ricricucit/kibble-dispenser/docs/photos/2026-11-08-bench-wrover-breadboard-servo-overview.jpg

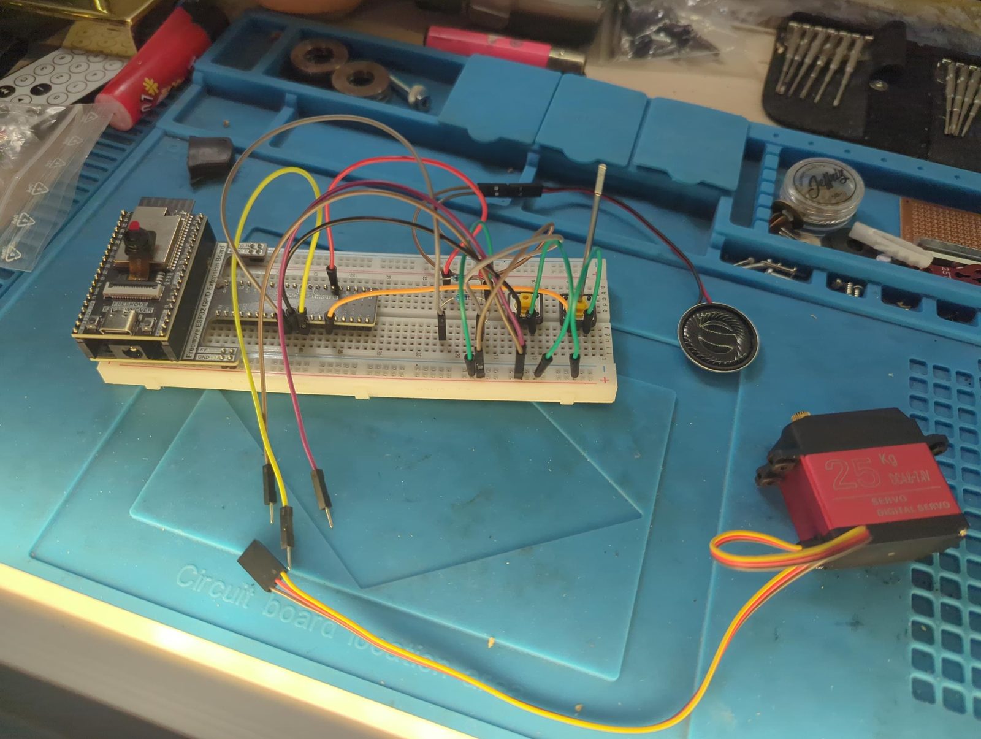
docs/photos/2026-11-08-bench-wrover-breadboard-servo-overview.jpg
