ricricucit/kibble-dispenser/docs/photos/freenove-esp32-cam-board-breadboard-wiring.jpg

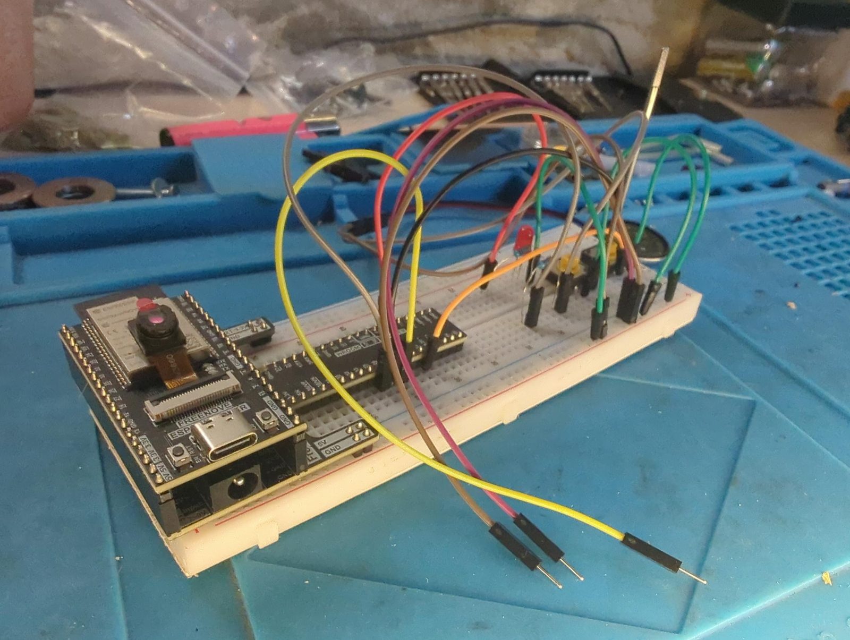
docs/photos/freenove-esp32-cam-board-breadboard-wiring.jpg
