ricricucit/kibble-dispenser/docs/README.md

# Documentation

- [Bought parts, design v6.3](BOM.md): screws, inserts, pins, O-rings, connector, control panel parts, electronics and tools, in English, Italian and German (generated from `hardware/v6.3/bom.json` by `site/bom.py`; v6.3 is designed, not yet printed or tested). The archived lists are [BOM-v6.2.md](BOM-v6.2.md) (design v6.2) and [BOM-v6.md](BOM-v6.md) (design v6).
- [Manuals, design v6.3](manual/): the user manual (draft for hardware 6.3, installation, use and maintenance) as an A6 booklet and an A4 print version in English, Italian and German; also on the site at <https://ricricucit.github.io/kibble-dispenser/manual/>
- [Build guide](BUILD_GUIDE.md): step-by-step assembly, exported from the living build guide (placeholder for now)
- [Research: power, electronics and sealing](research/elettronica-e-tenuta.it.md): power architecture, servo torque and current, cable entry, condensation, shaft seal and the full wiring list (Italian)
- [Getting started](getting-started.md): for people who buy a kit or a finished dispenser (coming later)
- [Process photos](photos/README.md): prototype 1 from the first servo tests to the bowl and box

Part-by-part print notes are in [../hardware/v6.3/plates/README.md](../hardware/v6.3/plates/README.md) (design v6.3), [../hardware/v6/README.md](../hardware/v6/README.md) (design v6) and [../hardware/README.md](../hardware/README.md) (prototype 1). Wiring and flashing steps are in [../firmware/README.md](../firmware/README.md).
