ricricucit/kibble-dispenser/docs/photos/README.md

# Process photos

Photos of prototype 1. Location and camera metadata were removed, and the images were resized to at most 1600 px on the long side. Photos without a date in their name had no date in the original file.

- `2026-07-04-servo-25kg-front.jpg`: the 25 kg·cm digital servo (4.8-7.4 V) on the workbench
- `2026-07-04-servo-25kg-three-quarter.jpg`: the same servo from another angle, with its brass 25-tooth spline
- `2026-07-04-aluminium-25t-clamp-horn.jpg`: aluminium clamping horn for the 25-tooth spline
- `2026-07-04-disc-v1-mockup-with-star-horn.jpg`: first disc mock-up, a cut plastic lid with a wedge opening screwed to a star servo horn
- `2026-10-04-orange-disc-in-bowl-on-box.jpg`: early orange printed disc in the bowl, which sits on the lid of the waterproof box
- `2026-10-04-empty-bowl-on-box-lid.jpg`: the empty bowl on the box lid, showing the centre hole and the side spout
- `2026-10-04-disc-lifted-out-cat-inspecting.jpg`: lifting the disc out of the bowl while the cat inspects
- `2026-10-04-bowl-with-spout-cover-removed.jpg`: the bowl removed from the box, with the top of the spout cut away
- `2026-10-04-spout-cover-cut-off.jpg`: the piece cut off the top of the spout
- `2026-10-04-bowl-top-view-spout-opened.jpg`: the bowl from above with the spout opened, and the cut-off piece beside it
- `2026-10-04-box-disc-and-bowl-laid-out.jpg`: box, orange disc and bowl laid out side by side
- `bowl-upside-down-with-spout-side-view.jpg`: the bowl upside down on the bench with its curved spout, side view
- `bowl-upside-down-with-spout-on-plywood.jpg`: the same set-up on a plywood board, three-quarter view
- `bowl-upside-down-top-view-on-plywood.jpg`: the same from above, with the centre hole for the shaft
- `freenove-esp32-cam-board-breadboard-wiring.jpg`: the Freenove ESP32 camera board on a breadboard for the first wiring tests. The silkscreen reads "FREENOVE ESP… R" (partly hidden by the USB-C port), which fits the ESP32-WROVER CAM board documented in the owner's PROJECT.md; still to be verified on the device. This photo was first captioned, wrongly, as an ESP32-S3 WROOM CAM
- `early-servo-bracket-inside-box.jpg`: an early servo bracket test fitted to the box wall, under the lid (this bracket is not part of the repository)
- `servo-in-early-bracket-inside-box.jpg`: the servo in that early bracket inside the box, lid lifted
- `servo-and-round-horn-on-plywood.jpg`: the servo with a round horn, next to the bowl on the plywood board
- `2026-11-08-wrover-e-extension-board-breadboard.jpg`: ESP32-WROVER-E (Freenove, with camera) on the Freenove GPIO extension board, plugged into the breadboard. Prototype wiring, pins not yet verified.
- `2026-11-08-breadboard-servo-speaker-buttons.jpg`: breadboard with the two tactile buttons, 8 Ω speaker and the 25 kg servo on its lead.
- `2026-11-08-bench-wrover-breadboard-servo-overview.jpg`: bench overview of the prototype electronics (breadboard phase).
