ricricucit/kibble-dispenser/firmware/micropython/legacy/README.md

`CatFeeder.py` is the original single-file prototype from feedr-outdoor 0.1.0 (2026-03-24), kept byte-for-byte for reference; it is superseded by `../src/` and not deployed by the Makefile.
