ricricucit/kibble-dispenser/docs/photos/2026-07-04-aluminium-25t-clamp-horn.jpg

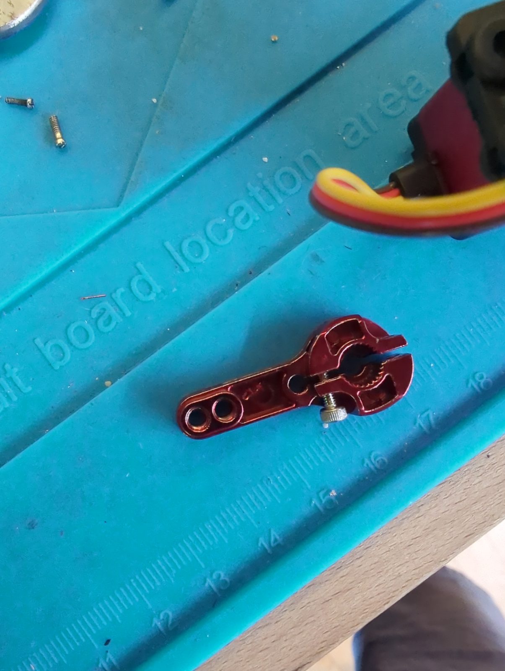
docs/photos/2026-07-04-aluminium-25t-clamp-horn.jpg
