ricricucit/kibble-dispenser/docs/photos/2026-07-04-disc-v1-mockup-with-star-horn.jpg

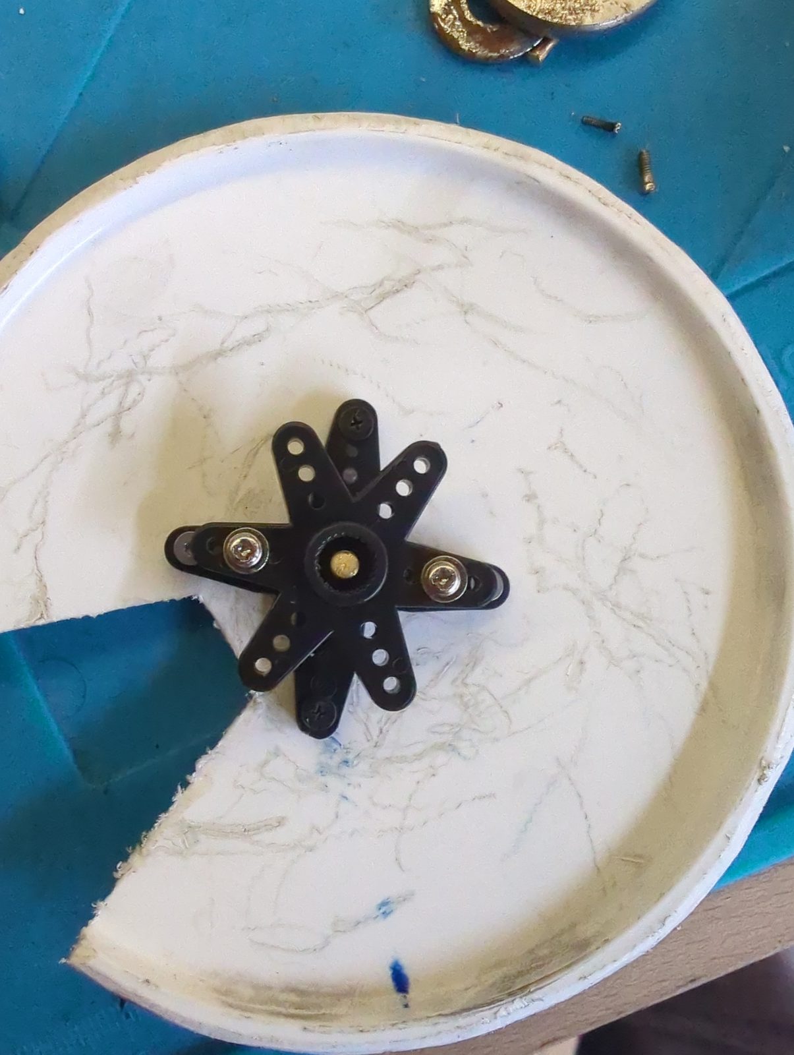
docs/photos/2026-07-04-disc-v1-mockup-with-star-horn.jpg
