ricricucit/kibble-dispenser/docs/photos/2026-07-04-servo-25kg-three-quarter.jpg

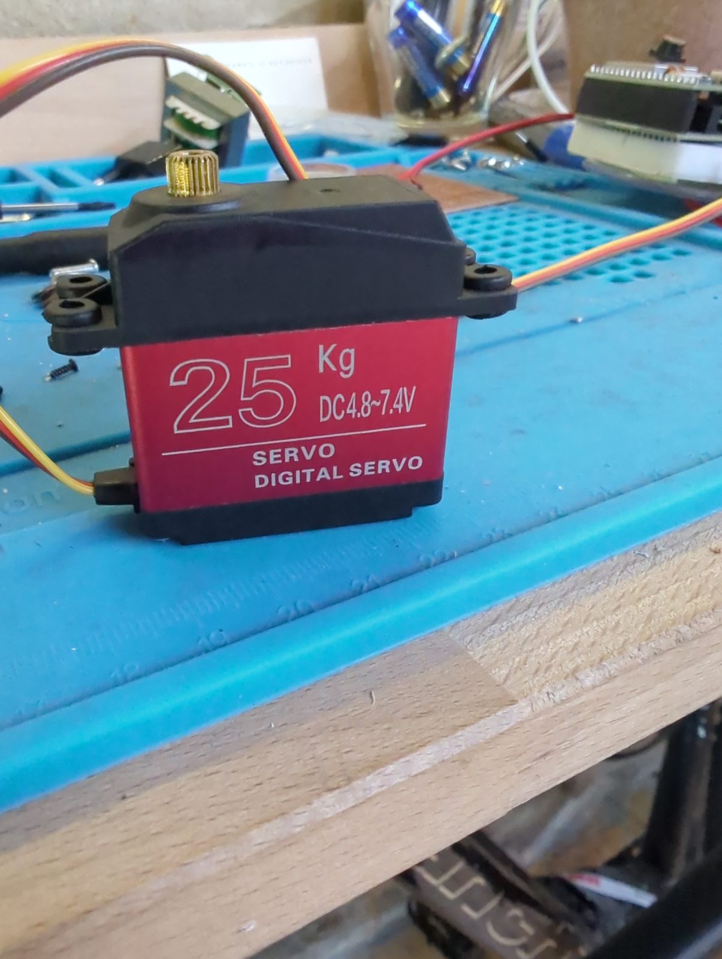
docs/photos/2026-07-04-servo-25kg-three-quarter.jpg
