ricricucit/kibble-dispenser/docs/photos/2026-10-04-bowl-top-view-spout-opened.jpg

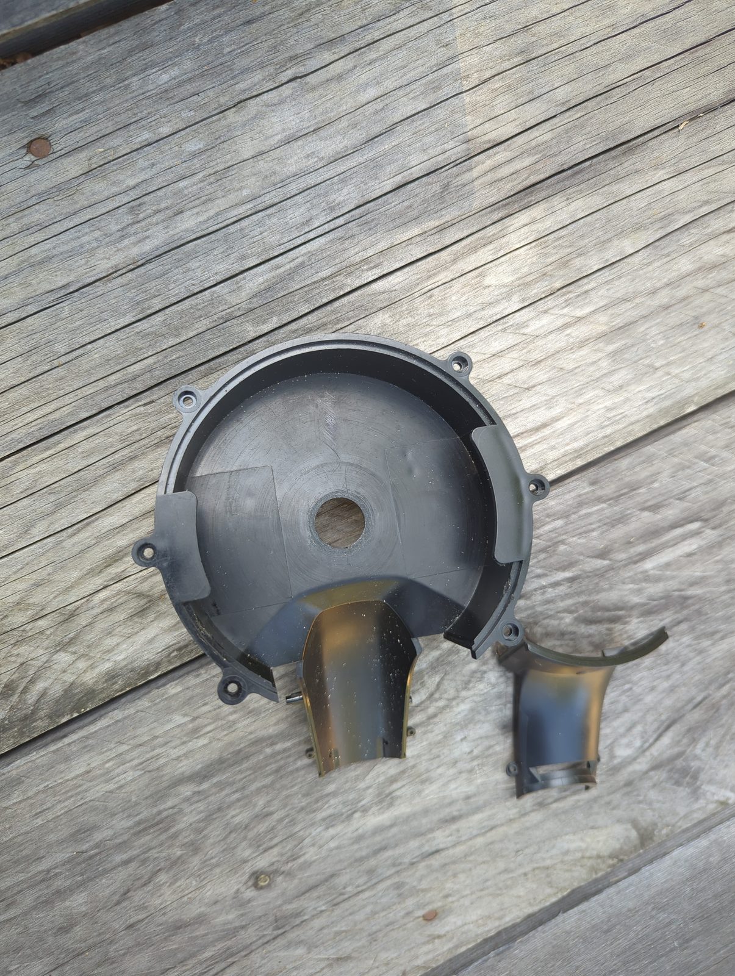
docs/photos/2026-10-04-bowl-top-view-spout-opened.jpg
