ricricucit/kibble-dispenser/docs/photos/2026-10-04-bowl-with-spout-cover-removed.jpg

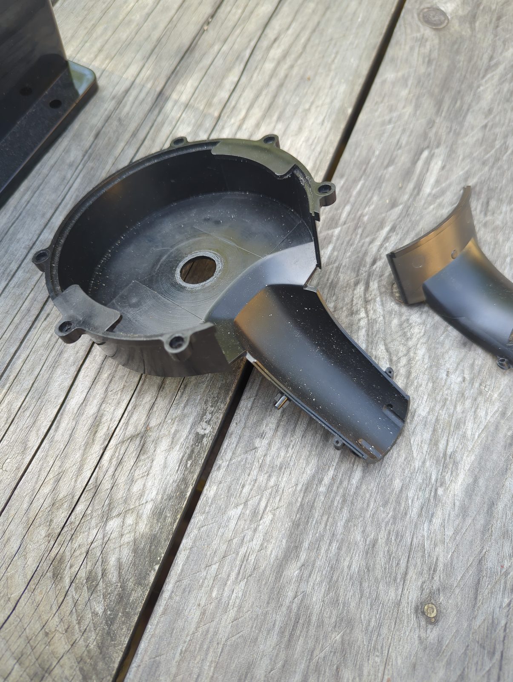
docs/photos/2026-10-04-bowl-with-spout-cover-removed.jpg
