ricricucit/kibble-dispenser/docs/photos/2026-10-04-box-disc-and-bowl-laid-out.jpg

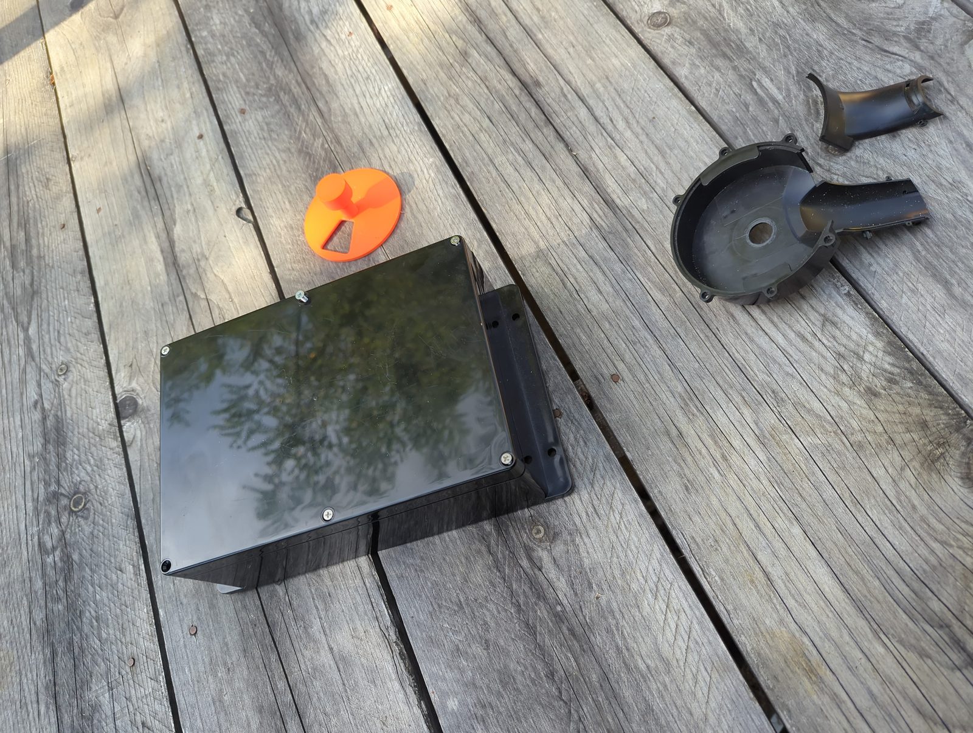
docs/photos/2026-10-04-box-disc-and-bowl-laid-out.jpg
