ricricucit/kibble-dispenser/docs/photos/2026-10-04-disc-lifted-out-cat-inspecting.jpg

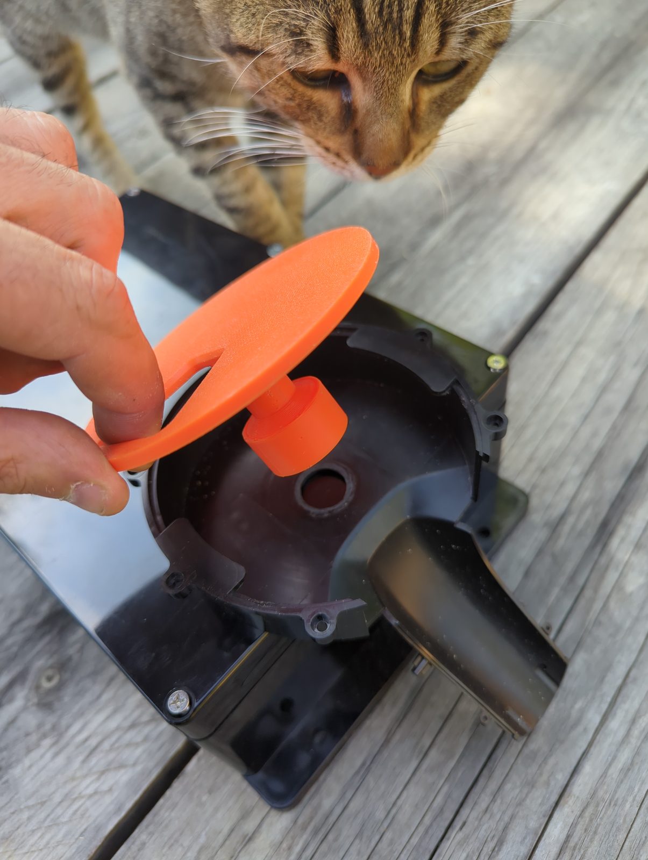
docs/photos/2026-10-04-disc-lifted-out-cat-inspecting.jpg
