ricricucit/kibble-dispenser/docs/photos/2026-10-04-empty-bowl-on-box-lid.jpg

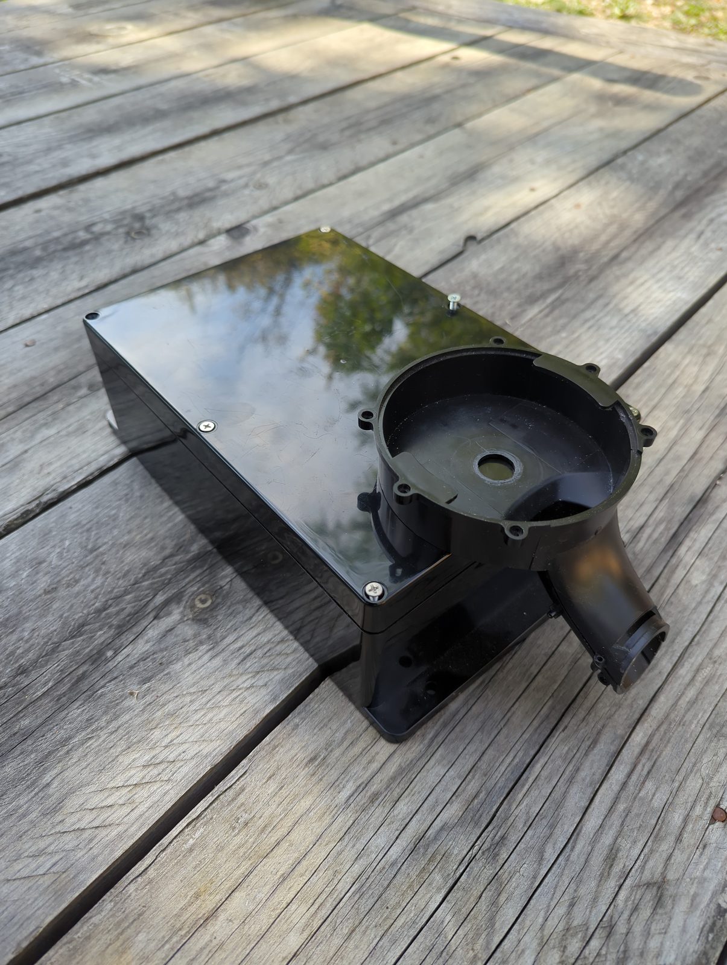
docs/photos/2026-10-04-empty-bowl-on-box-lid.jpg
