ricricucit/kibble-dispenser/docs/photos/2026-10-04-orange-disc-in-bowl-on-box.jpg

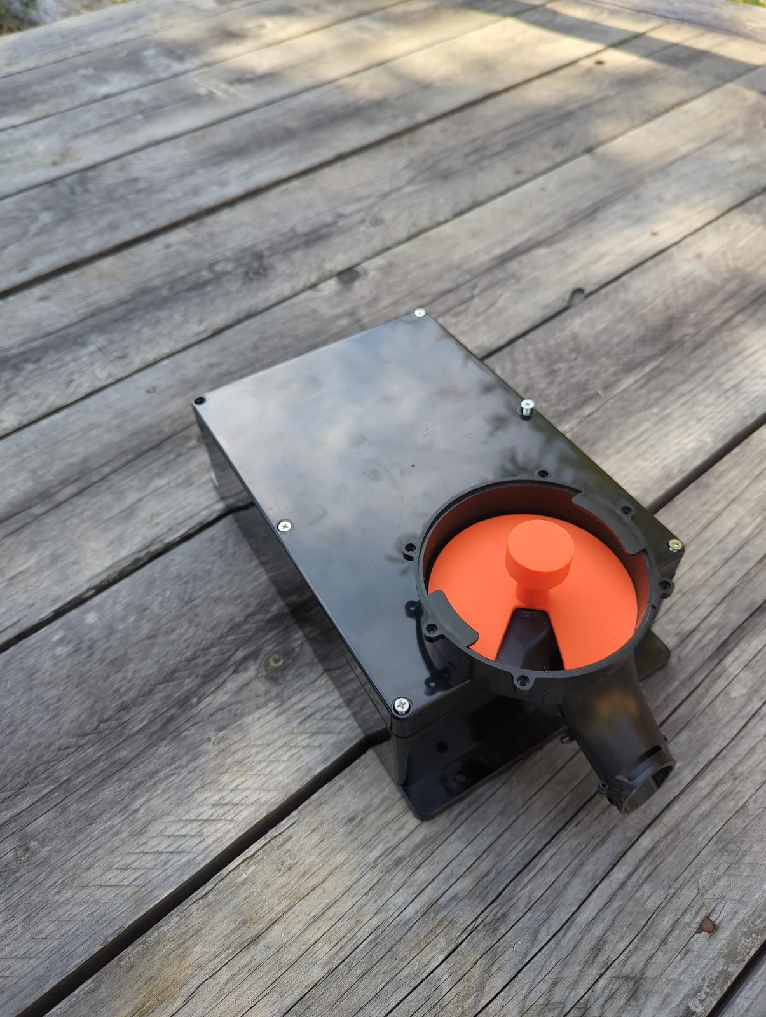
docs/photos/2026-10-04-orange-disc-in-bowl-on-box.jpg
