ricricucit/kibble-dispenser/docs/photos/2026-10-04-spout-cover-cut-off.jpg

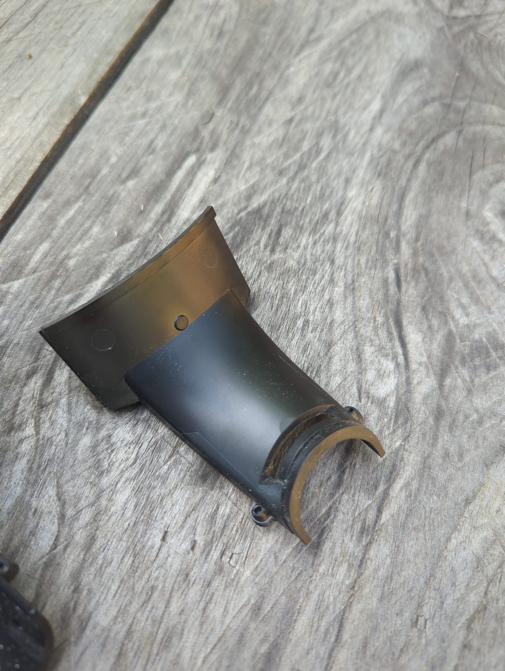
docs/photos/2026-10-04-spout-cover-cut-off.jpg
