ricricucit/kibble-dispenser/docs/photos/2026-11-08-breadboard-servo-speaker-buttons.jpg

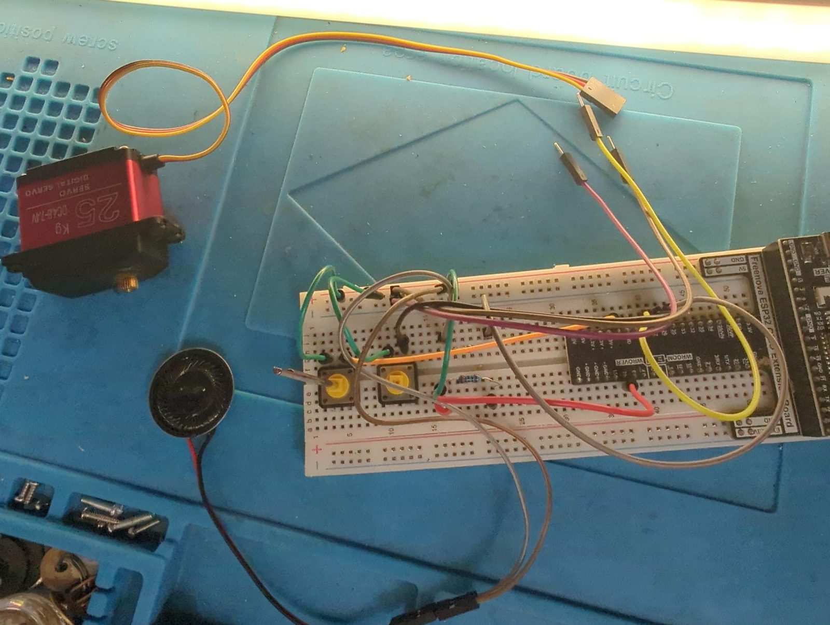
docs/photos/2026-11-08-breadboard-servo-speaker-buttons.jpg
