ricricucit/kibble-dispenser/docs/photos/2026-11-08-wrover-e-extension-board-breadboard.jpg

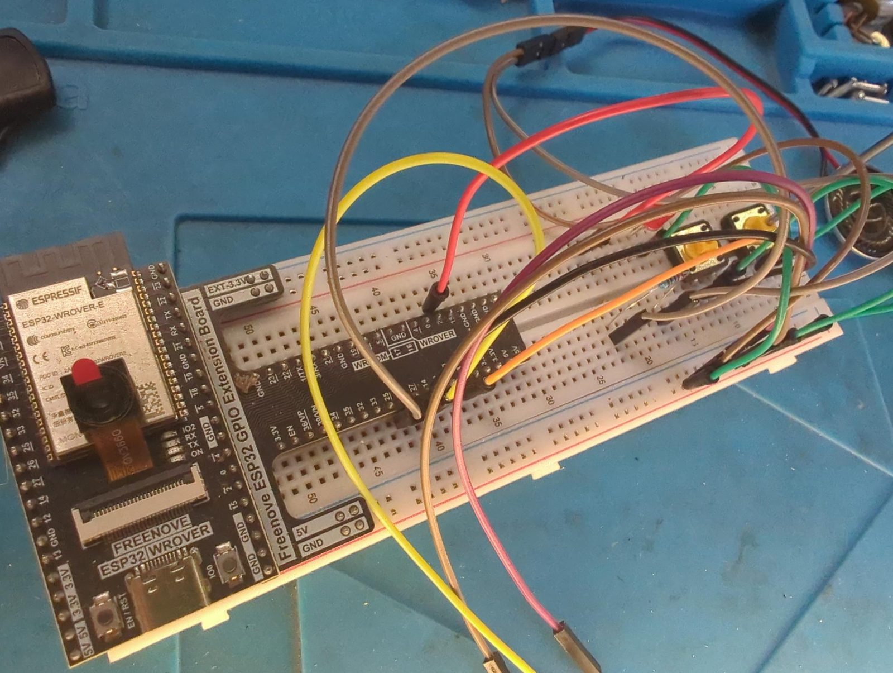
docs/photos/2026-11-08-wrover-e-extension-board-breadboard.jpg
