ricricucit/kibble-dispenser/docs/photos/bowl-upside-down-top-view-on-plywood.jpg

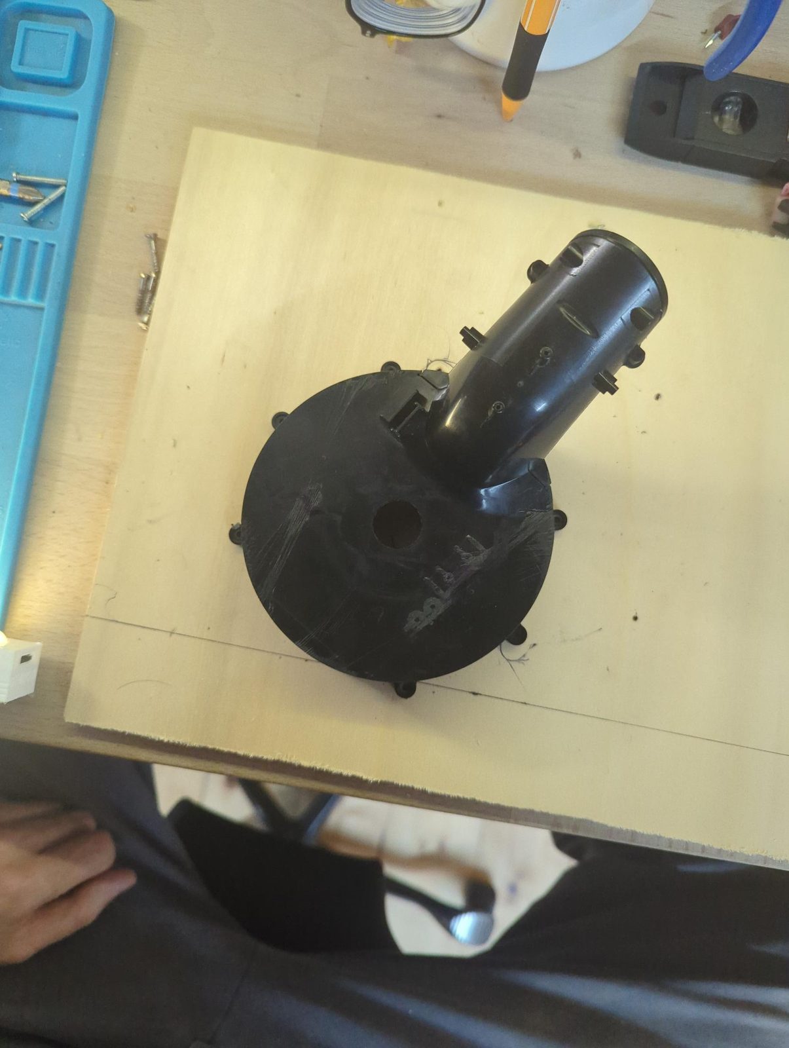
docs/photos/bowl-upside-down-top-view-on-plywood.jpg
