ricricucit/kibble-dispenser/docs/photos/bowl-upside-down-with-spout-on-plywood.jpg

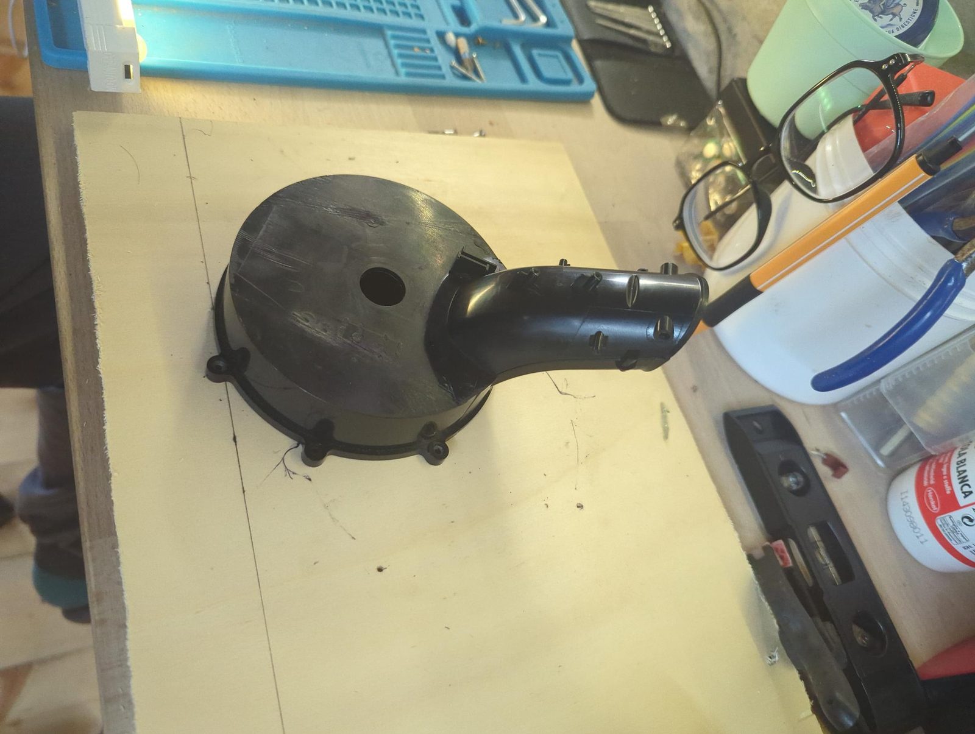
docs/photos/bowl-upside-down-with-spout-on-plywood.jpg
