ricricucit/kibble-dispenser/docs/photos/bowl-upside-down-with-spout-side-view.jpg

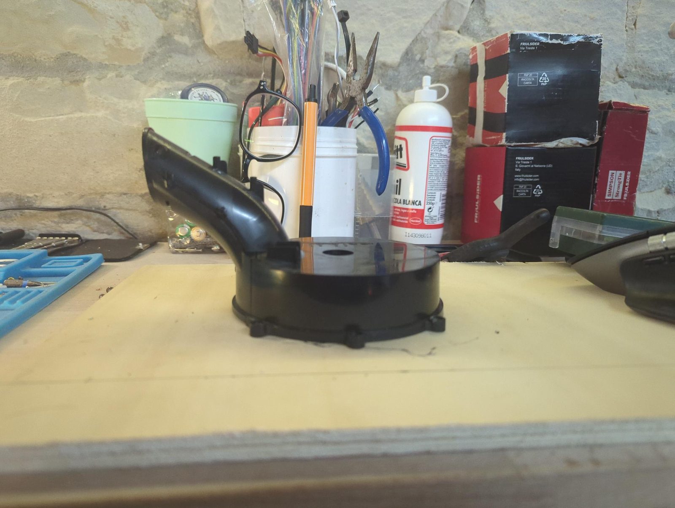
docs/photos/bowl-upside-down-with-spout-side-view.jpg
