ricricucit/kibble-dispenser/docs/photos/early-servo-bracket-inside-box.jpg

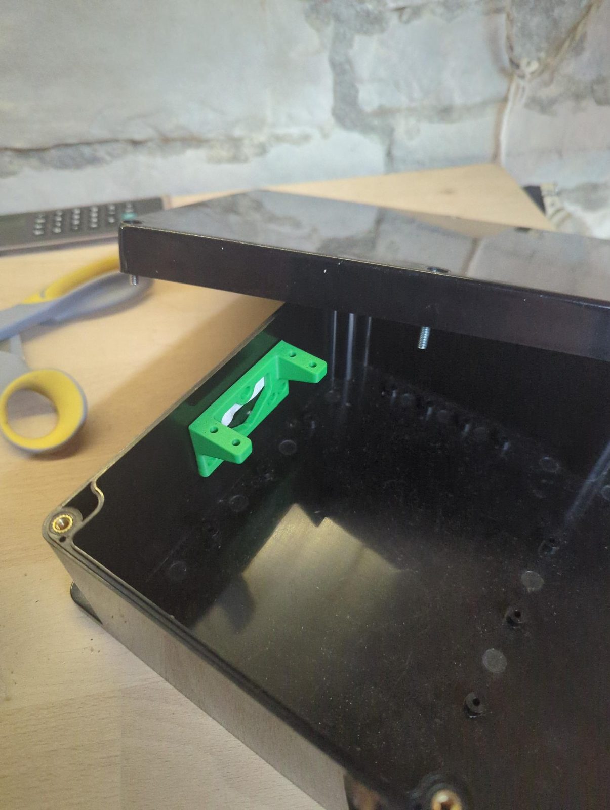
docs/photos/early-servo-bracket-inside-box.jpg
