ricricucit/kibble-dispenser/docs/photos/servo-and-round-horn-on-plywood.jpg

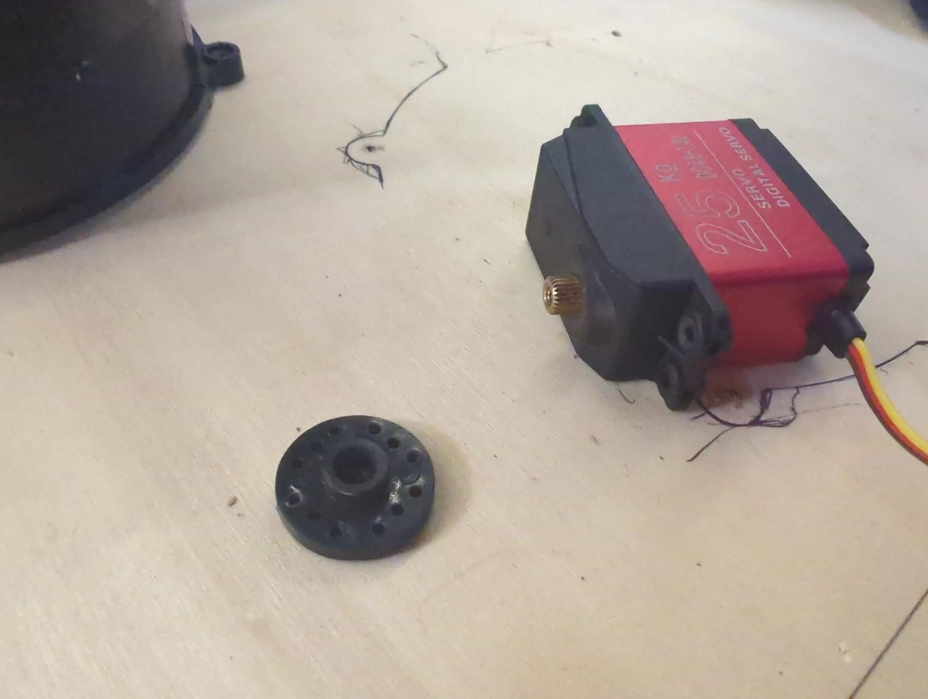
docs/photos/servo-and-round-horn-on-plywood.jpg
