ricricucit/kibble-dispenser/docs/photos/servo-in-early-bracket-inside-box.jpg

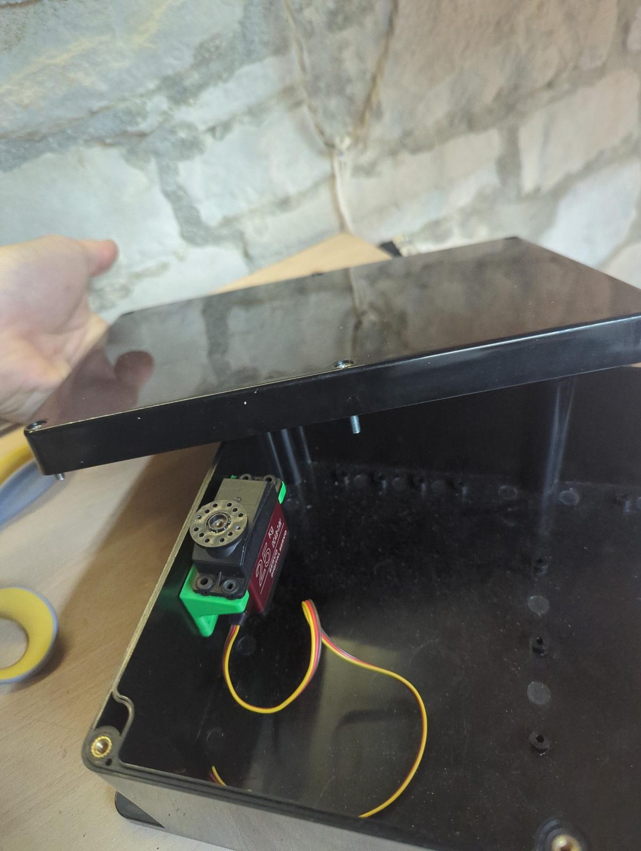
docs/photos/servo-in-early-bracket-inside-box.jpg
