ricricucit/kibble-dispenser/hardware/v6.3/cad/check_v63.png

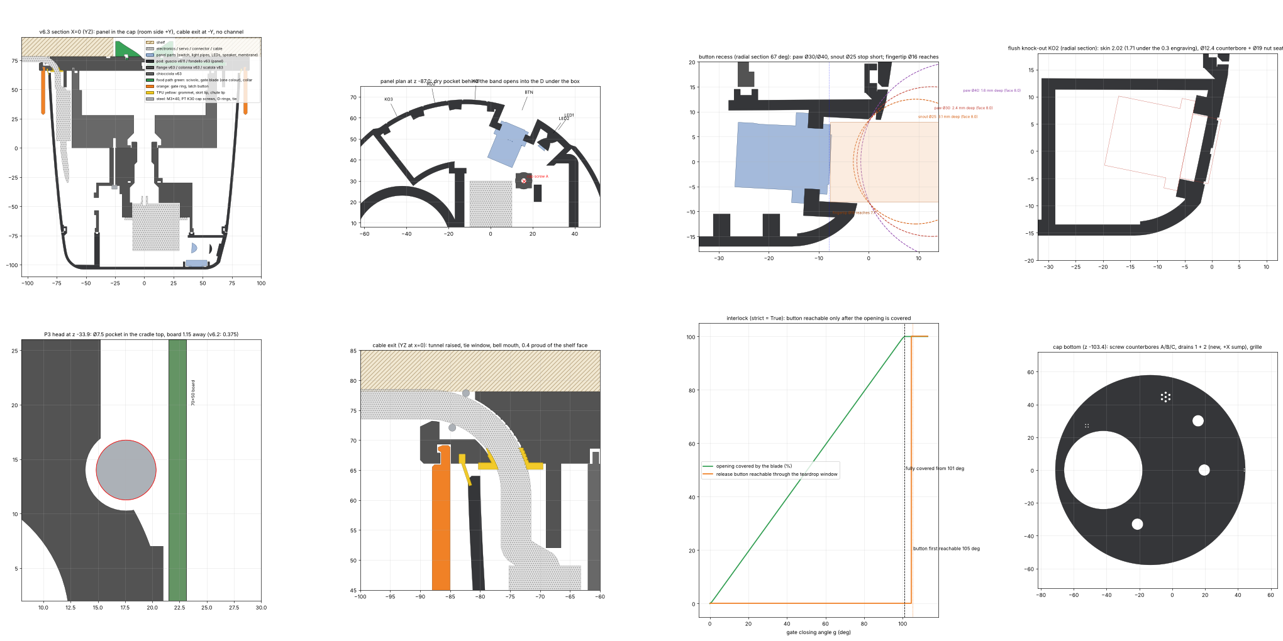
hardware/v6.3/cad/check_v63.png
