ricricucit/kibble-dispenser/hardware/v6.3/plates/preview/PETG-2_top.png

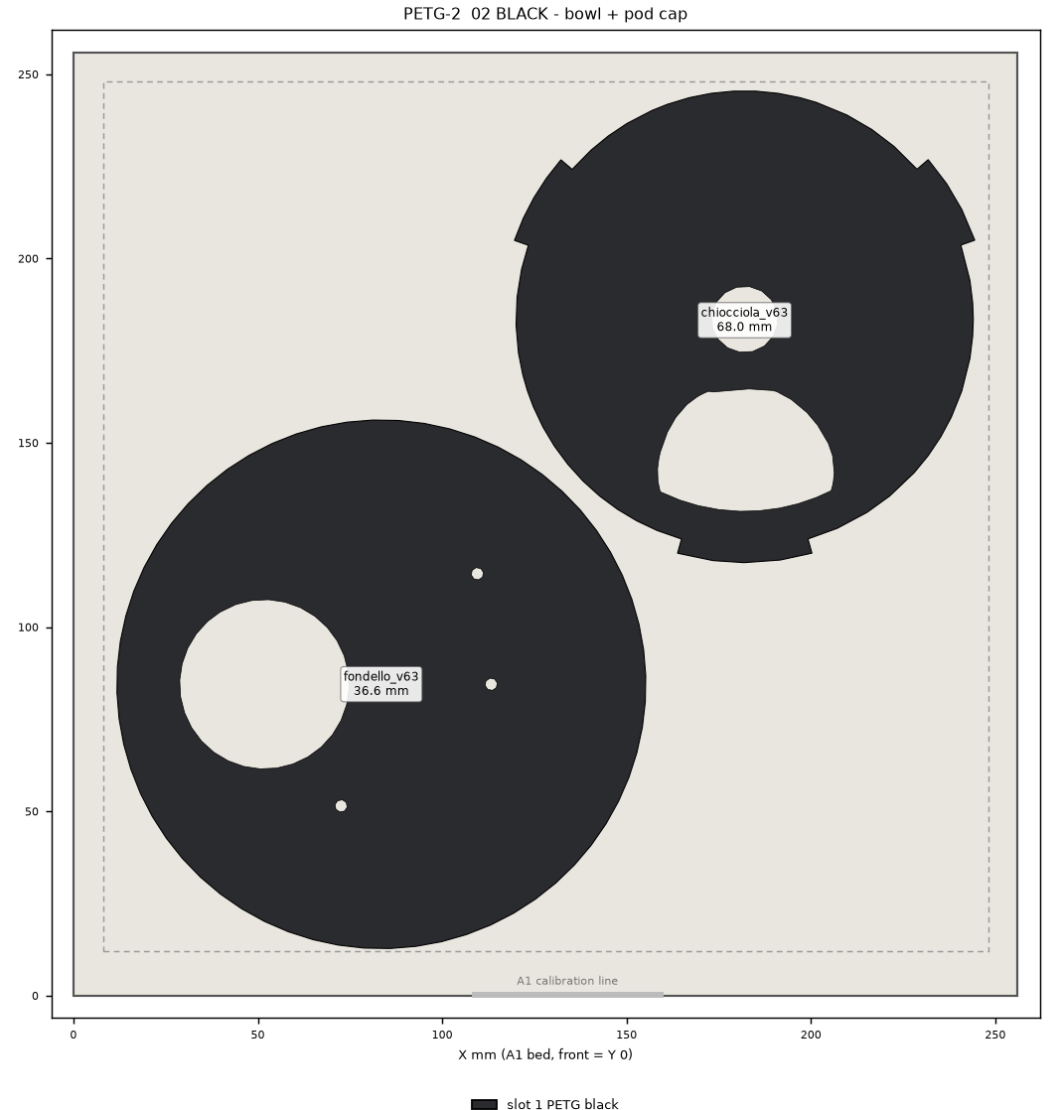
hardware/v6.3/plates/preview/PETG-2_top.png
