ricricucit/kibble-dispenser/hardware/v6.3/plates/preview/PETG-4_iso.png

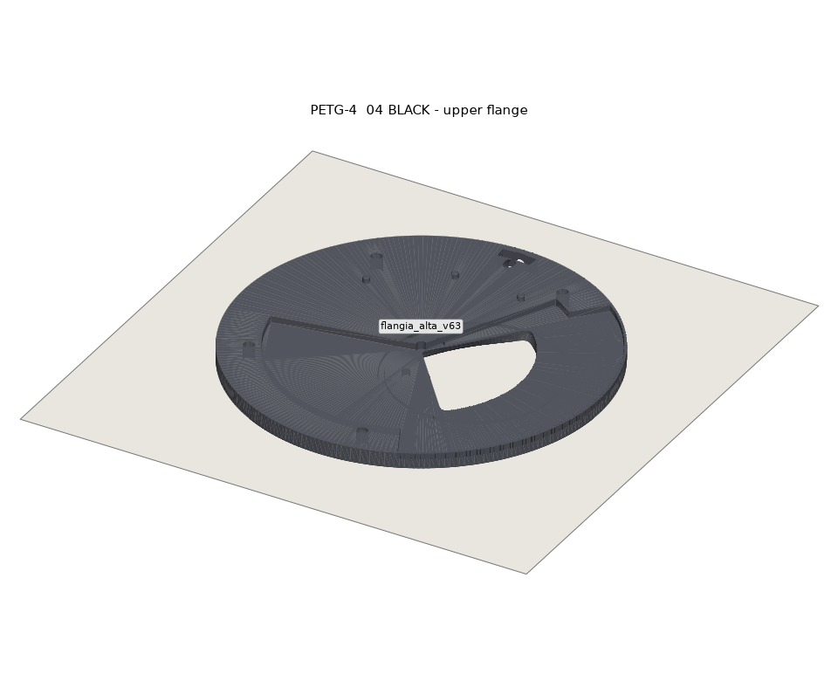
hardware/v6.3/plates/preview/PETG-4_iso.png
