ricricucit/kibble-dispenser/hardware/v6.3/plates/preview/TPU-1_iso.png

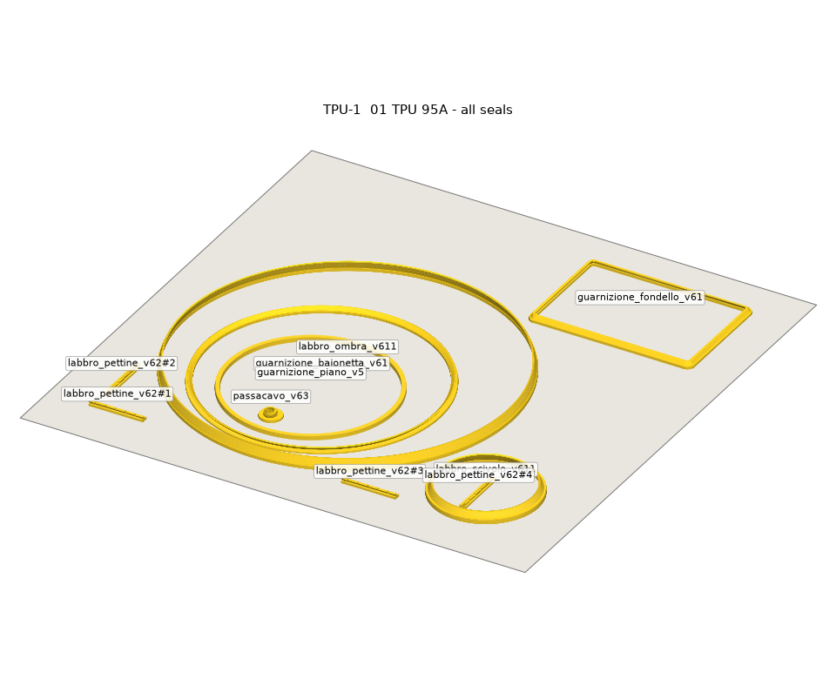
hardware/v6.3/plates/preview/TPU-1_iso.png
