ricricucit/kibble-dispenser/hardware/v6.3/plates/preview/TPU-1_top.png

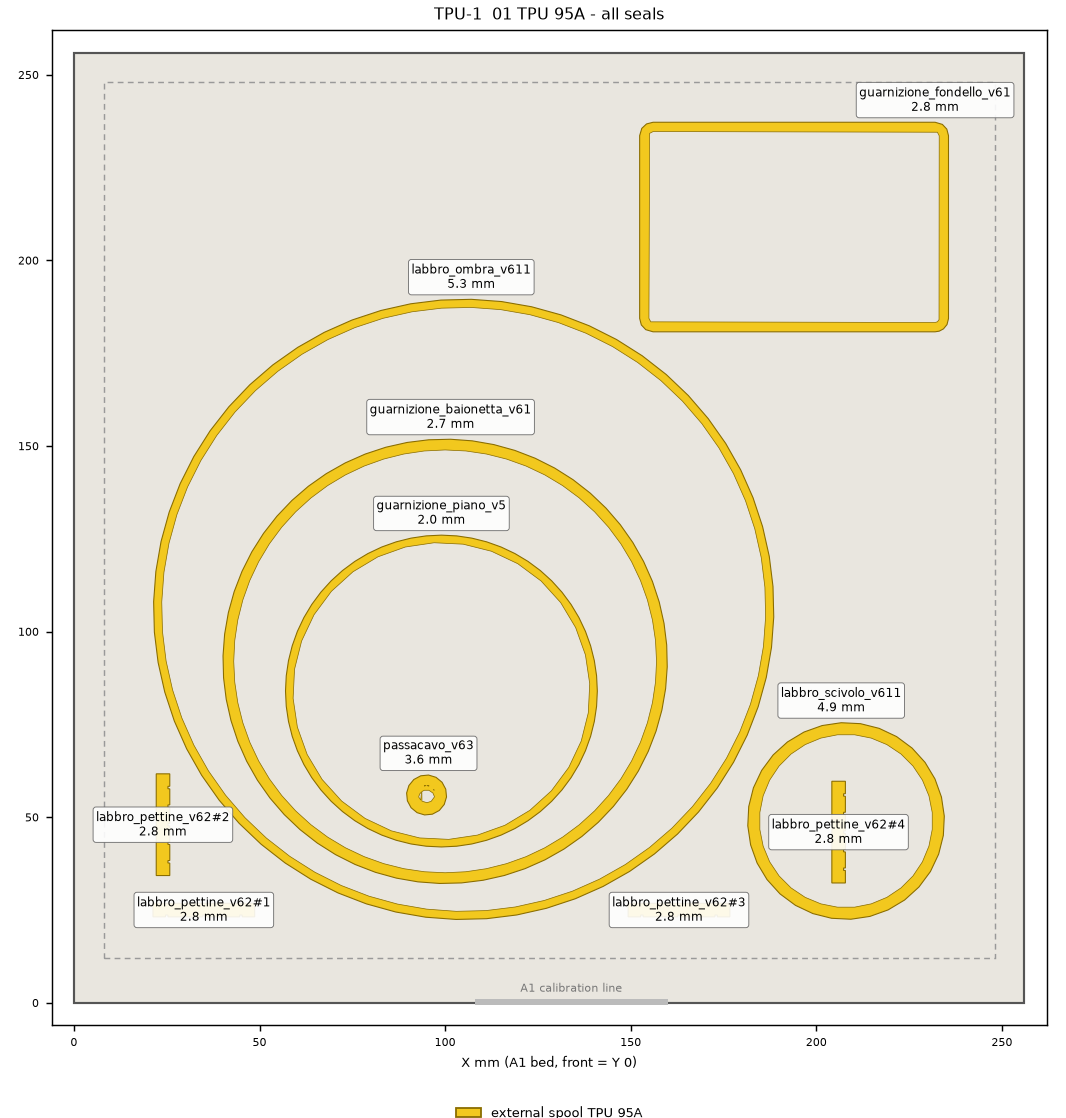
hardware/v6.3/plates/preview/TPU-1_top.png
