ricricucit/kibble-dispenser/site/img/hero-tall-780.webp

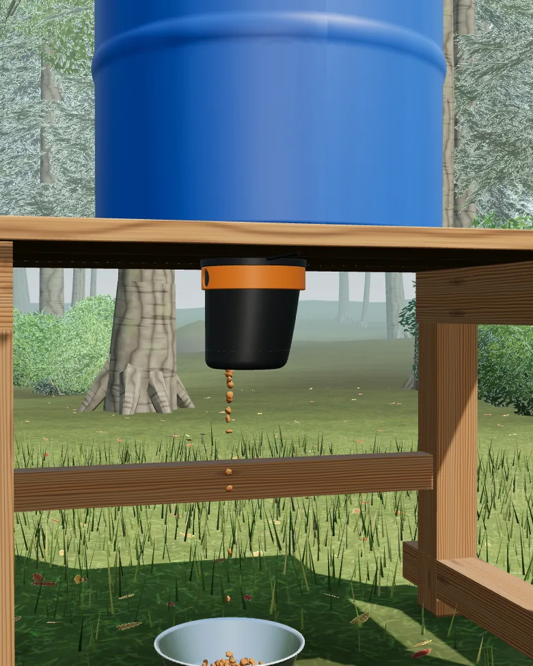
site/img/hero-tall-780.webp
