ricricucit/kibble-dispenser/site/img/hero-wide-1440.webp

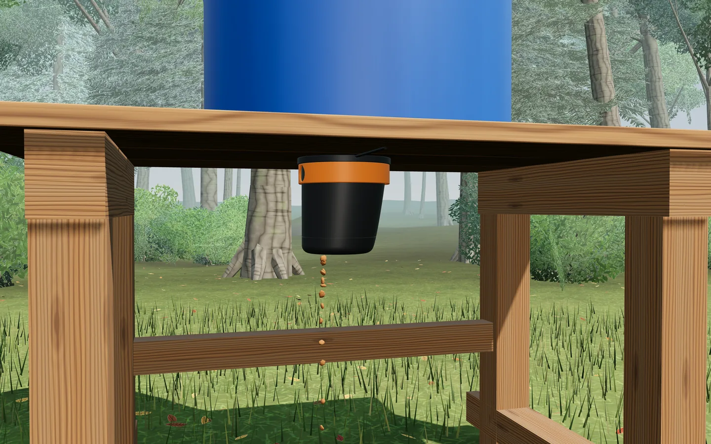
site/img/hero-wide-1440.webp
