ricricucit/kibble-dispenser/site/img/v63-section.webp

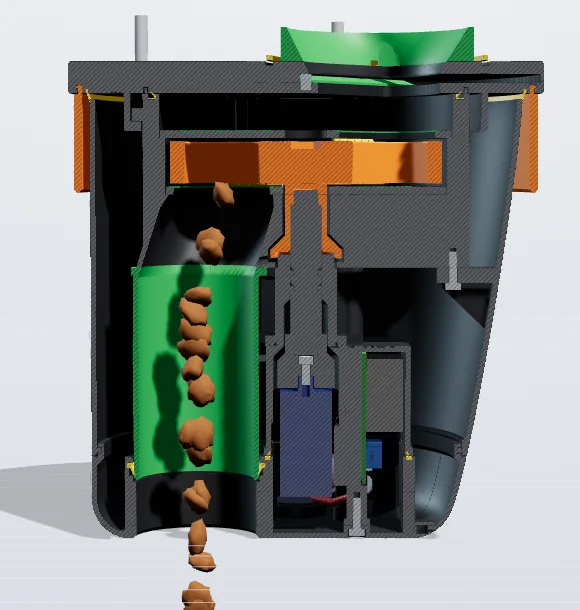
site/img/v63-section.webp
