ricricucit/kibble-dispenser/docs/BOM-v6.2.md

<!-- Generated by site/bom.py from hardware/v6.2/bom.json; edit that, then run python site/bom.py -->

# Bought parts, design v6.2 / Pezzi extra / Zukaufteile

[English](#english) · [Italiano](#italiano) · [Deutsch](#deutsch)

Website: <https://ricricucit.github.io/kibble-dispenser/v6.2/parts/>

Archived: this is design v6.2. The current design is v6.3: [docs/BOM.md](BOM.md).

## English

**Design v6.2 is designed, not yet printed or tested: quantities can still change.**

Everything you buy for the Kibble Dispenser Outdoor v6.2, besides the printed parts. Quantities and specifications come from the v6.2 design data. No shop links: buy wherever suits you.

### Screws, inserts and pins

Stainless steel throughout. In the kit the dispenser unit and the flange set come assembled: you only need the wood screws and the channel screws.

- **4 ×** Wood screw 5 × 35, pan head (5 × 30 for an 18 mm shelf): Flange set to the shelf, from below (the v6.2 flange is 8 mm thicker than before)
- **4 ×** Wood screw 3.5 × 16, countersunk: The two cable-channel bases under the shelf, 2 each
- **3 ×** Self-tapping screw ST 2.9 × 9.5, countersunk, DIN 7982 / ISO 7050, stainless: Join the two flange plates, from the shelf side
- **3 ×** M3 × 40 socket head cap screw, DIN 912 / ISO 4762, stainless A2: Clamp box, tower and bowl in one stack, from below (one through the outside ear, two through the box roof)
- **3 ×** M3 × 12 socket head cap screw, DIN 912 / ISO 4762, stainless A2: Shell tabs to the bowl base, from below
- **2 ×** M3 × 10 socket head cap screw, DIN 912 / ISO 4762, stainless A2: Chute ears to the bowl nose, from below
- **5 ×** M3 × 8 socket head cap screw, DIN 912 / ISO 4762, stainless A2: 4 × servo to the cradle in the box; 1 × hub to the servo spline
- **4 ×** M3 washer, DIN 125-A / ISO 7089 (3.2 × 7 × 0.5), stainless A2: Under the 4 servo screws
- **12 ×** M3 brass heat-set insert, 5.7 mm long, for a 4.0 mm hole (for example Ruthex RX-M3x5.7): 8 in the bowl (3 for the stack screws, 2 for the chute, 3 for the shell tabs), 4 in the servo cradle of the box
- **3 ×** Parallel key 3 × 3 × 18, DIN 6885 B, stainless A4 (or 3 × 3 stainless square bar cut to 18 mm): Pressed through each thumb-turn shaft above the cap: keeps it captive and locks it
- **1 ×** Dowel pin Ø4 × 6, ISO 2338 m6, stainless: Pivot of the gate blade, pressed into the lower flange plate. The print files print a Ø4.0 hole instead of the pin of the CAD model

### O-rings and grease

The other seals (rim lip seal, comb lips, skirt lip, chute lip, cap lip seal, shelf gasket, cable grommet) are printed in TPU 95A with the other parts. In the kit everything is greased at the factory: you never grease anything.

- **2 ×** O-ring 9 × 2 mm, NBR 70: Shaft, both grooves, in the bushing at the top of the tower
- **1 ×** O-ring 24 × 2 mm, NBR 70: Face seal between the tower and the box
- **2 ×** O-ring 3 × 1 mm, NBR 70: Under the heads of the two stack screws that pass through the box roof, so the dry box stays sealed
- **3 ×** O-ring 8 × 1.5 mm, NBR 70: One on each thumb-turn shaft in the cap
- **1 ×** O-ring 132 × 2 mm, NBR 70: Seam between the shell and the cap, in the groove of the cap spigot
- **1 ×** O-ring 14 × 1.5 mm, NBR 70: Release button, in the groove of its hole in the shell
- **1 ×** Food-grade silicone grease, NSF H1 (a small tube is plenty): DIY only: a thin film on every O-ring when you fit it. Once assembled, the unit never needs grease

### Electronics and cable

In the kit the electronics box comes pre-assembled and closed: this list is for DIY builders. The electronics are not final yet; wiring, fuse and the power chain are in firmware/README.md.

- **1 ×** 12 V 3 A outdoor-rated power supply, certified (for example Mean Well GST36 12 V), with a screw-terminal adapter: In a dry place under the roof: only 12 V runs outdoors, no mains voltage near the unit
- **1 ×** M8 A-coded 4-pin IP67 inline connector pair, with PUR cable 4 × 0.34 mm², Ø5 mm: Between the supply cable (through the flange tunnel and the channel) and the short cable of the unit; it hangs in the top of the shell and comes free when you lower the unit 8 cm
- **1 ×** M12 × 1.5 cable gland, IP68, for 4 to 7 mm cable, with locknut: The only cable entry of the electronics box, in its side wall inside the pod
- **1 ×** M12 × 1.5 screw-in ePTFE membrane vent, IP68, with locknut (GORE PolyVent or Amphenol LTW VENT-PS1 class): In the box roof: balances pressure and humidity, instead of a silica gel bag
- **1 ×** Perfboard 70 × 50 mm, with female headers for the ESP32 board and JST or screw terminals: Carries the ESP32, the two regulators and the capacitor; slides up into the slots of the box, parts facing the shell
- **1 ×** ESP32-WROVER dev board (the prototype uses a Freenove ESP32-WROVER board): Runs the MicroPython firmware in firmware/micropython/
- **1 ×** Standard-size servo with a 25-tooth spline, 25 kg·cm digital (DS3218 / DS3225 class): Turns the disc; hangs in the cradle in the box and runs on 6 V
- **1 ×** Pololu D36V50F6 step-down regulator, 6 V, 5.5 A: Servo supply from the 12 V input
- **1 ×** 5 V 1 A step-down regulator for the logic (for example Pololu D24V10F5 or D36V6F5): ESP32 supply from 12 V, separate from the servo branch
- **1 ×** 1000 µF low-ESR electrolytic capacitor, 16 V, 105 °C (plus a 100 nF ceramic capacitor): Across the servo supply
- **1 ×** Small speaker, with a 100–220 Ω series resistor: A sound with every portion. Open point: the sealed box has no sound opening yet

### Tools needed

- Drill with a 76 mm hole saw (with its centre drill) and a 3 mm bit: One hole through the shelf for the food, and pilot holes for the wood screws
- Drilling template, printed on A4 at 100 % (in the kit, or as a PDF on the manual page): Marks the hole, the 4 screw points and the first channel screw; check its 50 mm scale bar
- PZ2 screwdriver, awl or pencil, tape, a small saw, spirit level, safety glasses: Mounting the flange and cutting the second channel section to length
- DIY only: 2.5 mm hex screwdriver, 100 mm long: All M3 screws; a straight key reaches every screw in the assembly order of the wizard (the chute screws need about 75 mm)
- DIY only: soldering iron with an M3 insert tip, and a 0.8 mm drill bit: Pressing in the 12 heat-set inserts; clearing the 4 drain holes of the printed cap

Printed parts and their files: [hardware/v6.2/](../hardware/v6.2/plates/README.md)

## Italiano

**Il progetto v6.2 è disegnato ma non ancora stampato né provato: le quantità possono ancora cambiare.**

Tutto quello che si compra per il Kibble Dispenser Outdoor v6.2, oltre ai pezzi stampati. Quantità e caratteristiche vengono dai dati del progetto v6.2. Nessun link a negozi: comprate dove preferite.

### Viti, inserti e perni

Tutto in acciaio inox. Nel kit l'unità dosatrice e il set flangia arrivano montati: servono solo le viti da legno e le viti della canalina.

- **4 ×** Vite da legno 5 × 35, testa bombata (5 × 30 per un ripiano da 18 mm): Set flangia al ripiano, da sotto (la flangia della v6.2 è 8 mm più spessa di prima)
- **4 ×** Vite da legno 3,5 × 16, testa svasata: Le due basi della canalina sotto il ripiano, 2 ciascuna
- **3 ×** Vite autofilettante ST 2,9 × 9,5, testa svasata, DIN 7982 / ISO 7050, inox: Uniscono le due piastre della flangia, dal lato del ripiano
- **3 ×** Vite M3 × 40 a testa cilindrica con esagono incassato, DIN 912 / ISO 4762, inox A2: Serrano scatola, torre e vasca in un solo pacco, da sotto (una nell'orecchia esterna, due attraverso il tetto della scatola)
- **3 ×** Vite M3 × 12 a testa cilindrica con esagono incassato, DIN 912 / ISO 4762, inox A2: Alette del guscio alla base della vasca, da sotto
- **2 ×** Vite M3 × 10 a testa cilindrica con esagono incassato, DIN 912 / ISO 4762, inox A2: Orecchie dello scivolo al muso della vasca, da sotto
- **5 ×** Vite M3 × 8 a testa cilindrica con esagono incassato, DIN 912 / ISO 4762, inox A2: 4 × servo alla culla nella scatola; 1 × mozzo all'albero scanalato del servo
- **4 ×** Rondella M3, DIN 125-A / ISO 7089 (3,2 × 7 × 0,5), inox A2: Sotto le 4 viti del servo
- **12 ×** Inserto filettato M3 in ottone da inserire a caldo, lungo 5,7 mm, per foro da 4,0 mm (per esempio Ruthex RX-M3x5.7): 8 nella vasca (3 per le viti del pacco, 2 per lo scivolo, 3 per le alette del guscio), 4 nella culla del servo nella scatola
- **3 ×** Linguetta 3 × 3 × 18, DIN 6885 B, inox A4 (oppure barretta quadra inox 3 × 3 tagliata a 18 mm): Infilata in ogni perno dei nottolini sopra il fondello: lo trattiene e lo blocca
- **1 ×** Spina cilindrica Ø4 × 6, ISO 2338 m6, inox: Perno della lama della saracinesca, piantato nella flangia inferiore. I file di stampa stampano un foro Ø4,0 al posto del perno del modello CAD

### O-ring e grasso

Le altre guarnizioni (labbro del bordo, labbri a pettine, bordino, labbro dello scivolo, labbro del fondello, guarnizione del ripiano, passacavo) si stampano in TPU 95A con gli altri pezzi. Nel kit tutto è ingrassato in fabbrica: non si ingrassa mai niente.

- **2 ×** O-ring 9 × 2 mm, NBR 70: Albero, entrambe le gole, nella boccola in cima alla torre
- **1 ×** O-ring 24 × 2 mm, NBR 70: Tenuta frontale tra torre e scatola
- **2 ×** O-ring 3 × 1 mm, NBR 70: Sotto le teste delle due viti del pacco che passano dal tetto della scatola, così la scatola asciutta resta stagna
- **3 ×** O-ring 8 × 1,5 mm, NBR 70: Uno su ogni perno dei nottolini nel fondello
- **1 ×** O-ring 132 × 2 mm, NBR 70: Giunto tra guscio e fondello, nella gola del codolo del fondello
- **1 ×** O-ring 14 × 1,5 mm, NBR 70: Pulsante di sgancio, nella gola del suo foro nel guscio
- **1 ×** Grasso al silicone per alimenti, NSF H1 (basta un tubetto piccolo): Solo per chi costruisce: un velo su ogni O-ring al montaggio. Una volta montata, l'unità non chiede mai grasso

### Elettronica e cavo

Nel kit la scatola elettronica arriva già montata e chiusa: questo elenco è per chi costruisce da sé. L'elettronica non è ancora definitiva; cablaggio, fusibile e catena di alimentazione sono in firmware/README.md.

- **1 ×** Alimentatore 12 V 3 A certificato (per esempio Mean Well GST36 12 V), con adattatore a morsetti: In un posto asciutto sotto il tetto: all'aperto arrivano solo 12 V, nessuna tensione di rete vicino all'unità
- **1 ×** Coppia di connettori in linea M8 codifica A, 4 poli, IP67, con cavo PUR 4 × 0,34 mm², Ø5 mm: Tra il cavo di alimentazione (nel tunnel della flangia e nella canalina) e il cavo corto dell'unità; sta nella parte alta del guscio e si raggiunge abbassando l'unità di 8 cm
- **1 ×** Pressacavo M12 × 1,5, IP68, per cavo da 4 a 7 mm, con controdado: L'unico ingresso cavo della scatola elettronica, nella parete laterale dentro il guscio
- **1 ×** Valvola a membrana ePTFE M12 × 1,5 a vite, IP68, con controdado (classe GORE PolyVent o Amphenol LTW VENT-PS1): Nel tetto della scatola: equilibra pressione e umidità, al posto del sacchetto di gel di silice
- **1 ×** Scheda millefori 70 × 50 mm, con connettori femmina per la scheda ESP32 e morsetti JST o a vite: Porta l'ESP32, i due regolatori e il condensatore; scorre nelle guide della scatola, componenti verso il guscio
- **1 ×** Scheda di sviluppo ESP32-WROVER (il prototipo usa una scheda Freenove ESP32-WROVER): Esegue il firmware MicroPython di firmware/micropython/
- **1 ×** Servo formato standard con albero scanalato a 25 denti, 25 kg·cm digitale (classe DS3218 / DS3225): Gira il disco; sta nella culla della scatola e va a 6 V
- **1 ×** Regolatore step-down Pololu D36V50F6, 6 V, 5,5 A: Alimenta il servo dai 12 V in ingresso
- **1 ×** Regolatore step-down 5 V 1 A per la logica (per esempio Pololu D24V10F5 o D36V6F5): Alimenta l'ESP32 dai 12 V, separato dal ramo del servo
- **1 ×** Condensatore elettrolitico 1000 µF low-ESR, 16 V, 105 °C (più un condensatore ceramico da 100 nF): In parallelo all'alimentazione del servo
- **1 ×** Piccolo altoparlante, con resistenza in serie da 100–220 Ω: Un suono a ogni porzione. Punto aperto: la scatola stagna non ha ancora un'apertura per il suono

### Attrezzi necessari

- Trapano con sega a tazza da 76 mm (con la sua punta di centraggio) e una punta da 3 mm: Un foro nel ripiano per il cibo e i fori pilota per le viti da legno
- Dima di foratura stampata su A4 al 100 % (nel kit, o come PDF nella pagina del manuale): Segna il foro, i 4 punti delle viti e la prima vite della canalina; controllate la barra di scala da 50 mm
- Cacciavite PZ2, punteruolo o matita, nastro adesivo, una piccola sega, livella, occhiali di protezione: Montare la flangia e tagliare a misura il secondo tratto di canalina
- Solo per chi costruisce: cacciavite a brugola da 2,5 mm, lungo 100 mm: Tutte le viti M3; nell'ordine di montaggio della guida una chiave dritta raggiunge ogni vite (le viti dello scivolo chiedono circa 75 mm)
- Solo per chi costruisce: saldatore con punta per inserti M3 e una punta da 0,8 mm: Inserire a caldo i 12 inserti; liberare i 4 fori di scarico del fondello stampato

Pezzi stampati e i loro file: [hardware/v6.2/](../hardware/v6.2/plates/README.md)

## Deutsch

**Entwurf v6.2 ist konstruiert, aber noch nicht gedruckt oder getestet: die Mengen können sich noch ändern.**

Alles, was man für den Kibble Dispenser Outdoor v6.2 neben den Druckteilen kauft. Mengen und Angaben stammen aus den Konstruktionsdaten von v6.2. Keine Shop-Links: kauft, wo es euch passt.

### Schrauben, Einsätze und Stifte

Durchgehend Edelstahl. Im Bausatz kommen Spendereinheit und Flanschsatz montiert: Sie brauchen nur die Holzschrauben und die Kanalschrauben.

- **4 ×** Holzschraube 5 × 35, Linsenkopf (5 × 30 bei 18 mm Regalbrett): Flanschsatz an das Regalbrett, von unten (der Flansch von v6.2 ist 8 mm dicker als vorher)
- **4 ×** Holzschraube 3,5 × 16, Senkkopf: Die zwei Kabelkanal-Unterteile unter dem Brett, je 2
- **3 ×** Blechschraube ST 2,9 × 9,5, Senkkopf, DIN 7982 / ISO 7050, Edelstahl: Verbinden die zwei Flanschplatten, von der Brettseite
- **3 ×** Zylinderschraube M3 × 40 mit Innensechskant, DIN 912 / ISO 4762, Edelstahl A2: Spannen Gehäuse, Turm und Schale in einem Stapel, von unten (eine durch die äußere Lasche, zwei durch das Gehäusedach)
- **3 ×** Zylinderschraube M3 × 12 mit Innensechskant, DIN 912 / ISO 4762, Edelstahl A2: Hüllenlaschen an den Schalenboden, von unten
- **2 ×** Zylinderschraube M3 × 10 mit Innensechskant, DIN 912 / ISO 4762, Edelstahl A2: Rutschenlaschen an die Schalennase, von unten
- **5 ×** Zylinderschraube M3 × 8 mit Innensechskant, DIN 912 / ISO 4762, Edelstahl A2: 4 × Servo an die Wiege im Gehäuse; 1 × Nabe an die Servoverzahnung
- **4 ×** Unterlegscheibe M3, DIN 125-A / ISO 7089 (3,2 × 7 × 0,5), Edelstahl A2: Unter den 4 Servoschrauben
- **12 ×** M3-Gewindeeinsatz aus Messing zum Einschmelzen, 5,7 mm lang, für ein 4,0-mm-Loch (zum Beispiel Ruthex RX-M3x5.7): 8 in der Schale (3 für die Stapelschrauben, 2 für die Rutsche, 3 für die Hüllenlaschen), 4 in der Servowiege des Gehäuses
- **3 ×** Passfeder 3 × 3 × 18, DIN 6885 B, Edelstahl A4 (oder Edelstahl-Vierkant 3 × 3, auf 18 mm gekürzt): Durch jede Drehknebelwelle über dem Boden gepresst: hält und verriegelt sie
- **1 ×** Zylinderstift Ø4 × 6, ISO 2338 m6, Edelstahl: Drehachse des Schieberblatts, in den unteren Flansch eingepresst. Die Druckdateien drucken ein Loch Ø4,0 statt des Stifts im CAD-Modell

### O-Ringe und Fett

Die übrigen Dichtungen (Randlippe, Kammlippen, Schürzenlippe, Rutschenlippe, Bodenlippe, Regalbrett-Dichtung, Kabeltülle) werden mit den anderen Teilen aus TPU 95A gedruckt. Im Bausatz ist alles ab Werk gefettet: Sie fetten nie etwas.

- **2 ×** O-Ring 9 × 2 mm, NBR 70: Welle, beide Nuten, in der Buchse oben im Turm
- **1 ×** O-Ring 24 × 2 mm, NBR 70: Stirndichtung zwischen Turm und Gehäuse
- **2 ×** O-Ring 3 × 1 mm, NBR 70: Unter den Köpfen der zwei Stapelschrauben durch das Gehäusedach, damit das trockene Gehäuse dicht bleibt
- **3 ×** O-Ring 8 × 1,5 mm, NBR 70: Einer auf jeder Drehknebelwelle im Boden
- **1 ×** O-Ring 132 × 2 mm, NBR 70: Fuge zwischen Hülle und Boden, in der Nut des Bodenzapfens
- **1 ×** O-Ring 14 × 1,5 mm, NBR 70: Entriegelungsknopf, in der Nut seiner Bohrung in der Hülle
- **1 ×** Lebensmittelechtes Silikonfett, NSF H1 (eine kleine Tube reicht): Nur beim Eigenbau: ein dünner Film auf jedem O-Ring beim Einbau. Montiert braucht die Einheit nie Fett

### Elektronik und Kabel

Im Bausatz kommt das Elektronikgehäuse vormontiert und verschlossen: diese Liste ist für den Eigenbau. Die Elektronik ist noch nicht endgültig; Verdrahtung, Sicherung und Stromversorgung stehen in firmware/README.md.

- **1 ×** Zertifiziertes 12-V-3-A-Netzteil (zum Beispiel Mean Well GST36 12 V), mit Schraubklemmen-Adapter: An einem trockenen Ort unter dem Dach: draußen liegen nur 12 V, keine Netzspannung an der Einheit
- **1 ×** M8-Steckverbinderpaar A-codiert, 4-polig, IP67, mit PUR-Kabel 4 × 0,34 mm², Ø5 mm: Zwischen dem Versorgungskabel (durch den Flanschtunnel und den Kanal) und dem kurzen Kabel der Einheit; er hängt oben in der Hülle und wird frei, wenn man die Einheit 8 cm absenkt
- **1 ×** Kabelverschraubung M12 × 1,5, IP68, für 4 bis 7 mm Kabel, mit Gegenmutter: Der einzige Kabeleingang des Elektronikgehäuses, in seiner Seitenwand innerhalb der Hülle
- **1 ×** Membranbelüftung ePTFE M12 × 1,5 zum Einschrauben, IP68, mit Gegenmutter (Klasse GORE PolyVent oder Amphenol LTW VENT-PS1): Im Gehäusedach: gleicht Druck und Feuchte aus, statt eines Silicagel-Beutels
- **1 ×** Lochrasterplatine 70 × 50 mm, mit Buchsenleisten für das ESP32-Board und JST- oder Schraubklemmen: Trägt den ESP32, die zwei Regler und den Kondensator; gleitet in die Schlitze des Gehäuses, Bauteile zur Hülle
- **1 ×** ESP32-WROVER-Entwicklungsboard (der Prototyp nutzt ein Freenove-ESP32-WROVER-Board): Führt die MicroPython-Firmware aus firmware/micropython/ aus
- **1 ×** Standard-Servo mit 25-Zahn-Verzahnung, 25 kg·cm digital (Klasse DS3218 / DS3225): Dreht die Scheibe; hängt in der Wiege des Gehäuses und läuft mit 6 V
- **1 ×** Abwärtsregler Pololu D36V50F6, 6 V, 5,5 A: Servoversorgung aus dem 12-V-Eingang
- **1 ×** 5-V-1-A-Abwärtsregler für die Logik (zum Beispiel Pololu D24V10F5 oder D36V6F5): ESP32-Versorgung aus 12 V, getrennt vom Servozweig
- **1 ×** Elektrolytkondensator 1000 µF, Low-ESR, 16 V, 105 °C (dazu ein 100-nF-Keramikkondensator): Parallel zur Servoversorgung
- **1 ×** Kleiner Lautsprecher, mit 100–220-Ω-Vorwiderstand: Ein Ton bei jeder Portion. Offener Punkt: das dichte Gehäuse hat noch keine Schallöffnung

### Benötigtes Werkzeug

- Bohrmaschine mit 76-mm-Lochsäge (mit Zentrierbohrer) und einem 3-mm-Bohrer: Ein Loch durch das Brett für das Futter und Vorbohrungen für die Holzschrauben
- Bohrschablone, auf A4 in 100 % gedruckt (im Bausatz oder als PDF auf der Anleitungsseite): Markiert das Loch, die 4 Schraubpunkte und die erste Kanalschraube; prüft den 50-mm-Maßstab
- PZ2-Schraubendreher, Vorstecher oder Bleistift, Klebeband, kleine Säge, Wasserwaage, Schutzbrille: Flansch montieren und das zweite Kanalstück auf Länge sägen
- Nur beim Eigenbau: Sechskant-Schraubendreher 2,5 mm, 100 mm lang: Alle M3-Schrauben; in der Montagereihenfolge der Anleitung erreicht ein gerader Schlüssel jede Schraube (die Rutschenschrauben brauchen etwa 75 mm)
- Nur beim Eigenbau: Lötkolben mit M3-Einsatzspitze und ein 0,8-mm-Bohrer: Die 12 Gewindeeinsätze einschmelzen; die 4 Ablauflöcher des gedruckten Bodens freibohren

Druckteile und ihre Dateien: [hardware/v6.2/](../hardware/v6.2/plates/README.md)
