ricricucit/kibble-dispenser/docs/BOM.md

<!-- Generated by site/bom.py from hardware/v6.3/bom.json; edit that, then run python site/bom.py -->

# Bought parts, design v6.3 / Pezzi extra / Zukaufteile

[English](#english) · [Italiano](#italiano) · [Deutsch](#deutsch)

Website: <https://ricricucit.github.io/kibble-dispenser/parts/>

## English

**Design v6.3 is designed, not yet printed or tested: quantities can still change.**

Everything you buy for the Kibble Dispenser Outdoor v6.3, besides the printed parts. Quantities and specifications come from the v6.3 design data. No shop links: buy wherever suits you.

### Screws, inserts and pins

Stainless steel throughout. In the kit the dispenser unit and the flange set come assembled: you only need the wood screws and the cable tie.

- **4 ×** Wood screw 5 × 35, pan head (5 × 30 for an 18 mm shelf): Flange set to the shelf, from below; they also clamp the cable jacket at the back
- **3 ×** M3 × 40 socket head cap screw, DIN 912 / ISO 4762, stainless A2: Clamp box, tower and bowl in one stack, from below (one through the outside ear, two through the box roof)
- **6 ×** Thread-forming screw for plastics PT K30 × 12 (EJOT PT or equivalent), Torx T10, stainless: 3 × cap to the box bosses, from below, with an O-ring 3 × 1 under each head; 3 × shell tabs to the bowl (Ø2.5 pilot holes, no inserts)
- **2 ×** Thread-forming screw for plastics PT K30 × 10 (EJOT PT or equivalent), Torx T10, stainless: Chute ears to the bowl, from below (Ø2.5 pilot holes, no inserts)
- **5 ×** M3 × 8 socket head cap screw, DIN 912 / ISO 4762, stainless A2: 4 × servo to the cradle in the box; 1 × hub to the servo spline
- **4 ×** M3 washer, DIN 125-A / ISO 7089 (3.2 × 7 × 0.5), stainless A2: Under the 4 servo screws
- **7 ×** M3 brass heat-set insert, 5.7 mm long, for a 4.0 mm hole (for example Ruthex RX-M3x5.7): 3 in the bowl for the stack screws, 4 in the servo cradle of the box
- **1 ×** Dowel pin Ø4 × 6, ISO 2338 m6, stainless: Pivot of the gate blade, pressed into the hole of the lower flange plate
- **1 ×** Cable tie 3.6 × 140, UV-stable PA66 (black): Strain relief: cinched round the 12 V cable in the window of the upper flange plate

### O-rings and grease

The other seals (rim lip seal, comb lips, skirt lip, chute lip, cap lip seal, shelf gasket, cable grommet) are printed in TPU 95A with the other parts. The O-rings 5 × 1 of the light pipes come with them (control panel). In the kit everything is greased at the factory.

- **2 ×** O-ring 9 × 2 mm, NBR 70: Shaft, both grooves, in the bushing at the top of the tower
- **1 ×** O-ring 24 × 2 mm, NBR 70: Face seal between the tower and the box
- **5 ×** O-ring 3 × 1 mm, NBR 70: 2 × under the stack-screw heads in the box roof, 3 × under the cap screws: the dry box stays sealed
- **1 ×** O-ring 132 × 2 mm, NBR 70: Seam between the shell and the cap, in the groove of the cap spigot
- **1 ×** O-ring 14 × 1.5 mm, NBR 70: Release button, in the groove of its hole in the shell
- **1 ×** Food-grade silicone grease, NSF H1 (a small tube is plenty): DIY only: a thin film on every O-ring when you fit it. Once assembled, the unit never needs grease

### Control panel

New in v6.3: the control panel in the cap (one button, two lights, the speaker). The firmware for the one-button panel is still to come (issue #2 on GitHub).

- **1 ×** IP67 momentary push-button, 12 mm, flush flat head, M12 × 1 front mount, short body (at most 14 mm behind the panel, Ø13), with front gasket: The one button of the control panel, in a paw-proof recess. Check the depth on the datasheet: 14 mm are free behind the mount wall
- **2 ×** Panel light pipe Ø5 × 9–10 mm, flat flush lens, Ø8 flange, clear PC, with an O-ring 5 × 1 NBR 70: Status and Wi-Fi lights, flush with the panel face
- **2 ×** LED 3 mm, one green (status) and one blue (Wi-Fi), with series resistors on the board: Behind the two light pipes
- **1 ×** Mylar speaker Ø20 × 4.5 mm, 8 Ω, 0.5 W, with a foam ring Ø20/12 × 1: A sound with every portion, on the dry floor behind the panel
- **1 ×** IP67 adhesive acoustic vent, ePTFE, Ø15 disc with Ø8 active area: Inside the speaker grille of the cap: sound out, water and dust stay out
- **1 ×** Panel harness, JST-XH 2.54 mm, 8 pins: Button, LEDs, speaker and one spare to the board; unplug it before you pull the cap off

### Electronics and cable

In the kit the dispenser unit comes pre-assembled and closed, with the electronics and the panel: this list is for DIY builders. The electronics are not final yet; wiring, fuse and the power chain are in firmware/README.md.

- **1 ×** 12 V 3 A outdoor-rated power supply, certified (for example Mean Well GST36 12 V), with a screw-terminal adapter: In a dry place under the roof: only 12 V runs outdoors, no mains voltage near the unit
- **1 ×** M8 A-coded 4-pin IP67 inline connector pair: Between the short cable of the unit and the supply cable, in the top of the pod; it comes free when you lower the unit 8 cm
- **1 ×** PUR cable 4 × 0.34 mm², Ø5 mm: the short cable of the unit and the supply cable: The supply cable runs through the flange tunnel and leaves at the back; clip it along the shelf with ordinary cable clips (not included)
- **1 ×** M12 × 1.5 cable gland, IP68, for 4 to 7 mm cable, with locknut: The only cable entry of the electronics box, in its side wall inside the pod
- **1 ×** M12 × 1.5 screw-in ePTFE membrane vent, IP68, with locknut (GORE PolyVent or Amphenol LTW VENT-PS1 class): In the box roof: balances pressure and humidity, instead of a silica gel bag
- **1 ×** Electronics module: 70 × 50 mm perfboard with an ESP32-WROVER dev board, a Pololu D36V50F6 6 V regulator (servo), a 5 V logic regulator and a 1000 µF capacitor: Slides up into the slots of the box; runs the firmware (the one-button version is still to come, issue #2)
- **1 ×** Standard-size servo with a 25-tooth spline, 25 kg·cm digital (DS3218 / DS3225 class): Turns the disc; hangs in the cradle in the box and runs on 6 V

### Tools needed

- Drill with a 76 mm hole saw (with its centre drill) and a 3 mm bit: One hole through the shelf for the food, and pilot holes for the wood screws
- Drilling template, printed on A4 at 100 % (in the kit, or as a PDF on the manual page): Marks the hole, the 4 screw points and the cable exit at the back; check its 50 mm scale bar
- PZ2 screwdriver, awl or pencil, tape, spirit level, safety glasses, cable clips for a 5 mm cable: Mounting the flange and clipping the cable along the shelf
- Torx T10 screwdriver: The three cap screws (service: unplug the panel harness before you pull the cap off)
- DIY only: 2.5 mm hex screwdriver, 100 mm long: The M3 screws of the stack, the servo and the hub
- DIY only: soldering iron with an M3 insert tip: Pressing in the 7 heat-set inserts

Printed parts and their files: [hardware/v6.3/](../hardware/v6.3/plates/README.md)

## Italiano

**Il progetto v6.3 è disegnato ma non ancora stampato né provato: le quantità possono ancora cambiare.**

Tutto quello che si compra per il Kibble Dispenser Outdoor v6.3, oltre ai pezzi stampati. Quantità e caratteristiche vengono dai dati del progetto v6.3. Nessun link a negozi: comprate dove preferite.

### Viti, inserti e perni

Tutto in acciaio inox. Nel kit l'unità dosatrice e il set flangia arrivano montati: servono solo le viti da legno e la fascetta.

- **4 ×** Vite da legno 5 × 35, testa bombata (5 × 30 per un ripiano da 18 mm): Set flangia al ripiano, da sotto; serrano anche la guaina del cavo dietro
- **3 ×** Vite M3 × 40 a testa cilindrica con esagono incassato, DIN 912 / ISO 4762, inox A2: Serrano scatola, torre e vasca in un solo pacco, da sotto (una nell'orecchia esterna, due attraverso il tetto della scatola)
- **6 ×** Vite autoformante per plastica PT K30 × 12 (EJOT PT o equivalente), Torx T10, inox: 3 × fondello ai bossoli della scatola, da sotto, con un O-ring 3 × 1 sotto ogni testa; 3 × alette del guscio alla vasca (fori pilota Ø2,5, senza inserti)
- **2 ×** Vite autoformante per plastica PT K30 × 10 (EJOT PT o equivalente), Torx T10, inox: Orecchie dello scivolo alla vasca, da sotto (fori pilota Ø2,5, senza inserti)
- **5 ×** Vite M3 × 8 a testa cilindrica con esagono incassato, DIN 912 / ISO 4762, inox A2: 4 × servo alla culla nella scatola; 1 × mozzo all'albero scanalato del servo
- **4 ×** Rondella M3, DIN 125-A / ISO 7089 (3,2 × 7 × 0,5), inox A2: Sotto le 4 viti del servo
- **7 ×** Inserto filettato M3 in ottone da inserire a caldo, lungo 5,7 mm, per foro da 4,0 mm (per esempio Ruthex RX-M3x5.7): 3 nella vasca per le viti del pacco, 4 nella culla del servo nella scatola
- **1 ×** Spina cilindrica Ø4 × 6, ISO 2338 m6, inox: Perno della lama della saracinesca, piantato nel foro della flangia inferiore
- **1 ×** Fascetta 3,6 × 140, PA66 resistente ai raggi UV (nera): Antistrappo: stretta intorno al cavo 12 V nella finestra della flangia superiore

### O-ring e grasso

Le altre guarnizioni (labbro del bordo, labbri a pettine, bordino, labbro dello scivolo, labbro del fondello, guarnizione del ripiano, passacavo) si stampano in TPU 95A con gli altri pezzi. Gli O-ring 5 × 1 delle guide luce sono con esse (pannello comandi). Nel kit tutto è ingrassato in fabbrica.

- **2 ×** O-ring 9 × 2 mm, NBR 70: Albero, entrambe le gole, nella boccola in cima alla torre
- **1 ×** O-ring 24 × 2 mm, NBR 70: Tenuta frontale tra torre e scatola
- **5 ×** O-ring 3 × 1 mm, NBR 70: 2 × sotto le teste delle viti del pacco nel tetto della scatola, 3 × sotto le viti del fondello: la scatola asciutta resta stagna
- **1 ×** O-ring 132 × 2 mm, NBR 70: Giunto tra guscio e fondello, nella gola del codolo del fondello
- **1 ×** O-ring 14 × 1,5 mm, NBR 70: Pulsante di sgancio, nella gola del suo foro nel guscio
- **1 ×** Grasso al silicone per alimenti, NSF H1 (basta un tubetto piccolo): Solo per chi costruisce: un velo su ogni O-ring al montaggio. Una volta montata, l'unità non chiede mai grasso

### Pannello comandi

Novità della v6.3: il pannello comandi nel fondello (un pulsante, due luci, l'altoparlante). Il firmware per il pannello a un pulsante deve ancora arrivare (issue #2 su GitHub).

- **1 ×** Pulsante momentaneo IP67 da 12 mm, testa piatta a filo, montaggio frontale M12 × 1, corpo corto (al massimo 14 mm dietro il pannello, Ø13), con guarnizione frontale: L'unico pulsante del pannello comandi, in un incavo a prova di zampa. Controllate la profondità sulla scheda tecnica: dietro la parete di montaggio ci sono 14 mm liberi
- **2 ×** Guida luce da pannello Ø5 × 9–10 mm, lente piatta a filo, flangia Ø8, PC trasparente, con un O-ring 5 × 1 NBR 70: Luci di stato e Wi-Fi, a filo della faccia del pannello
- **2 ×** LED da 3 mm, uno verde (stato) e uno blu (Wi-Fi), con resistenze in serie sulla scheda: Dietro le due guide luce
- **1 ×** Altoparlante in mylar Ø20 × 4,5 mm, 8 Ω, 0,5 W, con anello in spugna Ø20/12 × 1: Un suono a ogni porzione, sul fondo asciutto dietro il pannello
- **1 ×** Membrana acustica adesiva IP67, ePTFE, disco Ø15 con area attiva Ø8: Dentro la griglia dell'altoparlante nel fondello: il suono esce, acqua e polvere restano fuori
- **1 ×** Cablaggio del pannello, JST-XH 2,54 mm, 8 poli: Pulsante, LED, altoparlante e una riserva verso la scheda; staccatelo prima di togliere il fondello

### Elettronica e cavo

Nel kit l'unità dosatrice arriva già montata e chiusa, con l'elettronica e il pannello: questo elenco è per chi costruisce da sé. L'elettronica non è ancora definitiva; cablaggio, fusibile e catena di alimentazione sono in firmware/README.md.

- **1 ×** Alimentatore 12 V 3 A certificato (per esempio Mean Well GST36 12 V), con adattatore a morsetti: In un posto asciutto sotto il tetto: all'aperto arrivano solo 12 V, nessuna tensione di rete vicino all'unità
- **1 ×** Coppia di connettori in linea M8 codifica A, 4 poli, IP67: Tra il cavo corto dell'unità e il cavo di alimentazione, nella parte alta del guscio; si raggiunge abbassando l'unità di 8 cm
- **1 ×** Cavo PUR 4 × 0,34 mm², Ø5 mm: il cavo corto dell'unità e il cavo di alimentazione: Il cavo di alimentazione passa nel tunnel della flangia ed esce dietro; fissatelo lungo il ripiano con normali clip (non incluse)
- **1 ×** Pressacavo M12 × 1,5, IP68, per cavo da 4 a 7 mm, con controdado: L'unico ingresso cavo della scatola elettronica, nella parete laterale dentro il guscio
- **1 ×** Valvola a membrana ePTFE M12 × 1,5 a vite, IP68, con controdado (classe GORE PolyVent o Amphenol LTW VENT-PS1): Nel tetto della scatola: equilibra pressione e umidità, al posto del sacchetto di gel di silice
- **1 ×** Modulo elettronico: scheda millefori 70 × 50 mm con scheda ESP32-WROVER, regolatore Pololu D36V50F6 da 6 V (servo), regolatore 5 V per la logica e condensatore da 1000 µF: Scorre nelle guide della scatola; esegue il firmware (la versione a un pulsante deve ancora arrivare, issue #2)
- **1 ×** Servo formato standard con albero scanalato a 25 denti, 25 kg·cm digitale (classe DS3218 / DS3225): Gira il disco; sta nella culla della scatola e va a 6 V

### Attrezzi necessari

- Trapano con sega a tazza da 76 mm (con la sua punta di centraggio) e una punta da 3 mm: Un foro nel ripiano per il cibo e i fori pilota per le viti da legno
- Dima di foratura stampata su A4 al 100 % (nel kit, o come PDF nella pagina del manuale): Segna il foro, i 4 punti delle viti e l'uscita del cavo dietro; controllate la barra di scala da 50 mm
- Cacciavite PZ2, punteruolo o matita, nastro adesivo, livella, occhiali di protezione, clip per cavo da 5 mm: Montare la flangia e fissare il cavo lungo il ripiano
- Cacciavite Torx T10: Le tre viti del fondello (manutenzione: staccate il cablaggio del pannello prima di togliere il fondello)
- Solo per chi costruisce: cacciavite a brugola da 2,5 mm, lungo 100 mm: Le viti M3 del pacco, del servo e del mozzo
- Solo per chi costruisce: saldatore con punta per inserti M3: Inserire a caldo i 7 inserti

Pezzi stampati e i loro file: [hardware/v6.3/](../hardware/v6.3/plates/README.md)

## Deutsch

**Entwurf v6.3 ist konstruiert, aber noch nicht gedruckt oder getestet: die Mengen können sich noch ändern.**

Alles, was man für den Kibble Dispenser Outdoor v6.3 neben den Druckteilen kauft. Mengen und Angaben stammen aus den Konstruktionsdaten von v6.3. Keine Shop-Links: kauft, wo es euch passt.

### Schrauben, Einsätze und Stifte

Durchgehend Edelstahl. Im Bausatz kommen Spendereinheit und Flanschsatz montiert: ihr braucht nur die Holzschrauben und den Kabelbinder.

- **4 ×** Holzschraube 5 × 35, Linsenkopf (5 × 30 bei 18 mm Regalbrett): Flanschsatz an das Regalbrett, von unten; sie klemmen hinten auch den Kabelmantel
- **3 ×** Zylinderschraube M3 × 40 mit Innensechskant, DIN 912 / ISO 4762, Edelstahl A2: Spannen Gehäuse, Turm und Schale in einem Stapel, von unten (eine durch die äußere Lasche, zwei durch das Gehäusedach)
- **6 ×** Gewindeformende Kunststoffschraube PT K30 × 12 (EJOT PT oder gleichwertig), Torx T10, Edelstahl: 3 × Boden an die Dome des Gehäuses, von unten, mit einem O-Ring 3 × 1 unter jedem Kopf; 3 × Hüllenlaschen an die Schale (Vorbohrungen Ø2,5, ohne Einsätze)
- **2 ×** Gewindeformende Kunststoffschraube PT K30 × 10 (EJOT PT oder gleichwertig), Torx T10, Edelstahl: Rutschenlaschen an die Schale, von unten (Vorbohrungen Ø2,5, ohne Einsätze)
- **5 ×** Zylinderschraube M3 × 8 mit Innensechskant, DIN 912 / ISO 4762, Edelstahl A2: 4 × Servo an die Wiege im Gehäuse; 1 × Nabe an die Servoverzahnung
- **4 ×** Unterlegscheibe M3, DIN 125-A / ISO 7089 (3,2 × 7 × 0,5), Edelstahl A2: Unter den 4 Servoschrauben
- **7 ×** M3-Gewindeeinsatz aus Messing zum Einschmelzen, 5,7 mm lang, für ein 4,0-mm-Loch (zum Beispiel Ruthex RX-M3x5.7): 3 in der Schale für die Stapelschrauben, 4 in der Servowiege des Gehäuses
- **1 ×** Zylinderstift Ø4 × 6, ISO 2338 m6, Edelstahl: Drehachse des Schieberblatts, in das Loch des unteren Flanschs eingepresst
- **1 ×** Kabelbinder 3,6 × 140, UV-beständiges PA66 (schwarz): Zugentlastung: um das 12-V-Kabel im Fenster des oberen Flanschs zugezogen

### O-Ringe und Fett

Die übrigen Dichtungen (Randlippe, Kammlippen, Schürzenlippe, Rutschenlippe, Bodenlippe, Regalbrett-Dichtung, Kabeltülle) werden mit den anderen Teilen aus TPU 95A gedruckt. Die O-Ringe 5 × 1 der Lichtleiter gehören zu diesen (Bedienfeld). Im Bausatz ist alles ab Werk gefettet.

- **2 ×** O-Ring 9 × 2 mm, NBR 70: Welle, beide Nuten, in der Buchse oben im Turm
- **1 ×** O-Ring 24 × 2 mm, NBR 70: Stirndichtung zwischen Turm und Gehäuse
- **5 ×** O-Ring 3 × 1 mm, NBR 70: 2 × unter den Stapelschrauben im Gehäusedach, 3 × unter den Bodenschrauben: das trockene Gehäuse bleibt dicht
- **1 ×** O-Ring 132 × 2 mm, NBR 70: Fuge zwischen Hülle und Boden, in der Nut des Bodenzapfens
- **1 ×** O-Ring 14 × 1,5 mm, NBR 70: Entriegelungsknopf, in der Nut seiner Bohrung in der Hülle
- **1 ×** Lebensmittelechtes Silikonfett, NSF H1 (eine kleine Tube reicht): Nur beim Eigenbau: ein dünner Film auf jedem O-Ring beim Einbau. Montiert braucht die Einheit nie Fett

### Bedienfeld

Neu in v6.3: das Bedienfeld im Boden (ein Taster, zwei Lichter, der Lautsprecher). Die Firmware für das Ein-Knopf-Bedienfeld kommt noch (Issue #2 auf GitHub).

- **1 ×** IP67-Taster, 12 mm, flacher bündiger Kopf, Frontmontage M12 × 1, kurzer Körper (höchstens 14 mm hinter dem Panel, Ø13), mit Frontdichtung: Der einzige Taster des Bedienfelds, in einer pfotensicheren Mulde. Tiefe im Datenblatt prüfen: hinter der Montagewand sind 14 mm frei
- **2 ×** Panel-Lichtleiter Ø5 × 9–10 mm, flache bündige Linse, Flansch Ø8, klares PC, mit einem O-Ring 5 × 1 NBR 70: Status- und WLAN-Licht, bündig mit der Panelfläche
- **2 ×** LED 3 mm, eine grüne (Status) und eine blaue (WLAN), mit Vorwiderständen auf der Platine: Hinter den zwei Lichtleitern
- **1 ×** Mylar-Lautsprecher Ø20 × 4,5 mm, 8 Ω, 0,5 W, mit Schaumring Ø20/12 × 1: Ein Ton bei jeder Portion, auf dem trockenen Boden hinter dem Bedienfeld
- **1 ×** Klebende IP67-Akustikmembran, ePTFE, Scheibe Ø15 mit Ø8 aktiver Fläche: In der Lautsprecheröffnung des Bodens: der Ton geht raus, Wasser und Staub bleiben draußen
- **1 ×** Bedienfeld-Kabelbaum, JST-XH 2,54 mm, 8-polig: Taster, LEDs, Lautsprecher und eine Reserve zur Platine; vor dem Abnehmen des Bodens abziehen

### Elektronik und Kabel

Im Bausatz kommt die Spendereinheit vormontiert und verschlossen, mit Elektronik und Bedienfeld: diese Liste ist für den Eigenbau. Die Elektronik ist noch nicht endgültig; Verdrahtung, Sicherung und Stromversorgung stehen in firmware/README.md.

- **1 ×** Zertifiziertes 12-V-3-A-Netzteil (zum Beispiel Mean Well GST36 12 V), mit Schraubklemmen-Adapter: An einem trockenen Ort unter dem Dach: draußen liegen nur 12 V, keine Netzspannung an der Einheit
- **1 ×** M8-Steckverbinderpaar A-codiert, 4-polig, IP67: Zwischen dem kurzen Kabel der Einheit und dem Versorgungskabel, oben in der Hülle; frei, wenn man die Einheit 8 cm absenkt
- **1 ×** PUR-Kabel 4 × 0,34 mm², Ø5 mm: das kurze Kabel der Einheit und das Versorgungskabel: Das Versorgungskabel läuft durch den Flanschtunnel und tritt hinten aus; mit normalen Kabelclips am Brett befestigen (nicht enthalten)
- **1 ×** Kabelverschraubung M12 × 1,5, IP68, für 4 bis 7 mm Kabel, mit Gegenmutter: Der einzige Kabeleingang des Elektronikgehäuses, in seiner Seitenwand innerhalb der Hülle
- **1 ×** Membranbelüftung ePTFE M12 × 1,5 zum Einschrauben, IP68, mit Gegenmutter (Klasse GORE PolyVent oder Amphenol LTW VENT-PS1): Im Gehäusedach: gleicht Druck und Feuchte aus, statt eines Silicagel-Beutels
- **1 ×** Elektronikmodul: Lochrasterplatine 70 × 50 mm mit ESP32-WROVER-Board, Regler Pololu D36V50F6 6 V (Servo), 5-V-Logikregler und 1000-µF-Kondensator: Gleitet in die Schlitze des Gehäuses; führt die Firmware aus (die Ein-Knopf-Version kommt noch, Issue #2)
- **1 ×** Standard-Servo mit 25-Zahn-Verzahnung, 25 kg·cm digital (Klasse DS3218 / DS3225): Dreht die Scheibe; hängt in der Wiege des Gehäuses und läuft mit 6 V

### Benötigtes Werkzeug

- Bohrmaschine mit 76-mm-Lochsäge (mit Zentrierbohrer) und einem 3-mm-Bohrer: Ein Loch durch das Brett für das Futter und Vorbohrungen für die Holzschrauben
- Bohrschablone, auf A4 in 100 % gedruckt (im Bausatz oder als PDF auf der Anleitungsseite): Markiert das Loch, die 4 Schraubpunkte und den Kabelausgang hinten; prüft den 50-mm-Maßstab
- PZ2-Schraubendreher, Vorstecher oder Bleistift, Klebeband, Wasserwaage, Schutzbrille, Kabelclips für 5-mm-Kabel: Flansch montieren und das Kabel am Brett entlang befestigen
- Torx-T10-Schraubendreher: Die drei Bodenschrauben (Wartung: den Bedienfeld-Kabelbaum abziehen, bevor ihr den Boden abnehmt)
- Nur beim Eigenbau: Sechskant-Schraubendreher 2,5 mm, 100 mm lang: Die M3-Schrauben des Stapels, des Servos und der Nabe
- Nur beim Eigenbau: Lötkolben mit M3-Einsatzspitze: Die 7 Gewindeeinsätze einschmelzen

Druckteile und ihre Dateien: [hardware/v6.3/](../hardware/v6.3/plates/README.md)
