ricricucit/kibble-dispenser/docs/BOM-v6.md

<!-- Generated by site/bom.py from hardware/v6/bom.json; edit that, then run python site/bom.py -->

# Bought parts, design v6 / Pezzi extra / Zukaufteile

[English](#english) · [Italiano](#italiano) · [Deutsch](#deutsch)

Website: <https://ricricucit.github.io/kibble-dispenser/v6/parts/>

Archived: this is design v6. The current design is v6.3: [docs/BOM.md](BOM.md).

## English

**Design v6 is designed, not yet printed or tested: quantities can still change.**

Everything you buy for the Kibble Dispenser Outdoor v6, besides the printed parts. Quantities and specifications come from the v6 design data. No shop links: buy wherever suits you.

### Fasteners and inserts

- **4 ×** Wood screw 5 × 25, pan head (5 × 20 for an 18 mm shelf): Shelf flange to the shelf, from below; the heads sit in counterbores
- **3 ×** M3 × 12 socket head cap screw, DIN 912 / ISO 4762, stainless A2: Tower to the bowl base, from below
- **5 ×** M3 × 10 socket head cap screw, DIN 912 / ISO 4762, stainless A2: 3 × tower to the box, from above, outside the face O-ring; 2 × chute to the bowl nose, from below
- **5 ×** M3 × 8 socket head cap screw, DIN 912 / ISO 4762, stainless A2: 4 × servo tabs to the cradle in the box roof, from below; 1 × hub to the servo spline, from above
- **4 ×** M3 washer, DIN 125-A / ISO 7089 (3.2 × 7 × 0.5), stainless A2: Under the 4 servo screws
- **12 ×** M3 brass heat-set insert, 5.7 mm long, for a 4.0 mm hole (for example Ruthex RX-M3x5.7): 3 in the bowl base, 2 in the bowl nose, 3 in the box top (blind), 4 in the servo pads

### Seals and grease

The other seals (bayonet gasket, plate lips, shelf gasket, cover lip seal) are printed in TPU 95A with the other parts.

- **2 ×** O-ring 9 × 2 mm, NBR 70: Shaft, both grooves, inside the bushing at the top of the tower
- **1 ×** O-ring 24 × 2 mm, NBR 70: Face seal between the tower flange and the box top (groove outer diameter 28 mm, 2.7 × 1.5 mm)
- **1 ×** Food-grade silicone grease, NSF H1 (a small tube is plenty): A thin film on the shaft O-rings, the face O-ring and the cover lip seal

### Electronics module

In the kit the electronics box comes pre-assembled and fixed: this list is for DIY builders. Wiring, fuse and the full power chain are in firmware/README.md.

- **1 ×** 12 V 3 A outdoor power supply, certified (for example Mean Well GST36 12 V): Plug it into an indoor socket or a covered IP55 outdoor socket: only the 12 V cable runs outdoors, no mains voltage in the box
- **1 ×** IP67 inline connector, 2 poles, on the 12 V cable: The whole unit comes off with one twist and only the plug comes along (or leave slack in the cable)
- **1 ×** M16 × 1.5 cable gland, IP68, with locknut: The only cable entry (12 V), low on the end wall of the box, on a flat pad
- **1 ×** Pololu D36V50F6 step-down regulator, 6 V, 5.5 A: Servo supply from the 12 V input
- **1 ×** 5 V 1 A step-down regulator for the logic (for example Pololu D24V10F5 or D36V6F5): ESP32 supply from 12 V, separate from the servo branch
- **1 ×** 1000 µF low-ESR electrolytic capacitor, 16 V, 105 °C (plus a 100 nF ceramic capacitor): Across the servo connector
- **1 ×** Standard-size servo with a 25-tooth spline, 25 kg·cm digital (DS3218 / DS3225 class): Turns the disc; hangs in the cradle in the box roof and runs on 6 V
- **1 ×** ESP32-WROVER dev board (the prototype uses a Freenove ESP32-WROVER board): Runs the MicroPython firmware in firmware/micropython/
- **1 ×** Full-size breadboard, 165 × 55 mm (830 points): Carries the ESP32, the regulators and the capacitor; slides between the rails on the box wall
- **1 ×** Small speaker, with a 100–220 Ω series resistor: A sound with every portion. Open point: the sealed box has no sound opening yet
- **1 ×** Silica gel bag, 10 g, with a humidity indicator card: Takes up the moisture left in the box; replace or dry it at each service

### Optional

- **1 ×** PP-HT DN50 drain pipe (outer diameter 50 mm, inner 46.4 mm), cut to length: Slides over the chute spigot up to the step and carries the kibble down to the bowl; support it separately if it is longer than about 0.5 m

### Tools needed

- Drill with a 76 mm hole saw: One hole through the shelf, its centre 27 mm from the shaft axis
- 2.5 mm hex key: All M3 screws
- Screwdriver: The wood screws
- Pencil: Marking the hole and the screw positions
- Ruler: Measuring the hole position
- Spirit level: Checking that the shelf is level
- DIY only: soldering iron with an M3 insert tip: Pressing in the 12 heat-set inserts

Printed parts and their files: [hardware/v6/](../hardware/v6/README.md)

## Italiano

**Il progetto v6 è disegnato ma non ancora stampato né provato: le quantità possono ancora cambiare.**

Tutto quello che si compra per il Kibble Dispenser Outdoor v6, oltre ai pezzi stampati. Quantità e caratteristiche vengono dai dati del progetto v6. Nessun link a negozi: comprate dove preferite.

### Viteria e inserti

- **4 ×** Vite da legno 5 × 25, testa bombata (5 × 20 per un ripiano da 18 mm): Flangia al ripiano, da sotto; le teste stanno nelle svasature
- **3 ×** Vite M3 × 12 a testa cilindrica con esagono incassato, DIN 912 / ISO 4762, inox A2: Torre alla base della vasca, da sotto
- **5 ×** Vite M3 × 10 a testa cilindrica con esagono incassato, DIN 912 / ISO 4762, inox A2: 3 × torre alla scatola, da sopra, fuori dall'O-ring frontale; 2 × scivolo al muso della vasca, da sotto
- **5 ×** Vite M3 × 8 a testa cilindrica con esagono incassato, DIN 912 / ISO 4762, inox A2: 4 × alette del servo alla culla nel tetto della scatola, da sotto; 1 × mozzo all'albero scanalato del servo, da sopra
- **4 ×** Rondella M3, DIN 125-A / ISO 7089 (3,2 × 7 × 0,5), inox A2: Sotto le 4 viti del servo
- **12 ×** Inserto filettato M3 in ottone da inserire a caldo, lungo 5,7 mm, per foro da 4,0 mm (per esempio Ruthex RX-M3x5.7): 3 nella base della vasca, 2 nel muso della vasca, 3 nel tetto della scatola (ciechi), 4 nei supporti del servo

### Guarnizioni e grasso

Le altre guarnizioni (baionetta, labbri delle piastre, guarnizione del ripiano, labbro del fondello) si stampano in TPU 95A con gli altri pezzi.

- **2 ×** O-ring 9 × 2 mm, NBR 70: Albero, entrambe le gole, nella boccola in cima alla torre
- **1 ×** O-ring 24 × 2 mm, NBR 70: Tenuta frontale tra la flangia della torre e il tetto della scatola (gola con diametro esterno 28 mm, 2,7 × 1,5 mm)
- **1 ×** Grasso al silicone per uso alimentare, NSF H1 (basta un tubetto piccolo): Un velo sottile sugli O-ring dell'albero, sull'O-ring frontale e sulla guarnizione a labbro del fondello

### Modulo elettronico

Nel kit la scatola elettronica arriva già montata e fissata: questo elenco è per chi la costruisce da sé. Cablaggio, fusibile e catena di alimentazione completa sono in firmware/README.md.

- **1 ×** Alimentatore 12 V 3 A per esterni, certificato (per esempio Mean Well GST36 a 12 V): Va in una presa interna o in una presa esterna IP55 con coperchio: all'aperto corre solo il cavo a 12 V, nella scatola niente tensione di rete
- **1 ×** Connettore in linea IP67 a 2 poli sul cavo a 12 V: L'unità intera si stacca con un quarto di giro e viene via solo la spina (oppure lasciare un'ansa di cavo)
- **1 ×** Pressacavo M16 × 1,5, IP68, con controdado: L'unico ingresso cavo (12 V), in basso sulla parete di testa della scatola, su un piano
- **1 ×** Regolatore step-down Pololu D36V50F6, 6 V, 5,5 A: Alimentazione del servo dai 12 V in ingresso
- **1 ×** Regolatore step-down 5 V 1 A per la logica (per esempio Pololu D24V10F5 o D36V6F5): Alimentazione dell'ESP32 dai 12 V, separata dal ramo del servo
- **1 ×** Condensatore elettrolitico low-ESR da 1000 µF, 16 V, 105 °C (più un condensatore ceramico da 100 nF): Sul connettore del servo
- **1 ×** Servo di taglia standard con scanalato a 25 denti, digitale da 25 kg·cm (classe DS3218 / DS3225): Gira il disco; è appeso alla culla nel tetto della scatola e va a 6 V
- **1 ×** Scheda di sviluppo ESP32-WROVER (il prototipo usa una scheda Freenove ESP32-WROVER): Esegue il firmware MicroPython in firmware/micropython/
- **1 ×** Breadboard grande, 165 × 55 mm (830 punti): Porta l'ESP32, i regolatori e il condensatore; scorre tra le guide sulla parete della scatola
- **1 ×** Altoparlante piccolo, con resistenza in serie da 100–220 Ω: Un suono a ogni porzione. Punto aperto: la scatola stagna non ha ancora un'apertura per il suono
- **1 ×** Bustina di silica gel da 10 g, con cartoncino indicatore di umidità: Assorbe l'umidità rimasta nella scatola; da sostituire o rigenerare a ogni manutenzione

### Opzionale

- **1 ×** Tubo di scarico PP-HT DN50 (diametro esterno 50 mm, interno 46,4 mm), tagliato a misura: Si infila sul codolo dello scivolo fino al gradino e porta i croccantini giù fino alla ciotola; se è più lungo di circa 0,5 m va sostenuto a parte

### Attrezzi necessari

- Trapano con sega a tazza da 76 mm: Un foro nel ripiano, con il centro a 27 mm dall'asse dell'albero
- Chiave a brugola da 2,5 mm: Tutte le viti M3
- Cacciavite: Le viti da legno
- Matita: Per segnare il foro e le viti
- Righello: Per misurare la posizione del foro
- Livella: Per controllare che il ripiano sia in bolla
- Solo fai da te: saldatore con punta per inserti M3: Per inserire a caldo i 12 inserti filettati

Pezzi stampati e i loro file: [hardware/v6/](../hardware/v6/README.md)

## Deutsch

**Entwurf v6 ist konstruiert, aber noch nicht gedruckt oder getestet: die Mengen können sich noch ändern.**

Alles, was man für den Kibble Dispenser Outdoor v6 neben den Druckteilen kauft. Mengen und Angaben stammen aus den Konstruktionsdaten von v6. Keine Shop-Links: kauft, wo es euch passt.

### Schrauben und Gewindeeinsätze

- **4 ×** Holzschraube 5 × 25, Linsenkopf (5 × 20 bei 18 mm Regalbrett): Regalflansch an das Regalbrett, von unten; die Köpfe sitzen in Senkungen
- **3 ×** Zylinderschraube M3 × 12 mit Innensechskant, DIN 912 / ISO 4762, Edelstahl A2: Turm an den Schalenboden, von unten
- **5 ×** Zylinderschraube M3 × 10 mit Innensechskant, DIN 912 / ISO 4762, Edelstahl A2: 3 × Turm an das Gehäuse, von oben, außerhalb des Stirn-O-Rings; 2 × Rutsche an die Schalennase, von unten
- **5 ×** Zylinderschraube M3 × 8 mit Innensechskant, DIN 912 / ISO 4762, Edelstahl A2: 4 × Servolaschen an die Wiege im Gehäusedach, von unten; 1 × Nabe an die Servoverzahnung, von oben
- **4 ×** Unterlegscheibe M3, DIN 125-A / ISO 7089 (3,2 × 7 × 0,5), Edelstahl A2: Unter den 4 Servoschrauben
- **12 ×** M3-Gewindeeinsatz aus Messing zum Einschmelzen, 5,7 mm lang, für ein 4,0-mm-Loch (zum Beispiel Ruthex RX-M3x5.7): 3 im Schalenboden, 2 in der Schalennase, 3 im Gehäusedach (Sacklöcher), 4 in den Servoauflagen

### Dichtungen und Fett

Die übrigen Dichtungen (Bajonett, Plattenlippen, Regalbrett-Dichtung, Lippendichtung des Deckels) werden mit den anderen Teilen aus TPU 95A gedruckt.

- **2 ×** O-Ring 9 × 2 mm, NBR 70: Welle, beide Nuten, in der Buchse oben im Turm
- **1 ×** O-Ring 24 × 2 mm, NBR 70: Stirndichtung zwischen Turmflansch und Gehäusedach (Nut-Außendurchmesser 28 mm, 2,7 × 1,5 mm)
- **1 ×** Lebensmittelechtes Silikonfett, NSF H1 (eine kleine Tube reicht): Ein dünner Film auf den Wellen-O-Ringen, dem Stirn-O-Ring und der Lippendichtung des Deckels

### Elektronikmodul

Im Bausatz kommt das Elektronikgehäuse vormontiert und befestigt: diese Liste ist für Selbstbauer. Verdrahtung, Sicherung und die ganze Stromversorgung stehen in firmware/README.md.

- **1 ×** Netzteil 12 V 3 A für außen, zertifiziert (zum Beispiel Mean Well GST36 12 V): An eine Innensteckdose oder eine abgedeckte IP55-Außensteckdose: draußen verläuft nur das 12-V-Kabel, keine Netzspannung im Gehäuse
- **1 ×** IP67-Kabelsteckverbinder, 2-polig, im 12-V-Kabel: Die ganze Einheit lässt sich mit einer Vierteldrehung abnehmen, nur der Stecker kommt mit (oder Kabel mit Reserve verlegen)
- **1 ×** Kabelverschraubung M16 × 1,5, IP68, mit Gegenmutter: Die einzige Kabeleinführung (12 V), unten an der Stirnwand des Gehäuses, auf einer ebenen Fläche
- **1 ×** Abwärtsregler Pololu D36V50F6, 6 V, 5,5 A: Servoversorgung aus den 12 V am Eingang
- **1 ×** Abwärtsregler 5 V 1 A für die Logik (zum Beispiel Pololu D24V10F5 oder D36V6F5): ESP32-Versorgung aus 12 V, getrennt vom Servozweig
- **1 ×** Low-ESR-Elektrolytkondensator 1000 µF, 16 V, 105 °C (dazu ein 100-nF-Keramikkondensator): Am Servoanschluss
- **1 ×** Standard-Servo mit 25-Zahn-Verzahnung, digital, 25 kg·cm (Klasse DS3218 / DS3225): Dreht die Scheibe; hängt in der Wiege im Gehäusedach und läuft mit 6 V
- **1 ×** ESP32-WROVER-Entwicklungsboard (der Prototyp nutzt ein Freenove ESP32-WROVER-Board): Führt die MicroPython-Firmware aus firmware/micropython/ aus
- **1 ×** Großes Steckbrett, 165 × 55 mm (830 Kontakte): Trägt ESP32, Regler und Kondensator; wird zwischen die Schienen an der Gehäusewand geschoben
- **1 ×** Kleiner Lautsprecher mit 100–220-Ω-Vorwiderstand: Ein Ton bei jeder Portion. Offener Punkt: das dichte Gehäuse hat noch keine Schallöffnung
- **1 ×** Silicagel-Beutel 10 g mit Feuchteindikatorkarte: Nimmt die Restfeuchte im Gehäuse auf; bei jeder Wartung tauschen oder trocknen

### Optional

- **1 ×** HT-Abflussrohr DN50 aus PP (außen 50 mm, innen 46,4 mm), auf Länge geschnitten: Wird bis zur Stufe auf den Rutschenstutzen geschoben und führt das Futter bis zum Napf; ab etwa 0,5 m Länge separat abstützen

### Benötigtes Werkzeug

- Bohrmaschine mit 76-mm-Lochsäge: Ein Loch durch das Regalbrett, Mitte 27 mm neben der Wellenachse
- Innensechskantschlüssel 2,5 mm: Alle M3-Schrauben
- Schraubendreher: Die Holzschrauben
- Bleistift: Loch und Schraubenpositionen anzeichnen
- Lineal: Lochposition abmessen
- Wasserwaage: Prüfen, ob das Regalbrett waagerecht ist
- Nur Selbstbau: Lötkolben mit M3-Einschmelzspitze: Zum Einschmelzen der 12 Gewindeeinsätze

Druckteile und ihre Dateien: [hardware/v6/](../hardware/v6/README.md)
