ricricucit/kibble-dispenser/hardware/3mf/passante_culla.3mf

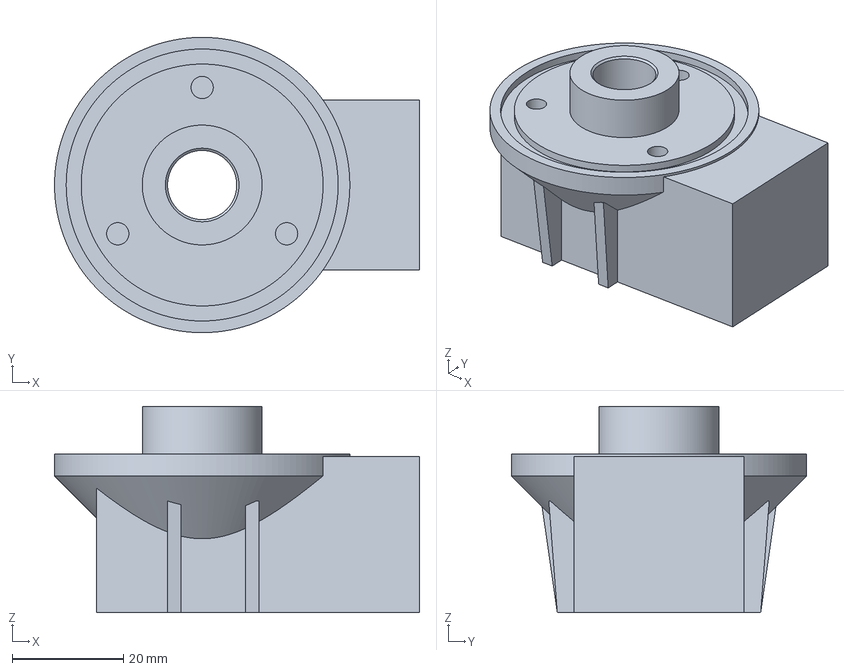
[picture p42: CAD file, 2026-11-08]
hardware/3mf/passante_culla.3mf
65.5 x 53.0 x 37.0 mm
