ricricucit/kibble-dispenser/hardware/assembly/disco_v3.stl

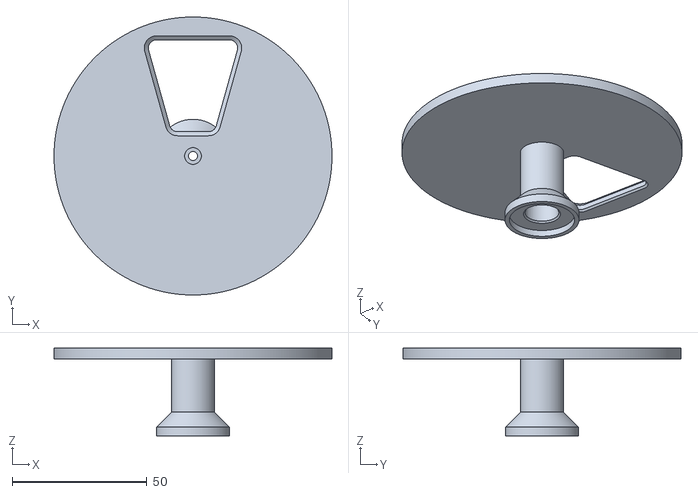
[picture p43: CAD file, 2026-11-08]
hardware/assembly/disco_v3.stl
103.0 x 103.0 x 32.5
