ricricucit/kibble-dispenser/hardware/v6.3/assembly/fondello_v63_bordo.stl

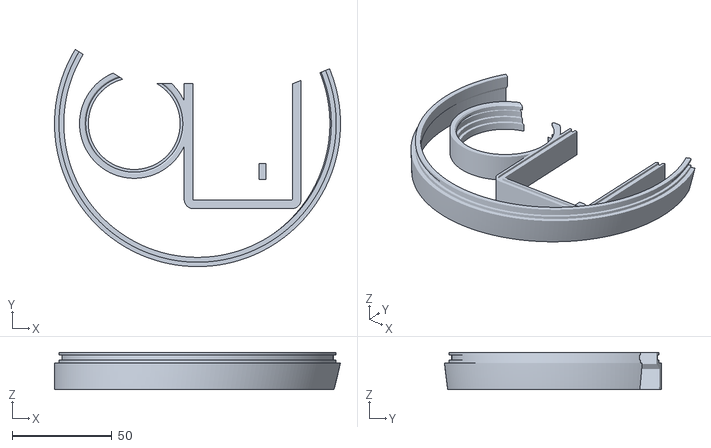
[picture p44: CAD file, 2026-11-11]
hardware/v6.3/assembly/fondello_v63_bordo.stl
143.4 x 108.9 x 18.6
