ricricucit/kibble-dispenser/hardware/v6.3/plates/Kibble_Dispenser_v63_TPU.bambu.3mf

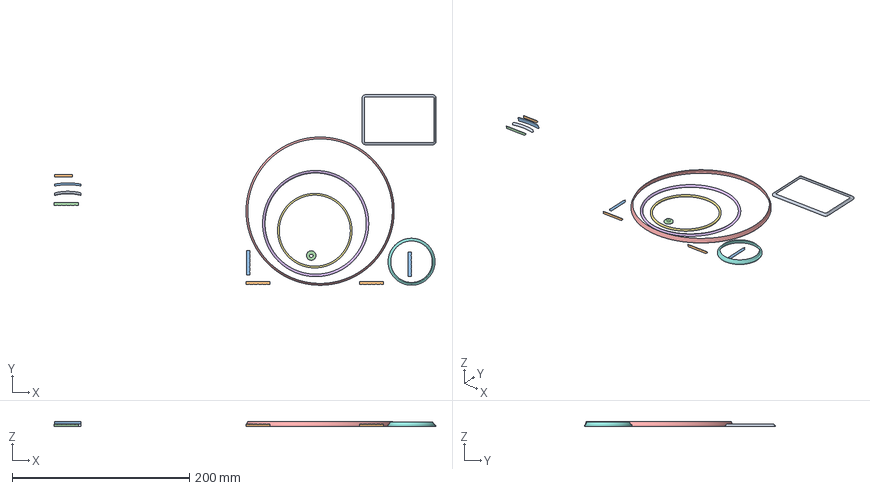
[picture p45: CAD file, 2026-11-11]
hardware/v6.3/plates/Kibble_Dispenser_v63_TPU.bambu.3mf
430.5 x 214.8 x 5.33 mm
test_rim_lip
test_cap_lip
test_skirt_lip
test_comb_lip
labbro_ombra_v611
guarnizione_baionetta_v61
guarnizione_piano_v5
labbro_scivolo_v611
guarnizione_fondello_v61
labbro_pettine_v62 x 4
passacavo_v63
