ricricucit/kibble-dispenser/hardware/v6.3/plates/plates/PETG-4_upper_flange.3mf

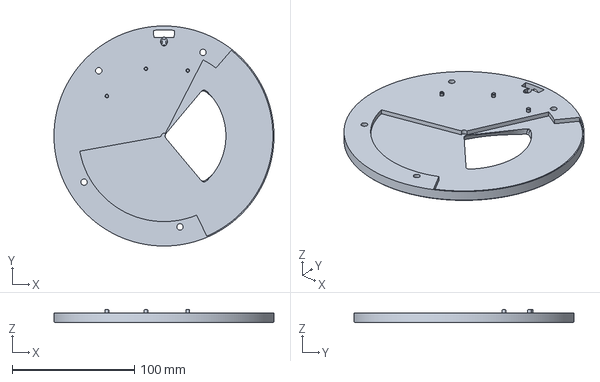
[picture p46: CAD file, 2026-11-11]
hardware/v6.3/plates/plates/PETG-4_upper_flange.3mf
180.0 x 180.0 x 10.8 mm
