ricricucit/kibble-dispenser/site/assembly/models/oring_3x1_cap_2.stl

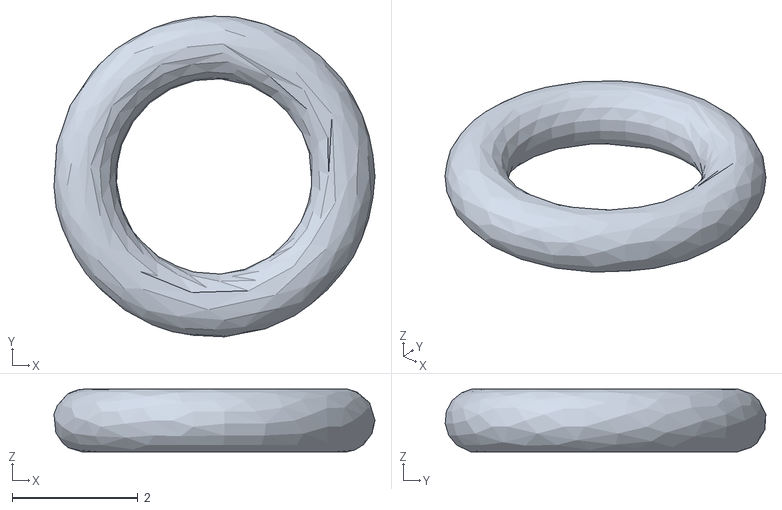
[picture p47: CAD file, 2026-11-11]
site/assembly/models/oring_3x1_cap_2.stl
5.10 x 5.10 x 1.00
