ricricucit/kibble-dispenser/site/v6.2/assembly/models/inserti_vasca_7.stl

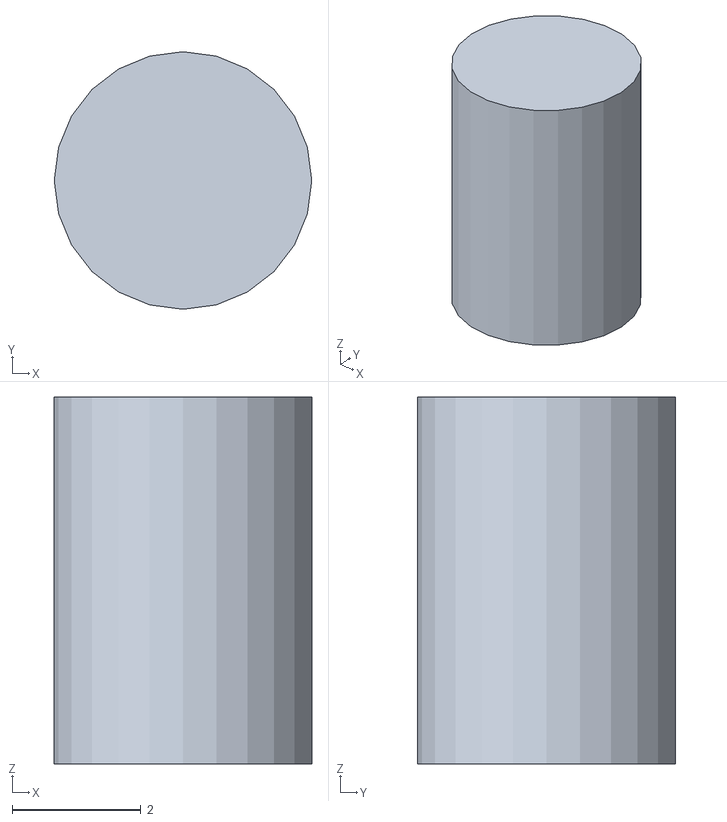
[picture p48: CAD file, 2026-11-10]
site/v6.2/assembly/models/inserti_vasca_7.stl
4.00 x 4.00 x 5.70
