ricricucit/kibble-dispenser/hardware/3mf/albero_mozzo.3mf

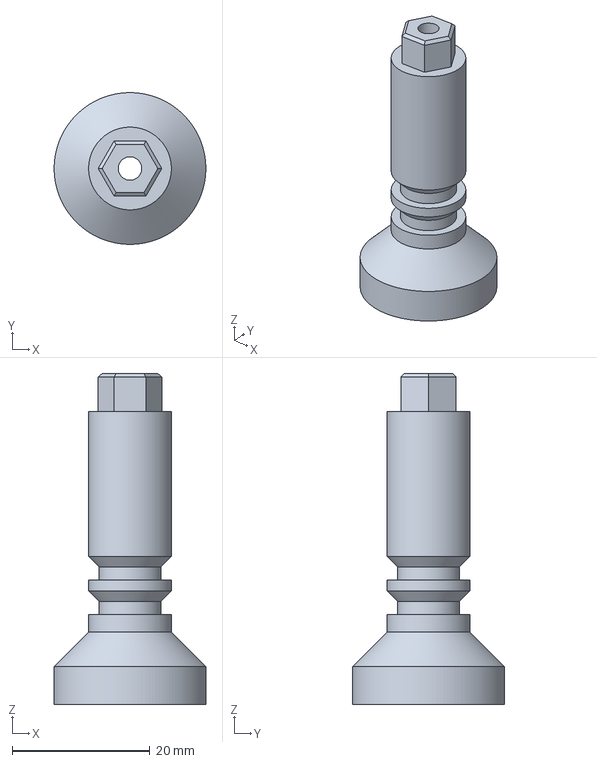
[picture p49: CAD file, 2026-11-08]
hardware/3mf/albero_mozzo.3mf
22.0 x 22.0 x 48.0 mm
