ricricucit/kibble-dispenser/hardware/v6.3/assembly/saracinesca_v63.stl

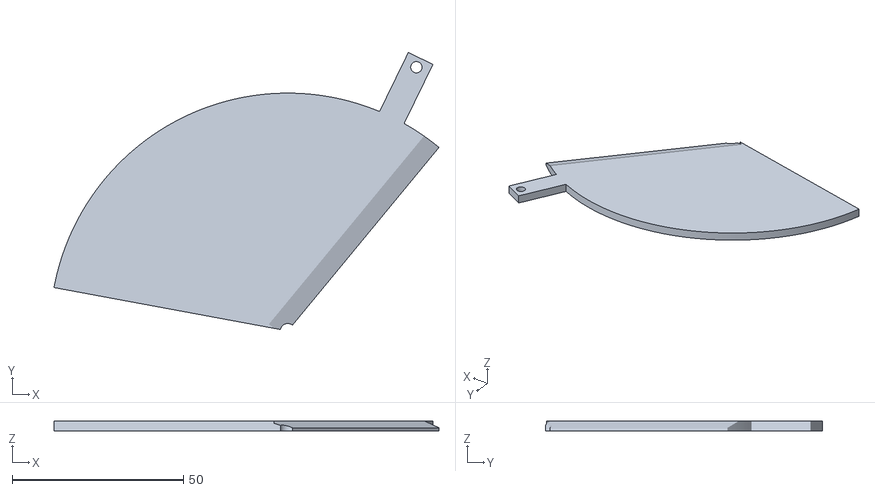
[picture p50: CAD file, 2026-11-11]
hardware/v6.3/assembly/saracinesca_v63.stl
112.5 x 81.0 x 3.00
