ricricucit/kibble-dispenser/hardware/v6.3/plates/Kibble_Dispenser_v63_PETG.bambu.3mf

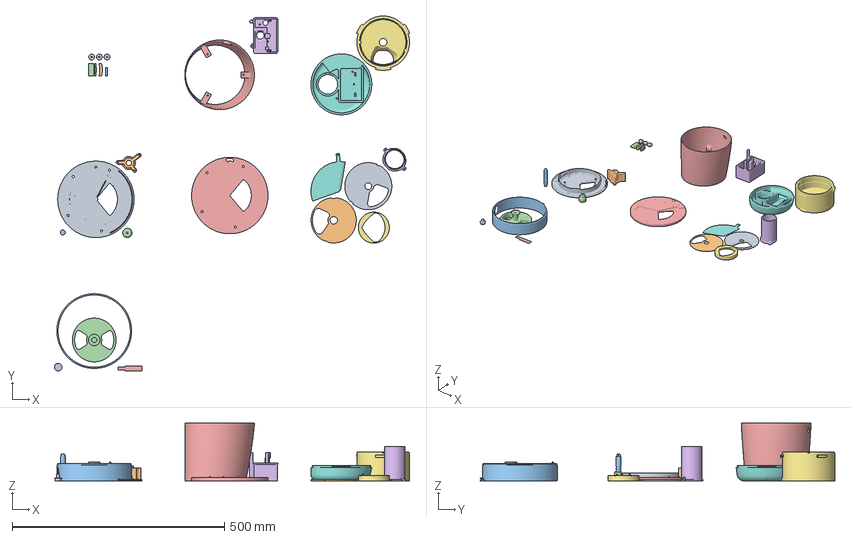
[picture p51: CAD file, 2026-11-11]
hardware/v6.3/plates/Kibble_Dispenser_v63_PETG.bambu.3mf
836.8 x 835.9 x 136.0 mm
test_scanalato
test_groove_rim
test_groove_cap
test_groove_skirt
guscio_v611
scatola_v63
chiocciola_v63
fondello_v63
flangia_piano_v63
colonna_v63
albero_v6
mozzo_v6
flangia_alta_v63
scivolo_v611
colletto_v6
saracinesca_v63
piastra_finestra_v62
piastra_gate_v62
anello_saracinesca_v63
disco_v61
linguetta_sicura_v63
pulsante_v611
