ricricucit/kibble-dispenser/hardware/v6.3/plates/plates/PETG-3_lower_flange__tower__shaft__hub.3mf

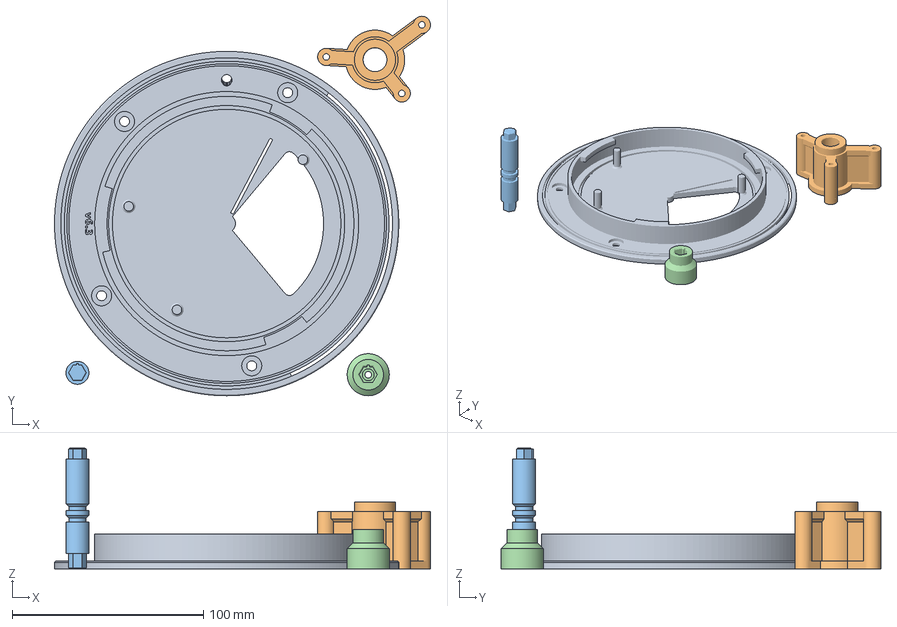
[picture p52: CAD file, 2026-11-11]
hardware/v6.3/plates/plates/PETG-3_lower_flange__tower__shaft__hub.3mf
196.5 x 198.4 x 63.0 mm
flangia_piano_v63
colonna_v63
albero_v6
mozzo_v6
