ricricucit/kibble-dispenser/hardware/v6.3/plates/stl/anello_saracinesca_v63_print.stl

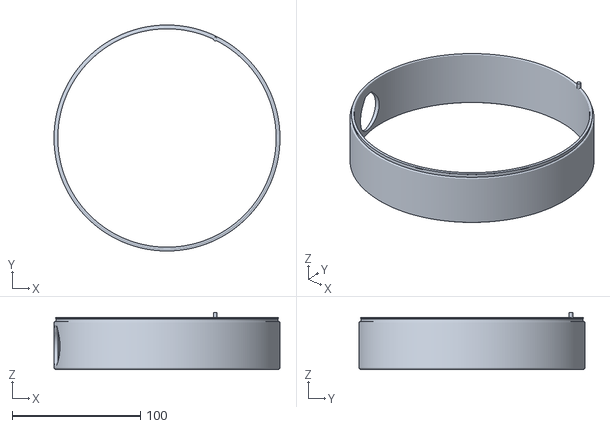
[picture p53: CAD file, 2026-11-11]
hardware/v6.3/plates/stl/anello_saracinesca_v63_print.stl
176.0 x 176.0 x 44.5
