ricricucit/kibble-dispenser/site/assembly/models/viti_guscio_0.stl

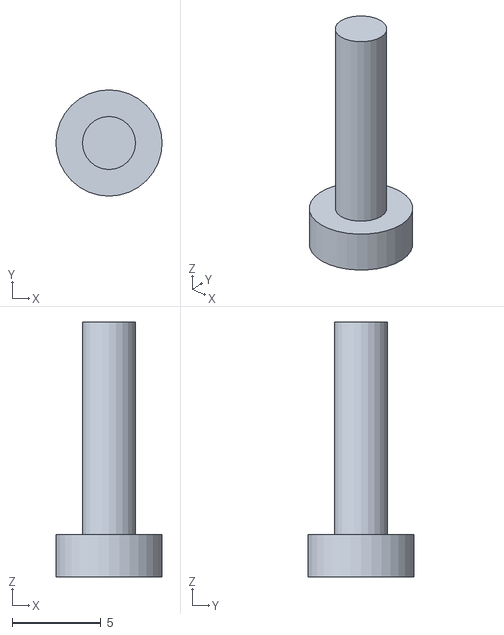
[picture p54: CAD file, 2026-11-11]
site/assembly/models/viti_guscio_0.stl
6.00 x 6.00 x 14.4
