ricricucit/kibble-dispenser/site/v6.2/assembly/models/nottolino_v611_A_0.stl

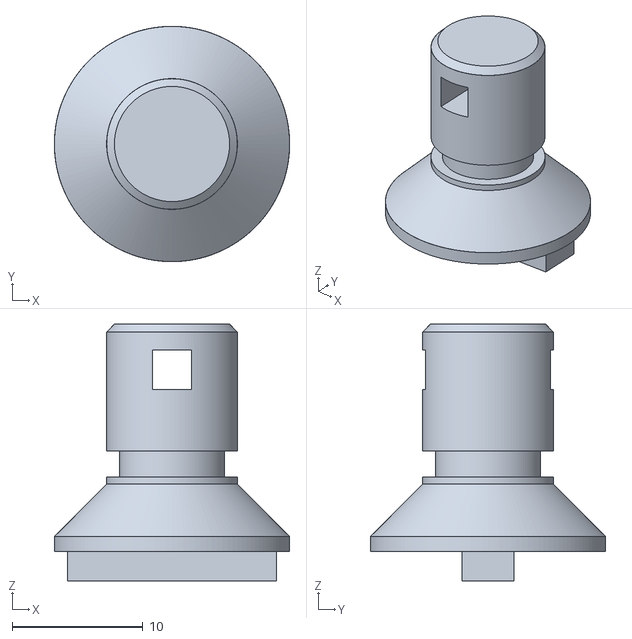
[picture p55: CAD file, 2026-11-10]
site/v6.2/assembly/models/nottolino_v611_A_0.stl
18.0 x 18.0 x 19.6
