ricricucit/kibble-dispenser/hardware/v6.3/assembly/passacavo_v63.stl

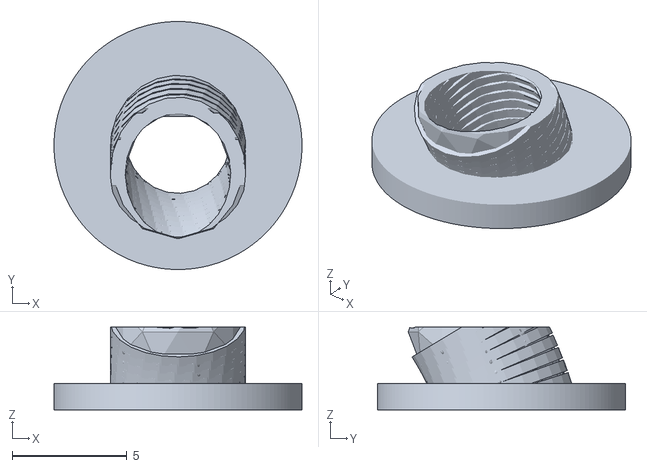
[picture p56: CAD file, 2026-11-11]
hardware/v6.3/assembly/passacavo_v63.stl
10.8 x 10.8 x 3.60
