ricricucit/kibble-dispenser/hardware/v6.3/plates/plates/PETG-2_bowl__pod_cap.3mf

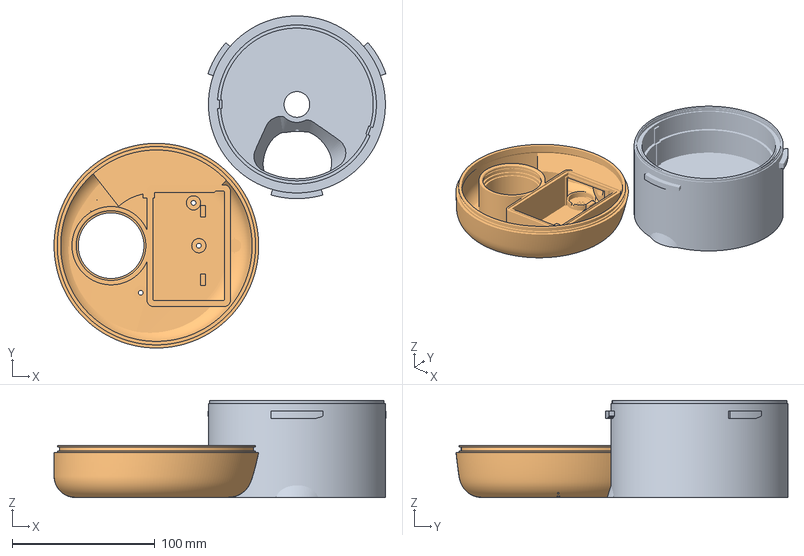
[picture p57: CAD file, 2026-11-11]
hardware/v6.3/plates/plates/PETG-2_bowl__pod_cap.3mf
232.6 x 232.7 x 68.0 mm
chiocciola_v63
fondello_v63
