ricricucit/kibble-dispenser/hardware/v6.3/plates/stl/scatola_v63_print.stl

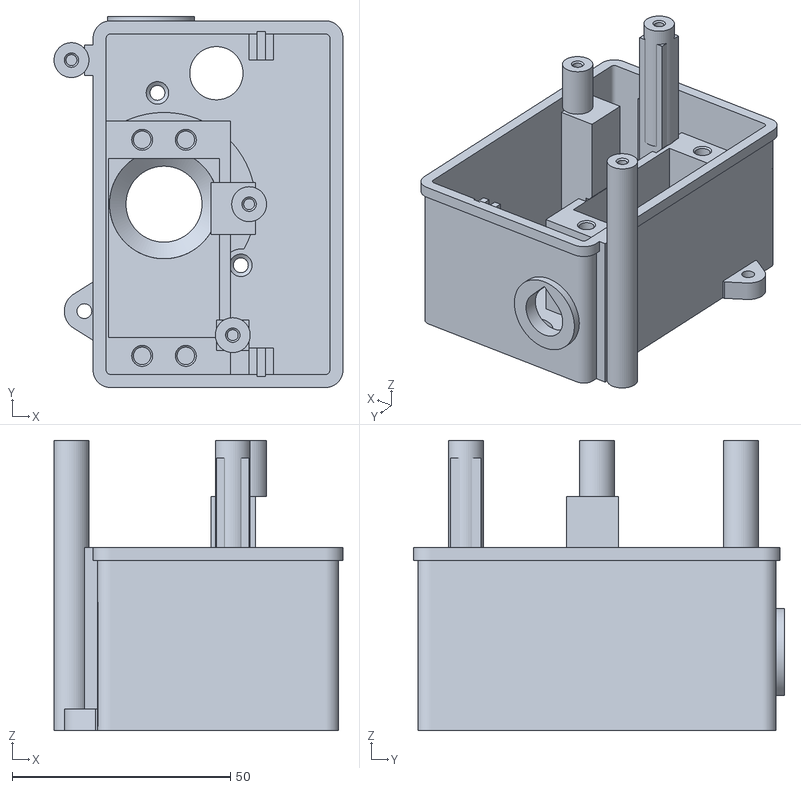
[picture p58: CAD file, 2026-11-11]
hardware/v6.3/plates/stl/scatola_v63_print.stl
66.2 x 85.0 x 66.5
