ricricucit/kibble-dispenser/site/v6.2/assembly/models/lips_lower_0.stl

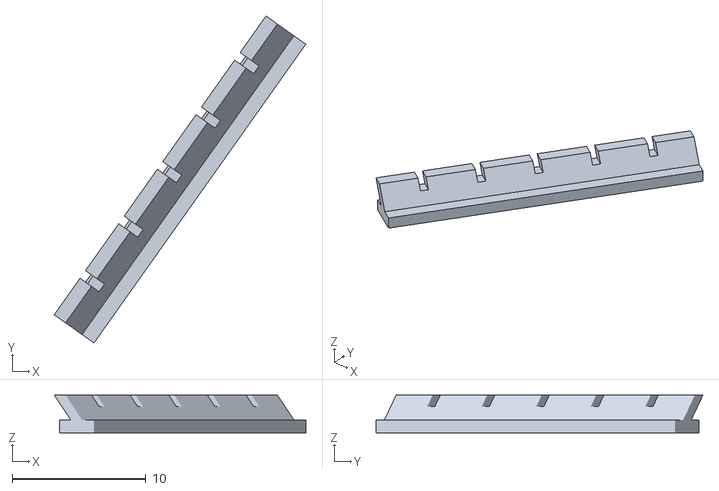
[picture p59: CAD file, 2026-11-10]
site/v6.2/assembly/models/lips_lower_0.stl
18.8 x 24.5 x 2.83
