ricricucit/kibble-dispenser/hardware/3mf/test_scanalato.3mf

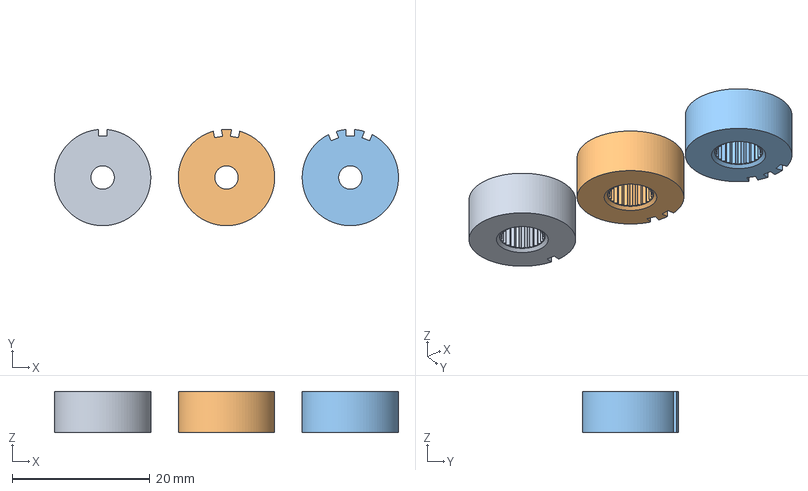
[picture p60: CAD file, 2026-11-08]
hardware/3mf/test_scanalato.3mf
50.0 x 14.0 x 6.00 mm
spline_c005
spline_c010
spline_c020
