ricricucit/kibble-dispenser/hardware/assembly/scivolo_v1.stl

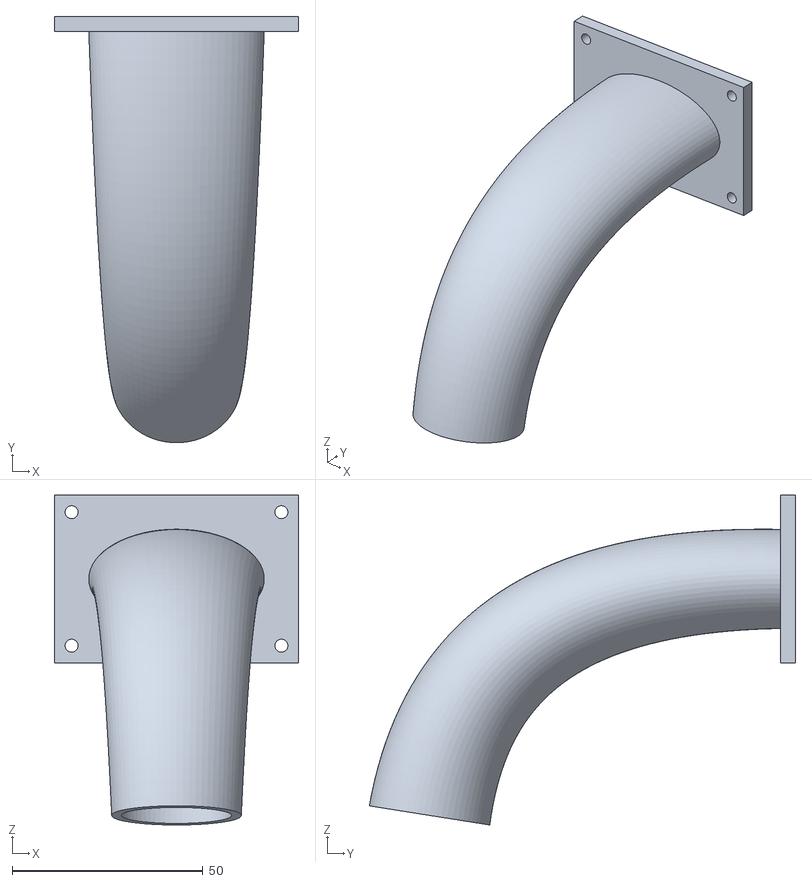
[picture p61: CAD file, 2026-11-08]
hardware/assembly/scivolo_v1.stl
64.0 x 111.8 x 86.5
