ricricucit/kibble-dispenser/hardware/v6.3/assembly/flangia_piano_v63.stl

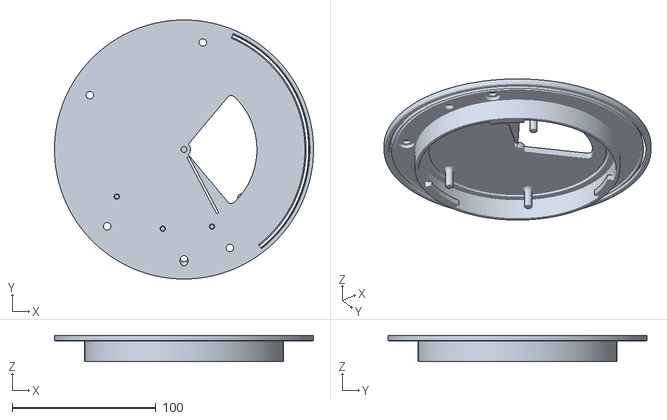
[picture p62: CAD file, 2026-11-11]
hardware/v6.3/assembly/flangia_piano_v63.stl
180.0 x 180.0 x 18.1
