ricricucit/kibble-dispenser/hardware/v6.3/plates/plates/PETG-6_interlock_ring__disc__latch__button.3mf

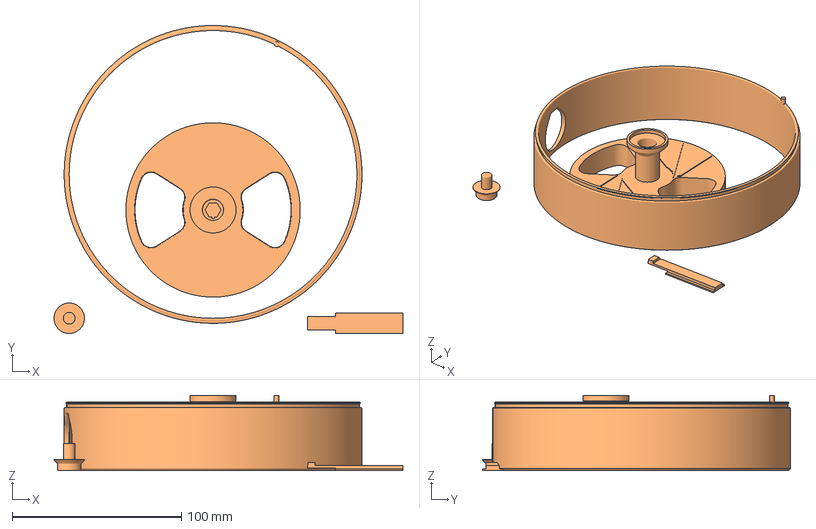
[picture p63: CAD file, 2026-11-11]
hardware/v6.3/plates/plates/PETG-6_interlock_ring__disc__latch__button.3mf
206.2 x 182.0 x 44.5 mm
anello_saracinesca_v63
disco_v61
linguetta_sicura_v63
pulsante_v611
