ricricucit/kibble-dispenser/hardware/v6.3/plates/stl/chiocciola_v63_print.stl

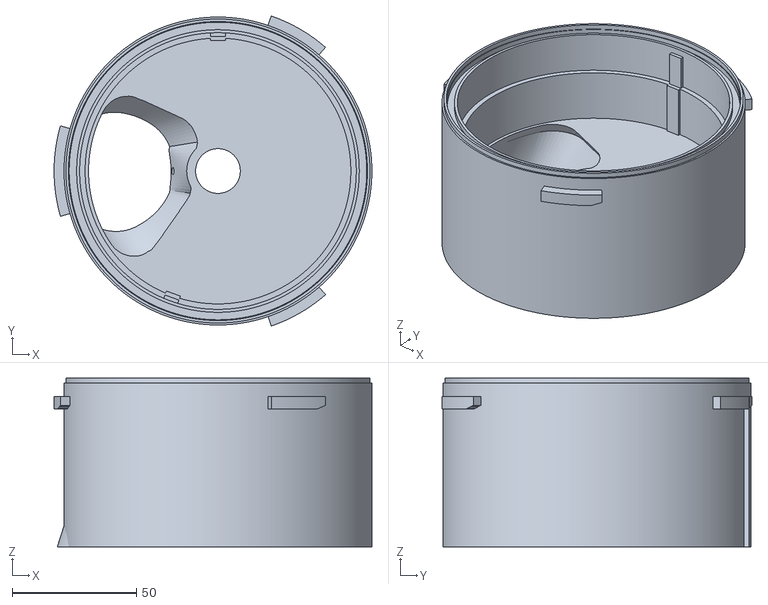
[picture p64: CAD file, 2026-11-11]
hardware/v6.3/plates/stl/chiocciola_v63_print.stl
128.0 x 124.8 x 68.0
