ricricucit/kibble-dispenser/site/assembly/models/leds_3mm.stl

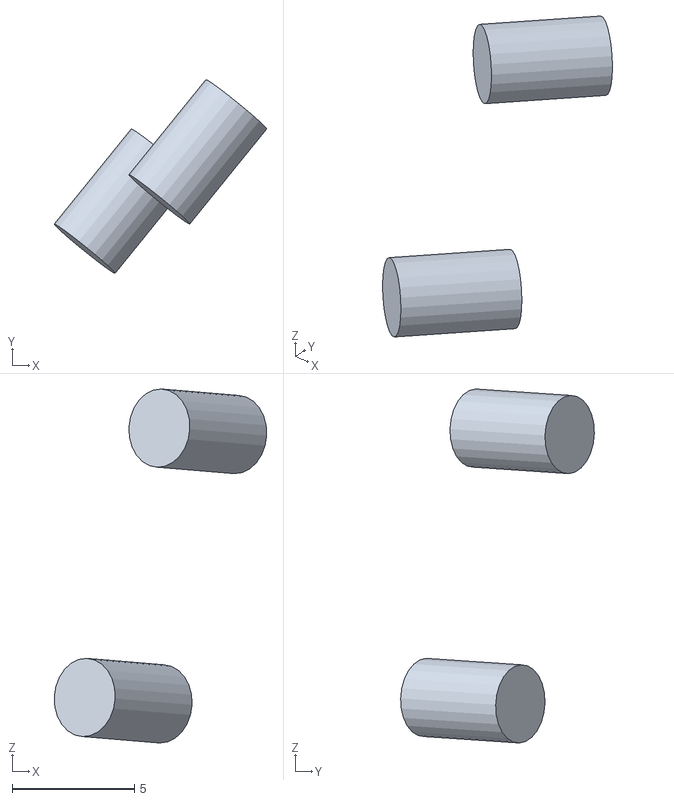
[picture p65: CAD file, 2026-11-11]
site/assembly/models/leds_3mm.stl
8.67 x 7.91 x 14.5
