ricricucit/kibble-dispenser/hardware/v6.3/assembly/fondello_v63_fondo.stl

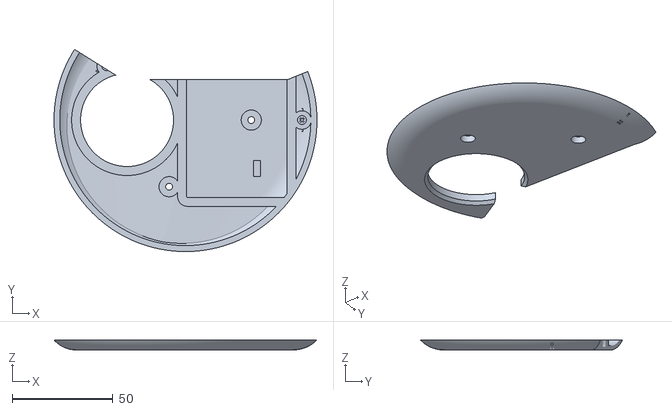
[picture p66: CAD file, 2026-11-11]
hardware/v6.3/assembly/fondello_v63_fondo.stl
130.2 x 100.1 x 5.00
