ricricucit/kibble-dispenser/hardware/v6.3/plates/plates/TPU-0_rim_cap_skirt_and_comb_lips.3mf

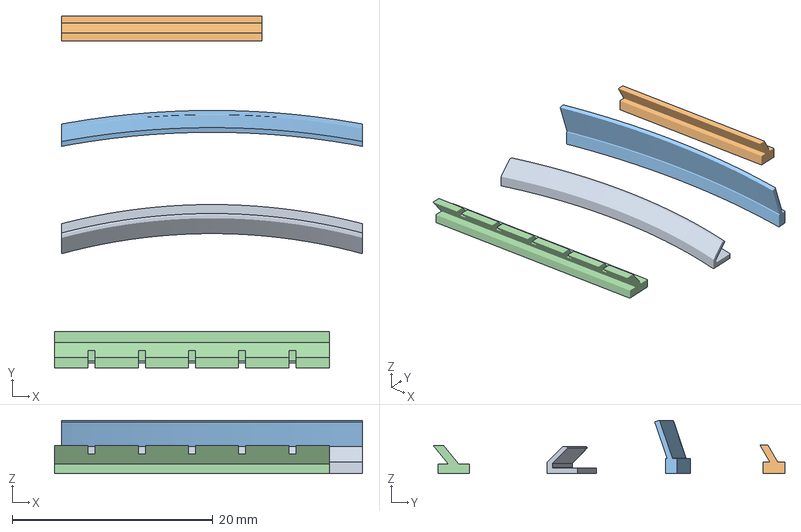
[picture p67: CAD file, 2026-11-11]
hardware/v6.3/plates/plates/TPU-0_rim_cap_skirt_and_comb_lips.3mf
30.7 x 35.1 x 5.33 mm
test_rim_lip
test_cap_lip
test_skirt_lip
test_comb_lip
