ricricucit/kibble-dispenser/hardware/v6.3/plates/stl/colonna_v63_print.stl

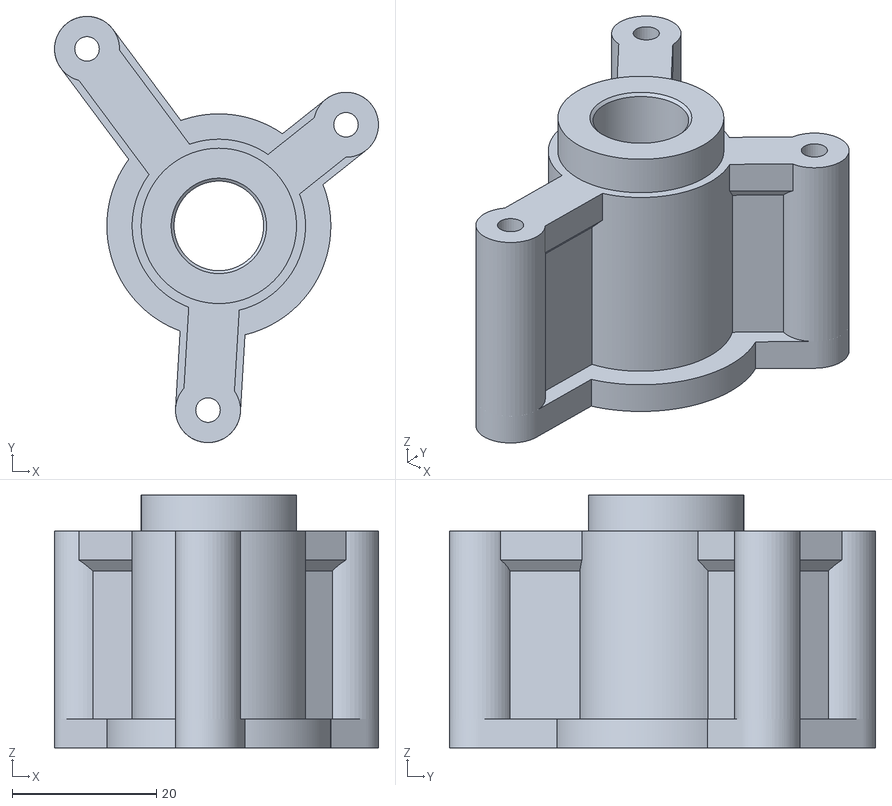
[picture p68: CAD file, 2026-11-11]
hardware/v6.3/plates/stl/colonna_v63_print.stl
44.9 x 59.0 x 35.0
