ricricucit/kibble-dispenser/site/v6.2/assembly/models/piastra_gate_nero.stl

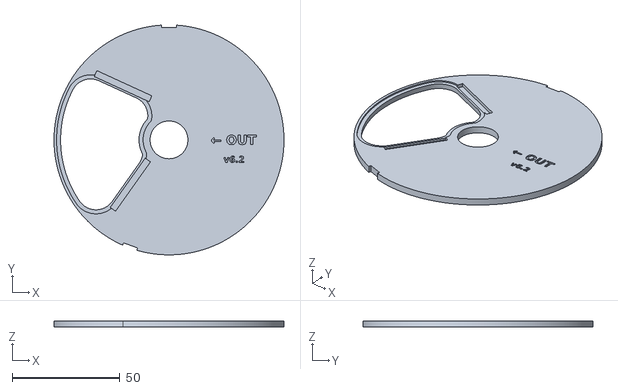
[picture p69: CAD file, 2026-11-10]
site/v6.2/assembly/models/piastra_gate_nero.stl
106.5 x 106.4 x 3.00
