ricricucit/kibble-dispenser/hardware/v6.3/assembly/fondello_v63_pannello_4.stl

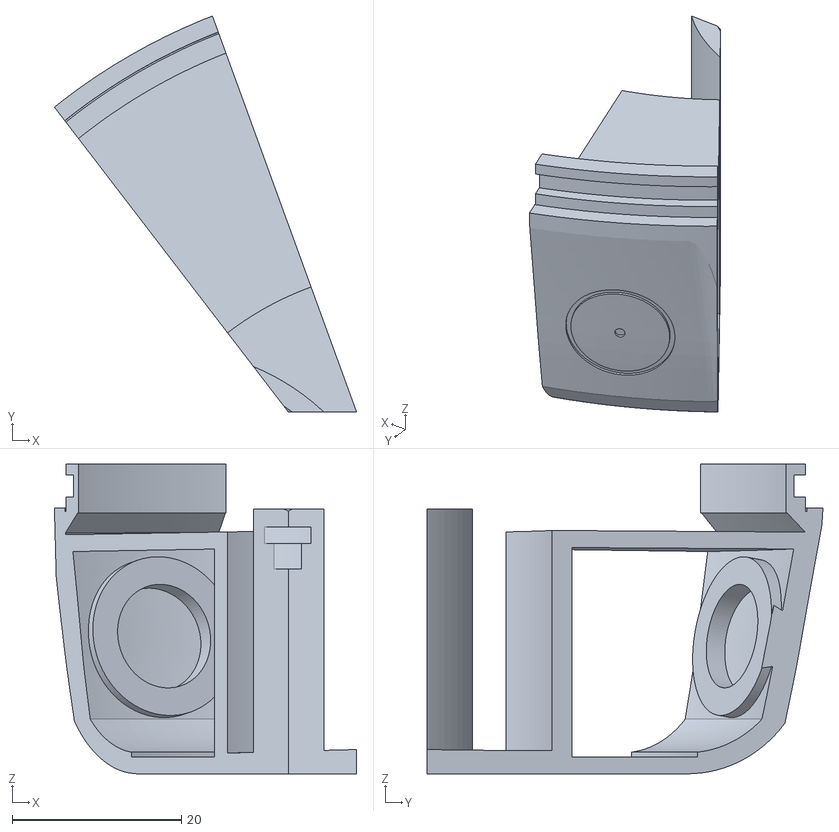
[picture p70: CAD file, 2026-11-11]
hardware/v6.3/assembly/fondello_v63_pannello_4.stl
35.7 x 46.8 x 36.6
