ricricucit/kibble-dispenser/hardware/v6.3/plates/plates/TPU-1_all_seals.3mf

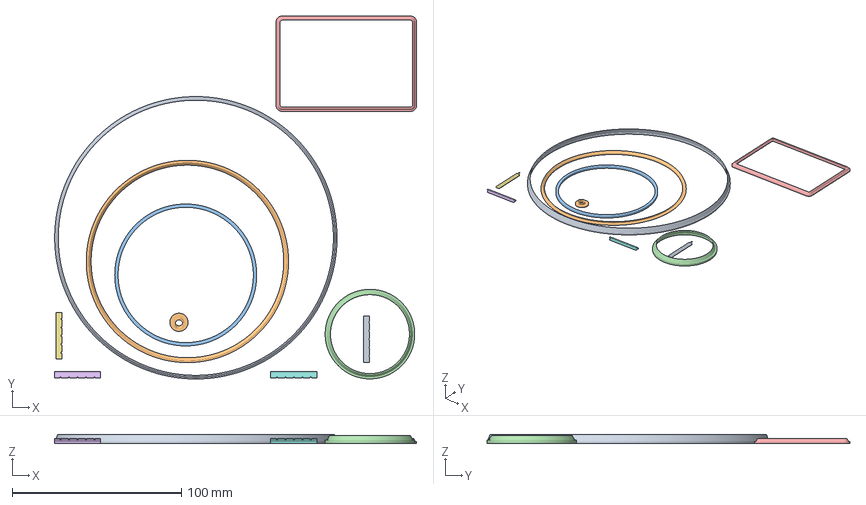
[picture p71: CAD file, 2026-11-11]
hardware/v6.3/plates/plates/TPU-1_all_seals.3mf
214.3 x 214.8 x 5.33 mm
labbro_ombra_v611
guarnizione_baionetta_v61
guarnizione_piano_v5
labbro_scivolo_v611
guarnizione_fondello_v61
labbro_pettine_v62#1
labbro_pettine_v62#2
labbro_pettine_v62#3
labbro_pettine_v62#4
passacavo_v63
