ricricucit/kibble-dispenser/site/assembly/models/guarnizione_piano.stl

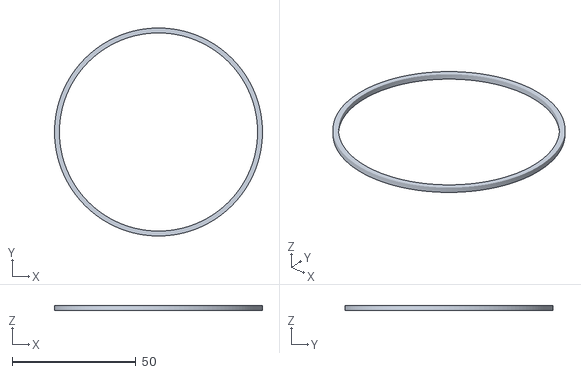
[picture p72: CAD file, 2026-11-11]
site/assembly/models/guarnizione_piano.stl
84.0 x 84.0 x 2.00
