ricricucit/kibble-dispenser/site/v6.2/assembly/models/flangia_alta_v62.stl

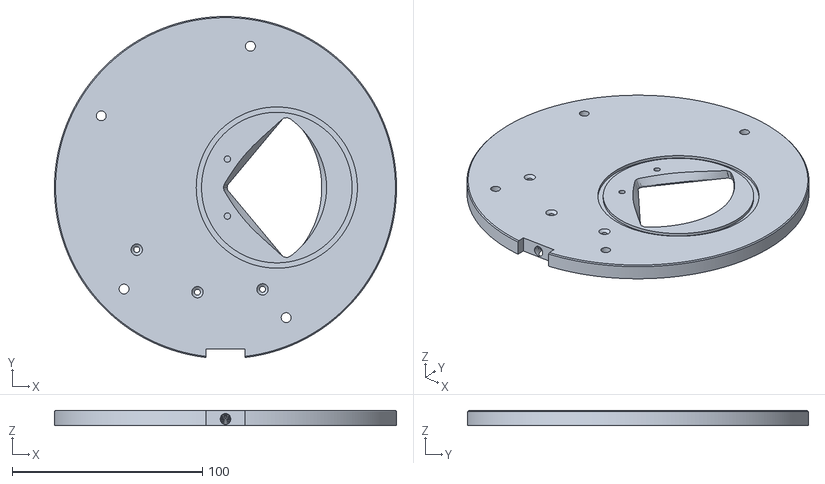
[picture p73: CAD file, 2026-11-10]
site/v6.2/assembly/models/flangia_alta_v62.stl
180.0 x 179.4 x 8.00
