ricricucit/kibble-dispenser/hardware/v6.3/assembly/bought_pt_k30x12_cap.stl

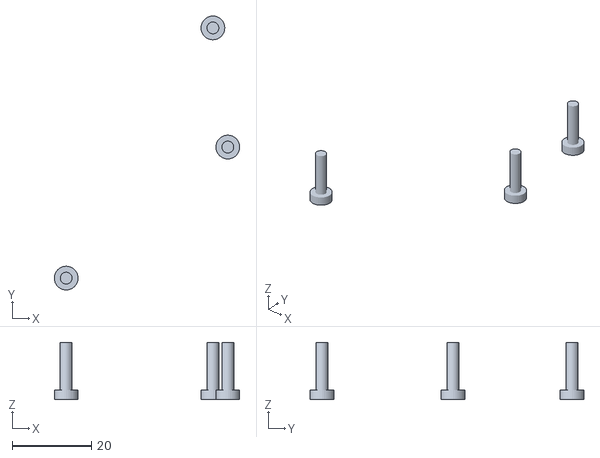
[picture p74: CAD file, 2026-11-11]
hardware/v6.3/assembly/bought_pt_k30x12_cap.stl
46.7 x 69.0 x 14.4
