ricricucit/kibble-dispenser/hardware/v6.3/plates/plates/PETG-1_pod_shell__electronics_box.3mf

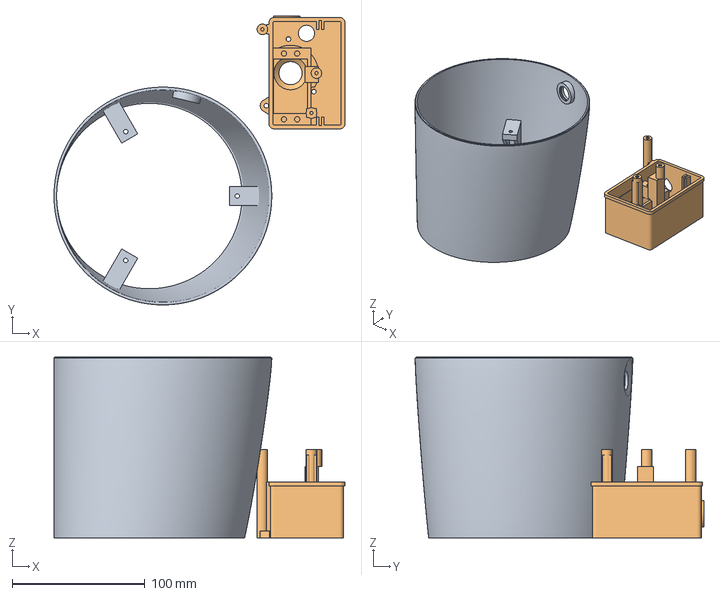
[picture p75: CAD file, 2026-11-11]
hardware/v6.3/plates/plates/PETG-1_pod_shell__electronics_box.3mf
219.1 x 217.5 x 136.0 mm
guscio_v611
scatola_v63
