ricricucit/kibble-dispenser/hardware/v6.3/plates/stl/linguetta_sicura_v63_print.stl

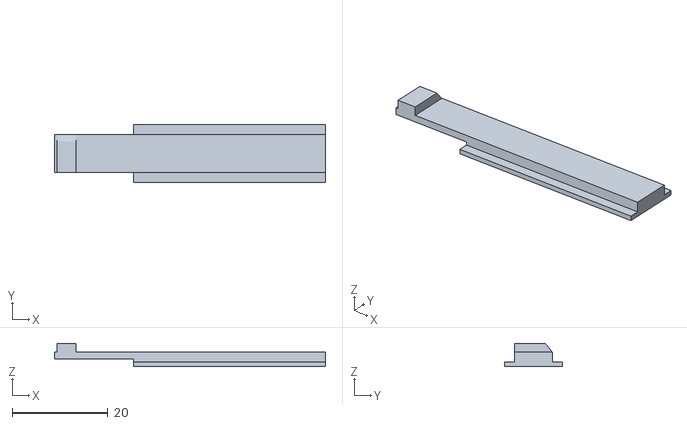
[picture p76: CAD file, 2026-11-11]
hardware/v6.3/plates/stl/linguetta_sicura_v63_print.stl
56.5 x 12.0 x 4.80
