ricricucit/kibble-dispenser/site/v6.2/assembly/models/viti_unione_flangia_1.stl

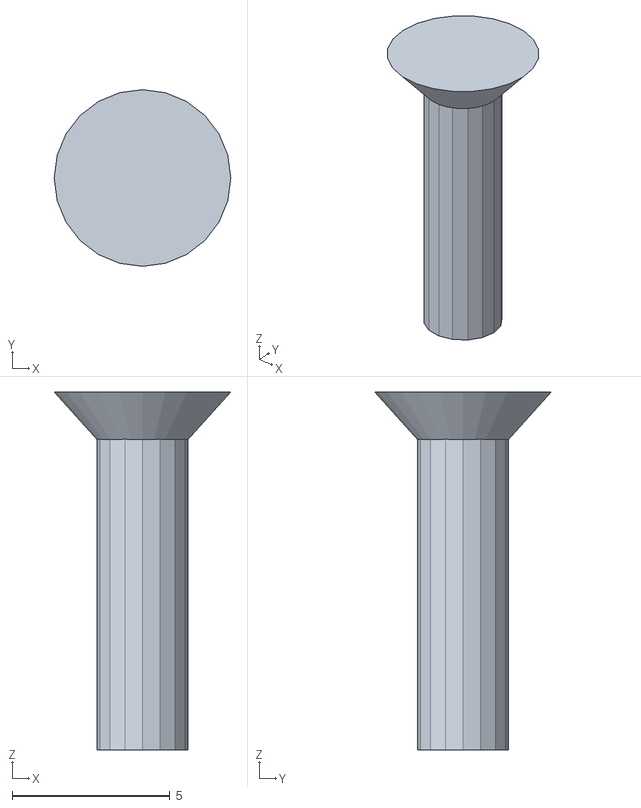
[picture p77: CAD file, 2026-11-10]
site/v6.2/assembly/models/viti_unione_flangia_1.stl
5.60 x 5.60 x 11.4
