ricricucit/kibble-dispenser/hardware/v6.3/assembly/fondello_v63_pannello.stl

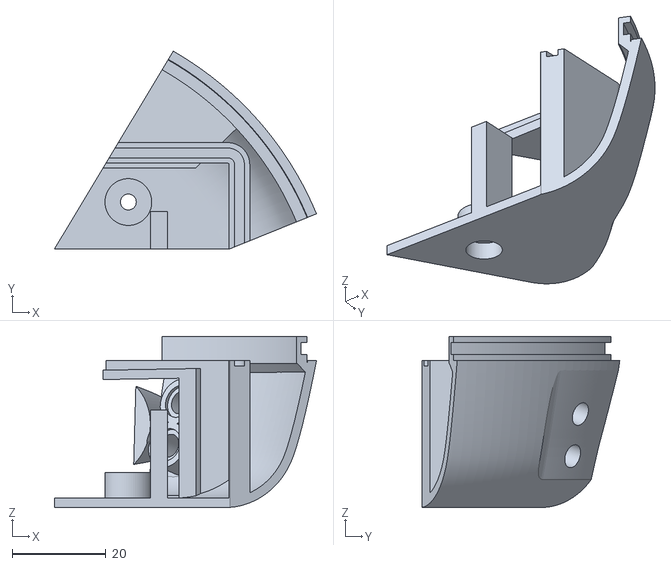
[picture p78: CAD file, 2026-11-11]
hardware/v6.3/assembly/fondello_v63_pannello.stl
56.0 x 42.2 x 36.6
