ricricucit/kibble-dispenser/hardware/v6.3/plates/plates/PETG-5_chute__collar__gate_blade__gate__window_plates.3mf

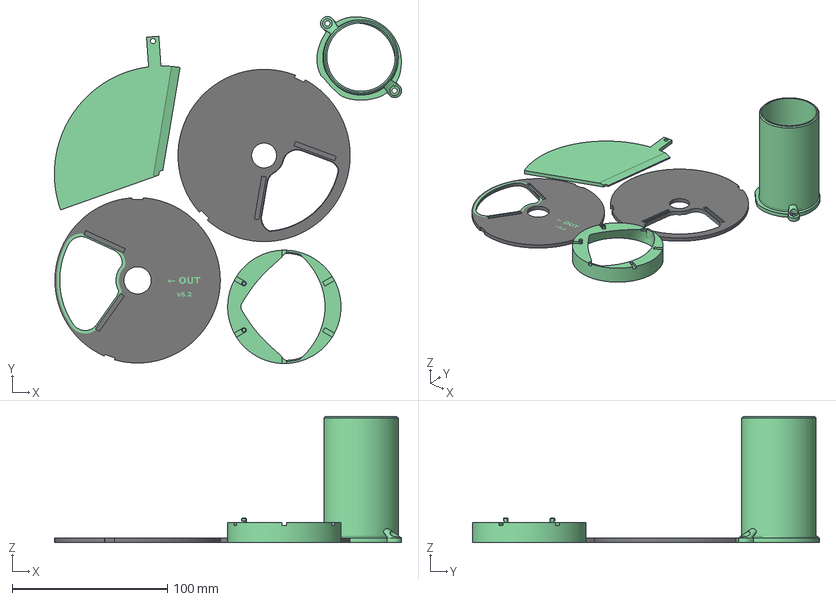
[picture p79: CAD file, 2026-11-11]
hardware/v6.3/plates/plates/PETG-5_chute__collar__gate_blade__gate__window_plates.3mf
223.6 x 223.5 x 81.3 mm
scivolo_v611
colletto_v6
saracinesca_v63
piastra_finestra_v62
piastra_gate_v62
