ricricucit/kibble-dispenser/hardware/v6.3/plates/stl/test_groove_skirt_print.stl

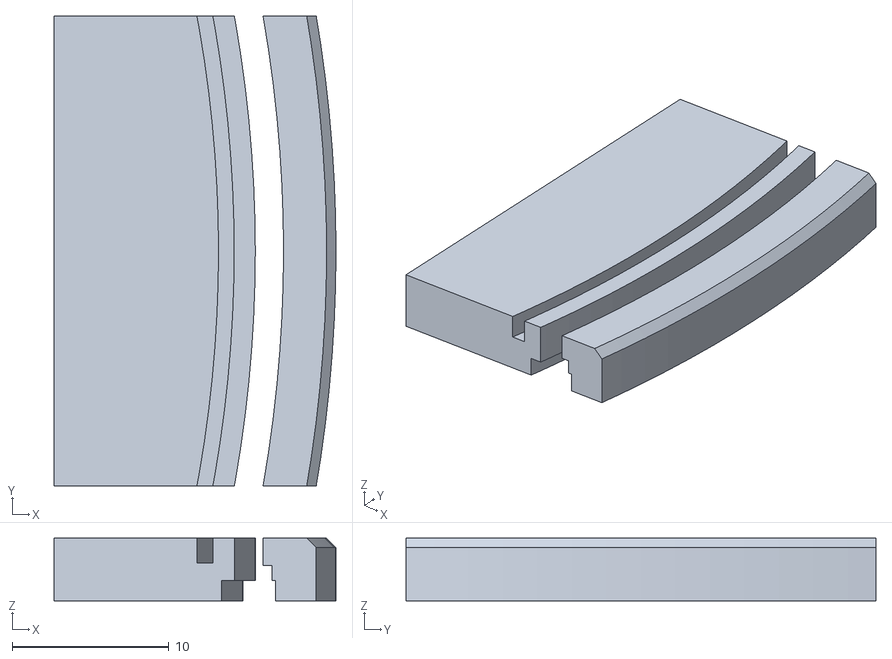
[picture p80: CAD file, 2026-11-11]
hardware/v6.3/plates/stl/test_groove_skirt_print.stl
18.0 x 30.0 x 4.00
