ricricucit/kibble-dispenser/site/v6.2/assembly/models/saracinesca_braccio.stl

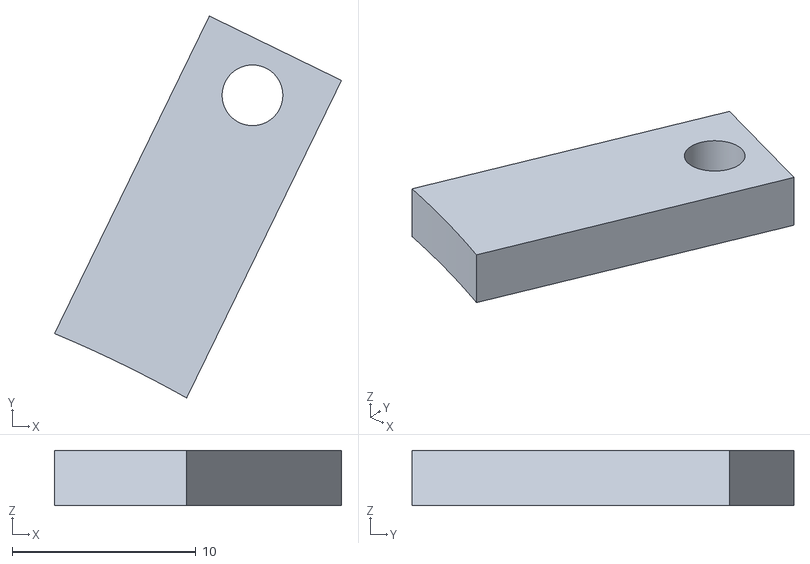
[picture p81: CAD file, 2026-11-10]
site/v6.2/assembly/models/saracinesca_braccio.stl
15.6 x 20.8 x 3.00
