ricricucit/kibble-dispenser/hardware/v6.3/plates/plates/PETG-0_spline__rim_cap_and_skirt_grooves.3mf

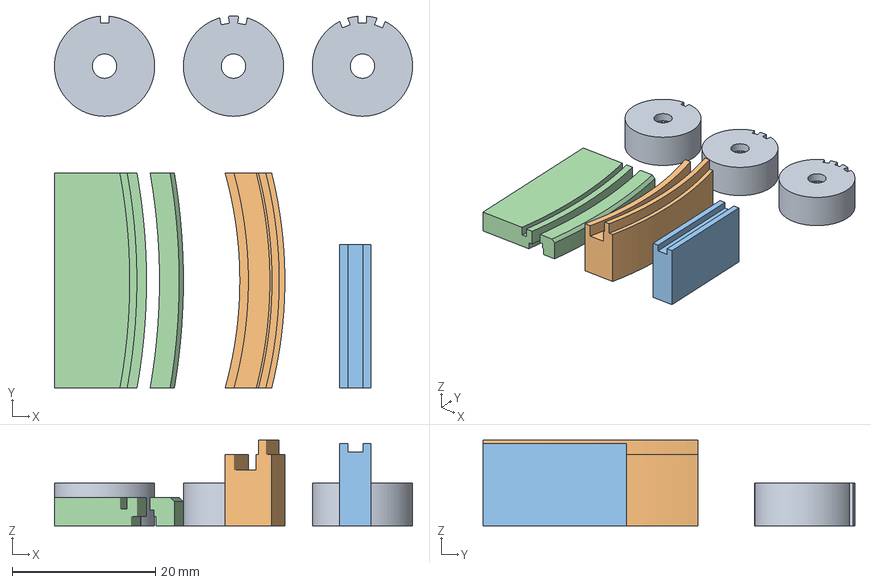
[picture p82: CAD file, 2026-11-11]
hardware/v6.3/plates/plates/PETG-0_spline__rim_cap_and_skirt_grooves.3mf
50.0 x 51.9 x 12.0 mm
test_scanalato
test_groove_rim
test_groove_cap
test_groove_skirt
