ricricucit/kibble-dispenser/site/assembly/models/cable_tie.stl

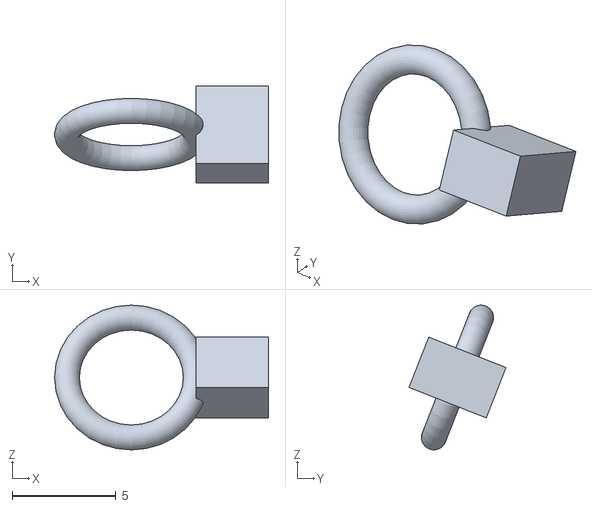
[picture p83: CAD file, 2026-11-11]
site/assembly/models/cable_tie.stl
10.3 x 4.67 x 6.97
