ricricucit/kibble-dispenser/site/v6.2/assembly/models/lips_upper_1.stl

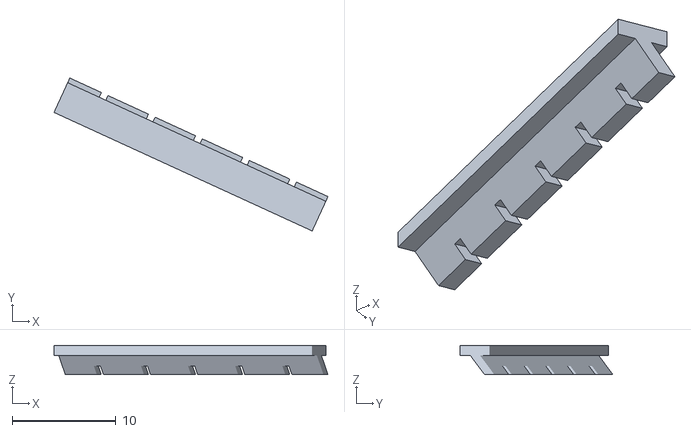
[picture p84: CAD file, 2026-11-10]
site/v6.2/assembly/models/lips_upper_1.stl
26.4 x 14.8 x 2.83
