ricricucit/kibble-dispenser/hardware/v6.3/assembly/fondello_v63_fianco.stl

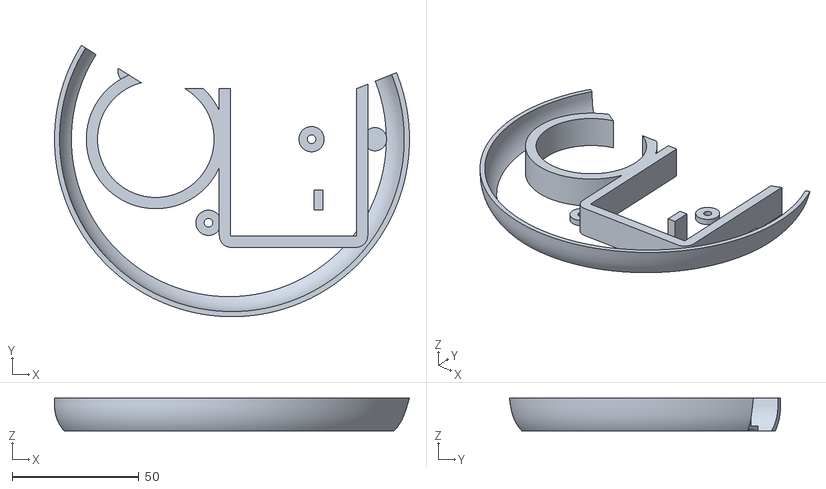
[picture p85: CAD file, 2026-11-11]
hardware/v6.3/assembly/fondello_v63_fianco.stl
140.2 x 107.2 x 13.0
