ricricucit/kibble-dispenser/hardware/v6.3/plates/stl/fondello_v63_print.stl

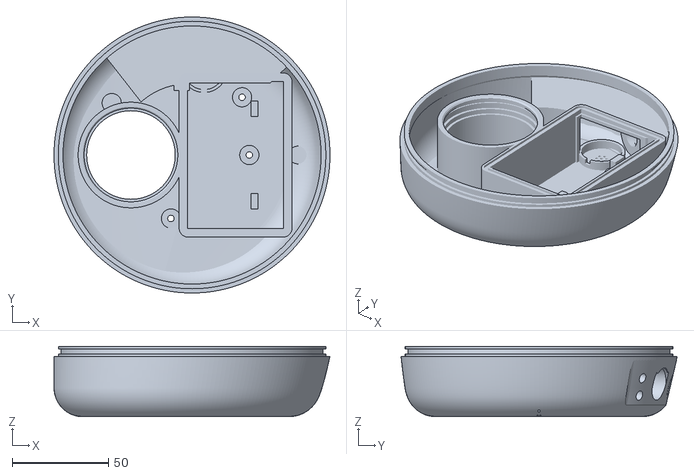
[picture p86: CAD file, 2026-11-11]
hardware/v6.3/plates/stl/fondello_v63_print.stl
143.4 x 143.4 x 36.6
