ricricucit/kibble-dispenser/hardware/v6.3/plates/stl/test_groove_cap_print.stl

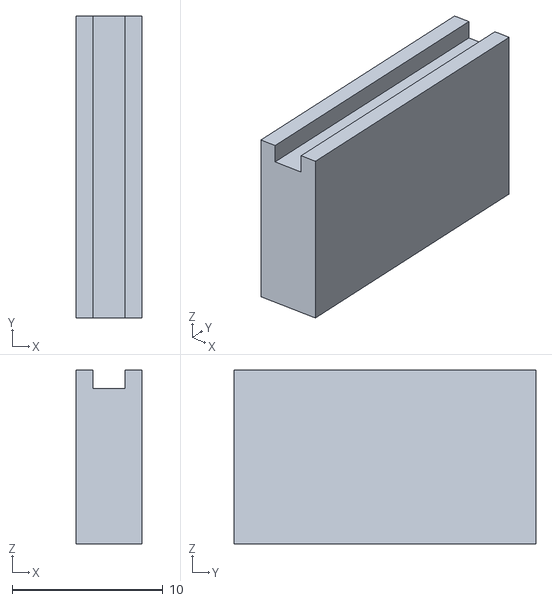
[picture p87: CAD file, 2026-11-11]
hardware/v6.3/plates/stl/test_groove_cap_print.stl
4.40 x 20.0 x 11.5
