ricricucit/kibble-dispenser/site/assembly/models/viti_m3x40_2.stl

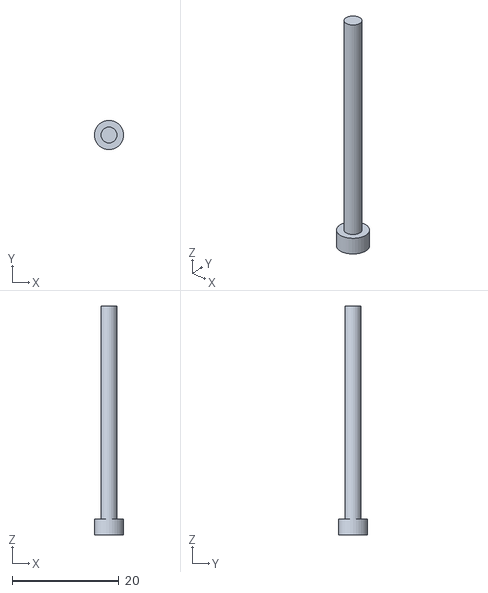
[picture p88: CAD file, 2026-11-11]
site/assembly/models/viti_m3x40_2.stl
5.50 x 5.50 x 43.0
