ricricucit/kibble-dispenser/site/v6.2/assembly/models/guarnizione_fondello_v61.stl

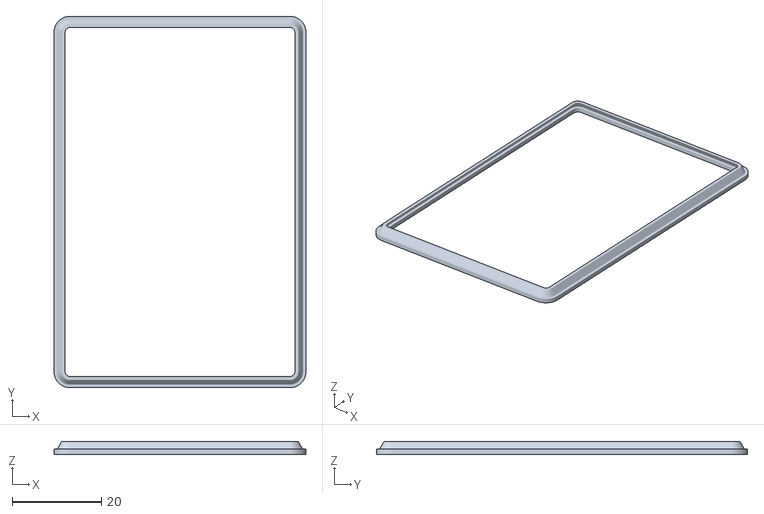
[picture p89: CAD file, 2026-11-10]
site/v6.2/assembly/models/guarnizione_fondello_v61.stl
56.4 x 83.2 x 2.85
