ricricucit/kibble-dispenser/hardware/v6.3/assembly/bought_cable_12v_supply.stl

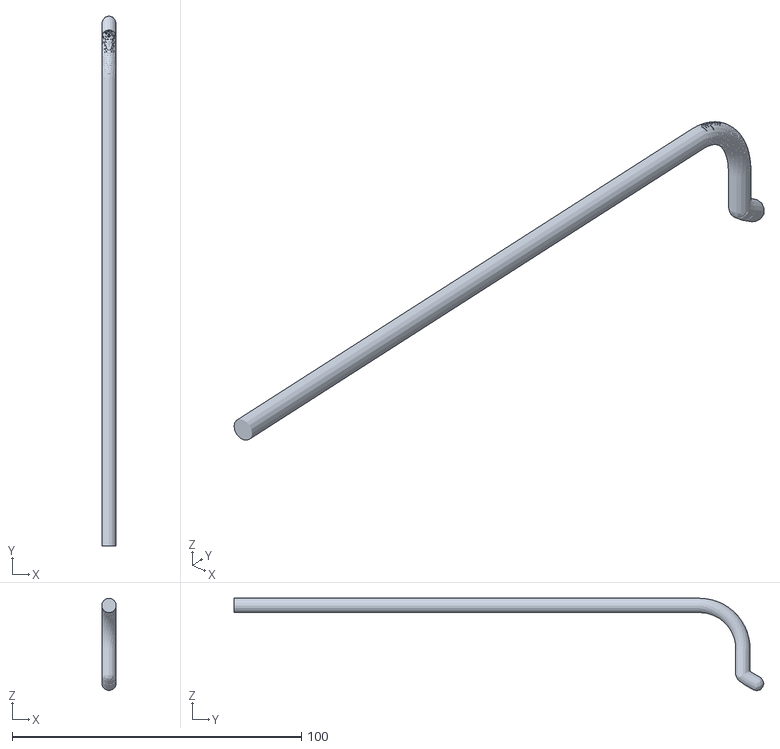
[picture p90: CAD file, 2026-11-11]
hardware/v6.3/assembly/bought_cable_12v_supply.stl
5.00 x 183.3 x 32.0
