ricricucit/kibble-dispenser/hardware/v6.3/plates/stl/labbro_pettine_v62_print.stl

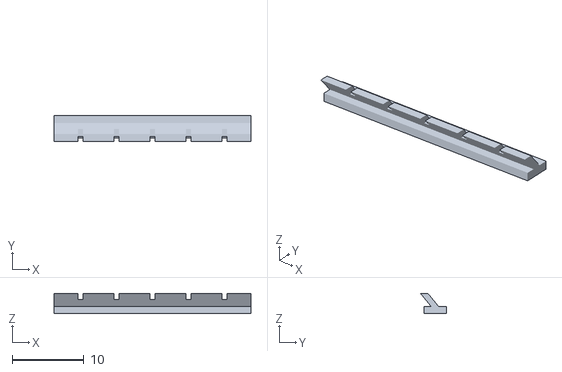
[picture p91: CAD file, 2026-11-10]
hardware/v6.3/plates/stl/labbro_pettine_v62_print.stl
27.4 x 3.65 x 2.83
