ricricucit/kibble-dispenser/site/assembly/models/spina_4x6.stl

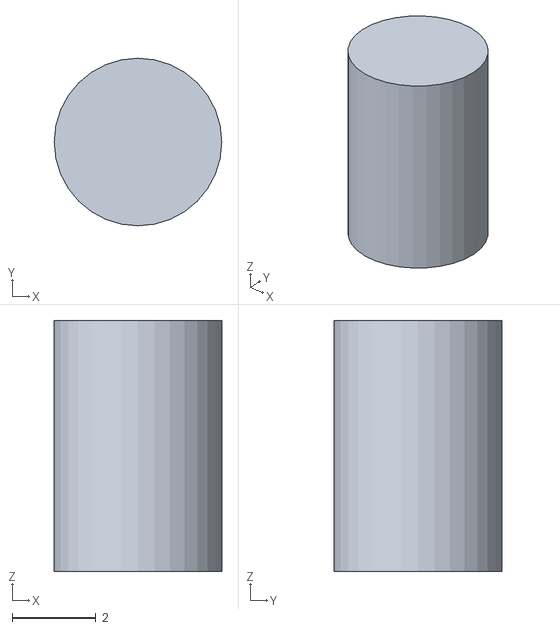
[picture p92: CAD file, 2026-11-11]
site/assembly/models/spina_4x6.stl
4.00 x 4.00 x 5.99
