ricricucit/kibble-dispenser/site/v6.2/assembly/models/disco_v61_arancio.stl

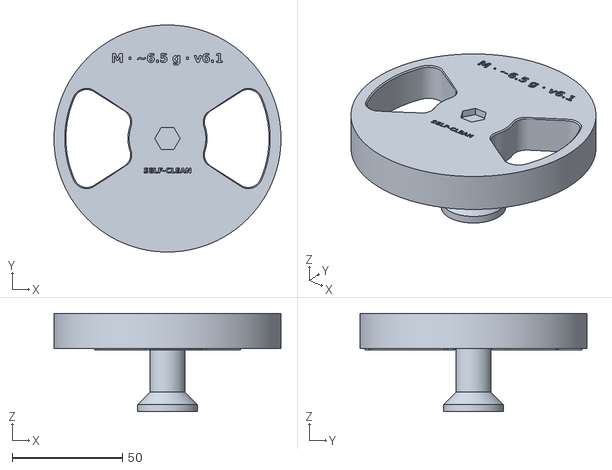
[picture p93: CAD file, 2026-11-10]
site/v6.2/assembly/models/disco_v61_arancio.stl
103.0 x 103.0 x 44.5
