ricricucit/kibble-dispenser/hardware/v6.3/plates/stl/pulsante_v611_print.stl

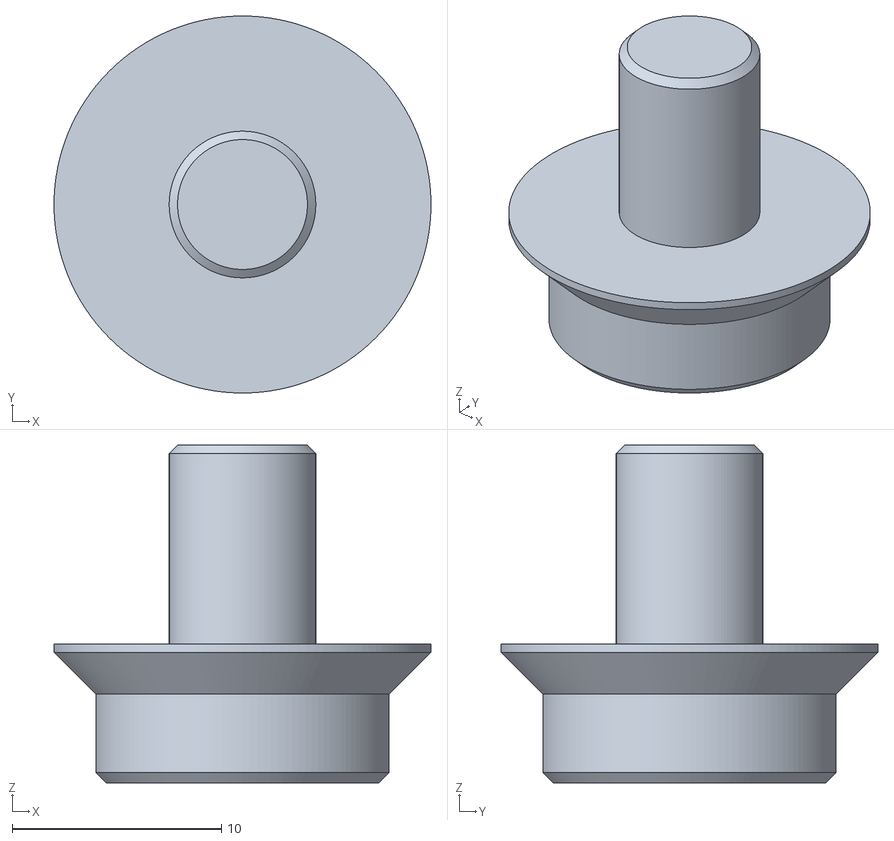
[picture p94: CAD file, 2026-11-10]
hardware/v6.3/plates/stl/pulsante_v611_print.stl
18.0 x 18.0 x 16.1
