ricricucit/kibble-dispenser/site/v6.2/assembly/models/chiavette_0.stl

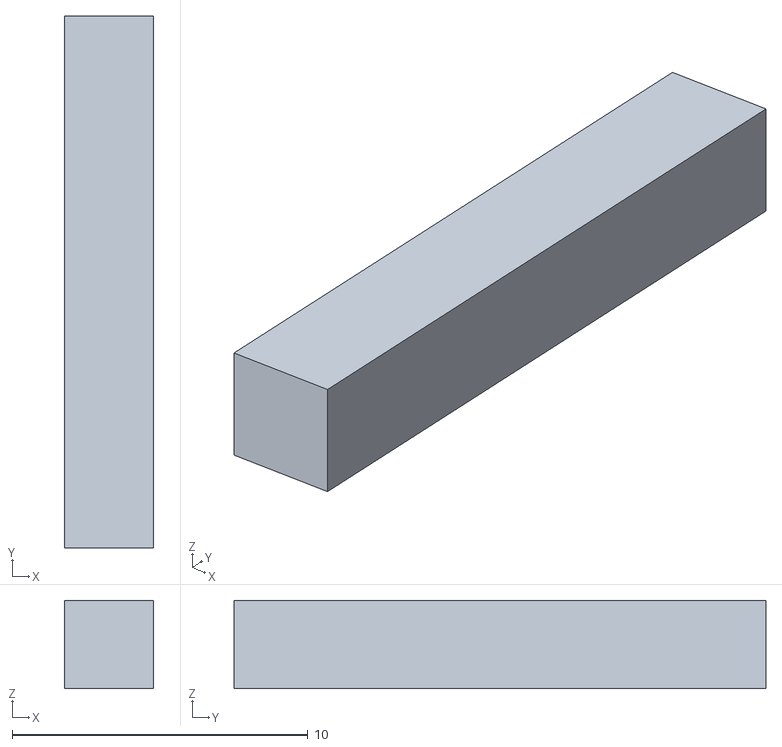
[picture p95: CAD file, 2026-11-10]
site/v6.2/assembly/models/chiavette_0.stl
3.00 x 18.0 x 2.98
