ricricucit/kibble-dispenser/hardware/v6.3/plates/stl/disco_v61_print_black.stl

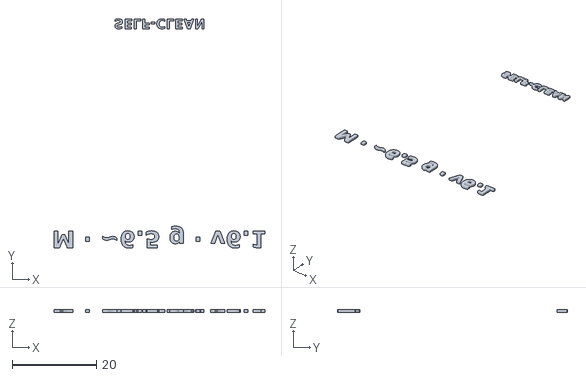
[picture p96: CAD file, 2026-11-10]
hardware/v6.3/plates/stl/disco_v61_print_black.stl
50.0 x 54.3 x 0.6
