ricricucit/kibble-dispenser/hardware/v6.3/assembly/bought_inserts_bowl.stl

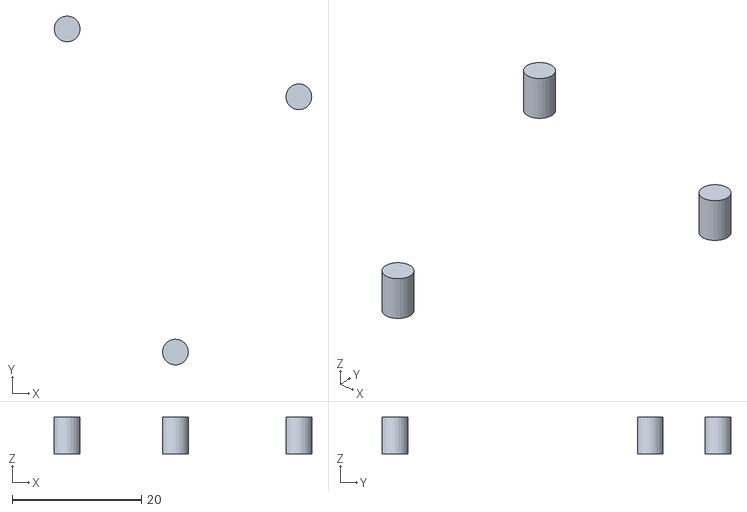
[picture p97: CAD file, 2026-11-11]
hardware/v6.3/assembly/bought_inserts_bowl.stl
39.9 x 54.0 x 5.70
