ricricucit/kibble-dispenser/hardware/v6.3/plates/stl/scivolo_v611_print.stl

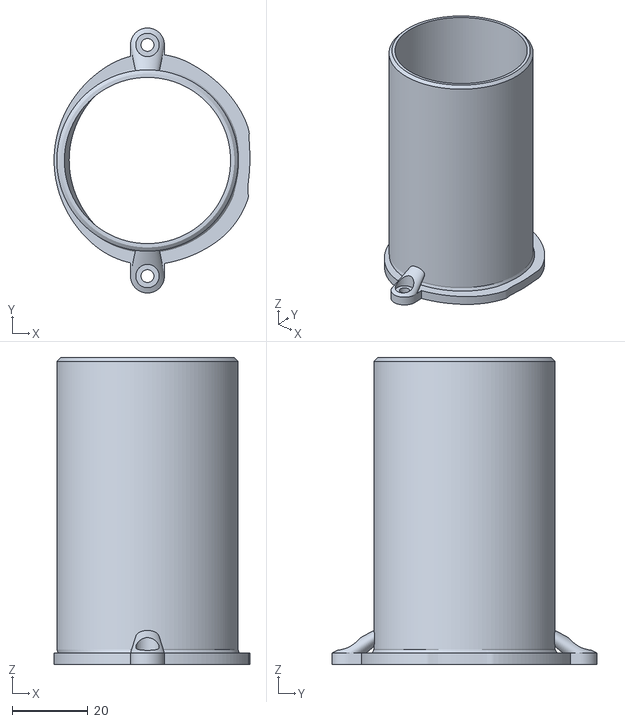
[picture p98: CAD file, 2026-11-10]
hardware/v6.3/plates/stl/scivolo_v611_print.stl
51.9 x 70.2 x 81.3
