ricricucit/kibble-dispenser/site/assembly/models/viti_scivolo_0.stl

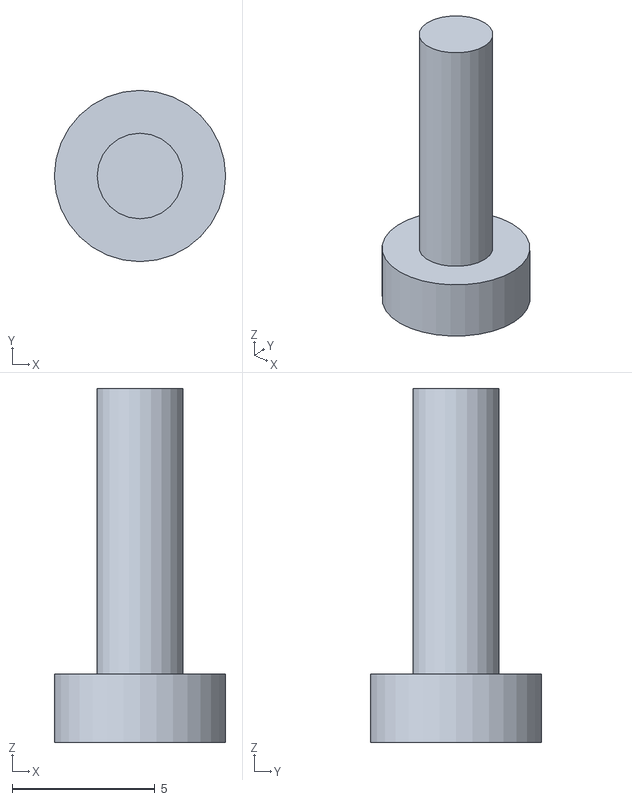
[picture p99: CAD file, 2026-11-11]
site/assembly/models/viti_scivolo_0.stl
6.00 x 6.00 x 12.4
