ricricucit/kibble-dispenser/hardware/v6.3/assembly/bought_harness_jst.stl

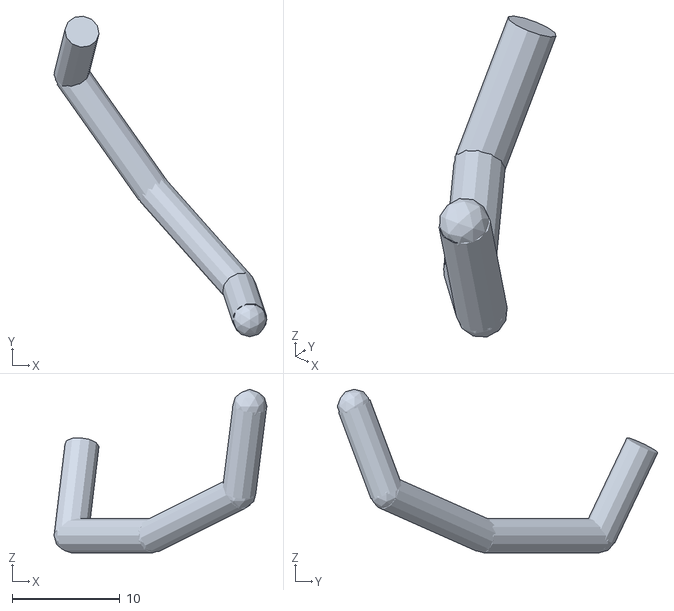
[picture p100: CAD file, 2026-11-11]
hardware/v6.3/assembly/bought_harness_jst.stl
19.8 x 29.8 x 15.2
