ricricucit/kibble-dispenser/hardware/v6.3/plates/stl/test_cap_lip_print.stl

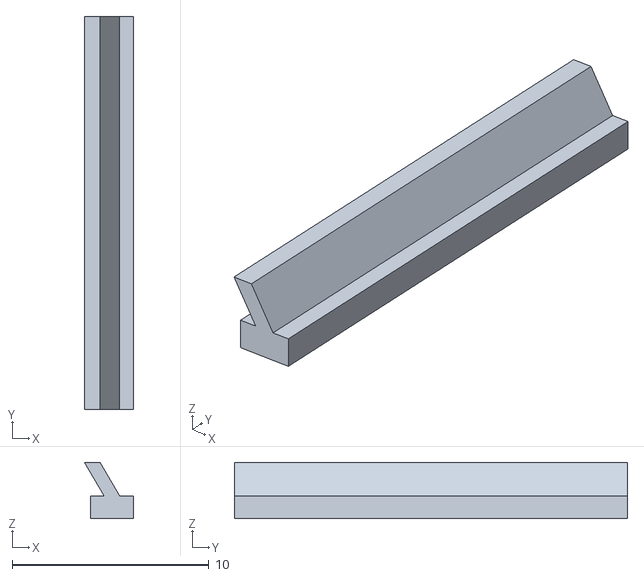
[picture p101: CAD file, 2026-11-10]
hardware/v6.3/plates/stl/test_cap_lip_print.stl
2.50 x 20.0 x 2.85
