ricricucit/kibble-dispenser/site/v6.2/assembly/models/canalina_base_1.stl

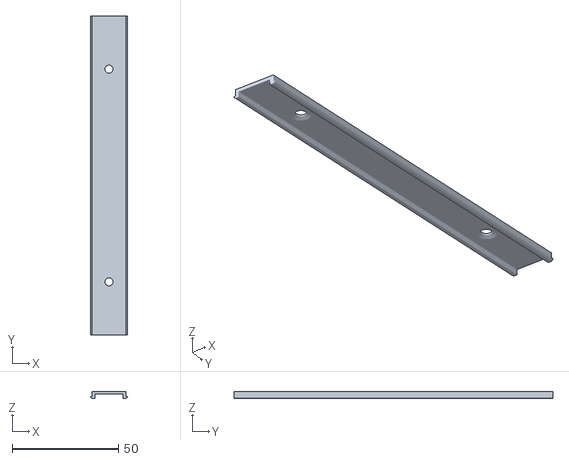
[picture p102: CAD file, 2026-11-10]
site/v6.2/assembly/models/canalina_base_1.stl
17.2 x 150.0 x 3.20
