ricricucit/kibble-dispenser/site/assembly/models/lightpipes_5mm.stl

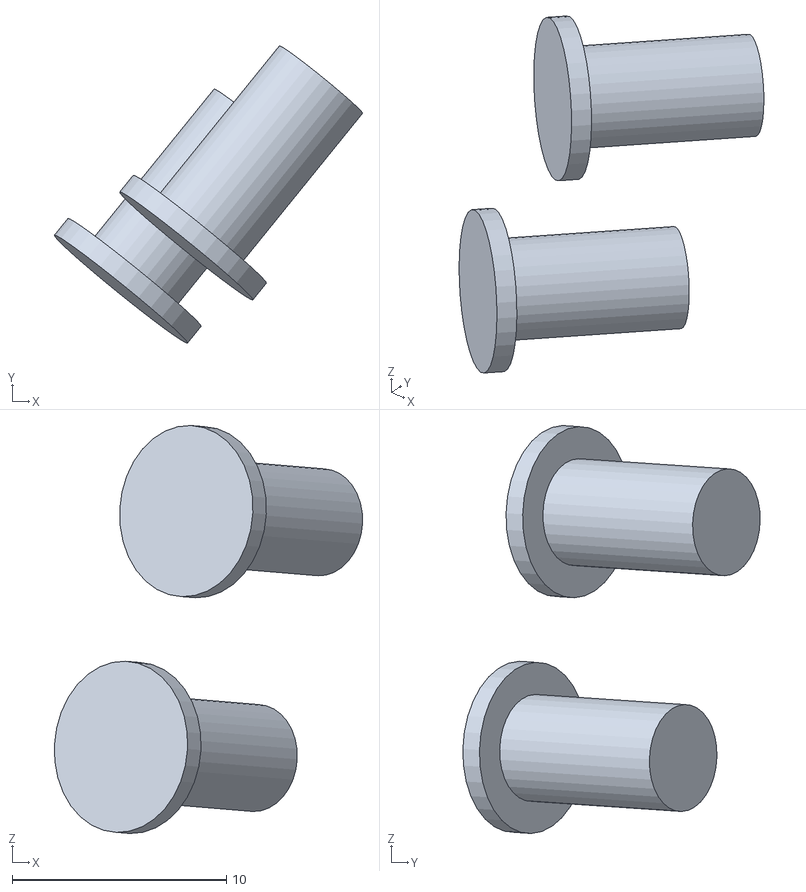
[picture p103: CAD file, 2026-11-11]
site/assembly/models/lightpipes_5mm.stl
14.4 x 13.9 x 19.0
