ricricucit/kibble-dispenser/hardware/v6.3/assembly/fondello_v63_pannello_5.stl

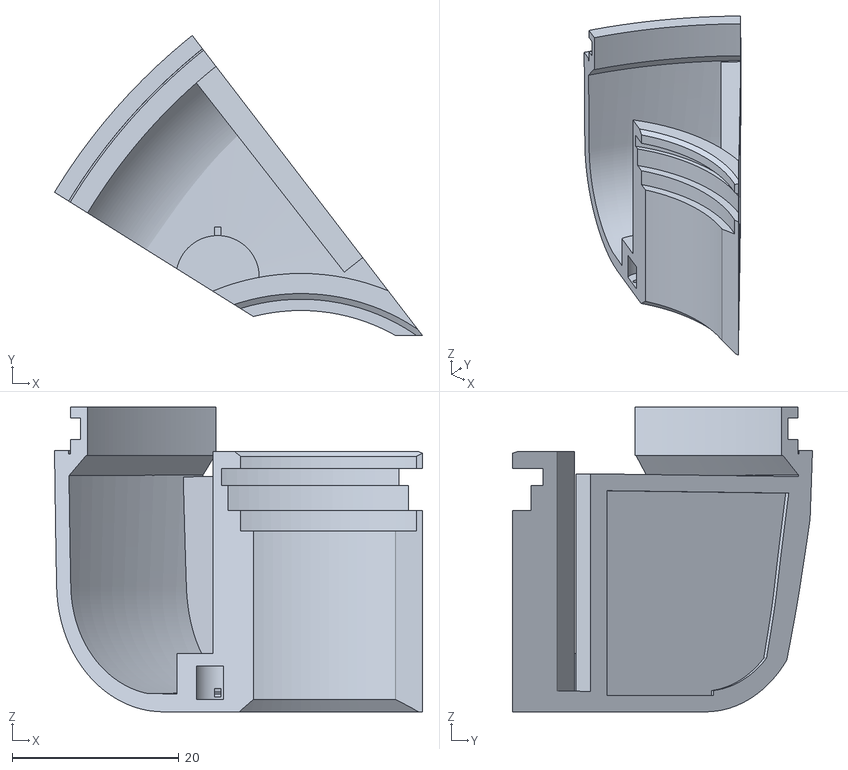
[picture p104: CAD file, 2026-11-11]
hardware/v6.3/assembly/fondello_v63_pannello_5.stl
44.2 x 36.0 x 36.6
