ricricucit/kibble-dispenser/site/assembly/models/switch_12mm_ip67.stl

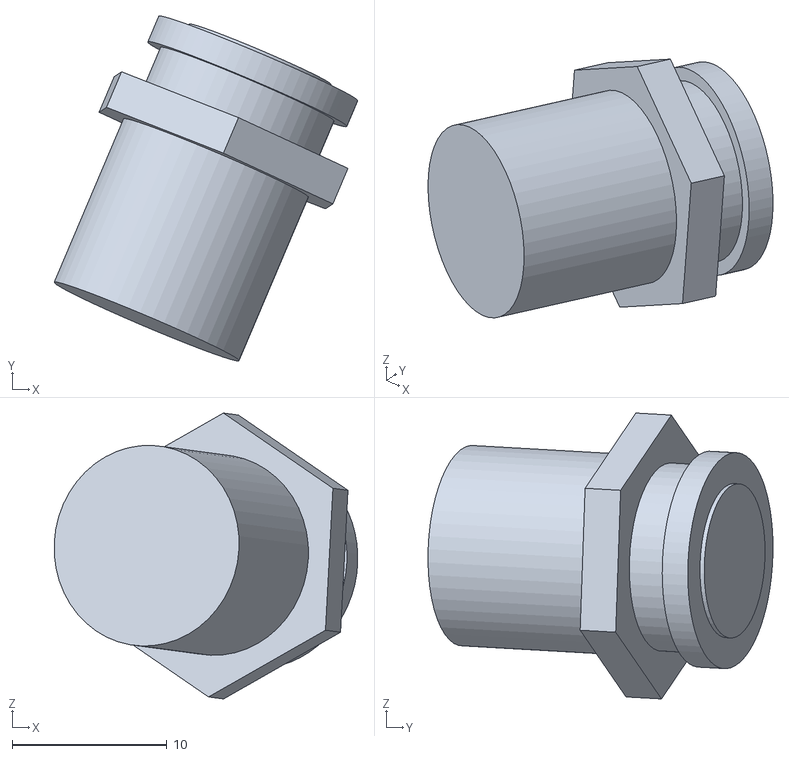
[picture p105: CAD file, 2026-11-11]
site/assembly/models/switch_12mm_ip67.stl
19.6 x 22.3 x 18.5
