ricricucit/kibble-dispenser/site/v6.2/assembly/models/reg_12v.stl

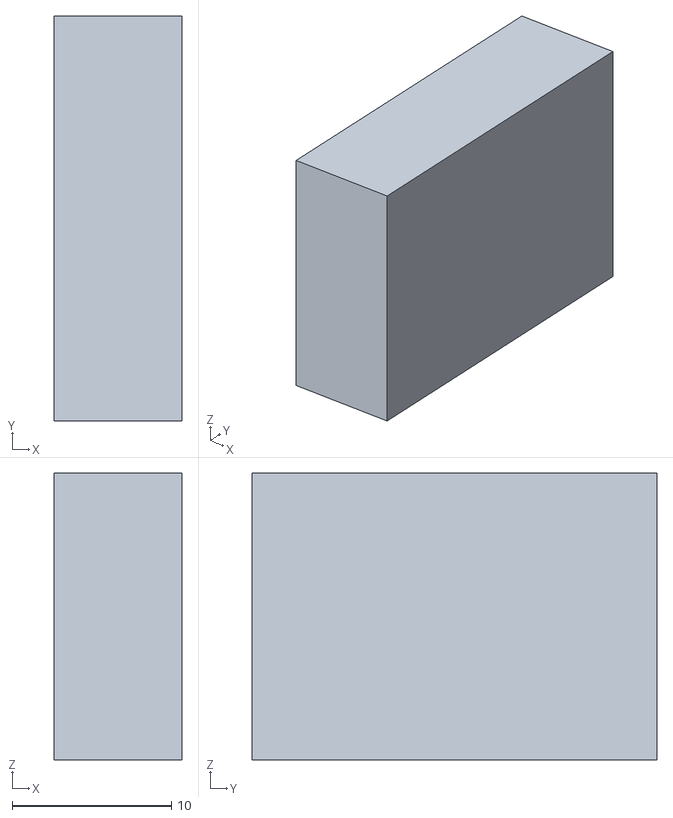
[picture p106: CAD file, 2026-11-10]
site/v6.2/assembly/models/reg_12v.stl
8.00 x 25.4 x 18.0
