ricricucit/kibble-dispenser/hardware/v6.3/assembly/bought_lightpipes_5mm.stl

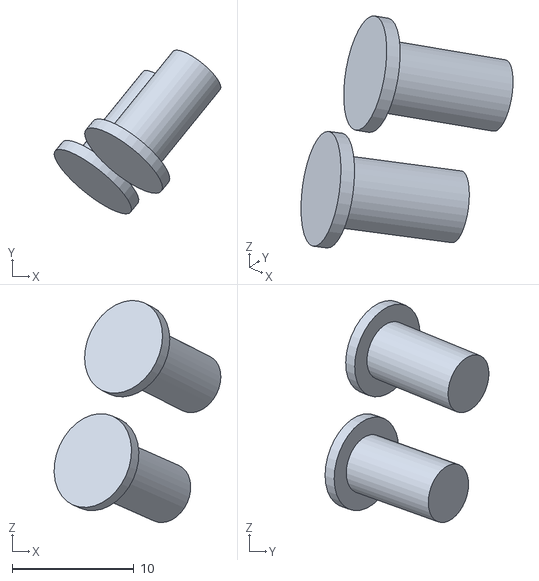
[picture p107: CAD file, 2026-11-11]
hardware/v6.3/assembly/bought_lightpipes_5mm.stl
13.7 x 13.5 x 18.2
