ricricucit/kibble-dispenser/hardware/v6.3/plates/stl/guarnizione_baionetta_v61_print.stl

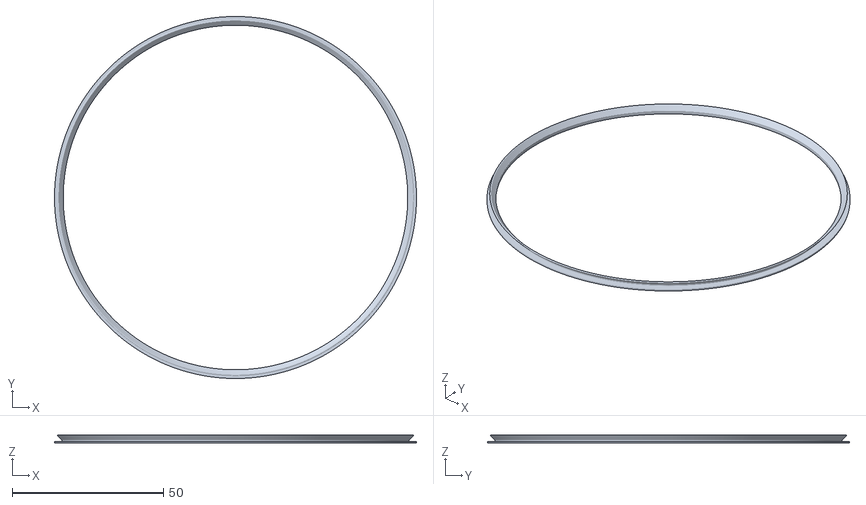
[picture p108: CAD file, 2026-11-10]
hardware/v6.3/plates/stl/guarnizione_baionetta_v61_print.stl
119.7 x 119.7 x 2.73
