ricricucit/kibble-dispenser/site/v6.2/assembly/models/oring_nottolini_0.stl

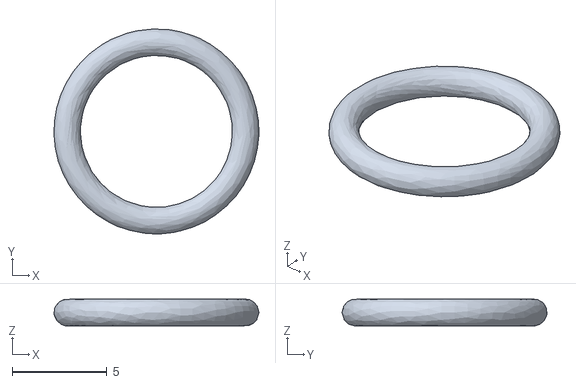
[picture p109: CAD file, 2026-11-10]
site/v6.2/assembly/models/oring_nottolini_0.stl
10.8 x 10.8 x 1.40
