ricricucit/kibble-dispenser/hardware/v6.3/assembly/fondello_v63_pannello_2.stl

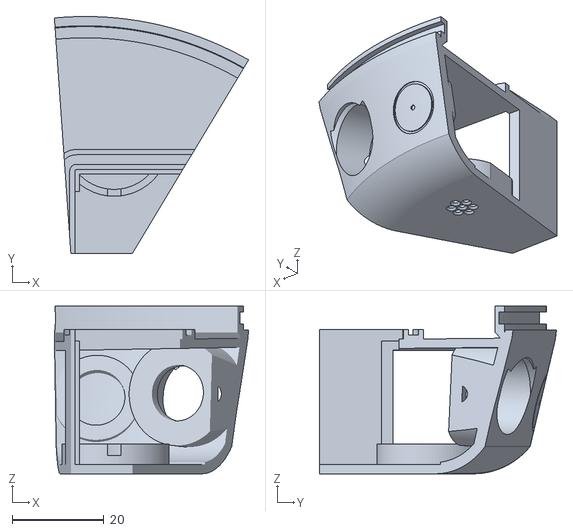
[picture p110: CAD file, 2026-11-11]
hardware/v6.3/assembly/fondello_v63_pannello_2.stl
42.4 x 51.7 x 36.6
