ricricucit/kibble-dispenser/hardware/v6.3/plates/stl/test_rim_lip_print.stl

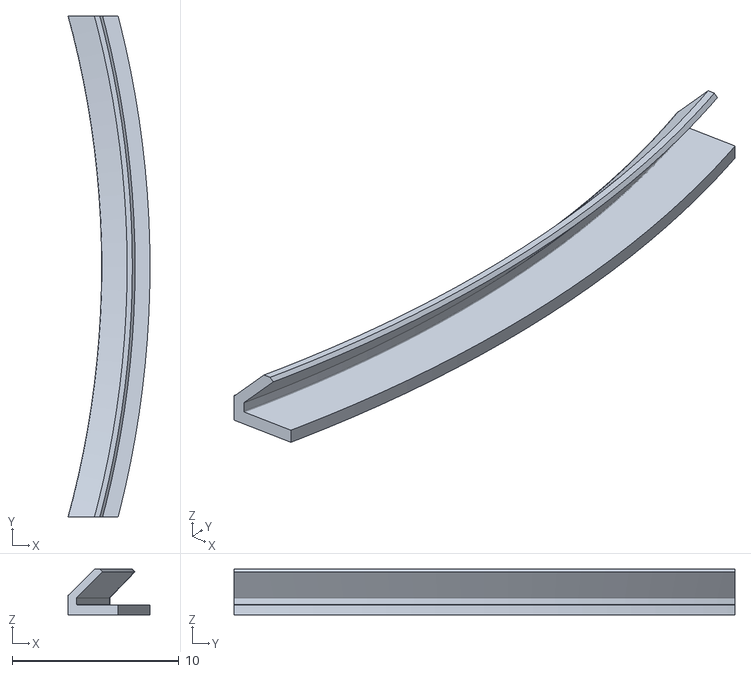
[picture p111: CAD file, 2026-11-10]
hardware/v6.3/plates/stl/test_rim_lip_print.stl
4.91 x 30.0 x 2.73
