ricricucit/kibble-dispenser/hardware/v6.3/assembly/bought_membrane_acoustic_ip67.stl

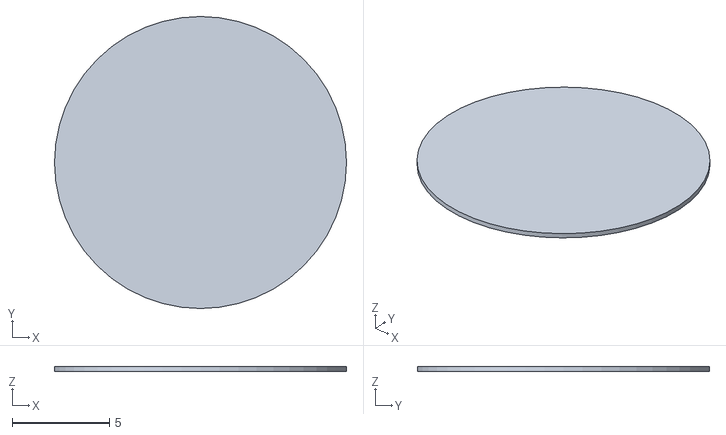
[picture p112: CAD file, 2026-11-11]
hardware/v6.3/assembly/bought_membrane_acoustic_ip67.stl
15.0 x 15.0 x 0.25
