ricricucit/kibble-dispenser/hardware/v6.3/plates/stl/guscio_v611_print.stl

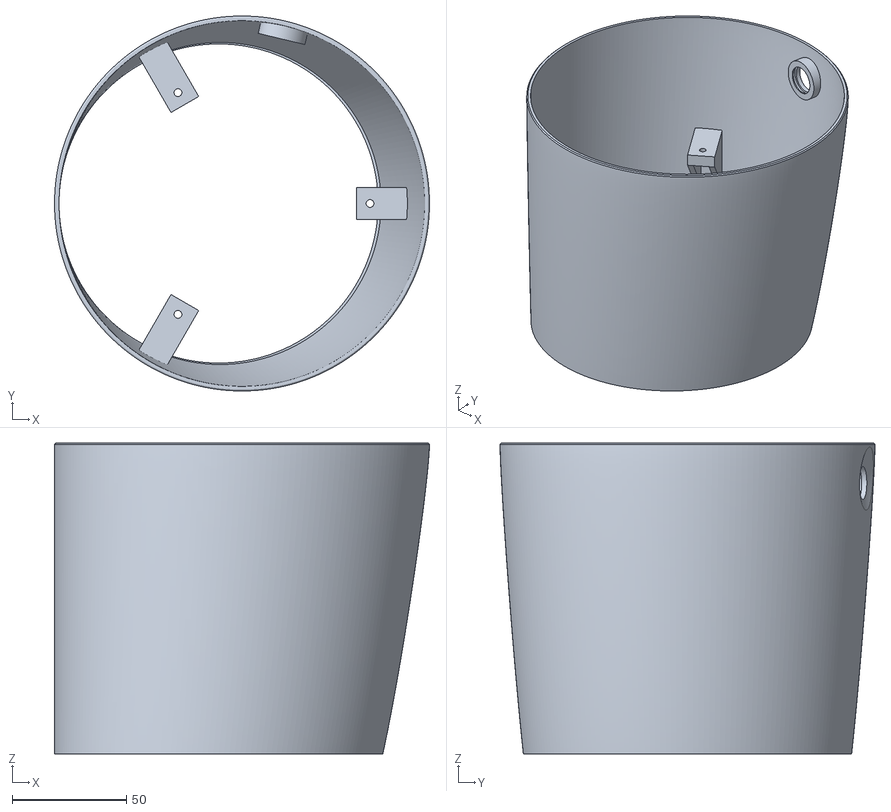
[picture p113: CAD file, 2026-11-10]
hardware/v6.3/plates/stl/guscio_v611_print.stl
164.0 x 164.0 x 136.0
