ricricucit/kibble-dispenser/hardware/v6.3/assembly/bought_pt_k30x10_chute.stl

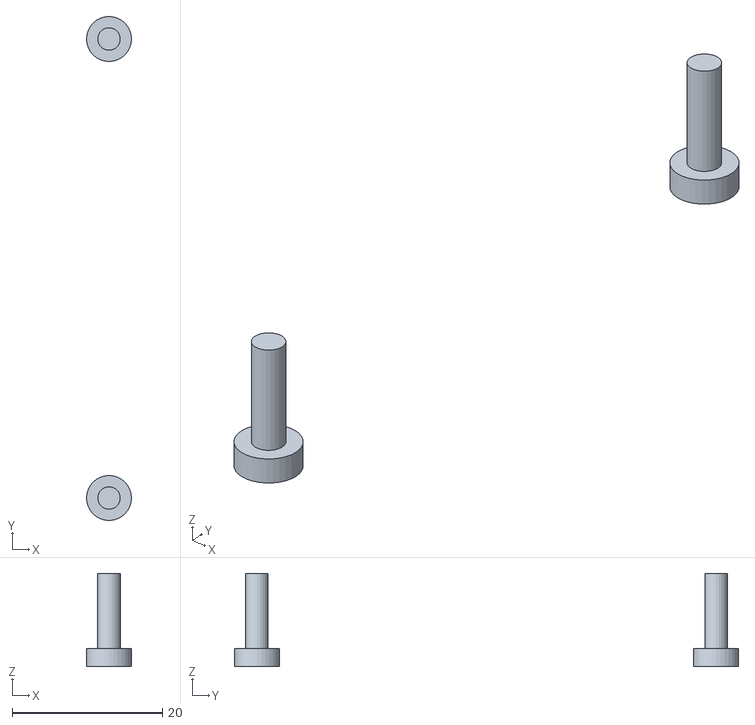
[picture p114: CAD file, 2026-11-11]
hardware/v6.3/assembly/bought_pt_k30x10_chute.stl
6.00 x 67.2 x 12.4
