ricricucit/kibble-dispenser/site/v6.2/assembly/models/oring_giunto.stl

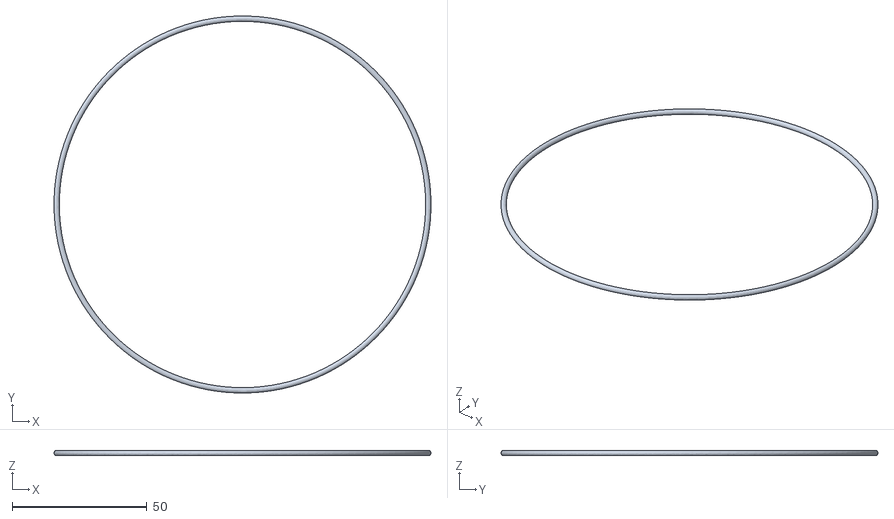
[picture p115: CAD file, 2026-11-10]
site/v6.2/assembly/models/oring_giunto.stl
139.8 x 139.8 x 2.00
