ricricucit/kibble-dispenser/hardware/v6.3/assembly/bought_oring_3x1.stl

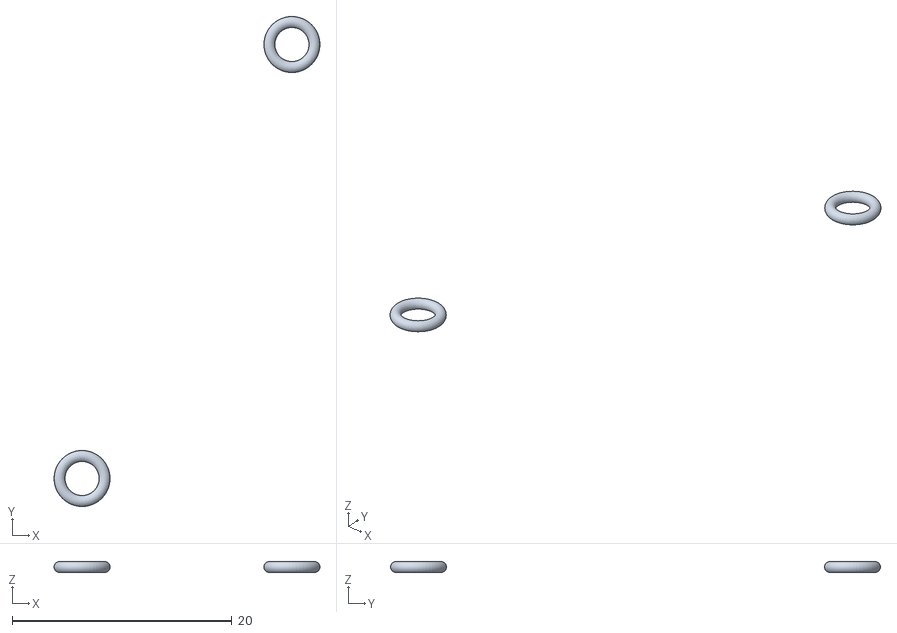
[picture p116: CAD file, 2026-11-11]
hardware/v6.3/assembly/bought_oring_3x1.stl
24.2 x 44.6 x 1.00
