ricricucit/kibble-dispenser/hardware/v6.3/plates/stl/labbro_scivolo_v611_print.stl

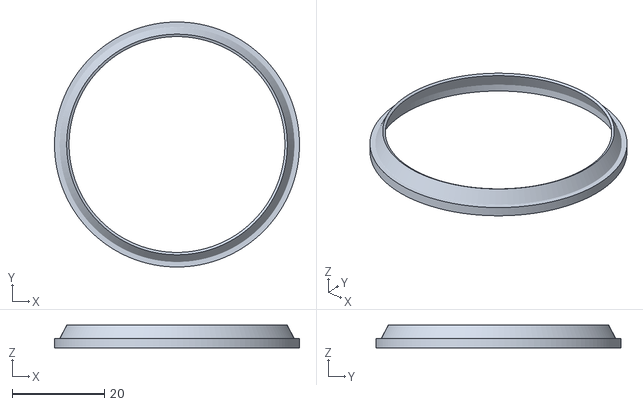
[picture p117: CAD file, 2026-11-10]
hardware/v6.3/plates/stl/labbro_scivolo_v611_print.stl
53.0 x 53.0 x 4.87
