ricricucit/kibble-dispenser/site/v6.2/assembly/models/albero_v6.stl

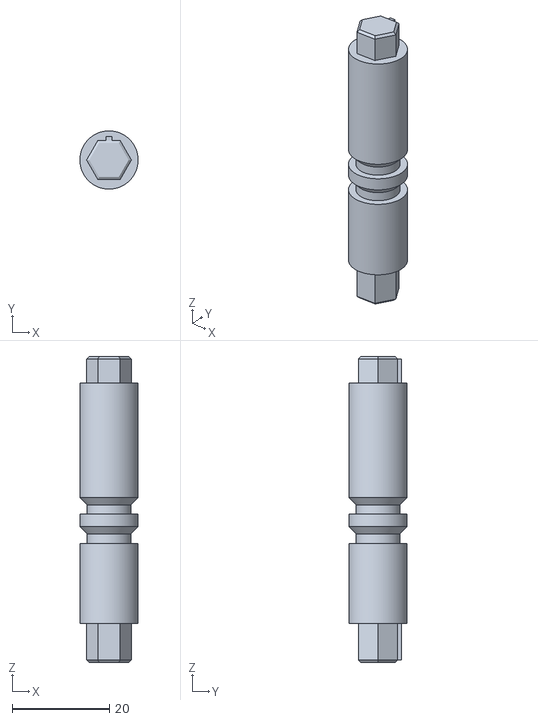
[picture p118: CAD file, 2026-11-10]
site/v6.2/assembly/models/albero_v6.stl
12.0 x 12.0 x 63.0
