ricricucit/kibble-dispenser/hardware/v6.3/assembly/bought_oring_5x1_lightpipe.stl

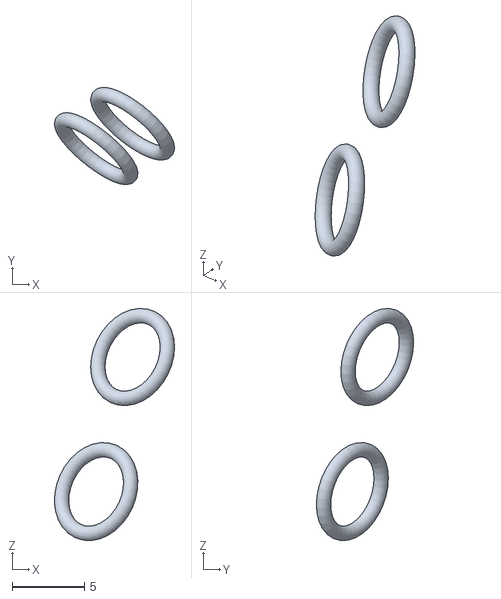
[picture p119: CAD file, 2026-11-11]
hardware/v6.3/assembly/bought_oring_5x1_lightpipe.stl
8.30 x 6.72 x 16.0
