ricricucit/kibble-dispenser/hardware/v6.3/plates/stl/labbro_ombra_v611_print.stl

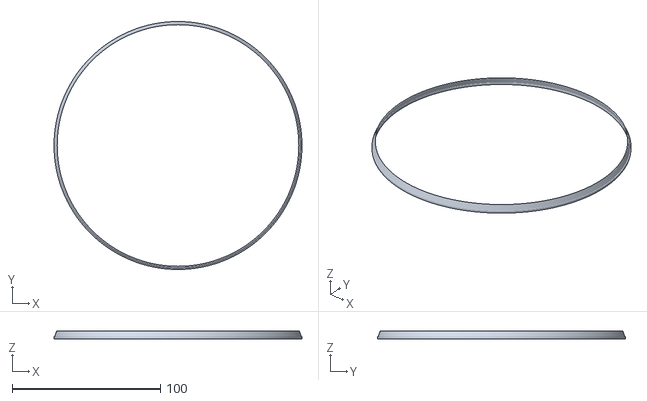
[picture p120: CAD file, 2026-11-10]
hardware/v6.3/plates/stl/labbro_ombra_v611_print.stl
167.1 x 167.1 x 5.33
