ricricucit/kibble-dispenser/site/v6.2/assembly/models/reg_5v.stl

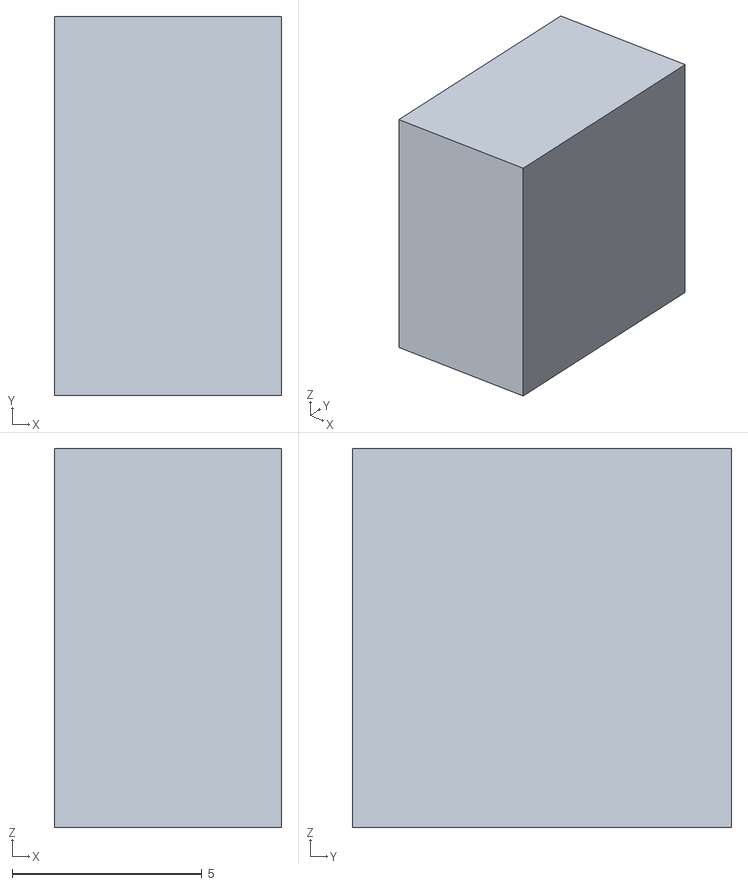
[picture p121: CAD file, 2026-11-10]
site/v6.2/assembly/models/reg_5v.stl
6.00 x 10.0 x 10.0
