ricricucit/kibble-dispenser/hardware/v6.3/assembly/bought_oring_3x1_cap.stl

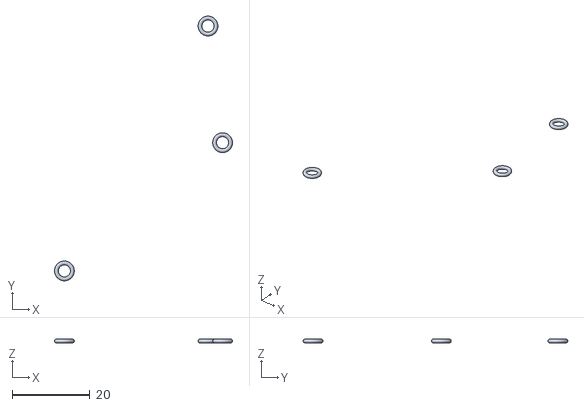
[picture p122: CAD file, 2026-11-11]
hardware/v6.3/assembly/bought_oring_3x1_cap.stl
45.8 x 68.1 x 1.00
