ricricucit/kibble-dispenser/hardware/v6.3/plates/stl/piastra_finestra_v62_print.stl

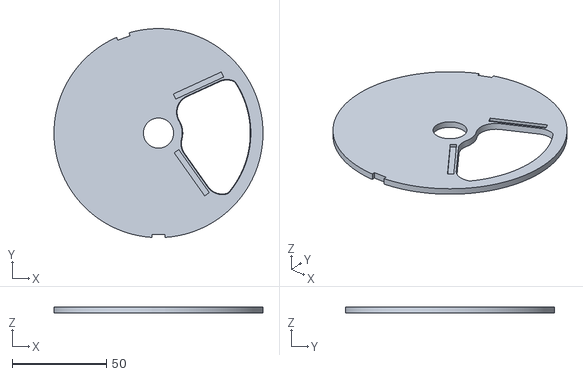
[picture p123: CAD file, 2026-11-10]
hardware/v6.3/plates/stl/piastra_finestra_v62_print.stl
110.9 x 110.8 x 3.00
