ricricucit/kibble-dispenser/site/v6.2/assembly/models/oring_faccia.stl

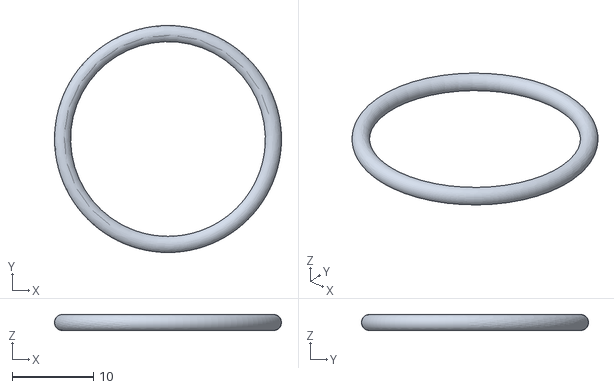
[picture p124: CAD file, 2026-11-10]
site/v6.2/assembly/models/oring_faccia.stl
28.0 x 28.0 x 2.00
