ricricucit/kibble-dispenser/hardware/v6.3/assembly/bought_pt_k30x12_shell_tabs.stl

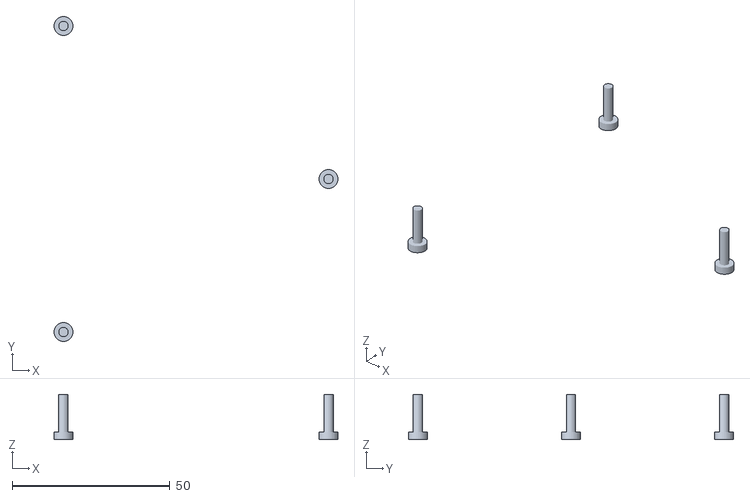
[picture p125: CAD file, 2026-11-11]
hardware/v6.3/assembly/bought_pt_k30x12_shell_tabs.stl
90.0 x 103.0 x 14.4
