ricricucit/kibble-dispenser/site/v6.2/assembly/models/canalina_base_2.stl

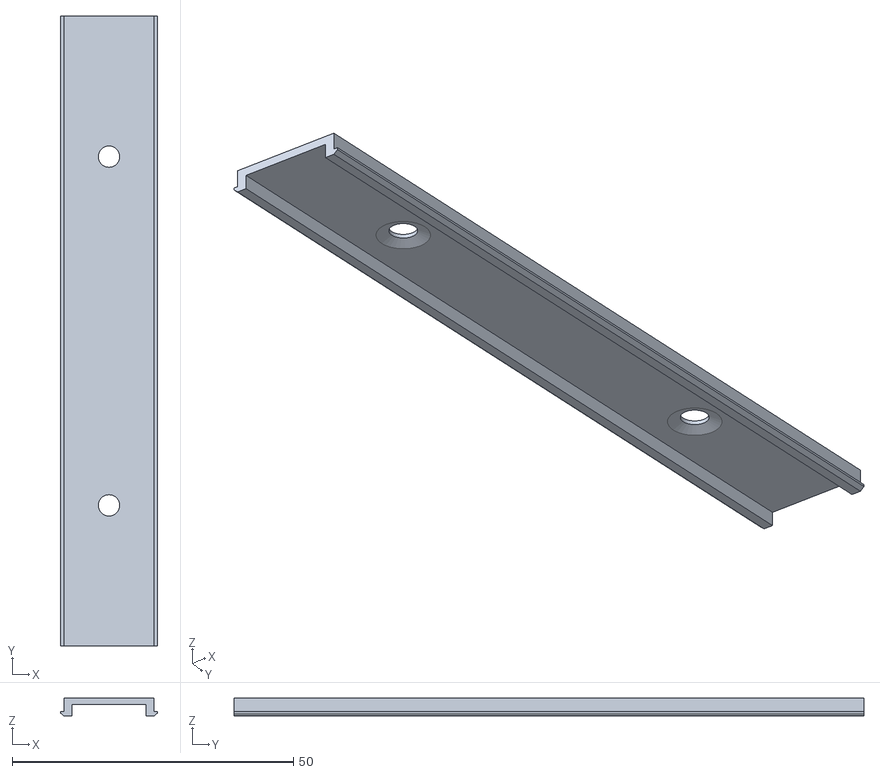
[picture p126: CAD file, 2026-11-10]
site/v6.2/assembly/models/canalina_base_2.stl
17.2 x 112.0 x 3.20
