ricricucit/kibble-dispenser/hardware/v6.3/assembly/bought_speaker_20mm.stl

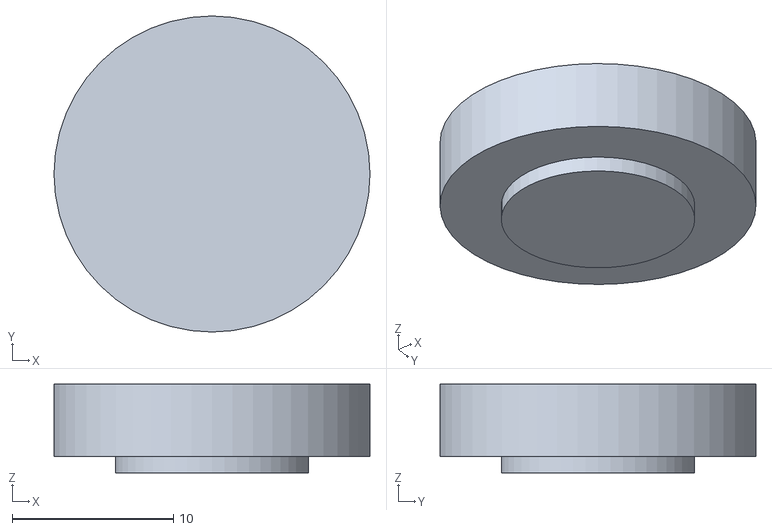
[picture p127: CAD file, 2026-11-11]
hardware/v6.3/assembly/bought_speaker_20mm.stl
19.6 x 19.6 x 5.50
