ricricucit/kibble-dispenser/hardware/v6.3/assembly/bought_leds_3mm.stl

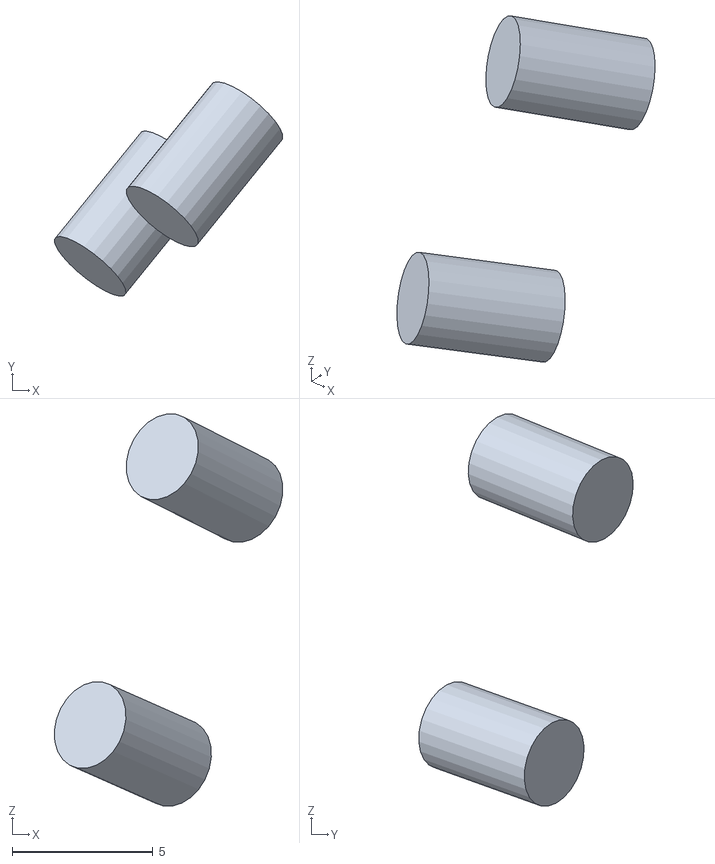
[picture p128: CAD file, 2026-11-11]
hardware/v6.3/assembly/bought_leds_3mm.stl
8.10 x 7.60 x 13.9
