ricricucit/kibble-dispenser/hardware/v6.3/assembly/bought_m3x40_stack.stl

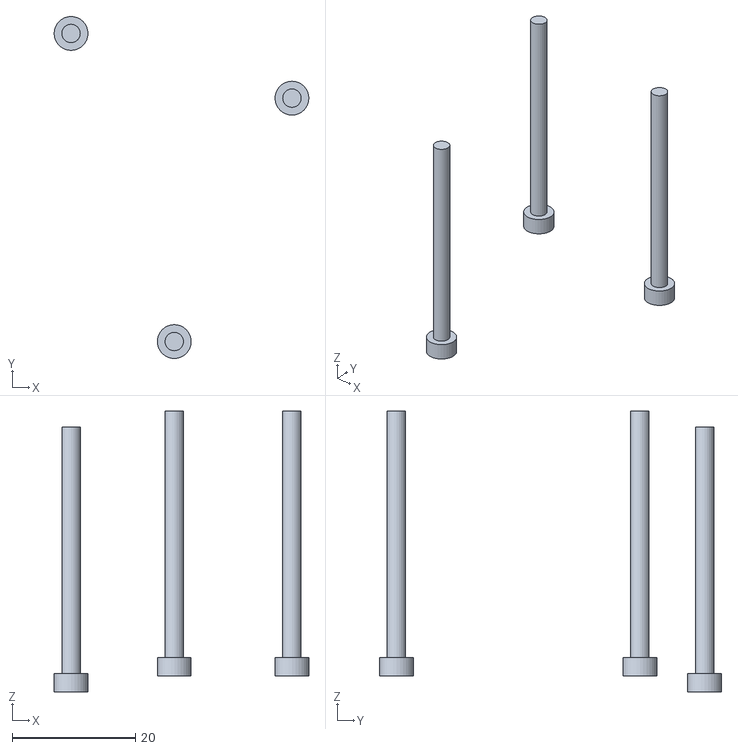
[picture p129: CAD file, 2026-11-11]
hardware/v6.3/assembly/bought_m3x40_stack.stl
41.4 x 55.5 x 45.6
