ricricucit/kibble-dispenser/hardware/v6.3/plates/stl/test_groove_rim_print.stl

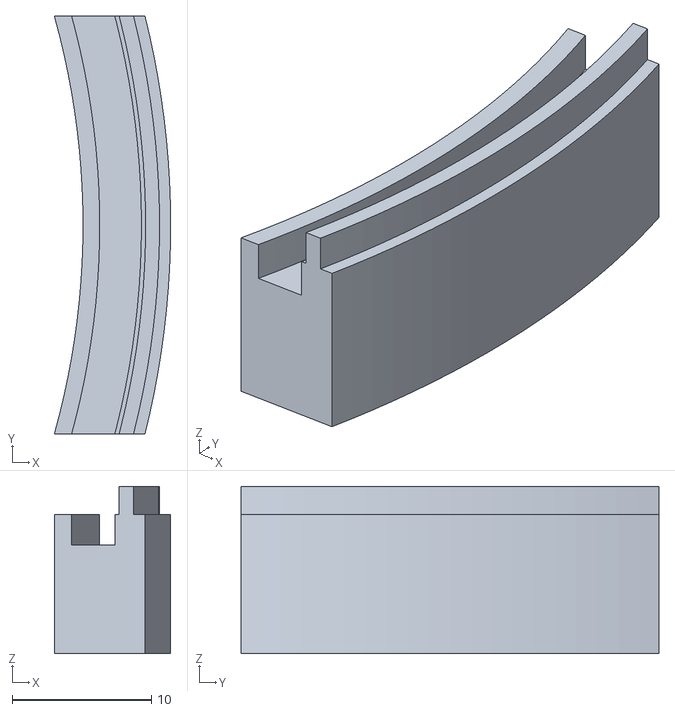
[picture p130: CAD file, 2026-11-10]
hardware/v6.3/plates/stl/test_groove_rim_print.stl
8.36 x 30.0 x 12.0
