ricricucit/kibble-dispenser/hardware/v6.3/plates/stl/piastra_finestra_v62_print_green.stl

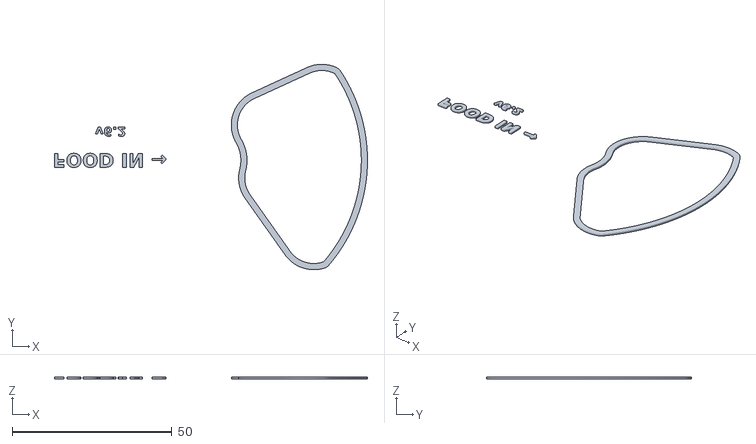
[picture p131: CAD file, 2026-11-10]
hardware/v6.3/plates/stl/piastra_finestra_v62_print_green.stl
98.1 x 64.4 x 0.6
