ricricucit/kibble-dispenser/site/v6.2/assembly/models/pulsante_v611.stl

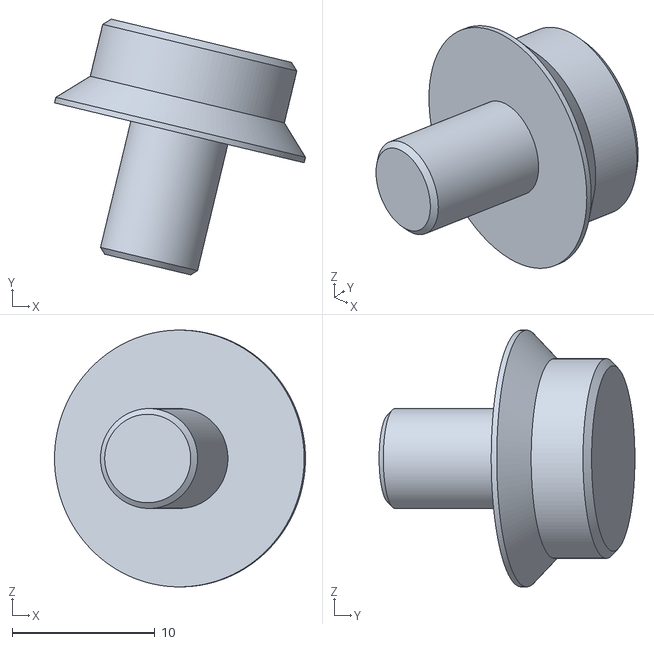
[picture p132: CAD file, 2026-11-10]
site/v6.2/assembly/models/pulsante_v611.stl
17.6 x 17.9 x 18.0
