ricricucit/kibble-dispenser/site/v6.2/assembly/models/colletto_v6.stl

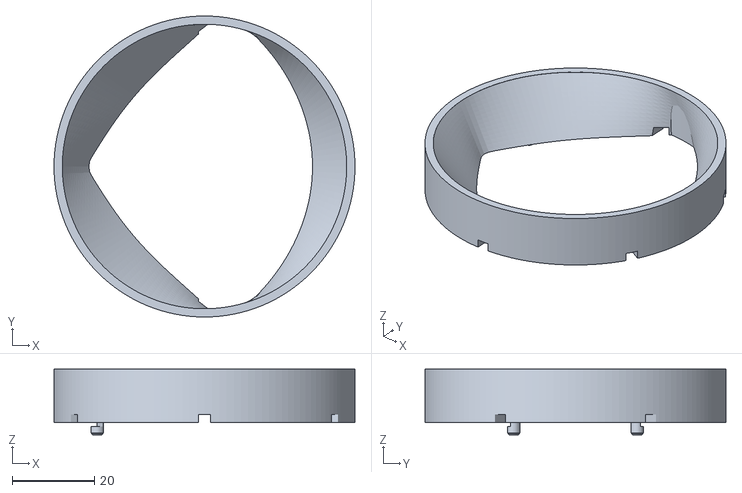
[picture p133: CAD file, 2026-11-10]
site/v6.2/assembly/models/colletto_v6.stl
73.0 x 73.0 x 16.0
