ricricucit/kibble-dispenser/hardware/v6.3/plates/stl/test_skirt_lip_print.stl

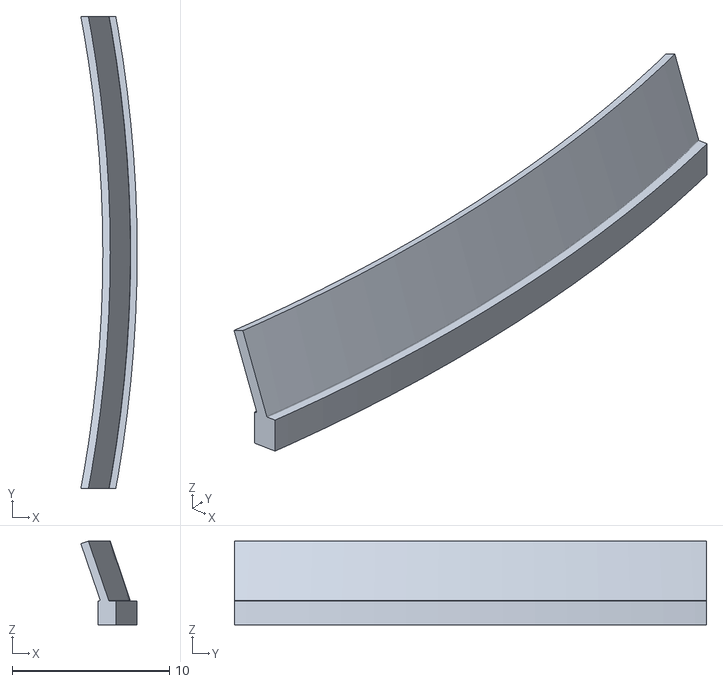
[picture p134: CAD file, 2026-11-10]
hardware/v6.3/plates/stl/test_skirt_lip_print.stl
3.59 x 30.0 x 5.33
