ricricucit/kibble-dispenser/(list of files, cad)

Other CAD files:
hardware/v6.3/plates/stl/flangia_alta_v63_print.stl
hardware/assembly/albero_mozzo.stl
hardware/3mf/disco_v3.3mf
hardware/assembly/passante_culla.stl
site/assembly/models/pt_k30x12_cap_1.stl
site/v6.2/assembly/models/inserti_vasca_6.stl
hardware/3mf/scivolo_v1.3mf
site/assembly/models/inserti_vasca_0.stl
hardware/v6.3/plates/stl/flangia_piano_v63_print.stl
site/assembly/models/colonna_v63.stl
site/assembly/models/oring_3x1_1.stl
hardware/v6.3/assembly/guarnizione_piano_v5_v63pos.stl
hardware/v6.3/plates/stl/saracinesca_v63_print.stl
site/assembly/models/anello_saracinesca_v63.stl
site/v6.2/assembly/models/oring_3x1_0.stl
hardware/v6.3/assembly/bought_cable_tie.stl
hardware/v6.3/plates/stl/passacavo_v63_print.stl
site/assembly/models/flangia_piano_v63.stl
site/v6.2/assembly/models/lips_lower_1.stl
hardware/v6.3/assembly/chiocciola_v63.stl
hardware/v6.3/assembly/flangia_alta_v63.stl
site/assembly/models/oring_3x1_cap_1.stl
hardware/v6.3/assembly/scatola_v63.stl
site/assembly/models/viti_guscio_1.stl
site/v6.2/assembly/models/inserti_vasca_4.stl
site/v6.2/assembly/models/lips_upper_0.stl
site/assembly/models/scatola_v63.stl
hardware/v6.3/assembly/anello_saracinesca_v63.stl
hardware/v6.3/plates/stl/piastra_gate_v62_print.stl
site/v6.2/assembly/models/inserti_vasca_1.stl
hardware/v6.3/plates/stl/guarnizione_fondello_v61_print.stl
site/assembly/models/viti_guscio_2.stl
site/assembly/models/inserti_vasca_2.stl
site/v6.2/assembly/models/viti_m3x40_0.stl
site/assembly/models/harness_jst.stl
site/v6.2/assembly/models/nottolino_v611_B_0.stl
hardware/v6.3/plates/stl/piastra_gate_v62_print_black.stl
site/assembly/models/saracinesca_v63.stl
site/assembly/models/pt_k30x12_cap_0.stl
site/assembly/models/viti_m3x40_0.stl
site/assembly/models/viti_scivolo_1.stl
site/assembly/models/membrane_acoustic_ip67.stl
hardware/v6.3/plates/stl/disco_v61_print.stl
site/assembly/models/flangia_alta_v63.stl
site/v6.2/assembly/models/inserti_vasca_2.stl
hardware/v6.3/plates/stl/disco_v61_print_orange.stl
site/assembly/models/viti_m3x40_1.stl
site/v6.2/assembly/models/viti_m3x40_2.stl
site/assembly/models/pt_k30x12_cap_2.stl
site/v6.2/assembly/models/passacavo_v62.stl
hardware/v6.3/assembly/colonna_v63.stl
site/assembly/models/passacavo_v63.stl
hardware/v6.3/assembly/bought_switch_12mm_ip67.stl
hardware/v6.3/plates/stl/piastra_finestra_v62_print_black.stl
site/assembly/models/oring_3x1_0.stl
hardware/v6.3/assembly/bought_dowel_4x6.stl
hardware/stl/albero_mozzo.stl
hardware/stl/disco_v3.stl
hardware/stl/passante_culla.stl
hardware/stl/scivolo_v1.stl
hardware/stl/test_scanalato.stl
hardware/v6.2/assembly/anello_saracinesca_v62.stl
hardware/v6.2/assembly/bought_keys_3x3x18.stl
hardware/v6.2/assembly/bought_m3x10_chute.stl
hardware/v6.2/assembly/bought_m3x12_shell_tabs.stl
hardware/v6.2/assembly/bought_oring_tt_8x1_5.stl
hardware/v6.2/assembly/bought_st29_join.stl
hardware/v6.2/assembly/canalina_base_1.stl
hardware/v6.2/assembly/canalina_base_2.stl
hardware/v6.2/assembly/canalina_coperchio_1.stl
hardware/v6.2/assembly/canalina_coperchio_2.stl
hardware/v6.2/assembly/canalina_tappo.stl
hardware/v6.2/assembly/chiocciola_v62.stl
hardware/v6.2/assembly/colonna_v62.stl
hardware/v6.2/assembly/flangia_alta_v62.stl
hardware/v6.2/assembly/flangia_piano_v62.stl
hardware/v6.2/assembly/fondello_v62_bordo.stl
hardware/v6.2/assembly/fondello_v62_fianco.stl
hardware/v6.2/assembly/fondello_v62_fondo.stl
hardware/v6.2/assembly/guarnizione_piano_v5_v62pos.stl
hardware/v6.2/assembly/nottolino_v611_A.stl
hardware/v6.2/assembly/nottolino_v611_B.stl
hardware/v6.2/assembly/nottolino_v611_C.stl
hardware/v6.2/assembly/passacavo_v62.stl
hardware/v6.2/assembly/saracinesca_v62_aperta_arancio.stl
hardware/v6.2/assembly/saracinesca_v62_aperta_verde.stl
hardware/v6.2/assembly/scatola_v62.stl
hardware/v6.2/plates/Kibble_Dispenser_v62_PETG.bambu.3mf
hardware/v6.2/plates/Kibble_Dispenser_v62_TPU.bambu.3mf
hardware/v6.2/plates/plates/PETG-0_spline__rim_cap_and_skirt_grooves.3mf
hardware/v6.2/plates/plates/PETG-1_pod_shell__electronics_box.3mf
hardware/v6.2/plates/plates/PETG-2_bowl__pod_cap.3mf
hardware/v6.2/plates/plates/PETG-3_lower_flange__cable_channel.3mf
hardware/v6.2/plates/plates/PETG-4_upper_flange__tower__shaft__hub.3mf
hardware/v6.2/plates/plates/PETG-5_chute__collar__gate__window_plates.3mf
hardware/v6.2/plates/plates/PETG-6_interlock_ring__disc__gate_blade__latch__button__3_thumb_turns.3mf
hardware/v6.2/plates/plates/TPU-0_rim_cap_skirt_and_comb_lips.3mf
hardware/v6.2/plates/plates/TPU-1_all_seals.3mf
hardware/v6.2/plates/stl/anello_saracinesca_v62_print.stl
hardware/v6.2/plates/stl/canalina_base_v62_print.stl
hardware/v6.2/plates/stl/canalina_coperchio_v62_print.stl
hardware/v6.2/plates/stl/canalina_tappo_v62_print.stl
hardware/v6.2/plates/stl/chiocciola_v62_print.stl
hardware/v6.2/plates/stl/colonna_v62_print.stl
hardware/v6.2/plates/stl/flangia_alta_v62_print.stl
hardware/v6.2/plates/stl/flangia_piano_v62_print.stl
hardware/v6.2/plates/stl/flangia_piano_v62_print_cad_original.stl
hardware/v6.2/plates/stl/fondello_v62_print.stl
hardware/v6.2/plates/stl/linguetta_sicura_print.stl
hardware/v6.2/plates/stl/nottolino_v611_print.stl
hardware/v6.2/plates/stl/passacavo_v62_print.stl
hardware/v6.2/plates/stl/saracinesca_v62_print.stl
hardware/v6.2/plates/stl/saracinesca_v62_print_green.stl
hardware/v6.2/plates/stl/saracinesca_v62_print_orange.stl
hardware/v6.2/plates/stl/scatola_v62_print.stl
hardware/v6.3/assembly/albero_v6.stl
hardware/v6.3/assembly/bought_board_70x50.stl
hardware/v6.3/assembly/bought_cable_12v_unit.stl
hardware/v6.3/assembly/bought_cap_1000uF.stl
hardware/v6.3/assembly/bought_connector_m8_ip67.stl
hardware/v6.3/assembly/bought_esp32.stl
hardware/v6.3/assembly/bought_gland_m12.stl
hardware/v6.3/assembly/bought_inserts_box.stl
hardware/v6.3/assembly/bought_m3x8_hub.stl
hardware/v6.3/assembly/bought_m3x8_servo.stl
hardware/v6.3/assembly/bought_oring_btn_14x1_5.stl
hardware/v6.3/assembly/bought_oring_face_24x2.stl
hardware/v6.3/assembly/bought_oring_seam_2.stl
hardware/v6.3/assembly/bought_oring_shaft_9x2.stl
hardware/v6.3/assembly/bought_reg_12v_d36v50f6.stl
hardware/v6.3/assembly/bought_reg_5v_logic.stl
hardware/v6.3/assembly/bought_servo.stl
hardware/v6.3/assembly/bought_vent_m12_eptfe.stl
hardware/v6.3/assembly/bought_wood_5x35.stl
hardware/v6.3/assembly/colletto_v6_v63pos.stl
hardware/v6.3/assembly/disco_v61_black.stl
hardware/v6.3/assembly/disco_v61_orange.stl
hardware/v6.3/assembly/fondello_v63_pannello_3.stl
hardware/v6.3/assembly/guarnizione_baionetta_v61.stl
hardware/v6.3/assembly/guarnizione_fondello_v61.stl
hardware/v6.3/assembly/guscio_v611_alto.stl
hardware/v6.3/assembly/guscio_v611_basso.stl
hardware/v6.3/assembly/labbro_ombra_v611.stl
hardware/v6.3/assembly/labbro_pettine_v62_x4.stl
hardware/v6.3/assembly/labbro_scivolo_v611.stl
hardware/v6.3/assembly/linguetta_sicura_v63.stl
hardware/v6.3/assembly/mozzo_v6.stl
hardware/v6.3/assembly/piastra_finestra_v62_black.stl
hardware/v6.3/assembly/piastra_finestra_v62_green.stl
hardware/v6.3/assembly/piastra_gate_v62_black.stl
hardware/v6.3/assembly/piastra_gate_v62_green.stl
hardware/v6.3/assembly/pulsante_v611.stl
hardware/v6.3/assembly/scivolo_v611.stl
hardware/v6.3/plates/stl/albero_v6_print.stl
hardware/v6.3/plates/stl/colletto_v6_print.stl
hardware/v6.3/plates/stl/guarnizione_piano_v5_print.stl
hardware/v6.3/plates/stl/mozzo_v6_print.stl
hardware/v6.3/plates/stl/piastra_gate_v62_print_green.stl
hardware/v6.3/plates/stl/test_scanalato_print.stl
hardware/v6/3mf/albero_v6.3mf
hardware/v6/3mf/chiocciola_v6.3mf
hardware/v6/3mf/colletto_v6.3mf
hardware/v6/3mf/colonna_v6.3mf
hardware/v6/3mf/disco_v6.3mf
hardware/v6/3mf/flangia_piano_v6.3mf
hardware/v6/3mf/fondello_v6.3mf
hardware/v6/3mf/guarnizione_baionetta.3mf
hardware/v6/3mf/guarnizione_fondello_v6.3mf
hardware/v6/3mf/guarnizione_piano_v5.3mf
hardware/v6/3mf/labbro_finestra_1.3mf
hardware/v6/3mf/labbro_finestra_2.3mf
hardware/v6/3mf/labbro_uscita_1.3mf
hardware/v6/3mf/labbro_uscita_2.3mf
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
