ricricucit/kibble-dispenser/docs/BUILD_GUIDE.md

# Build guide

This file will be exported from the living build guide. It has not been exported yet.

Until then:

- printed parts, materials and print orientation: [../hardware/README.md](../hardware/README.md)
- wiring, flashing and servo calibration: [../firmware/README.md](../firmware/README.md)
- design background (Italian): [research/elettronica-e-tenuta.it.md](research/elettronica-e-tenuta.it.md)
