ricricucit/kibble-dispenser/docs/getting-started.md

# Getting started

For buyers, coming later. This page will explain how to set up a kit or a finished dispenser: placing it, filling it, connecting power, adding it to Home Assistant and setting portions. Until then, the dispenser is a build-it-yourself prototype: see the [build guide](BUILD_GUIDE.md), [hardware notes](../hardware/README.md) and [firmware notes](../firmware/README.md).
