ricricucit/kibble-dispenser/site/v6.2/assembly/index.html

Kibble Dispenser Outdoor Assembly instructions

EN IT DE

Loading 3D…

Steps
