ricricucit/kibble-dispenser/docs/manual/kibble-dispenser-manual-it.pdf

IT ITALIANO

# Kibble Dispenser Outdoor

### Manuale d'uso

Installazione, uso e manutenzione


0.6.3 bozza | progetto v6.3

Provvisorio: non ancora stampato né provato

## Indice

Avvertenze di sicurezza | 3
Contenuto della confezione | 7
Attrezzi necessari | 9
Installazione | 10
Preparare il ripiano | 10
Aggancio e collegamento | 17
Primo utilizzo | 21
Uso quotidiano | 23
Manutenzione | 25
Risoluzione dei problemi | 29
Dati tecnici | 32
Ricambi e pezzi stampabili | 34
Smaltimento | 35
Open source e licenze | 35
Appendice A · Costruiscilo da te | 37
Appendice B · Prova di tenuta a casa | 58
Note | 59
INDICE | KIBBLE DISPENSER OUTDOOR

### 2 Kibble Dispenser Outdoor · 0.6.3 bozza

## Avvertenze di sicurezza

Leggi questo manuale prima di installare e usare l'unità e conservalo. Se cedi l'unità a qualcun altro, consegna anche il manuale.

Simboli usati in questo manuale

Attenzione: rischio di lesioni o danni. Leggi prima di proseguire.

Controllo: verificalo prima del passo successivo.
Nota: informazione utile.
A Lettera del pezzo, come in Contenuto della confezione.

1 Numero della vite, come nel sacchetto viti.

Uso previsto
Kibble Dispenser Outdoor eroga cibo secco per animali da un contenitore appoggiato su un ripiano sopra l'unità, una porzione alla volta, alla pressione di un pulsante.
Usalo solo per cibo secco per animali (crocchette) con pezzi fino a 25 mm. Non è fatto per cibo umido, liquidi o altro.
Installalo sotto un ripiano o un tavolo, al chiuso oppure all'aperto sotto una tettoia.
Non sostituisce le tue cure: controlla ogni giorno che il tuo animale mangi e che il cibo esca.
KIBBLE DISPENSER OUTDOOR | SICUREZZA
Kibble Dispenser Outdoor · 0.6.3 bozza | 3

Elettricità

Parti in movimento

È un progetto open source provvisorio: nessuna unità è ancora stata stampata o provata. Provala per qualche giorno sotto controllo prima di farci affidamento.

L'unità funziona a bassissima tensione di sicurezza
(12 V DC). Usa solo l'alimentatore del kit.
L'alimentatore non è impermeabile: mettilo in un posto asciutto, al riparo dalla pioggia. Tieni asciutte la spina e la presa e fai scendere il cavo di rete con un'ansa di gocciolamento.
Non usare l'unità se un cavo, l'alimentatore o l'involucro sono danneggiati.
Stacca l'alimentatore dalla presa prima di smontare, aprire o pulire l'unità.

Non infilare mai le dita nell'uscita, nello scivolo o nel foro del ripiano mentre l'unità è collegata alla corrente: il disco dosa‐ tore gira quando si preme il pulsante e può muoversi un attimo verso la posizione di riposo quando arriva la corrente.
Spegni l'unità e staccala dalla corrente prima di togliere un blocco.
SICUREZZA | KIBBLE DISPENSER OUTDOOR

### 4 Kibble Dispenser Outdoor · 0.6.3 bozza

La saracinesca

Bambini e animali

All'aperto

Igiene del cibo

Gira sempre l'anello arancione su CHIUSA prima di smon‐ tare l'unità e ogni volta che togli il contenitore del cibo: altri‐ menti il cibo cade dal foro del ripiano.
Lascia libero un cerchio di 20 cm intorno all'unità, così da raggiungere l'anello con la mano.

Non è un giocattolo. Non lasciare che i bambini giochino con l'unità, il suo pulsante o l'imballaggio.
Fai passare il cavo e sistema l'alimentatore dove gli animali non possano morderli.
Non lasciare che gli animali si arrampichino sull'unità, ci si appendano o ci giochino.

All'aperto installa l'unità solo sotto una tettoia, al riparo dalla pioggia battente e lontano dagli irrigatori. Non bagnarla mai con una canna o un'idropulitrice.
Evita il sole pieno tutto il giorno: il caldo fa deteriorare prima il cibo.
Sigilla il giunto tra il contenitore del cibo e il ripiano, così che la pioggia non entri nel cibo.

Usa solo cibo secco per animali fresco e in buono stato. Butta via il cibo umido, ammuffito o che ha un cattivo odore.

KIBBLE DISPENSER OUTDOOR | SICUREZZA

Durante il montaggio

Pulisci il percorso del cibo ogni pochi mesi e ogni volta che cambi tipo di cibo (pagina 25).
I pezzi stampati hanno sottili scanalature dove si possono accumulare briciole e non sono certificati come materiali a contatto con gli alimenti.
Lava i pezzi solo a mano, a massimo 40 °C. Niente lavastoviglie.

Indossa gli occhiali di protezione quando fori.
Verifica che il ripiano regga il contenitore pieno: 200 litri di crocchette pesano circa 80 kg.
Controlla che dove fori non passino cavi o tubi.
Usa solo l'alimentatore da 12 V del kit. Tieni asciutte la spina e la presa di corrente.
Tieni i pezzi piccoli lontano da bambini e animali.
SICUREZZA | KIBBLE DISPENSER OUTDOOR

### 6 Kibble Dispenser Outdoor · 0.6.3 bozza

## Contenuto della confezione

L'unità dosatrice e il set flangia arrivano già montati: non smontarli. Controlla che ci siano tutti i pezzi.

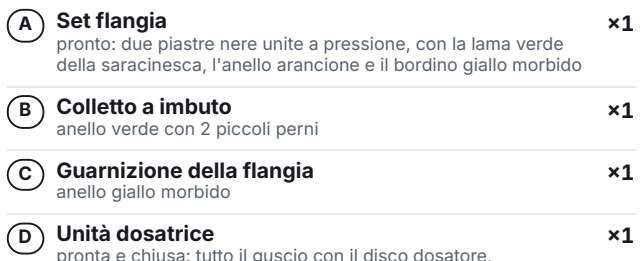
[picture p220: figure]
A Set flangia; B Colletto a imbuto anello verde con 2 piccoli perni; C Guarnizione della flangia anello giallo morbido; D Unità dosatrice

pronto: due piastre nere unite a pressione, con la lama verde della saracinesca, l'anello arancione e il bordino giallo morbido

pronta e chiusa: tutto il guscio con il disco dosatore, l'elettronica, il pannello comandi e un cavo corto con spina

KIBBLE DISPENSER OUTDOOR | CONTENUTO DELLA CONFEZIONE

E Set alimentatore
alimentatore 12 V con adattatore a morsetti, cavo di alimenta‐ zione con connettore stagno e passacavo giallo

×1

F Dima di foratura
carta, 1:1, A4

×1

Ti servono anche un contenitore per il cibo (per esempio un fusto) e un ripiano o un tavolo in piano. Non sono nel kit.
La trasmissione interna è lubrificata a vita: non serve mai grasso.

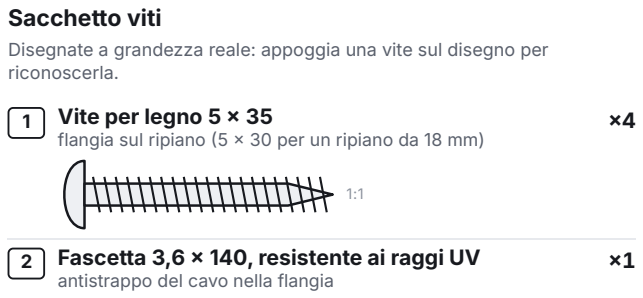
[picture p221: figure]
Sacchetto viti; riconoscerla.; 1 Vite per legno 5 × 35; antistrappo del cavo nella flangia

Disegnate a grandezza reale: appoggia una vite sul disegno per

flangia sul ripiano (5 × 30 per un ripiano da 18 mm)

### 2 Fascetta 3,6 × 140, resistente ai raggi UV

CONTENUTO DELLA CONFEZIONE | KIBBLE DISPENSER OUTDOOR

### 8 Kibble Dispenser Outdoor · 0.6.3 bozza

## Attrezzi necessari

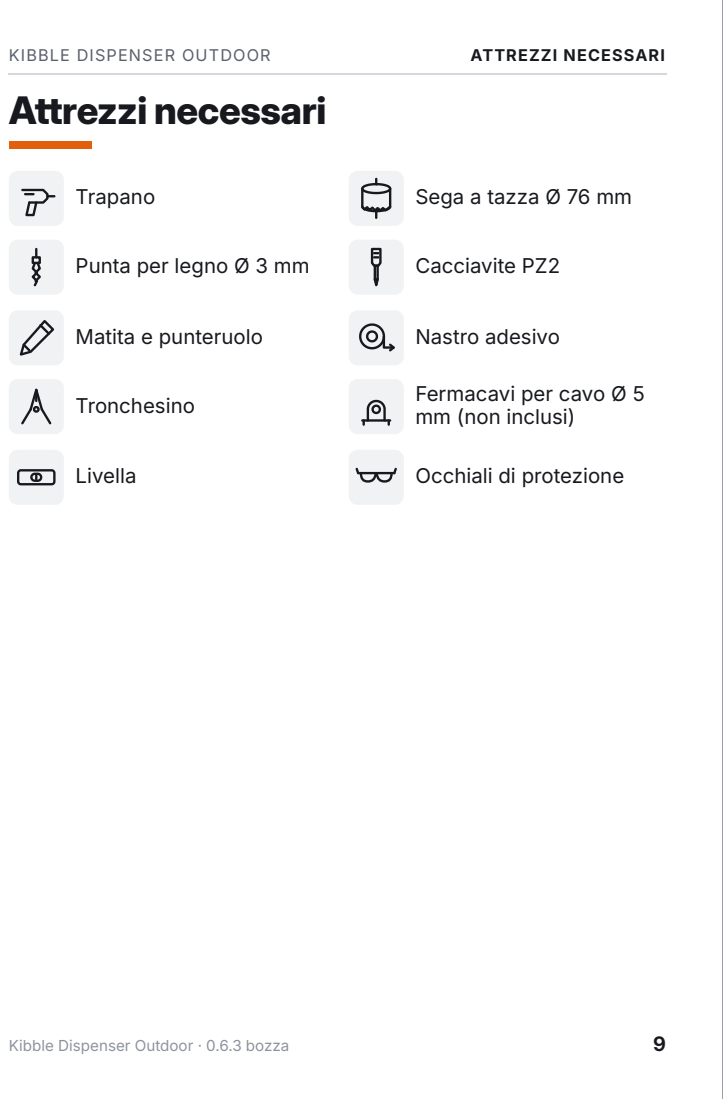
[picture p222: page 9]
Trapano; Sega a tazza Ø 76 mm; Punta per legno Ø 3 mm; Cacciavite PZ2; Matita e punteruolo; Nastro adesivo; Tronchesino; Livella; Occhiali di protezione; KIBBLE DISPENSER OUTDOOR; ATTREZZI NECESSARI

Fermacavi per cavo Ø 5
mm (non inclusi)

## Installazione

PREPARARE IL RIPIANO
1

### Scegli il posto

Livella


### 1 Scegli un ripiano o un tavolo in piano, spesso da 18 a

40 mm. All'aperto, scegli un posto sotto una tettoia.

### 2 Lascia almeno 36 cm liberi sotto il ripiano: 18,2 cm per

l'unità, 8 cm per smontarla e lo spazio per la ciotola.

### 3 Lascia libero un cerchio di 20 cm intorno all'unità: l'anello

arancione si gira a mano.

### 4 Il pulsante di sgancio e il pannello comandi guardano

verso la stanza: lascia 15 cm liberi davanti al pannello per un dito. Il cavo esce dalla flangia sul retro.
Controllo: Il ripiano è in piano in entrambe le direzioni.
INSTALLAZIONE | PREPARARE IL RIPIANO

### 10 Kibble Dispenser Outdoor · 0.6.3 bozza

2

### Segna i fori con la dima

F ×1 | Matita e punteruolo | Nastro adesivo


### 1 Stampa la dima di foratura F al 100 % e controlla la barra

di 50 mm.

### 2 Fissala con il nastro sotto il ripiano, con il lato stampato

verso di te e FRONT verso la stanza.

### 3 Buca la carta con il punteruolo: il centro del foro grande e i

4 punti delle viti.
4 Togli la dima.
Controllo: Hai il centro del foro grande e 4 punti per le viti.
La dima è un foglio A4 separato: kibble-dispenser-drilling-template.pdf. Stampala al 100 % e fissala sotto il ripiano con il LATO STAMPATO VERSO DI TE.
PREPARARE IL RIPIANO | INSTALLAZIONE

3

### Fora il ripiano

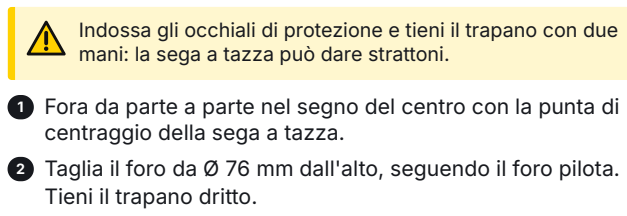
[picture p223: figure]
centraggio della sega a tazza.; Tieni il trapano dritto.

Indossa gli occhiali di protezione e tieni il trapano con due mani: la sega a tazza può dare strattoni.

### 1 Fora da parte a parte nel segno del centro con la punta di

2 Taglia il foro da Ø 76 mm dall'alto, seguendo il foro pilota.

### 3 Prefora i 4 punti delle viti con la punta da Ø 3 mm, profondi

circa 20 mm.
4 Togli i trucioli e rifinisci i bordi.
Controllo: Il foro grande attraversa il ripiano dritto.
INSTALLAZIONE | PREPARARE IL RIPIANO

### 12 Kibble Dispenser Outdoor · 0.6.3 bozza

### 4 Monta il set flangia

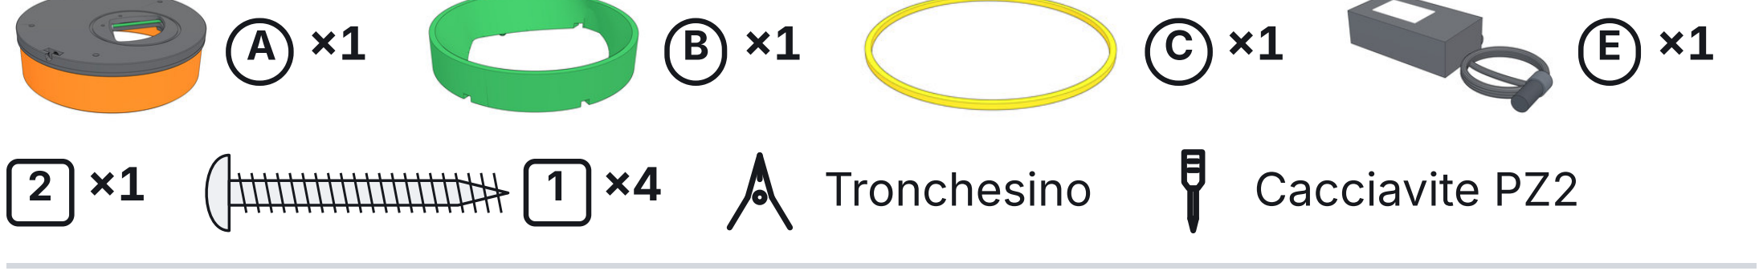
[picture p224: figure]
Tronchesino; Cacciavite PZ2

Ripiano più sottile di 20 mm: usa 4 viti 5 × 30, così le

### 1 Inserisci la guarnizione della flangia C nella scanalatura

sopra il set flangia A e metti il colletto verde B nell'apertura grande: i suoi 2 perni entrano nei 2 forellini.

### 2 Infila l'estremità libera del cavo di alimentazione del set

alimentatore E nel forellino dentro la flangia, finché esce dal retro del bordo. Spingi il passacavo giallo nel foro: il connettore resta appeso sotto.

### 3 Tira il cavo da fuori senza forzare. Nella finestrella sopra la

flangia stringi bene la fascetta 2 intorno al cavo e taglia la coda.

PREPARARE IL RIPIANO | INSTALLAZIONE

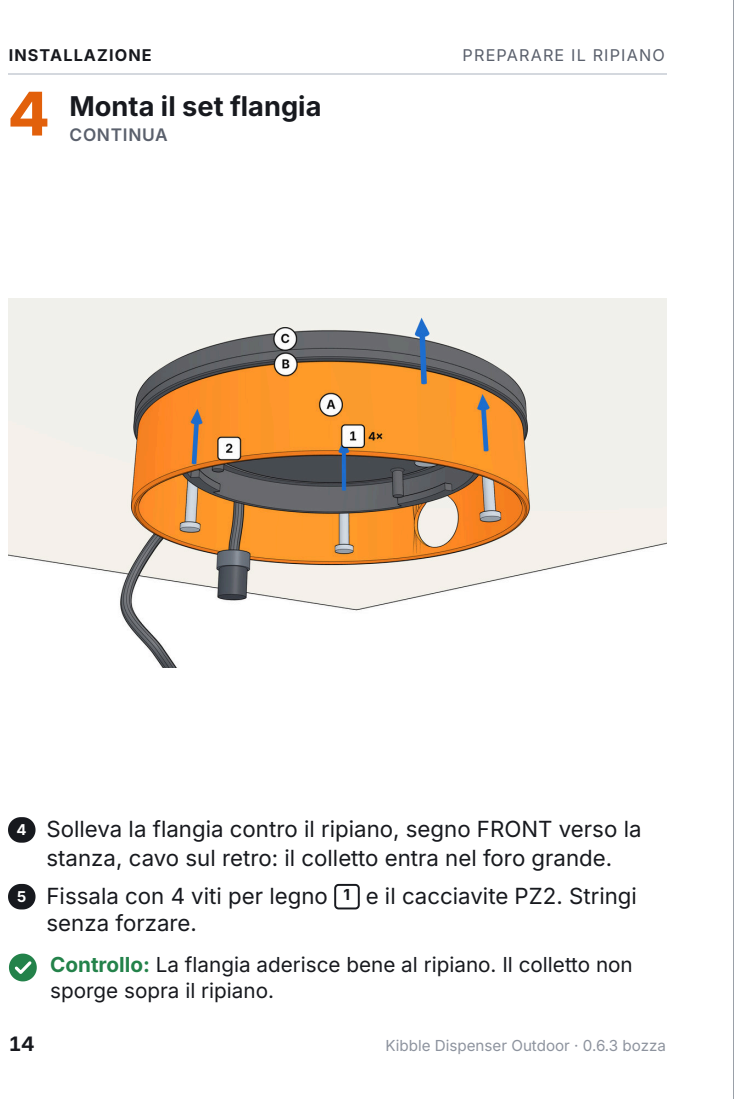
[picture p225: page 14]
CONTINUA; INSTALLAZIONE; PREPARARE IL RIPIANO

4 Monta il set flangia

4 Solleva la flangia contro il ripiano, segno FRONT verso la
stanza, cavo sul retro: il colletto entra nel foro grande.
5 Fissala con 4 viti per legno 1 e il cacciavite PZ2. Stringi
senza forzare.
Controllo: La flangia aderisce bene al ripiano. Il colletto non
sporge sopra il ripiano.

14 Kibble Dispenser Outdoor · 0.6.3 bozza

5

### Prova la saracinesca


1 Gira l'anello arancione in senso antiorario, visto da sotto, fino in fondo: la lama verde chiude l'apertura. Questa è la posizione CHIUSA.

### 2 In posizione CHIUSA la finestra tonda dell'anello si trova

dove ci sarà il pulsante di sgancio dell'unità.
3 Gira l'anello indietro fino in fondo: l'apertura è libera. Questa è la posizione APERTA.
4 Per ora lascia l'anello in posizione CHIUSA.
Controllo: L'anello gira senza sforzo tra i due fermi (circa 1/3 di giro).
PREPARARE IL RIPIANO | INSTALLAZIONE

6

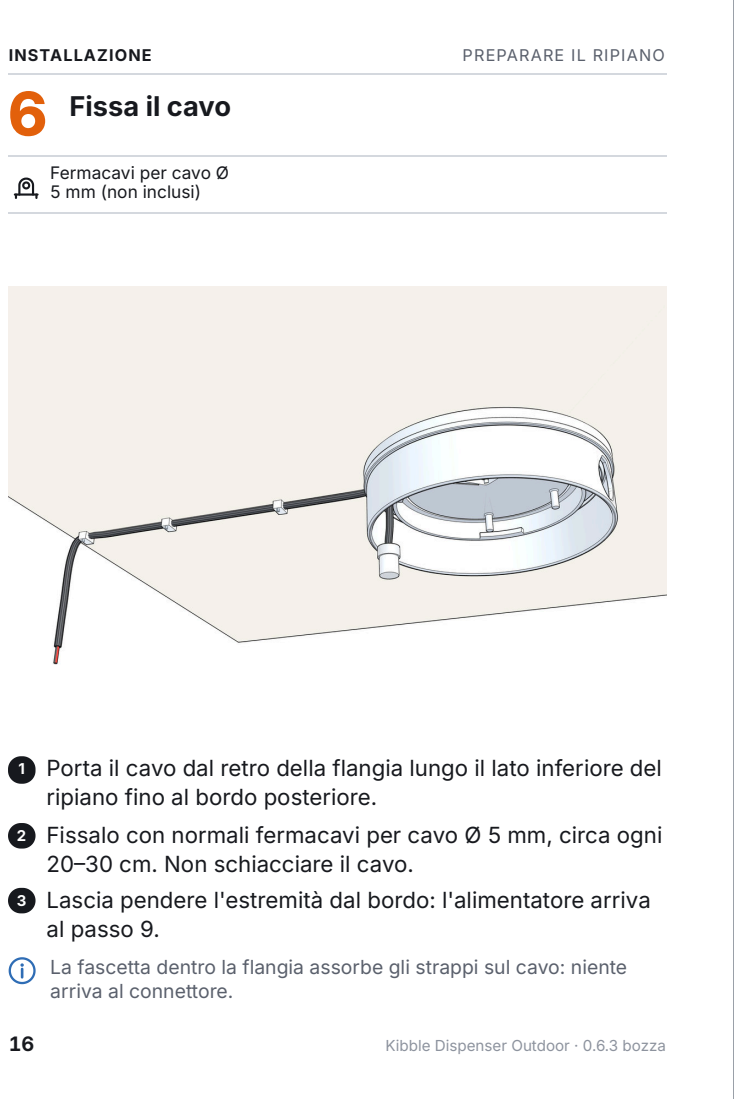
[picture p226: page 16]
INSTALLAZIONE; PREPARARE IL RIPIANO

Fissa il cavo

Fermacavi per cavo Ø
5 mm (non inclusi)

1 Porta il cavo dal retro della flangia lungo il lato inferiore del
ripiano fino al bordo posteriore.
2 Fissalo con normali fermacavi per cavo Ø 5 mm, circa ogni
20–30 cm. Non schiacciare il cavo.
3 Lascia pendere l'estremità dal bordo: l'alimentatore arriva
al passo 9.
La fascetta dentro la flangia assorbe gli strappi sul cavo: niente
arriva al connettore.

16 Kibble Dispenser Outdoor · 0.6.3 bozza

AGGANCIO E COLLEGAMENTO
7

### Collega l'unità

D ×1


### 1 Tieni l'unità dosatrice D circa 8 cm sotto la flangia, con il

pulsante di sgancio verso la stanza: puoi appoggiarla su una scatola o uno sgabello.

### 2 Infila la spina dell'unità nel connettore che pende dalla

flangia e avvita bene la ghiera.

### 3 Spingi il connettore e il cavo libero dentro la parte alta del

guscio.
Controllo: La ghiera è avvitata fino in fondo.
AGGANCIO E COLLEGAMENTO | INSTALLAZIONE

8

### Aggancia l'unità


1 Controlla che l'anello arancione sia in posizione CHIUSA.

### 2 Solleva l'unità dritta dentro la flangia. Girala un poco

finché le 3 alette entrano nelle fessure e l'unità sale.

### 3 Spingi in su e girala in senso orario, vista da sotto, di circa

1/12 di giro (30°), finché la linguetta scatta.

### 4 Gira l'anello arancione in senso orario fino in fondo:

APERTA. Ora il cibo può arrivare all'unità.
Controllo: L'unità non torna indietro e la fessura sotto la flangia è uniforme tutto intorno.
INSTALLAZIONE | AGGANCIO E COLLEGAMENTO

### 18 Kibble Dispenser Outdoor · 0.6.3 bozza

9

### Collega l'alimentazione

E ×1 Cacciavite PZ2


Tensione di rete: alimentatore, spina e presa devono

### 1 Metti l'alimentatore E in un posto asciutto, al riparo dalla

pioggia, per esempio sul ripiano sotto la tettoia.

### 2 Lascia pendere il cavo dal bordo del ripiano formando

un'ansa più bassa dell'alimentatore (ansa di gocciola‐ mento): l'acqua gocciola via dal punto più basso.

### 3 Collega i 2 fili all'adattatore: rosso al +, nero al −. Stringi le

viti.
4 Collega l'alimentatore alla presa.
Controllo: L'unità parte spenta (OFF), con il LED di stato spento. Non dà mai cibo quando arriva la corrente.
AGGANCIO E COLLEGAMENTO | INSTALLAZIONE

### 10 Posiziona il contenitore e riempilo


Un contenitore pieno pesa molto: verifica che il ripiano lo

### 1 Metti il tuo contenitore del cibo sul ripiano, con l'apertura

del fondo proprio sopra il colletto verde.
2 Sigilla il giunto così che non entri la pioggia.
3 Riempilo di cibo secco, pezzi fino a 25 mm.
Controllo: Con l'anello APERTO, il cibo arriva in cima all'unità.
INSTALLAZIONE | AGGANCIO E COLLEGAMENTO

### 20 Kibble Dispenser Outdoor · 0.6.3 bozza

## Primo utilizzo

11

### Prima prova


1 Metti la ciotola sotto l'uscita.

### 2 Il pannello comandi è sul lato stanza del fondello, sotto il

pulsante di sgancio. Premi il suo pulsante due volte di seguito (doppia pressione): il LED di stato si accende, parte un suono e l'unità dà una porzione.

### 3 Ora premi il pulsante una volta: dopo un attimo l'unità dà

una porzione con un suono. Ripeti alcune volte.

### 4 Le prime porzioni possono essere più piccole, finché il

disco si riempie.

KIBBLE DISPENSER OUTDOOR | PRIMO UTILIZZO

11

### Prima prova

CONTINUA

Controllo: A ogni pressione singola il cibo cade nella ciotola.

I PRIMI GIORNI
Controlla ogni giorno che il cibo arrivi nella ciotola e che il tuo animale lo mangi.
Pesa 10 porzioni con una bilancia da cucina: così sai quanto dà una pressione con il tuo cibo.
Alcuni animali hanno bisogno di qualche giorno per abituarsi al suono.
PRIMO UTILIZZO | KIBBLE DISPENSER OUTDOOR

### 22 Kibble Dispenser Outdoor · 0.6.3 bozza

## Uso quotidiano

Uso quotidiano: un pulsante

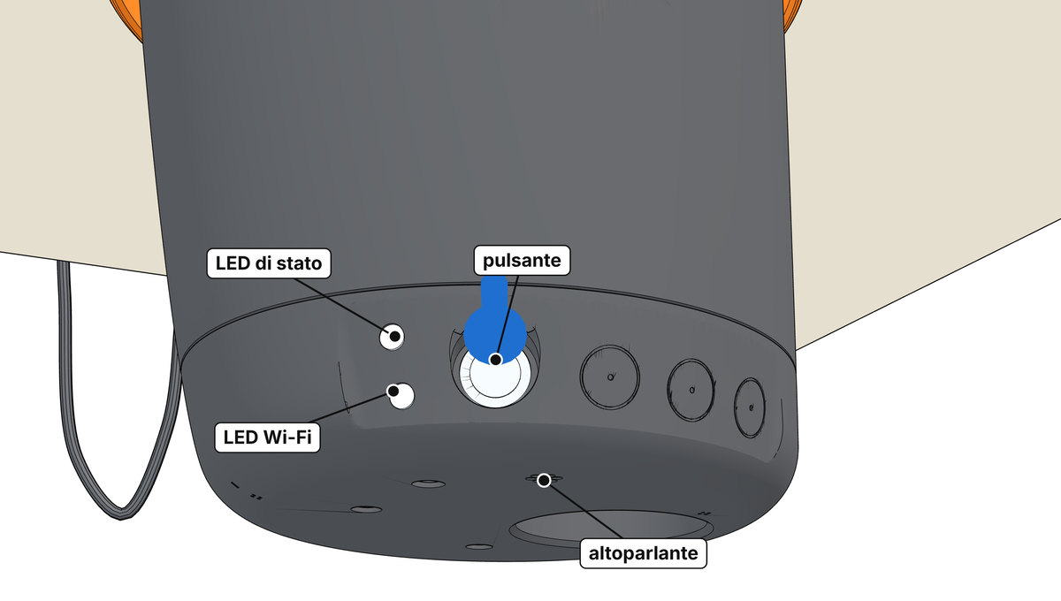
[picture p227: figure]

L'unità non dà mai cibo quando arriva la corrente: dopo un'interruzione riparte spenta. Il comportamento del pulsante e il significato dei LED sono provvisori finché il firmware non viene aggiornato (issue GitHub n. 2).

Il pannello comandi ha un pulsante e due luci. Premi il pul‐ sante con la punta del dito, fino in fondo all'incavo.
Doppia pressione (due volte entro 0,4 s): accende o spegne l'unità. All'accensione dà una porzione; allo spegnimento nessuna.
Pressione singola: una porzione, solo quando l'unità è accesa. Da spenta il LED di stato lampeggia soltanto. Tenendo premuto non dà mai di più.
Tieni premuto 5 s: ripristina tutte le impostazioni tranne il Wi-Fi. Tieni premuto 10 s: ripristino completo, Wi-Fi com‐ preso. Lascia dopo il segnale del LED; non esce cibo.
LED in alto: stato (acceso/spento). LED in basso: Wi-Fi. A ogni porzione parte un suono; una porzione è di circa 6,5 g.
KIBBLE DISPENSER OUTDOOR | USO QUOTIDIANO

Usare la saracinesca


Con l'unità smontata, tieni la saracinesca CHIUSA: altri‐ menti il cibo cade dal foro del ripiano.

Gira sempre l'anello su CHIUSA prima di smontare l'unità

APERTA (anello girato in senso orario, visto da sotto): il cibo scende nell'unità. È la posizione normale.
CHIUSA (anello girato in senso antiorario fino in fondo): la lama verde trattiene il cibo nel contenitore.
Chiudi la saracinesca prima di smontare l'unità. Solo allora la finestra dell'anello lascia libero il pulsante di sgancio. Puoi riempire il contenitore con la saracinesca aperta o
USO QUOTIDIANO | KIBBLE DISPENSER OUTDOOR

### 24 Kibble Dispenser Outdoor · 0.6.3 bozza

## Manutenzione

Quasi nessuna manutenzione


Mai grasso né olio: la trasmissione interna è sigillata e lubri‐ ficata a vita.
Nessun gel di silice da cambiare: la scatola elettronica respira attraverso una valvola a membrana.
Il disco dosatore si pulisce da solo: piccole nervature sotto spazzano via le briciole a ogni giro.
Tieni puliti i forellini dei due scarichi nel fondo piatto; se serve, sciacquali con un po' d'acqua.
Per igiene, pulisci il percorso del cibo ogni pochi mesi e quando cambi tipo di cibo (prossimi due passi).
KIBBLE DISPENSER OUTDOOR | MANUTENZIONE

12

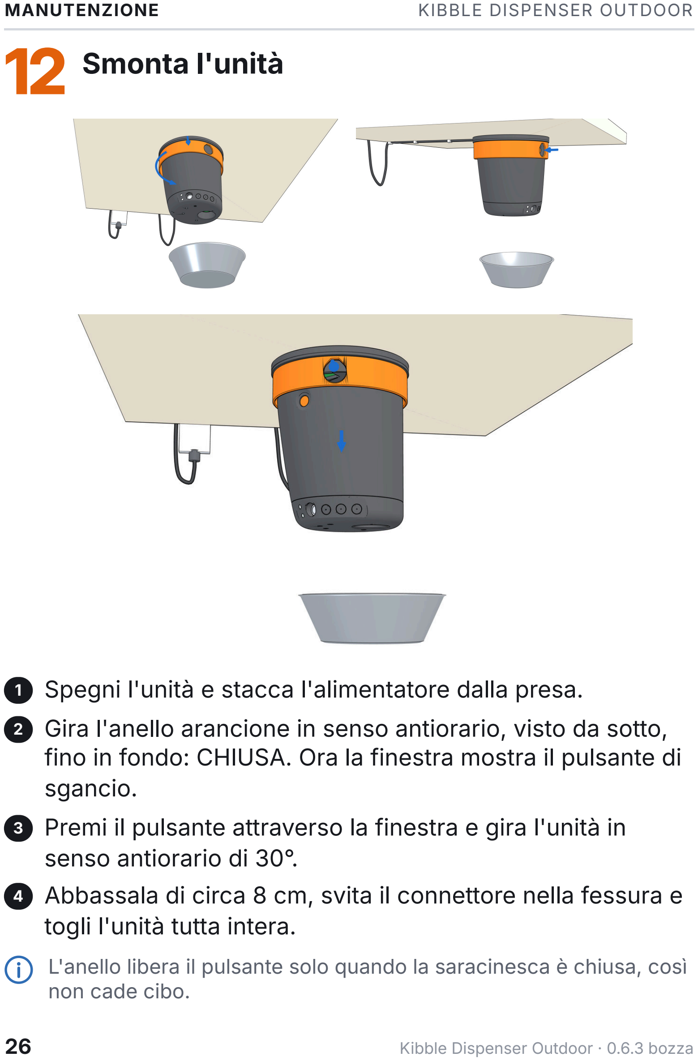
[picture p228: page 26]

### Smonta l'unità

1 Spegni l'unità e stacca l'alimentatore dalla presa.
2 Gira l'anello arancione in senso antiorario, visto da sotto, fino in fondo: CHIUSA. Ora la finestra mostra il pulsante di sgancio.

### 3 Premi il pulsante attraverso la finestra e gira l'unità in

senso antiorario di 30°.

### 4 Abbassala di circa 8 cm, svita il connettore nella fessura e

togli l'unità tutta intera.
L'anello libera il pulsante solo quando la saracinesca è chiusa, così non cade cibo.
MANUTENZIONE | KIBBLE DISPENSER OUTDOOR

### 26 Kibble Dispenser Outdoor · 0.6.3 bozza

13

### Pulisci il percorso del cibo

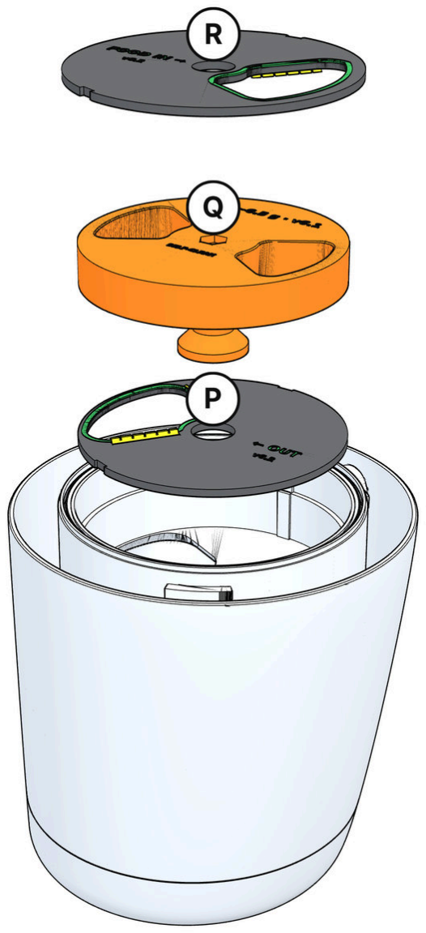
[picture p229: figure]
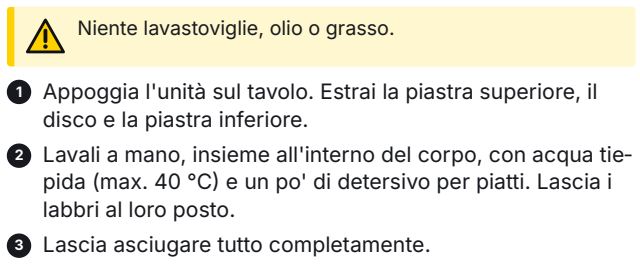
[picture p230: figure]
Niente lavastoviglie, olio o grasso.; disco e la piastra inferiore.; labbri al loro posto. 3 Lascia asciugare tutto completamente.

### 1 Appoggia l'unità sul tavolo. Estrai la piastra superiore, il

### 2 Lavali a mano, insieme all'interno del corpo, con acqua tie‐

pida (max. 40 °C) e un po' di detersivo per piatti. Lascia i

4 Rimonta la piastra inferiore, il disco e la piastra superiore, girando ognuno finché scende al suo posto. Poi ricollega e riaggancia l'unità (passi 7 e 8).
Controllo: Tutto è asciutto prima di rimontarlo.
KIBBLE DISPENSER OUTDOOR | MANUTENZIONE

Solo assistenza: non fa parte dell'uso né della manutenzione
14

### Aprire il fondello (solo assistenza)

Cacciavite Torx T10,
lama lunga

Panno morbido

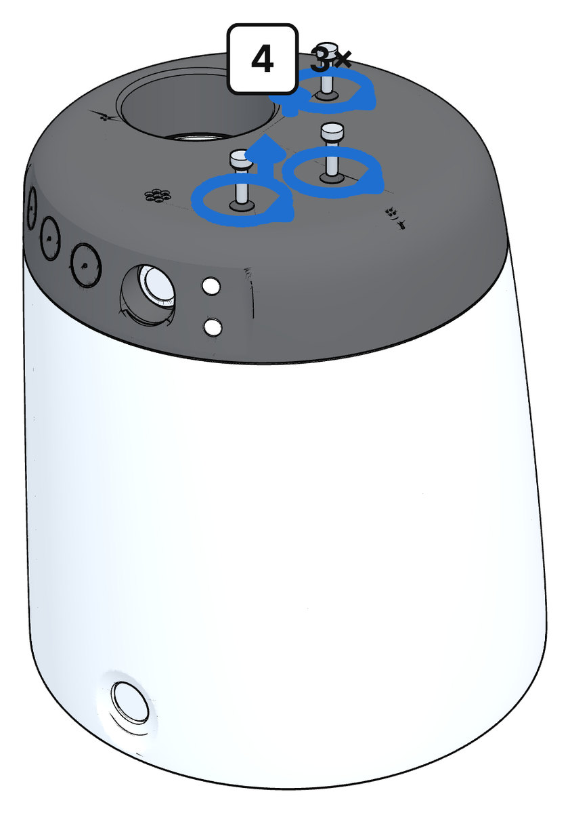
[picture p231: figure]
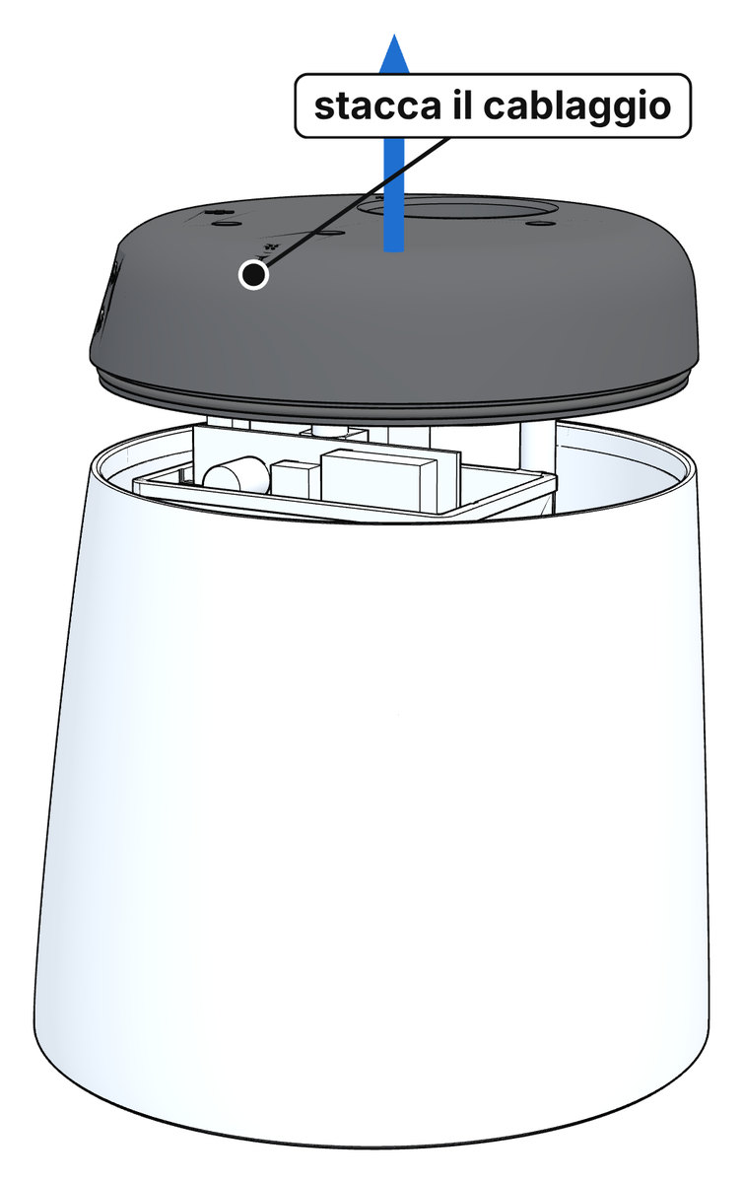
[picture p232: figure]

Prima stacca l'alimentatore. Non tirare via il fondello di colpo: strapperesti il cavo del pannello.

### 1 Solo per riparazioni o se è entrata acqua. Smonta l'unità

(passo 12) e appoggiala capovolta su un panno morbido.

### 2 Svita le 3 viti nel fondo piatto con un cacciavite T10. Con‐

serva le viti e i loro piccoli O-ring.

### 3 Solleva il fondello solo di poco: il pannello comandi è colle‐

gato alla scheda. Stacca il cablaggio del pannello, poi togli il fondello.

### 4 Per chiudere: ricollega il cablaggio, rimetti il fondello e

stringi le 3 viti con i loro O-ring solo a mano.

### 28 Kibble Dispenser Outdoor · 0.6.3 bozza

## Risoluzione dei problemi

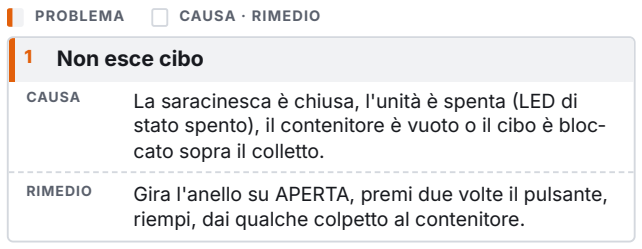
[picture p233: figure]
PROBLEMA; CAUSA · RIMEDIO; 1 Non esce cibo; cato sopra il colletto.

CAUSA | La saracinesca è chiusa, l'unità è spenta (LED di stato spento), il contenitore è vuoto o il cibo è bloc‐
RIMEDIO | Gira l'anello su APERTA, premi due volte il pulsante, riempi, dai qualche colpetto al contenitore.

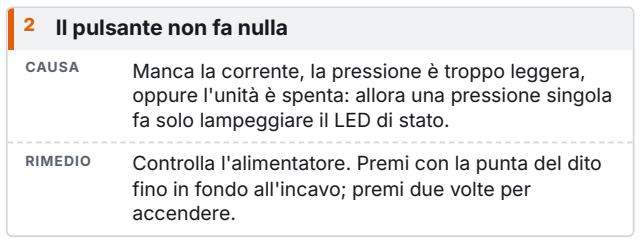
[picture p234: figure]
2 Il pulsante non fa nulla; fa solo lampeggiare il LED di stato.; accendere.

CAUSA | Manca la corrente, la pressione è troppo leggera, oppure l'unità è spenta: allora una pressione singola
RIMEDIO | Controlla l'alimentatore. Premi con la punta del dito fino in fondo all'incavo; premi due volte per

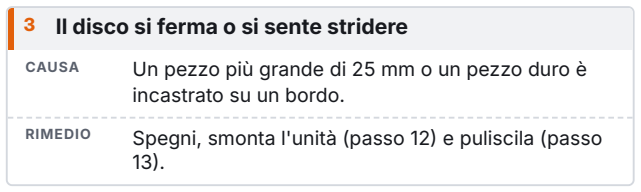
[picture p235: figure]
3 Il disco si ferma o si sente stridere; incastrato su un bordo.

CAUSA | Un pezzo più grande di 25 mm o un pezzo duro è
RIMEDIO | Spegni, smonta l'unità (passo 12) e puliscila (passo
KIBBLE DISPENSER OUTDOOR | RISOLUZIONE DEI PROBLEMI

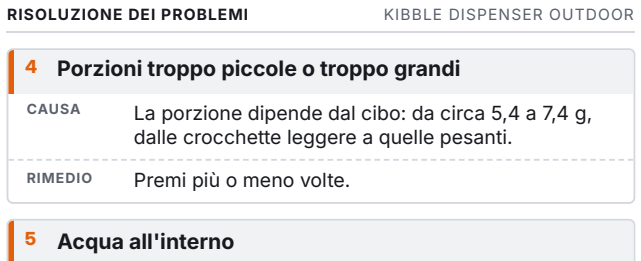
[picture p236: figure]
RIMEDIO; Premi più o meno volte.; 5 Acqua all'interno; RISOLUZIONE DEI PROBLEMI; KIBBLE DISPENSER OUTDOOR

### 4 Porzioni troppo piccole o troppo grandi

CAUSA | La porzione dipende dal cibo: da circa 5,4 a 7,4 g, dalle crocchette leggere a quelle pesanti.

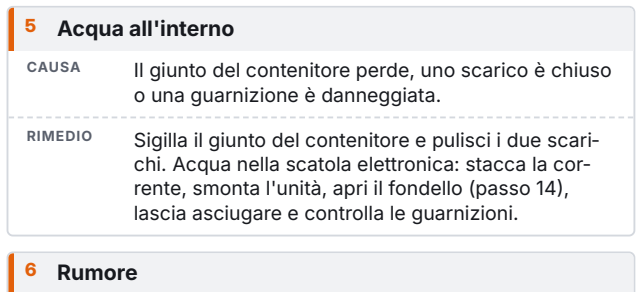
[picture p237: figure]
o una guarnizione è danneggiata.; 6 Rumore

CAUSA | Il giunto del contenitore perde, uno scarico è chiuso
RIMEDIO | Sigilla il giunto del contenitore e pulisci i due scari‐ chi. Acqua nella scatola elettronica: stacca la cor‐ rente, smonta l'unità, apri il fondello (passo 14), lascia asciugare e controlla le guarnizioni.

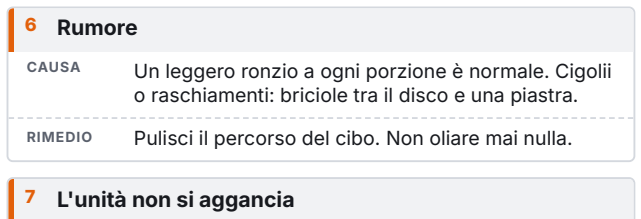
[picture p238: figure]
7 L'unità non si aggancia

CAUSA | Un leggero ronzio a ogni porzione è normale. Cigolii o raschiamenti: briciole tra il disco e una piastra.
RIMEDIO | Pulisci il percorso del cibo. Non oliare mai nulla.

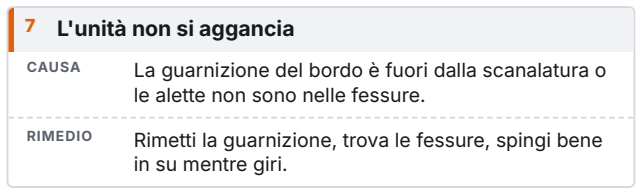
[picture p239: figure]
le alette non sono nelle fessure.; in su mentre giri.

CAUSA | La guarnizione del bordo è fuori dalla scanalatura o
RIMEDIO | Rimetti la guarnizione, trova le fessure, spingi bene

### 30 Kibble Dispenser Outdoor · 0.6.3 bozza

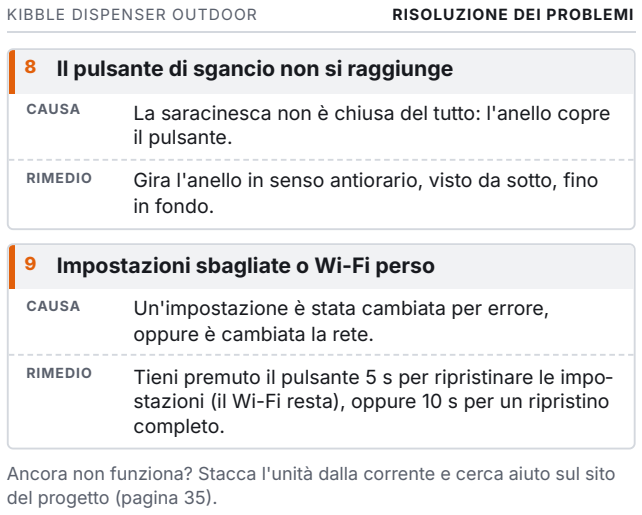
[picture p240: figure]
il pulsante.; in fondo.; 9 Impostazioni sbagliate o Wi-Fi perso; oppure è cambiata la rete.; completo.; del progetto (pagina 35).; KIBBLE DISPENSER OUTDOOR; RISOLUZIONE DEI PROBLEMI

### 8 Il pulsante di sgancio non si raggiunge

CAUSA | La saracinesca non è chiusa del tutto: l'anello copre
RIMEDIO | Gira l'anello in senso antiorario, visto da sotto, fino
CAUSA | Un'impostazione è stata cambiata per errore,
RIMEDIO | Tieni premuto il pulsante 5 s per ripristinare le impo‐ stazioni (il Wi-Fi resta), oppure 10 s per un ripristino

Ancora non funziona? Stacca l'unità dalla corrente e cerca aiuto sul sito

## Datitecnici


Progetto | Kibble Dispenser Outdoor v6.3
Ingombro sotto il ripiano | Ø 180 mm (flangia), alto 182 mm
Peso dell'unità | circa 1,3 kg
Ripiano | in piano, spesso 18–40 mm; un foro Ø 76 mm
Spazio libero | almeno 36 cm sotto il ripiano, Ø 20 cm intorno all'unità
Porzione | circa 6,5 g (disco standard); 5,4–7,4 g secondo il cibo
Dimensione del cibo | cibo secco fino a 25 mm
DATI TECNICI | KIBBLE DISPENSER OUTDOOR

### 32 Kibble Dispenser Outdoor · 0.6.3 bozza

Saracinesca | nella flangia, comandata dall'anello arancione (113°); l'unità si sgancia solo a saracinesca chiusa
Comandi | 1 pulsante IP67 incassato, 2 LED (stato, Wi-Fi), altoparlante
Alimentazione | 12 V DC, alimentatore incluso; connettore M8 IP67 dentro il guscio; il cavo esce dal retro della flangia, con fascetta antistrappo
Protezione dalle intemperie | scatola elettronica progettata per IP66, dentro un guscio esterno sigillato con due scarichi a labirinto a prova di insetti (non ancora provata)
Resistenza | calcolata per 250 N verso il basso e 100 N di lato sul fondo (non ancora provata)
Materiali | PETG, guarnizioni in TPU 95A, O-ring in NBR, viti e spina inox, filetti in ottone, fascetta in PA66 resistente ai raggi UV
Manutenzione | niente grasso, niente gel di silice; il fondello si apre solo per assistenza (3 viti T10)

Tutti i valori sono valori di progetto: nulla è ancora stato stampato o provato.

KIBBLE DISPENSER OUTDOOR | DATI TECNICI

## Ricambi e pezzi stampabili

Ogni pezzo stampato si può ristampare dai file di progetto aperti sul sito del progetto. Viti, O-ring, elettronica e alimenta‐ tore sono pezzi standard da acquistare: la distinta nei file di progetto ne indica il tipo esatto.

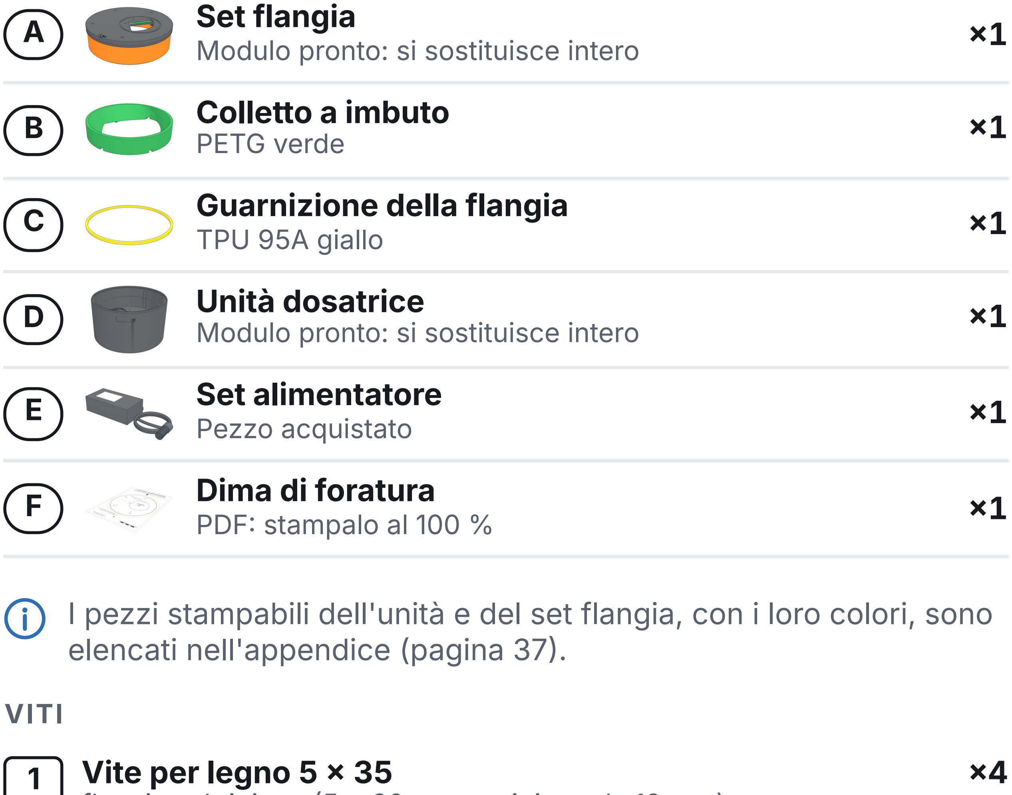
[picture p241: figure]
Set flangia Modulo pronto: si sostituisce intero; B Colletto a imbuto PETG verde; C Guarnizione della flangia TPU 95A giallo; D Unità dosatrice Modulo pronto: si sostituisce intero; Set alimentatore Pezzo acquistato; Dima di foratura PDF: stampalo al 100 %; elencati nell'appendice (pagina 37).; VITI

I pezzi stampabili dell'unità e del set flangia, con i loro colori, sono

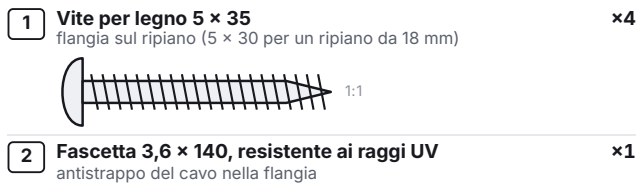
[picture p242: figure]
1 Vite per legno 5 × 35; antistrappo del cavo nella flangia

flangia sul ripiano (5 × 30 per un ripiano da 18 mm)

### 2 Fascetta 3,6 × 140, resistente ai raggi UV

RICAMBI | KIBBLE DISPENSER OUTDOOR

### 34 Kibble Dispenser Outdoor · 0.6.3 bozza

Stampa guarnizioni e labbri in TPU 95A e tutti gli altri pezzi in PETG, nei colori indicati. La scatola elettronica e il suo fondello vanno stampati pieni (riempimento 100 %) per restare stagni; le impostazioni di stampa sono nei file di progetto.

## Smaltimento

Bidone barrato: non gettarlo nei rifiuti domestici.

La scatola elettronica contiene componenti elettronici. Non gettarla nei rifiuti domestici: portala a un punto di raccolta per apparecchiature elettriche ed elettroniche (RAEE). Smaltisci i pezzi in plastica e le viti secondo le regole locali. L'unità non contiene batterie.
Pezzi stampati: PETG e TPU. Molte raccolte domestiche della plastica non li accettano: chiedi al centro di raccolta del tuo comune.

## Open source e licenze

Kibble Dispenser è open source: file di progetto con licenza CERN-OHL-P-2.0, software con licenza MIT, queste istruzioni con licenza CC BY 4.0. © 2026 Enrico Icardi e contributori.

KIBBLE DISPENSER OUTDOOR | RICAMBI

Hardware (file di progetto) | CERN-OHL-P-2.0

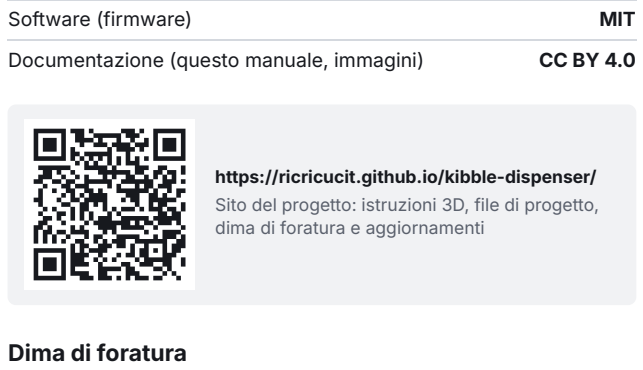
[picture p243: figure]
Software (firmware); MIT; Documentazione (questo manuale, immagini); https://ricricucit.github.io/kibble-dispenser/; dima di foratura e aggiornamenti; Dima di foratura

Sito del progetto: istruzioni 3D, file di progetto,

La dima di foratura in scala 1:1 è un PDF A4 separato (kibble-dispenser-drilling-template.pdf, anche sul sito del progetto). Stampala al 100 % (grandezza reale, senza adattamento) e controlla con un righello la barra da 50 mm. Fissala con il nastro sotto il ripiano con il LATO STAMPATO VERSO DI TE e FRONT verso la stanza.
L'hardware open source è fornito così com'è, senza alcuna garanzia: vedi i testi delle licenze.
LICENZE | KIBBLE DISPENSER OUTDOOR

### 36 Kibble Dispenser Outdoor · 0.6.3 bozza

APPENDICE A

## Costruiscilo da te

Se stampi e costruisci da te l'unità e il set flangia, segui prima questi passi, poi installali come il kit. Le istruzioni 3D online mostrano ogni passo come un'animazione che puoi ruotare e

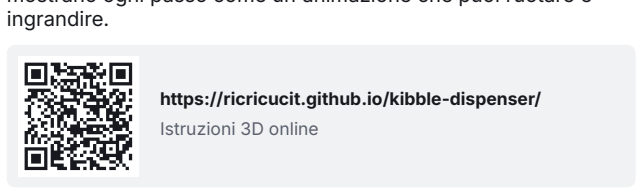
[picture p244: figure]
ingrandire.; https://ricricucit.github.io/kibble-dispenser/ Istruzioni 3D online

Stampa i pezzi come indicato nelle note di stampa del progetto. Poi costruisci da te l'unità e il set flangia.


Pezzi stampati e acquistati
K Corpo dosatore
PETG nero

×1

COSTRUISCILO DA TE | APPENDICE A

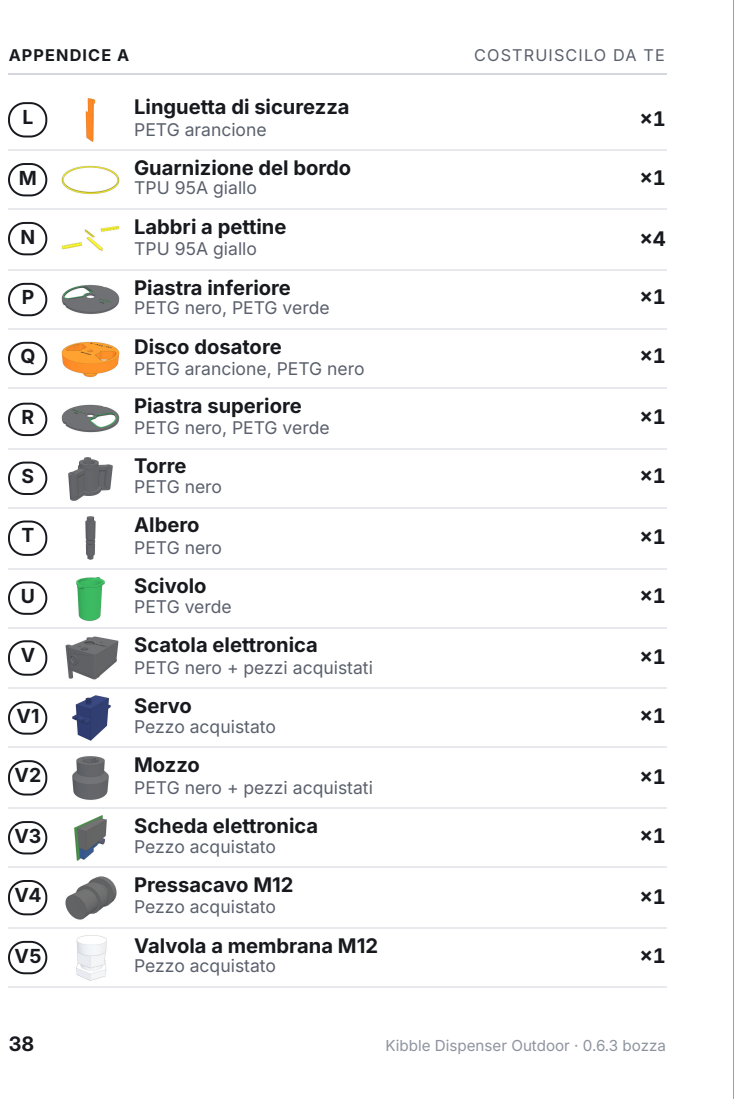
[picture p245: page 38]
T Albero; Mozzo; Valvola a membrana M12; Pezzo acquistato; APPENDICE A; COSTRUISCILO DA TE

Linguetta di sicurezza
PETG arancione
Guarnizione del bordo
TPU 95A giallo
Labbri a pettine
Piastra inferiore
PETG nero, PETG verde
Disco dosatore
PETG arancione, PETG nero
Piastra superiore
Torre
PETG nero

Scivolo
PETG verde
Scatola elettronica
PETG nero + pezzi acquistati
Servo
Pezzo acquistato

Scheda elettronica
Pressacavo M12

38 Kibble Dispenser Outdoor · 0.6.3 bozza

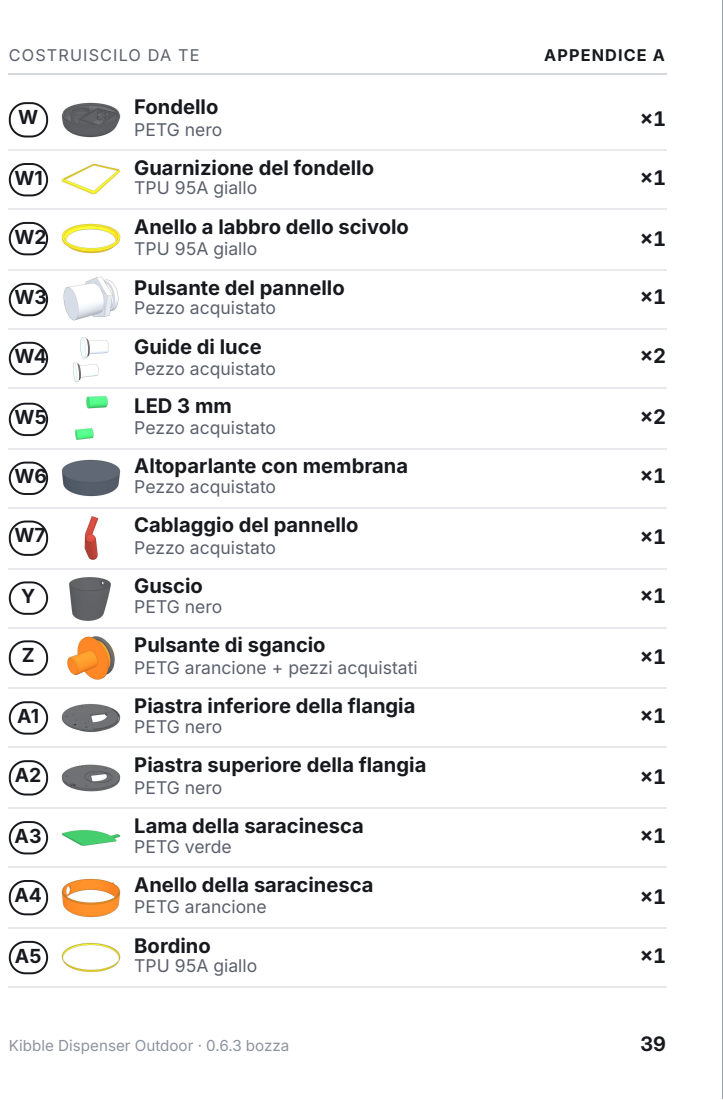
[picture p246: page 39]
W Fondello PETG nero; Guarnizione del fondello; TPU 95A giallo; Anello a labbro dello scivolo; Guide di luce; Pezzo acquistato; LED 3 mm Pezzo acquistato; Altoparlante con membrana; Cablaggio del pannello; Y Guscio; Anello della saracinesca; PETG arancione; Bordino TPU 95A giallo; COSTRUISCILO DA TE; APPENDICE A

TPU 95A giallo
Pulsante del pannello
Pezzo acquistato

PETG nero
Pulsante di sgancio
PETG arancione + pezzi acquistati
Piastra inferiore della flangia
Piastra superiore della flangia
Lama della saracinesca
PETG verde

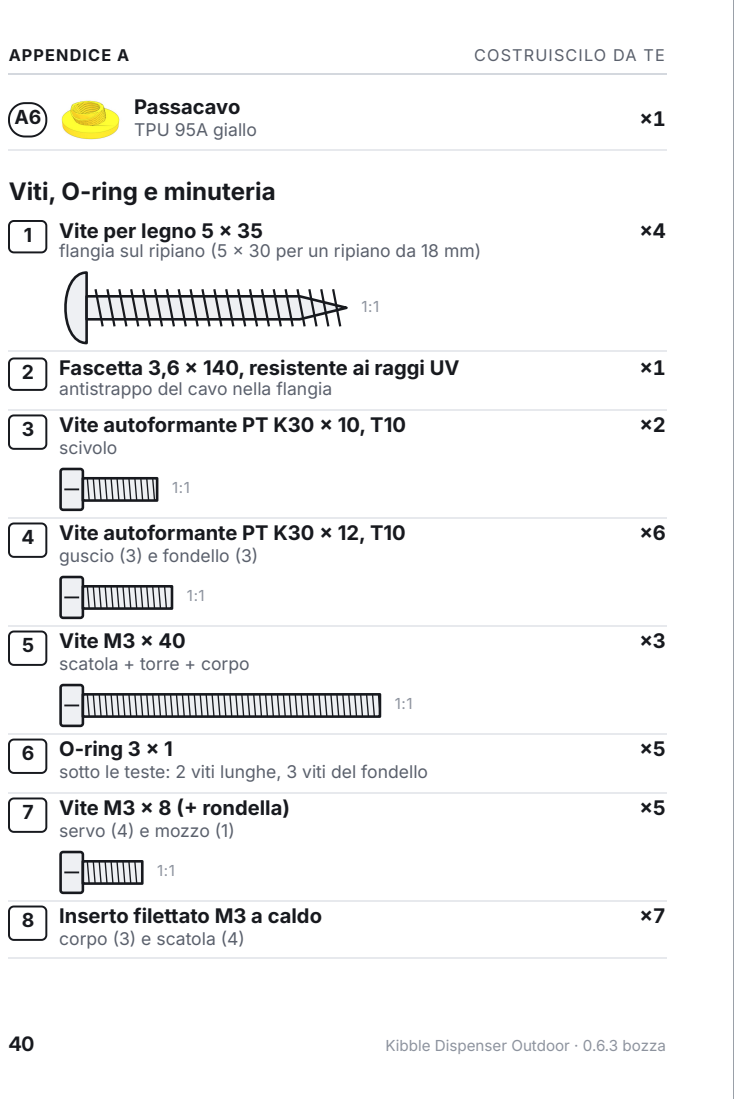
[picture p247: page 40]
Passacavo TPU 95A giallo; APPENDICE A; COSTRUISCILO DA TE

Viti, O-ring e minuteria
1 Vite per legno 5 × 35
flangia sul ripiano (5 × 30 per un ripiano da 18 mm)

2 Fascetta 3,6 × 140, resistente ai raggi UV
antistrappo del cavo nella flangia
3 Vite autoformante PT K30 × 10, T10
scivolo

4 Vite autoformante PT K30 × 12, T10
guscio (3) e fondello (3)

5 Vite M3 × 40
scatola + torre + corpo

6 O-ring 3 × 1
sotto le teste: 2 viti lunghe, 3 viti del fondello
7 Vite M3 × 8 (+ rondella)
servo (4) e mozzo (1)

8 Inserto filettato M3 a caldo
corpo (3) e scatola (4)

40 Kibble Dispenser Outdoor · 0.6.3 bozza

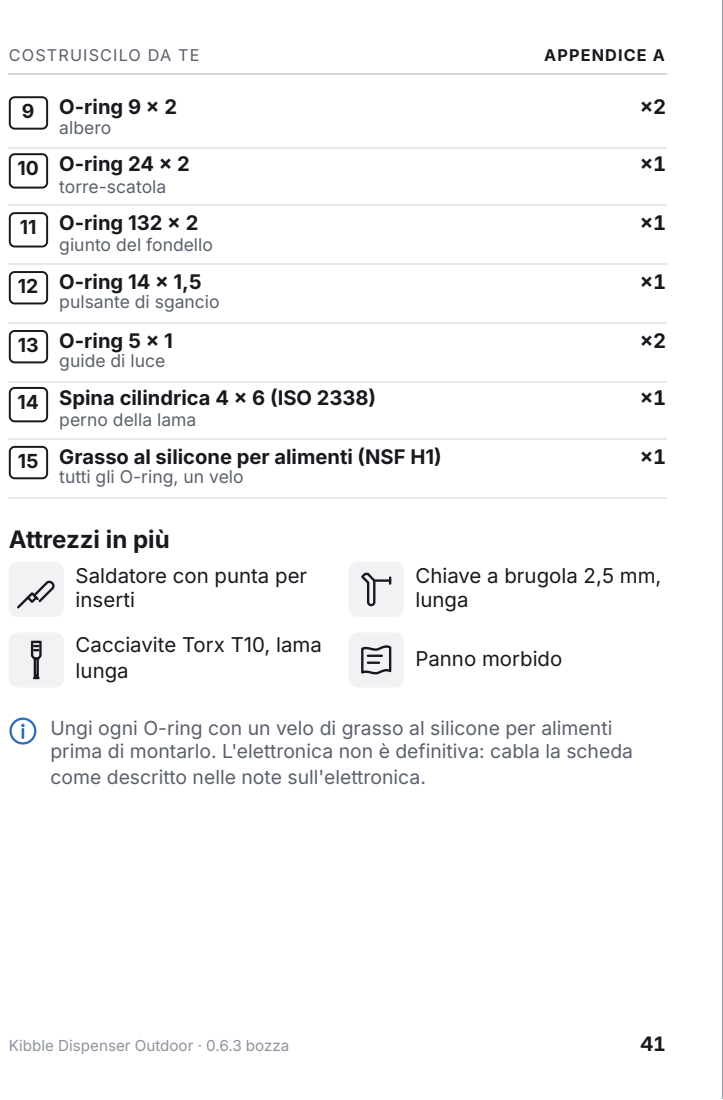
[picture p248: page 41]
Panno morbido; COSTRUISCILO DA TE; APPENDICE A

9 O-ring 9 × 2
albero
10 O-ring 24 × 2
torre-scatola
11 O-ring 132 × 2
giunto del fondello
12 O-ring 14 × 1,5
pulsante di sgancio
13 O-ring 5 × 1
guide di luce
14 Spina cilindrica 4 × 6 (ISO 2338)
perno della lama
15 Grasso al silicone per alimenti (NSF H1)
tutti gli O-ring, un velo

Attrezzi in più
Saldatore con punta per
inserti
Cacciavite Torx T10, lama
lunga

Chiave a brugola 2,5 mm,

Ungi ogni O-ring con un velo di grasso al silicone per alimenti
prima di montarlo. L'elettronica non è definitiva: cabla la scheda
come descritto nelle note sull'elettronica.

A1

### Inserisci gli inserti filettati


La punta del saldatore scotta: lavora su un piano resi‐

### 1 Scalda ogni inserto 8 con il saldatore e spingilo dritto nel

suo foro finché è a filo.

### 2 Corpo K : 3 inserti nel fondo, per le viti lunghe. Scatola

elettronica V : 4 inserti nella culla del servo.

### 3 Lasciali raffreddare prima di avvitarci. Tutte le altre viti si

formano da sole il filetto nella plastica.
Controllo: Ogni inserto è dritto e a filo con la superficie.
APPENDICE A | COSTRUISCILO DA TE

### 42 Kibble Dispenser Outdoor · 0.6.3 bozza

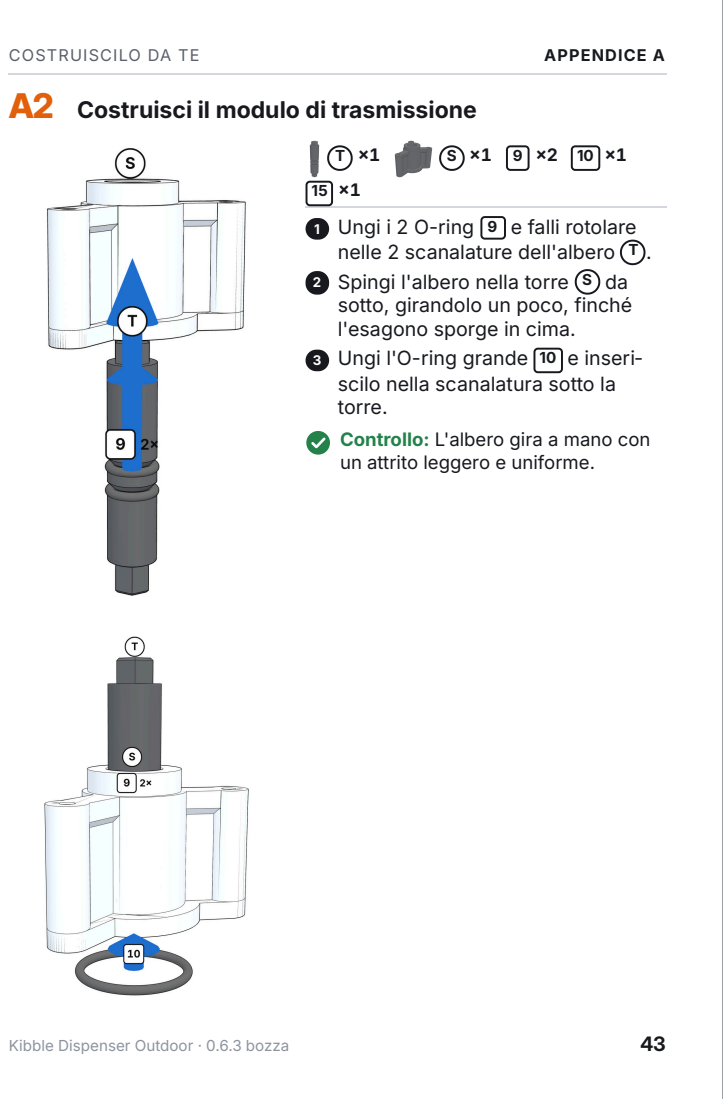
[picture p249: page 43]
COSTRUISCILO DA TE; APPENDICE A

A2 Costruisci il modulo di trasmissione

1 Ungi i 2 O-ring 9 e falli rotolare
nelle 2 scanalature dell'albero T .
2 Spingi l'albero nella torre S da
sotto, girandolo un poco, finché
l'esagono sporge in cima.
3 Ungi l'O-ring grande 10 e inseri‐
scilo nella scanalatura sotto la
torre.
Controllo: L'albero gira a mano con
un attrito leggero e uniforme.

### A3 Allestisci la scatola elettronica

V ×1 | V1 ×1 | V2 ×1 | V3 ×1 | V4 ×1
V5 ×1 | 7 ×5

Chiave a brugola 2,5
mm, lunga

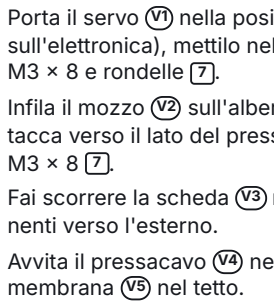
[picture p250: figure]
M3 × 8 e rondelle 7 .; nenti verso l'esterno.; membrana V5 nel tetto.

### 1 Porta il servo V1 nella posizione zero (note

sull'elettronica), mettilo nella culla e fissalo con 4 viti

### 2 Infila il mozzo V2 sull'albero scanalato del servo, con la

tacca verso il lato del pressacavo, e fissalo con 1 vite

### 3 Fai scorrere la scheda V3 nelle sue guide, con i compo‐

### 4 Avvita il pressacavo V4 nella parete laterale e la valvola a

Controllo: La scatola è pulita e asciutta dentro; il cavo corto con la spina esce dal pressacavo.

APPENDICE A | COSTRUISCILO DA TE

### 44 Kibble Dispenser Outdoor · 0.6.3 bozza

### A4 Facoltativo: fori per pulsanti in più

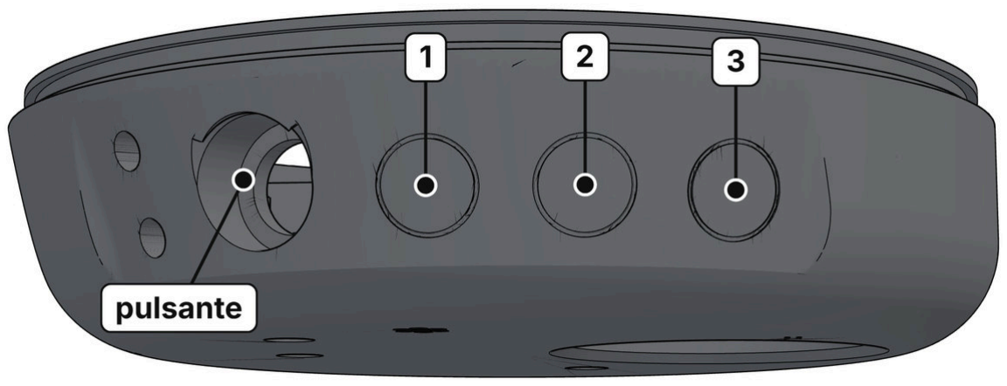
[picture p251: figure]

Solo per costruttori esperti: un foro fatto male fa entrare acqua nella scatola elettronica. Il firmware non usa ancora

1 A destra del pulsante il fondello ha 3 predisposizioni a filo, segnate da un anello inciso e da un punto al centro. Lasciale chiuse se non aggiungi un pulsante.
2 Per aprirne una, appoggia il fondello su un panno morbido. Fai un foro pilota da Ø 3 mm nel punto centrale, perpendi‐ colare alla superficie, poi aprilo da fuori con una punta a gradini fino al gradino da Ø 12.

### 3 Sbava il bordo interno e soffia via i trucioli. Monta un pul‐

sante IP67 da 12 mm (dado fino a 14 mm di chiave) con un filo di silicone neutro sotto la guarnizione.

COSTRUISCILO DA TE | APPENDICE A

### A5 Prepara il fondello e il pannello comandi

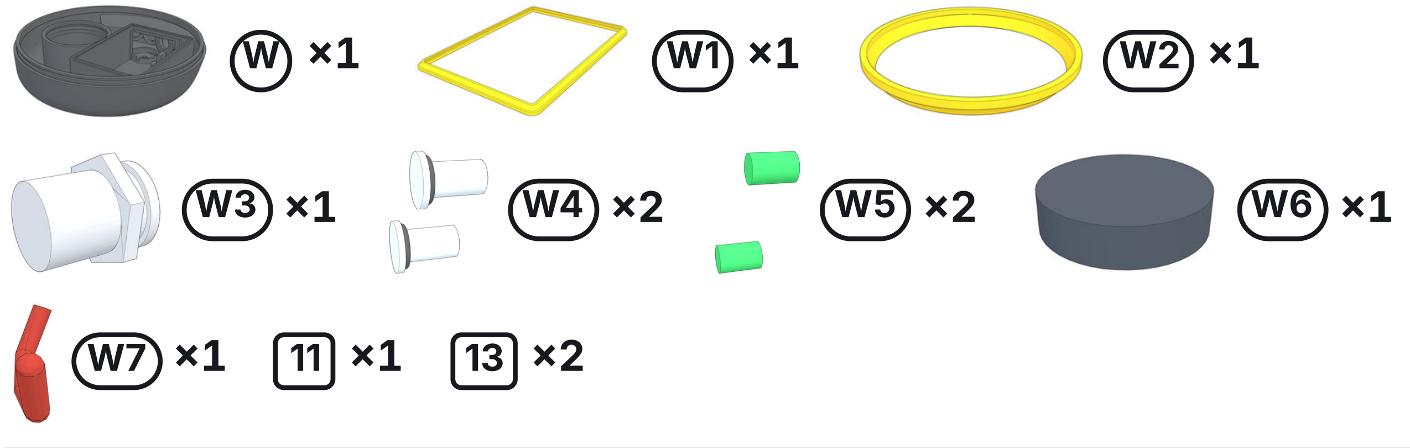
[picture p252: figure]
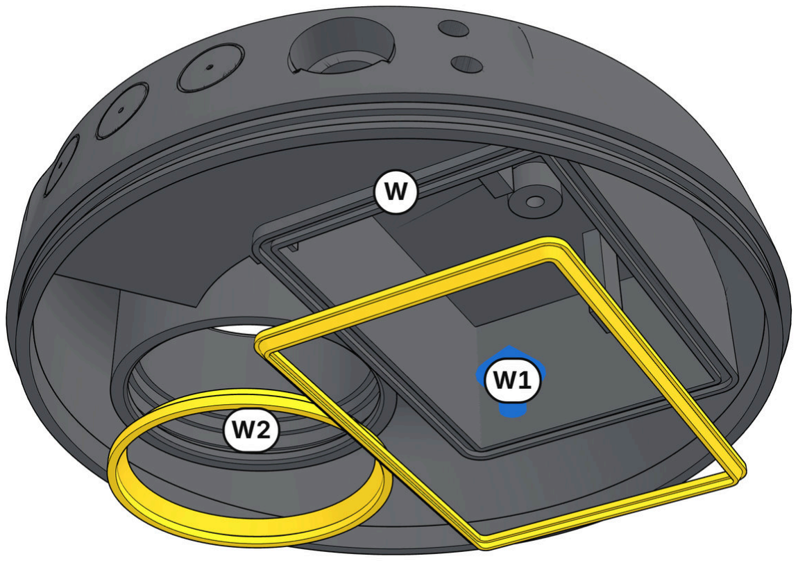
[picture p253: figure]
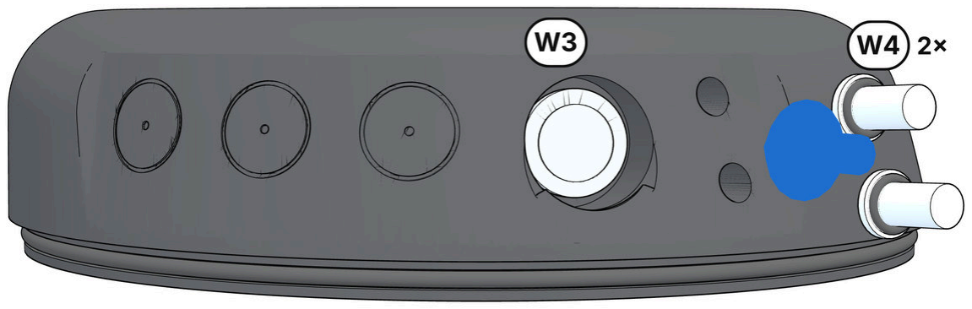
[picture p254: figure]

### 1 Inserisci la guarnizione del fondello W1 nella sua scanala‐

tura a D e l'anello a labbro W2 nella sede tonda. Ungi l'O-ring grande 11 e fallo rotolare nella scanalatura intorno al bordo.

### 2 Da fuori: spingi il pulsante del pannello W3 nel foro incas‐

sato e stringi il suo dado da dentro. Infila le 2 guide di luce W4 con i loro O-ring 13 nei loro fori.

APPENDICE A | COSTRUISCILO DA TE

### 46 Kibble Dispenser Outdoor · 0.6.3 bozza

### A5 Prepara il fondello e il pannello comandi

CONTINUA


### 3 Da dentro: metti i 2 LED W5 dietro le guide di luce (stato in

alto) e l'altoparlante con la sua membrana W6 sulla griglia nel fondo.

### 4 Collega le parti del pannello al cablaggio W7 . La sua spina

va sulla scheda quando chiudi la scatola.
Controllo: Il pulsante fa clic e torna su. La spina del cablaggio pende libera.
COSTRUISCILO DA TE | APPENDICE A

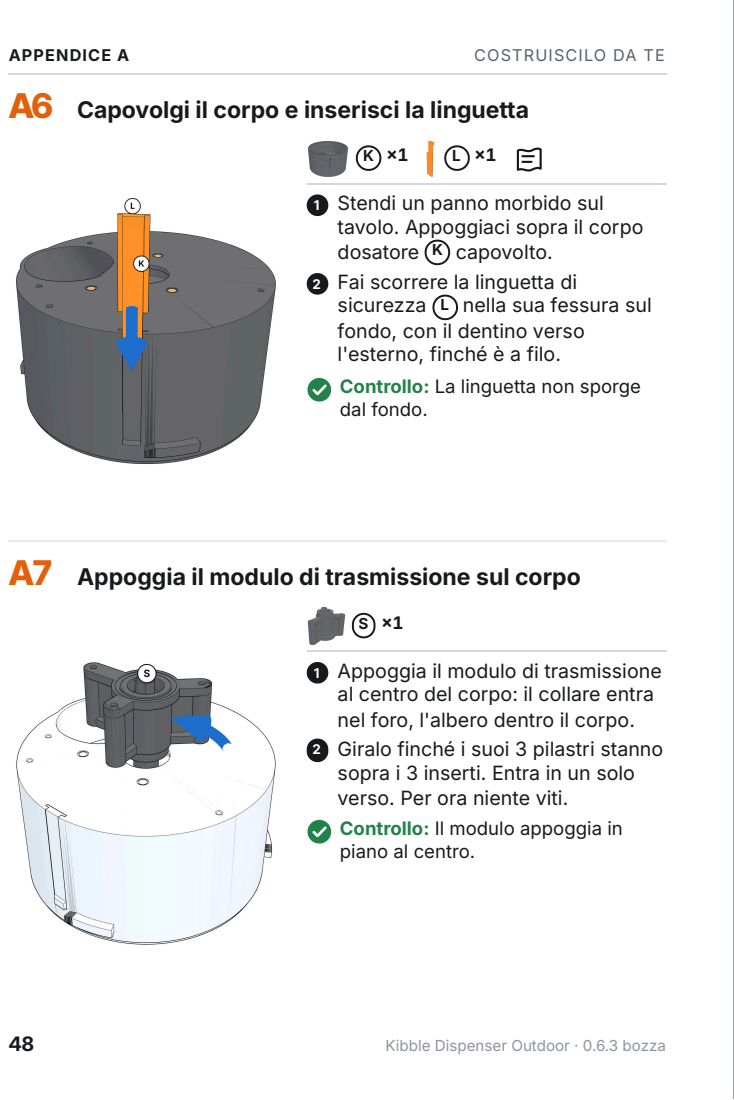
[picture p255: page 48]
APPENDICE A; COSTRUISCILO DA TE

A6 Capovolgi il corpo e inserisci la linguetta

1 Stendi un panno morbido sul
tavolo. Appoggiaci sopra il corpo
dosatore K capovolto.
2 Fai scorrere la linguetta di
sicurezza L nella sua fessura sul
fondo, con il dentino verso
l'esterno, finché è a filo.
Controllo: La linguetta non sporge
dal fondo.

A7 Appoggia il modulo di trasmissione sul corpo

1 Appoggia il modulo di trasmissione
al centro del corpo: il collare entra
nel foro, l'albero dentro il corpo.
2 Giralo finché i suoi 3 pilastri stanno
sopra i 3 inserti. Entra in un solo
verso. Per ora niente viti.
Controllo: Il modulo appoggia in
piano al centro.

48 Kibble Dispenser Outdoor · 0.6.3 bozza

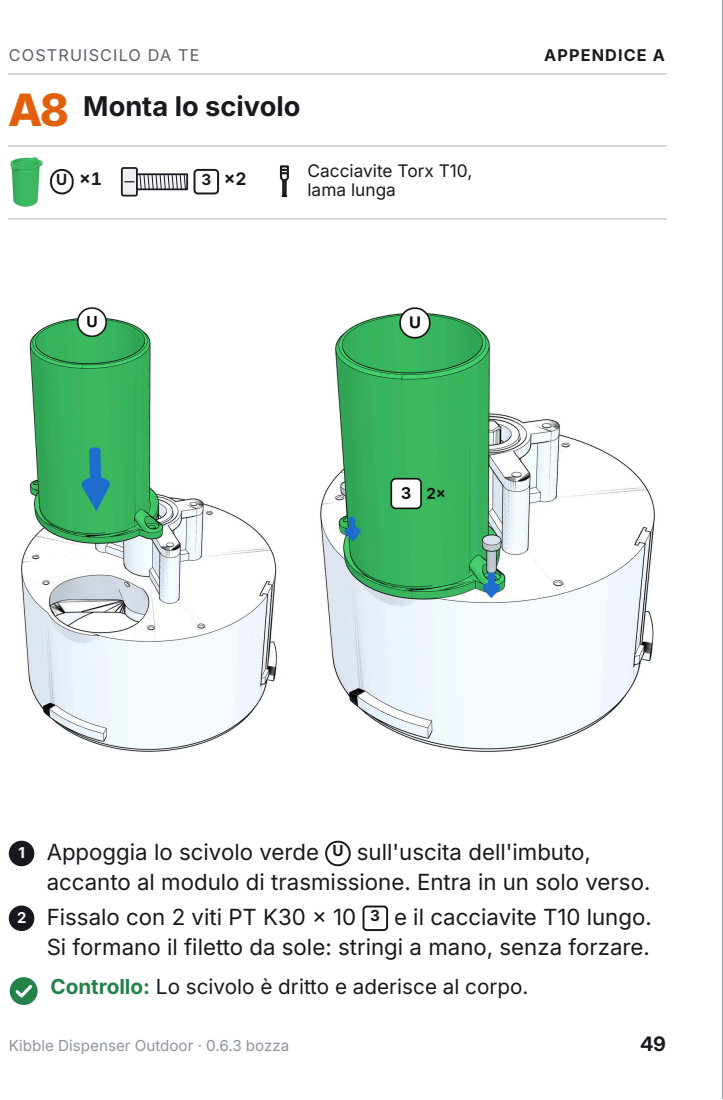
[picture p256: page 49]
Cacciavite Torx T10,; lama lunga; COSTRUISCILO DA TE; APPENDICE A

A8 Monta lo scivolo

1 Appoggia lo scivolo verde U sull'uscita dell'imbuto,
accanto al modulo di trasmissione. Entra in un solo verso.
2 Fissalo con 2 viti PT K30 × 10 3 e il cacciavite T10 lungo.
Si formano il filetto da sole: stringi a mano, senza forzare.
Controllo: Lo scivolo è dritto e aderisce al corpo.

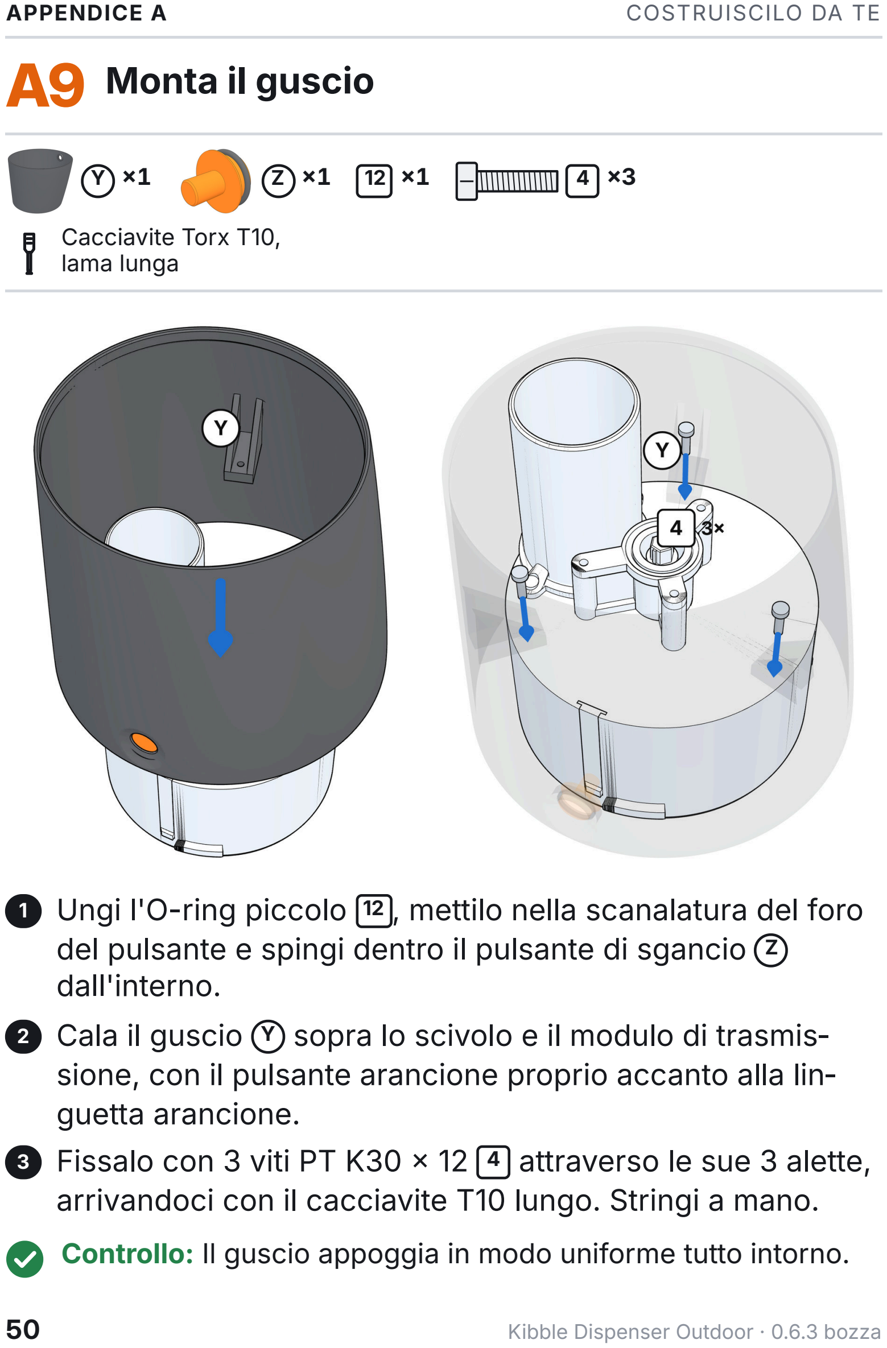
[picture p257: page 50]

### A9 Monta il guscio

Y ×1 | Z ×1 | 12 ×1 | 4 ×3

Cacciavite Torx T10,
lama lunga

### 1 Ungi l'O-ring piccolo 12 , mettilo nella scanalatura del foro

del pulsante e spingi dentro il pulsante di sgancio Z dall'interno.

### 2 Cala il guscio Y sopra lo scivolo e il modulo di trasmis‐

sione, con il pulsante arancione proprio accanto alla lin‐ guetta arancione.
3 Fissalo con 3 viti PT K30 × 12 4 attraverso le sue 3 alette, arrivandoci con il cacciavite T10 lungo. Stringi a mano. Controllo: Il guscio appoggia in modo uniforme tutto intorno.
APPENDICE A | COSTRUISCILO DA TE

### 50 Kibble Dispenser Outdoor · 0.6.3 bozza

### A10 Monta la scatola elettronica

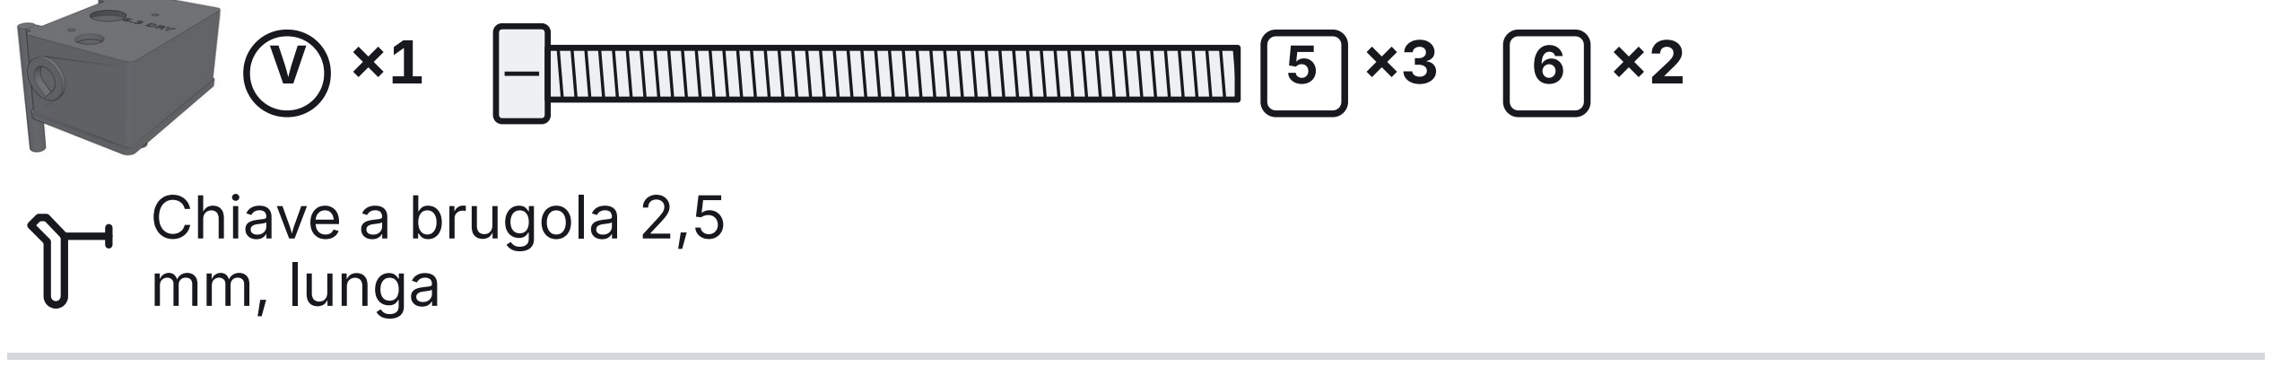
[picture p258: figure]
Chiave a brugola 2,5 mm, lunga
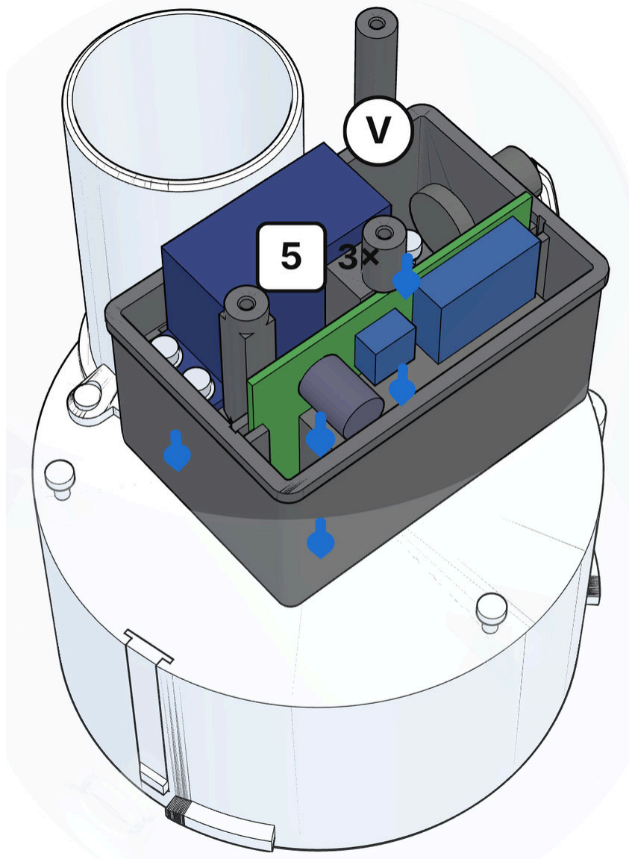
[picture p259: figure]

### 1 Gira l'estremità dell'albero finché la sua piccola nervatura

punta verso la linguetta arancione.

### 2 Cala la scatola V , lato aperto in alto, dentro il guscio sul

modulo di trasmissione: l'albero entra nel mozzo. Entra in un solo verso.

### 3 Metti un O-ring 6 sotto la testa delle 2 viti che stanno

dentro la scatola.

### 4 Avvita le 3 viti lunghe M3 × 40 5 con la chiave a brugola

lunga. Stringi senza forzare.

### 5 Appoggia il cavo corto lungo il corpo, così che la spina

resti appena sotto il bordo del guscio.
Controllo: La scatola appoggia in piano sul modulo, senza fessure.
COSTRUISCILO DA TE | APPENDICE A

### A11 Chiudi la scatola con il fondello

W ×1 | 4 ×3 | 6 ×3 | Cacciavite Torx T10, lama lunga

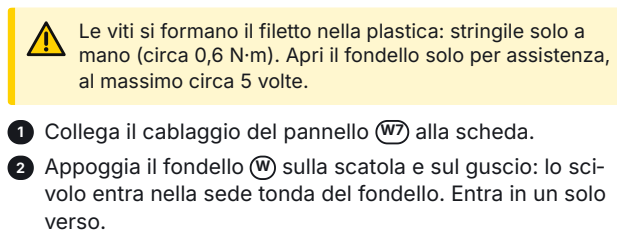
[picture p260: figure]
al massimo circa 5 volte.; verso.

Le viti si formano il filetto nella plastica: stringile solo a mano (circa 0,6 N·m). Apri il fondello solo per assistenza,

1 Collega il cablaggio del pannello W7 alla scheda.

### 2 Appoggia il fondello W sulla scatola e sul guscio: lo sci‐

volo entra nella sede tonda del fondello. Entra in un solo

### 3 Metti un O-ring 6 sotto la testa di ciascuna delle 3 viti PT

K30 × 12 4 . Avvitale dal fondo piatto con il cacciavite T10: tirano il fondello fino in fondo.
Controllo: Il giunto è chiuso tutto intorno. Le 3 teste delle viti stanno a filo nelle loro sedi.
APPENDICE A | COSTRUISCILO DA TE

### 52 Kibble Dispenser Outdoor · 0.6.3 bozza

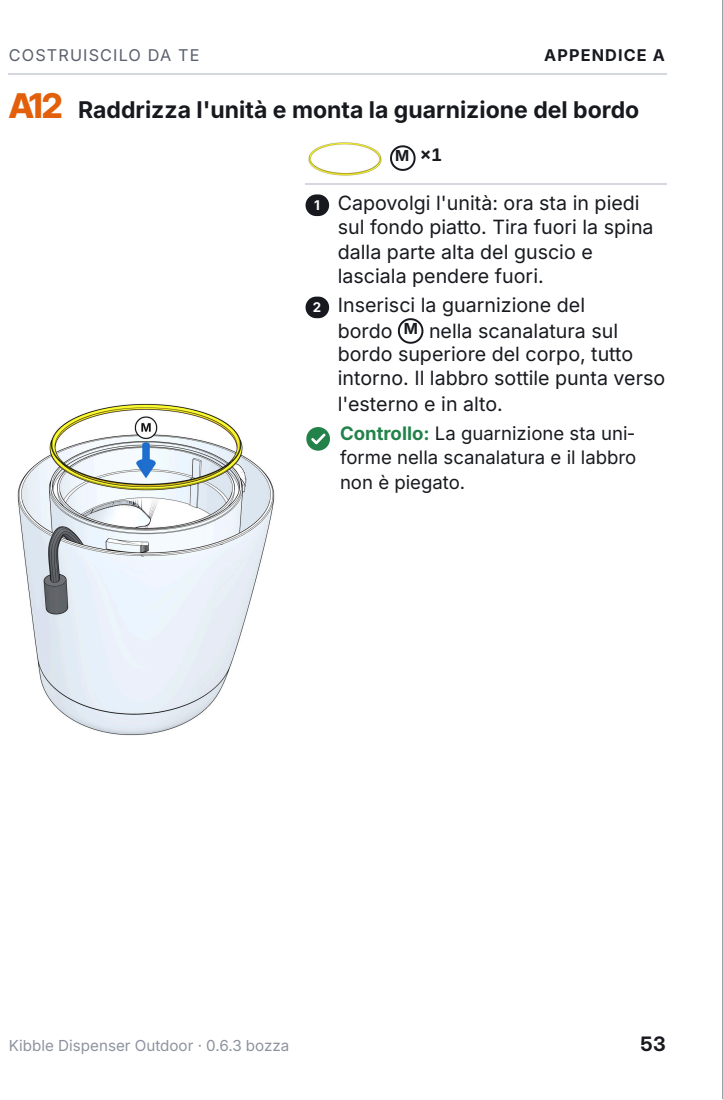
[picture p261: page 53]
COSTRUISCILO DA TE; APPENDICE A

A12 Raddrizza l'unità e monta la guarnizione del bordo

1 Capovolgi l'unità: ora sta in piedi
sul fondo piatto. Tira fuori la spina
dalla parte alta del guscio e
lasciala pendere fuori.
2 Inserisci la guarnizione del
bordo M nella scanalatura sul
bordo superiore del corpo, tutto
intorno. Il labbro sottile punta verso
l'esterno e in alto.
Controllo: La guarnizione sta uni‐
forme nella scanalatura e il labbro
non è piegato.

### A13 Inserisci i labbri nelle piastre

N ×4 | P ×1 | R ×1

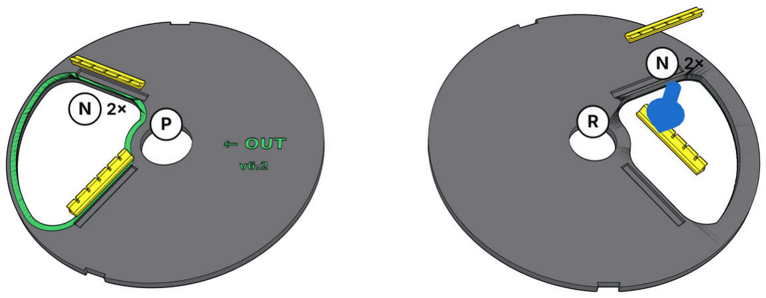
[picture p262: figure]

### 1 I 4 labbri a pettine N sono tutti uguali. Ognuno entra in

entrambi i versi.

### 2 Piastra inferiore P , scritta OUT: inserisci 2 labbri nelle 2

scanalature sopra, lungo l'apertura.

### 3 Piastra superiore R , scritta FOOD IN: girala e inserisci gli

altri 2 labbri nelle scanalature sotto.

### 4 L'aletta morbida inclinata di ogni labbro pende verso

l'apertura.
Controllo: I labbri sono inseriti a fondo e stanno dritti in modo uniforme.
APPENDICE A | COSTRUISCILO DA TE

### 54 Kibble Dispenser Outdoor · 0.6.3 bozza

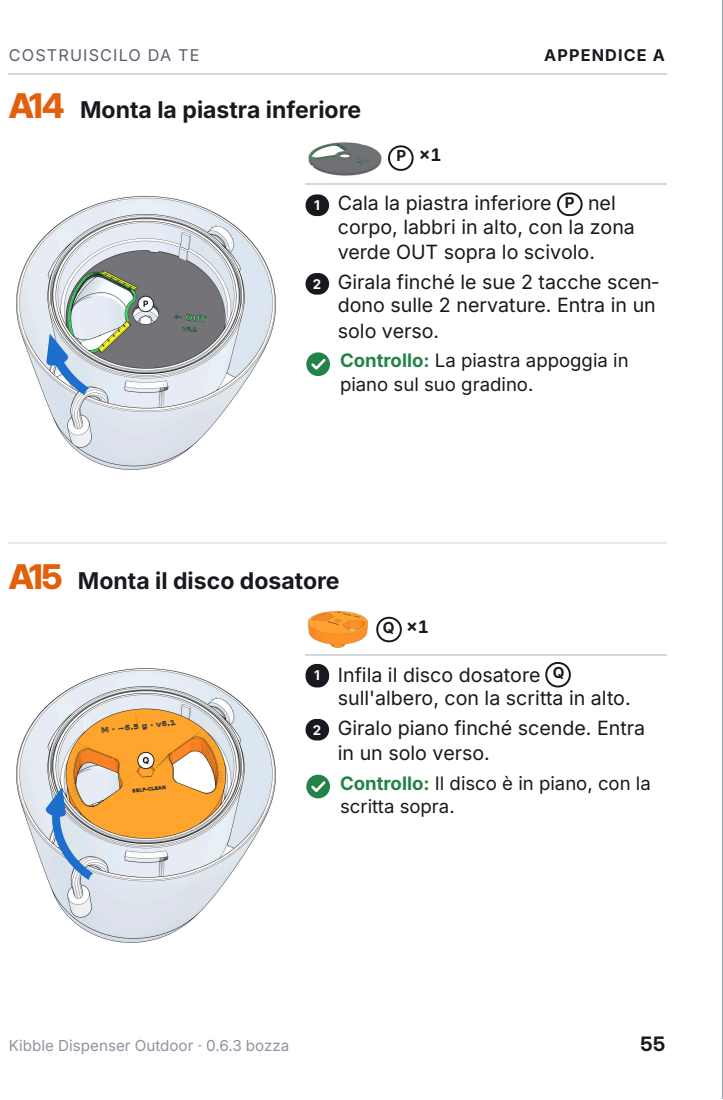
[picture p263: page 55]
COSTRUISCILO DA TE; APPENDICE A

A14 Monta la piastra inferiore

1 Cala la piastra inferiore P nel
corpo, labbri in alto, con la zona
verde OUT sopra lo scivolo.
2 Girala finché le sue 2 tacche scen‐
dono sulle 2 nervature. Entra in un
solo verso.
Controllo: La piastra appoggia in
piano sul suo gradino.

A15 Monta il disco dosatore

1 Infila il disco dosatore Q
sull'albero, con la scritta in alto.
2 Giralo piano finché scende. Entra
in un solo verso.
Controllo: Il disco è in piano, con la
scritta sopra.

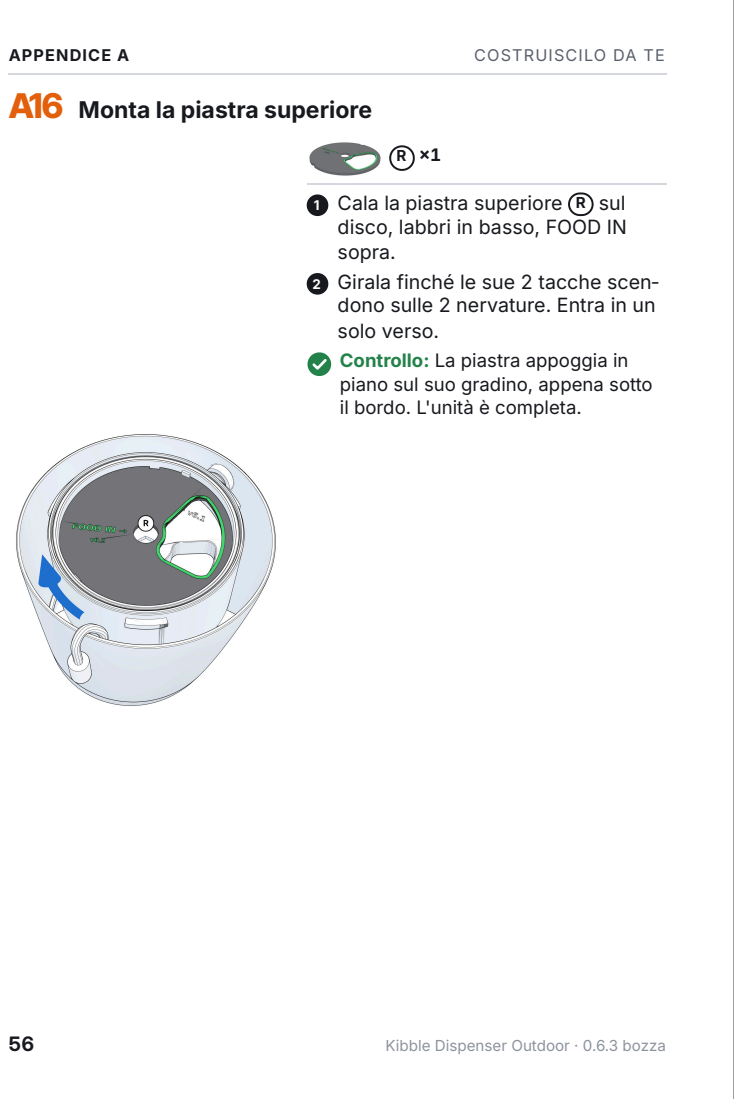
[picture p264: page 56]
APPENDICE A; COSTRUISCILO DA TE

A16 Monta la piastra superiore

1 Cala la piastra superiore R sul
disco, labbri in basso, FOOD IN
sopra.
2 Girala finché le sue 2 tacche scen‐
dono sulle 2 nervature. Entra in un
solo verso.
Controllo: La piastra appoggia in
piano sul suo gradino, appena sotto
il bordo. L'unità è completa.

56 Kibble Dispenser Outdoor · 0.6.3 bozza

### A17 Costruisci il set flangia

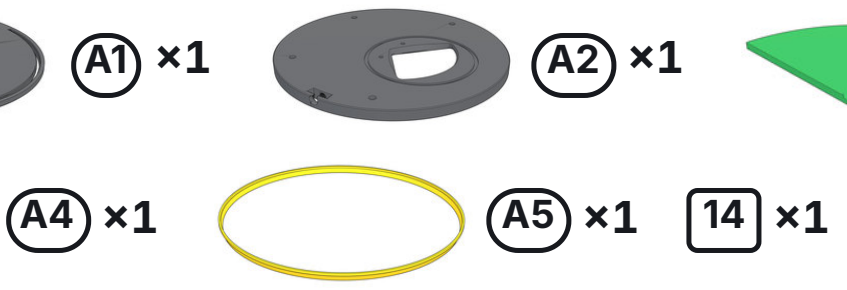
[picture p265: figure]

A1 ×1 | A2 ×1 | A3 ×1


### 1 Tieni la piastra inferiore della flangia A1 con i 3 ganci

verso il basso. Inserisci il bordino A5 nella scanalatura sotto e aggancia a scatto l'anello arancione A4 da sotto.

### 2 Spingi la spina 14 nel foro centrale e infilaci la lama della

saracinesca A3 , con il foro del braccio sul perno dell'anello.

### 3 Appoggia la piastra superiore A2 e premila giù: i suoi 3

perni entrano nella piastra inferiore e tengono unito il set.

### 4 Il passacavo A6 va sul cavo di alimentazione: lo monti con

il cavo quando fissi la flangia (passo 4).
Controllo: Girando l'anello la lama passa da APERTA a CHIUSA.
L'unità e il set flangia sono pronti. Ora installali come il kit: continua con il passo 1, pagina 10.
COSTRUISCILO DA TE | APPENDICE A

APPENDICE B

## Prova ditenuta a casa

Facoltativa, per chi costruisce: un controllo delle guarni‐ zioni, non una certificazione.

### 1 Togli l'elettronica dalla scatola, oppure fai la prova prima di

montarla. Mai con la corrente collegata.

### 2 Metti strisce di carta da cucina asciutta nella scatola (al

pressacavo, alla valvola, alle 2 teste di vite nel tetto, lungo la guarnizione del fondello) e nel fondello dietro il pannello di comando (pulsante, guide di luce, altoparlante), più qualcuna dentro il guscio, una vicino al passacavo sotto la flangia.

### 3 Chiudi il fondello con le sue 3 viti e gli O-ring e appendi

l'unità al suo set flangia sotto un ripiano o un'asse, come nell'uso, con la saracinesca APERTA.

### 4 Spruzzala con una canna da giardino e una lancia a getto

(circa 6 mm, circa 12,5 l/min: un secchio da 10 l si riempie in 48 s) da 2,5–3 m, da tutti i lati e da sotto, per 3–4 minuti. Spruzza anche il pannello di comando.

### 5 Asciuga l'esterno, smonta l'unità e apri il fondello sopra un

asciugamano, sollevandolo solo un poco per via del cavo del pannello.

Controllo: Strisce asciutte nella scatola: prova superata. Una striscia bagnata indica dove entra l'acqua.
Per un controllo più fine pesa una bustina di gel di silice da 10 g con una bilancia da 0,01 g e mettila nella scatola: se aumenta meno di 0,05 g, non è entrata acqua.
APPENDICE B | PROVA DI TENUTA A CASA

### 58 Kibble Dispenser Outdoor · 0.6.3 bozza

## Note

KIBBLE DISPENSER OUTDOOR | NOTE

## Kibble Dispenser Outdoor

Manuale d'uso · Italiano

https://ricricucit.github.io/kibble-dispenser/ Inquadra per le istruzioni 3D e i file di progetto

### 0.6.3 bozza · progetto v6.3

Provvisorio: non ancora stampato né provato
Testi e immagini CC BY 4.0 · hardware CERN-OHL-P-2.0 · software MIT © 2026 Enrico Icardi e contributori
