ricricucit/kibble-dispenser/docs/manual/kibble-dispenser-manual-de.pdf

DE DEUTSCH

# Kibble Dispenser Outdoor

### Bedienungsanleitung

Montage, Bedienung und Wartung


0.6.3 Entwurf | Konstruktion v6.3

Vorläufig: noch nicht gedruckt oder getestet

## Inhalt

Sicherheitshinweise | 3
Lieferumfang | 7
Benötigtes Werkzeug | 9
Installation | 10
Brett vorbereiten | 10
Einhängen und anschließen | 17
Erste Inbetriebnahme | 22
Bedienung im Alltag | 24
Wartung | 26
Fehlersuche | 32
Technische Daten | 35
Ersatzteile und druckbare Teile | 37
Entsorgung | 38
Open Source und Lizenzen | 38
Anhang A · Selbst bauen | 40
Anhang B · Dichtheitstest zu Hause | 62
Notizen | 63
INHALT | KIBBLE DISPENSER OUTDOOR

### 2 Kibble Dispenser Outdoor · 0.6.3 Entwurf

## Sicherheitshinweise

Lesen Sie diese Anleitung vor Montage und Gebrauch und bewahren Sie sie auf. Geben Sie die Einheit nur zusammen mit der Anleitung weiter.

Symbole in dieser Anleitung
Warnung: Gefahr von Verletzungen oder Schäden. Vor dem Weitermachen lesen.
Prüfen: Stellen Sie das sicher, bevor Sie weitermachen. Hinweis: nützliche Information.

A Teilebuchstabe wie im Lieferumfang.

1 Schraubennummer wie im Schraubenbeutel.

Bestimmungsgemäße Verwendung
Der Kibble Dispenser Outdoor gibt Trockenfutter für Haus‐ tiere aus einem Futterbehälter aus, der über ihm auf einem Brett steht, auf Knopfdruck jeweils eine Portion.
Verwenden Sie ihn nur für Trockenfutter mit Stücken bis 25 mm. Er ist nicht für Nassfutter, Flüssigkeiten oder ande‐ res gedacht.
Montieren Sie ihn unter einem Brett oder einer Tischplatte, drinnen oder im Freien unter einem Dach.
Er ersetzt nicht Ihre Fürsorge: Prüfen Sie jeden Tag, ob Ihr Tier frisst und ob Futter kommt.
KIBBLE DISPENSER OUTDOOR | SICHERHEIT
Kibble Dispenser Outdoor · 0.6.3 Entwurf | 3

Elektrische Sicherheit

Bewegliche Teile

Dies ist eine vorläufige Open-Source-Konstruktion: Es wurde noch keine Einheit gedruckt oder getestet. Testen Sie sie einige Tage unter Aufsicht, bevor Sie sich darauf verlassen.

Die Einheit arbeitet mit Schutzkleinspannung (12 V DC). Ver‐ wenden Sie nur das Netzteil aus dem Lieferumfang.
Das Netzteil ist nicht wasserdicht: Stellen Sie es an einen trockenen, regengeschützten Platz. Halten Sie Netzstecker und Steckdose trocken und verlegen Sie das Netzkabel mit einer Tropfschlaufe.
Verwenden Sie die Einheit nicht, wenn ein Kabel, das Netz‐ teil oder das Gehäuse beschädigt ist.
Ziehen Sie das Netzteil aus der Steckdose, bevor Sie die Einheit abnehmen, öffnen oder reinigen.

Greifen Sie nie in den Auslauf, die Rutsche oder das Loch im Brett, solange die Einheit am Strom ist: Die Dosierscheibe dreht sich, wenn die Taste gedrückt wird, und kann sich kurz in ihre Ruhestellung bewegen, sobald Strom anliegt. Schalten Sie die Einheit aus und trennen Sie sie vom Strom, bevor Sie eine Verstopfung beseitigen.

SICHERHEIT | KIBBLE DISPENSER OUTDOOR

### 4 Kibble Dispenser Outdoor · 0.6.3 Entwurf

Der Schieber

Kinder und Tiere

Im Freien

Drehen Sie den orangefarbenen Ring immer auf ZU, bevor Sie die Einheit abnehmen und sobald der Futterbehälter ent‐ fernt wird: Sonst fällt Futter aus dem Loch im Brett.
Halten Sie rund um die Einheit einen Kreis von 20 cm frei, damit Sie den Ring mit der Hand erreichen.

Dies ist kein Spielzeug. Lassen Sie Kinder nicht mit der Ein‐ heit, ihrer Taste oder der Verpackung spielen.
Verlegen Sie das Kabel und stellen Sie das Netzteil so auf, dass Tiere nicht daran nagen können.
Lassen Sie Tiere nicht auf die Einheit klettern, sich daran hängen oder damit spielen.

Montieren Sie die Einheit im Freien nur unter einem Dach, geschützt vor Schlagregen und fern von Rasensprengern. Spritzen Sie sie nie mit einem Schlauch oder Hochdruckrei‐ niger ab.
Vermeiden Sie ganztägig pralle Sonne: Hitze lässt das Futter schneller verderben.
Dichten Sie die Verbindung zwischen Futterbehälter und Brett ab, damit kein Regen ins Futter gelangt.
KIBBLE DISPENSER OUTDOOR | SICHERHEIT

Futterhygiene

Bei der Montage

Verwenden Sie nur frisches, einwandfreies Trockenfutter. Werfen Sie feuchtes, schimmeliges oder schlecht riechen‐ des Futter weg.
Reinigen Sie den Futterweg alle paar Monate und bei jedem Futterwechsel (Seite 26).
Die gedruckten Teile haben feine Rillen, in denen sich Krümel sammeln können, und sie sind nicht als Lebensmit‐ telkontaktmaterial zertifiziert.
Waschen Sie die Teile nur von Hand bei höchstens 40 °C. Keine Spülmaschine.

Tragen Sie beim Bohren eine Schutzbrille.
Das Brett muss den vollen Behälter tragen: 200 Liter Tro‐ ckenfutter wiegen etwa 80 kg.
Achten Sie darauf, dass an der Bohrstelle keine Kabel oder Rohre verlaufen.
Verwenden Sie nur das 12-V-Netzteil aus dem Bausatz. Halten Sie Netzstecker und Steckdose trocken.
Halten Sie Kleinteile von Kindern und Tieren fern.
SICHERHEIT | KIBBLE DISPENSER OUTDOOR

### 6 Kibble Dispenser Outdoor · 0.6.3 Entwurf

## Lieferumfang

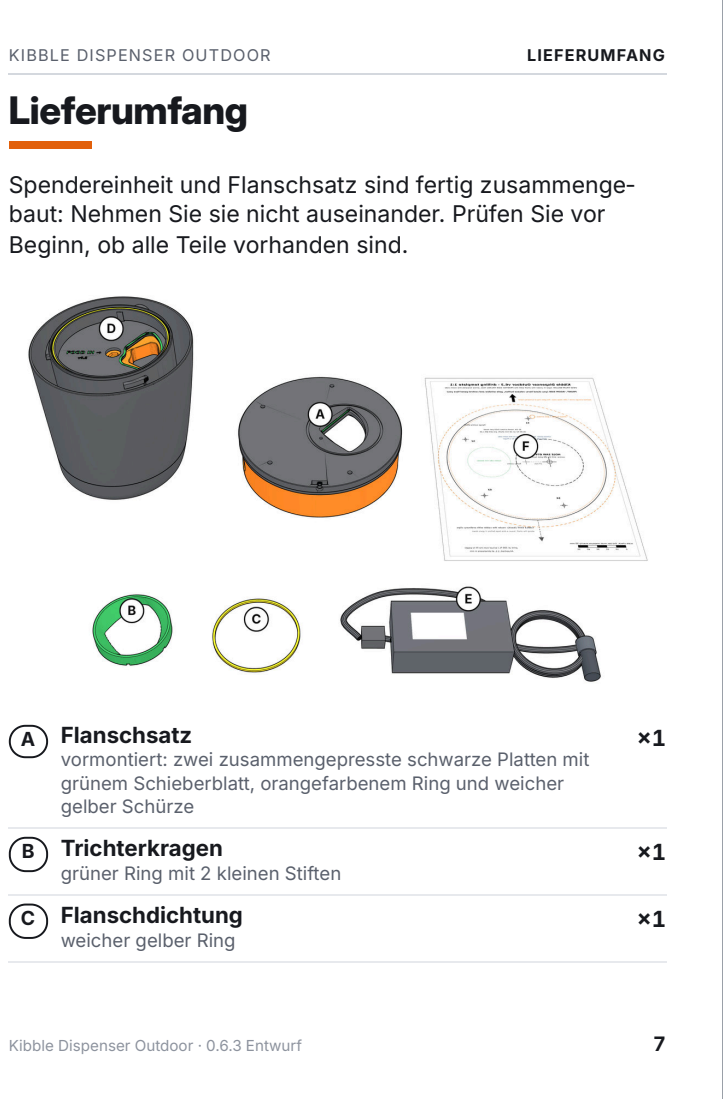
[picture p270: page 7]
KIBBLE DISPENSER OUTDOOR; LIEFERUMFANG

Spendereinheit und Flanschsatz sind fertig zusammenge‐
baut: Nehmen Sie sie nicht auseinander. Prüfen Sie vor
Beginn, ob alle Teile vorhanden sind.

A Flanschsatz
vormontiert: zwei zusammengepresste schwarze Platten mit
grünem Schieberblatt, orangefarbenem Ring und weicher
gelber Schürze
B Trichterkragen
grüner Ring mit 2 kleinen Stiften
C Flanschdichtung
weicher gelber Ring

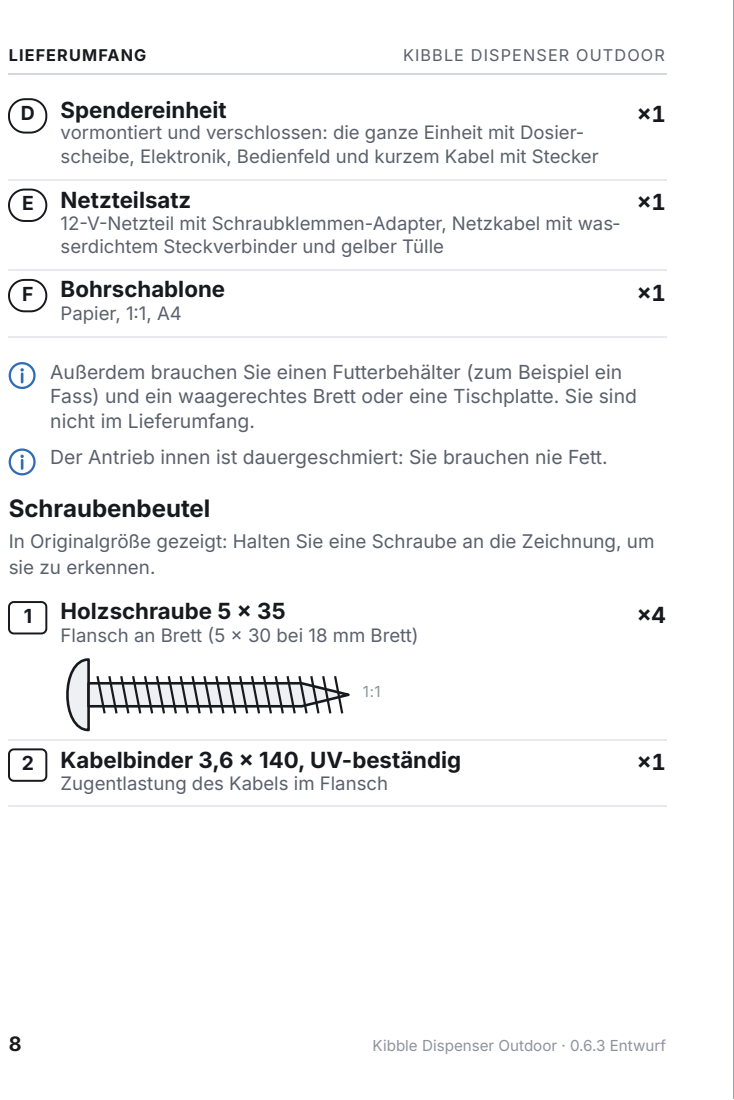
[picture p271: page 8]
LIEFERUMFANG; KIBBLE DISPENSER OUTDOOR

D Spendereinheit
vormontiert und verschlossen: die ganze Einheit mit Dosier‐
scheibe, Elektronik, Bedienfeld und kurzem Kabel mit Stecker
E Netzteilsatz
12-V-Netzteil mit Schraubklemmen-Adapter, Netzkabel mit was‐
serdichtem Steckverbinder und gelber Tülle
F Bohrschablone
Papier, 1:1, A4

Außerdem brauchen Sie einen Futterbehälter (zum Beispiel ein
Fass) und ein waagerechtes Brett oder eine Tischplatte. Sie sind
nicht im Lieferumfang.
Der Antrieb innen ist dauergeschmiert: Sie brauchen nie Fett.
Schraubenbeutel
In Originalgröße gezeigt: Halten Sie eine Schraube an die Zeichnung, um
sie zu erkennen.
1 Holzschraube 5 × 35
Flansch an Brett (5 × 30 bei 18 mm Brett)

2 Kabelbinder 3,6 × 140, UV-beständig
Zugentlastung des Kabels im Flansch

8 Kibble Dispenser Outdoor · 0.6.3 Entwurf

## Benötigtes Werkzeug

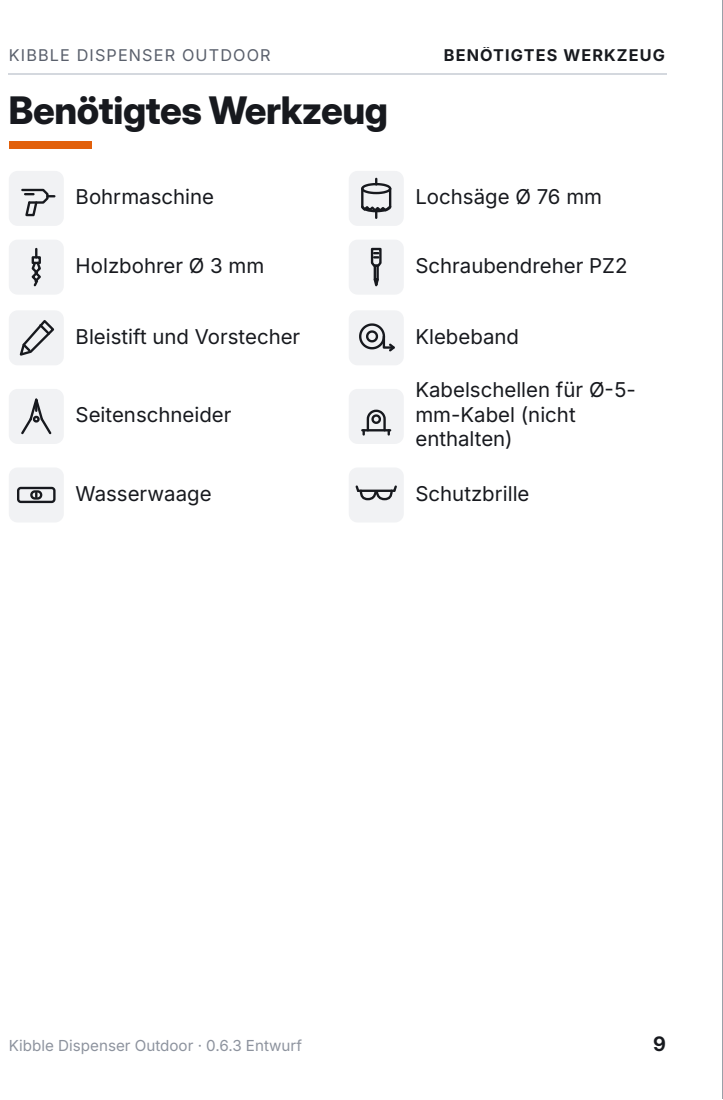
[picture p272: page 9]
Bohrmaschine; Lochsäge Ø 76 mm; Holzbohrer Ø 3 mm; Schraubendreher PZ2; Bleistift und Vorstecher; Klebeband; Seitenschneider; Wasserwaage; Schutzbrille; KIBBLE DISPENSER OUTDOOR; BENÖTIGTES WERKZEUG

Kabelschellen für Ø-5-
mm-Kabel (nicht
enthalten)

## Installation

1

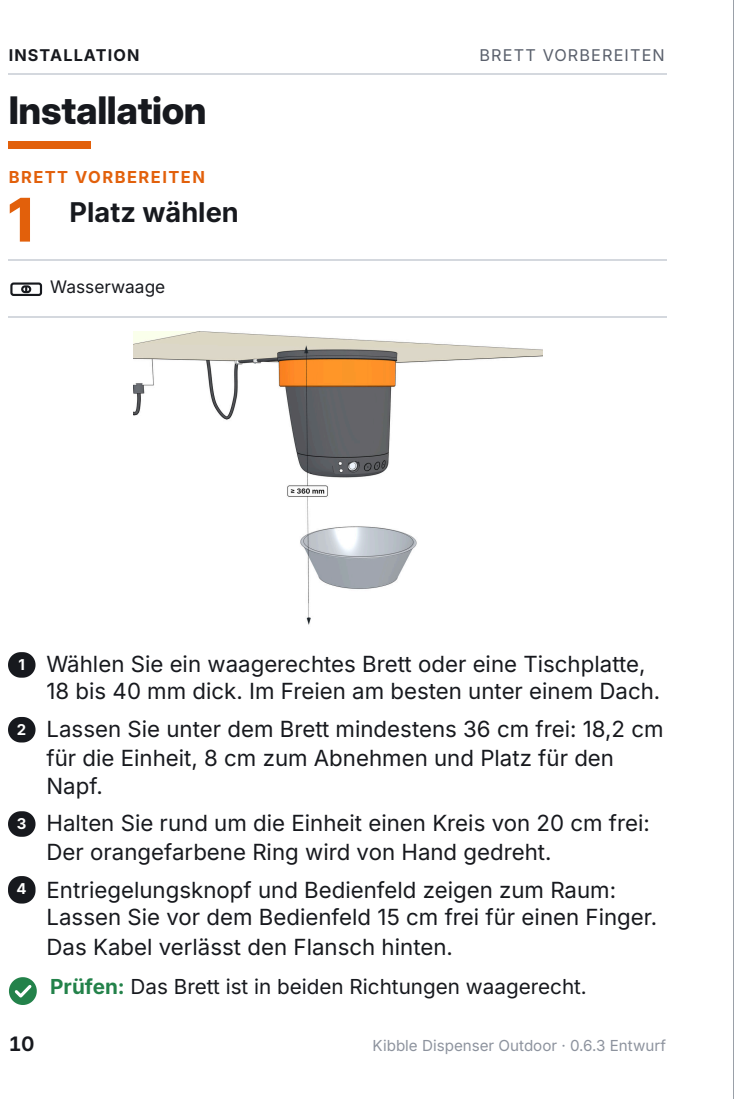
[picture p273: page 10]
BRETT VORBEREITEN Platz wählen; Wasserwaage; INSTALLATION; BRETT VORBEREITEN

1 Wählen Sie ein waagerechtes Brett oder eine Tischplatte,
18 bis 40 mm dick. Im Freien am besten unter einem Dach.
2 Lassen Sie unter dem Brett mindestens 36 cm frei: 18,2 cm
für die Einheit, 8 cm zum Abnehmen und Platz für den
Napf.
3 Halten Sie rund um die Einheit einen Kreis von 20 cm frei:
Der orangefarbene Ring wird von Hand gedreht.
4 Entriegelungsknopf und Bedienfeld zeigen zum Raum:
Lassen Sie vor dem Bedienfeld 15 cm frei für einen Finger.
Das Kabel verlässt den Flansch hinten.
Prüfen: Das Brett ist in beiden Richtungen waagerecht.

10 Kibble Dispenser Outdoor · 0.6.3 Entwurf

2

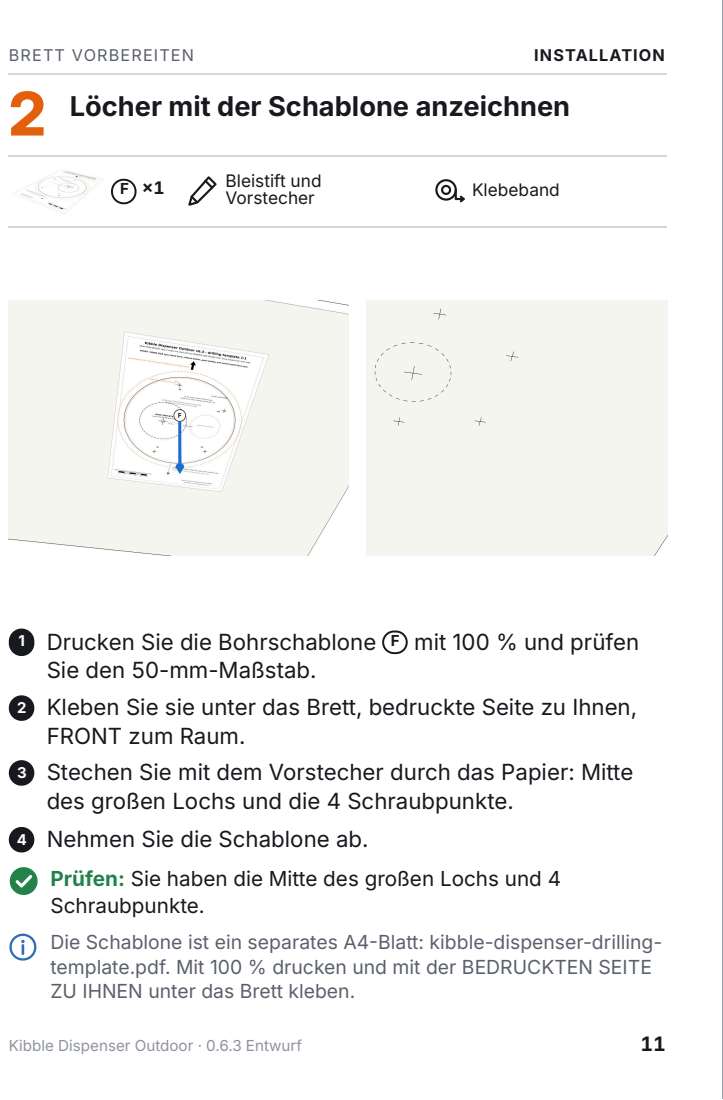
[picture p274: page 11]
Bleistift und Vorstecher; Klebeband; BRETT VORBEREITEN; INSTALLATION

Löcher mit der Schablone anzeichnen

1 Drucken Sie die Bohrschablone F mit 100 % und prüfen
Sie den 50-mm-Maßstab.
2 Kleben Sie sie unter das Brett, bedruckte Seite zu Ihnen,
FRONT zum Raum.
3 Stechen Sie mit dem Vorstecher durch das Papier: Mitte
des großen Lochs und die 4 Schraubpunkte.
4 Nehmen Sie die Schablone ab.
Prüfen: Sie haben die Mitte des großen Lochs und 4
Schraubpunkte.
Die Schablone ist ein separates A4-Blatt: kibble-dispenser-drilling-
template.pdf. Mit 100 % drucken und mit der BEDRUCKTEN SEITE
ZU IHNEN unter das Brett kleben.

3

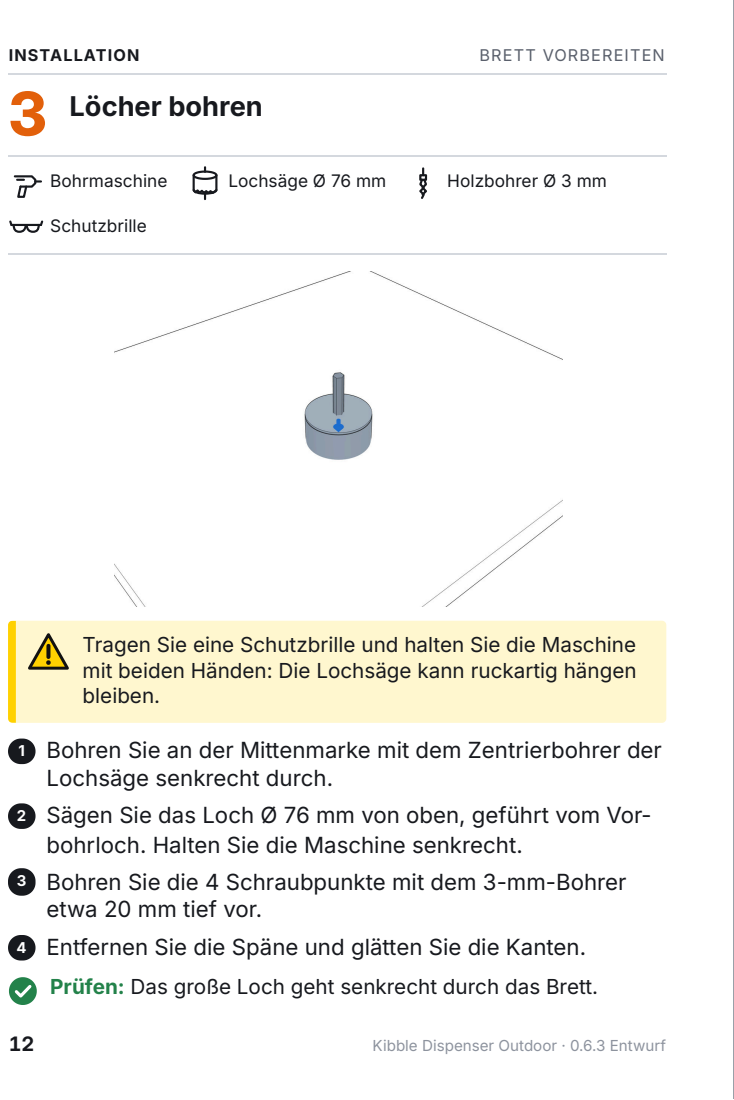
[picture p275: page 12]
Löcher bohren; Bohrmaschine; Lochsäge Ø 76 mm; Holzbohrer Ø 3 mm; Schutzbrille; INSTALLATION; BRETT VORBEREITEN

Tragen Sie eine Schutzbrille und halten Sie die Maschine
mit beiden Händen: Die Lochsäge kann ruckartig hängen
bleiben.

1 Bohren Sie an der Mittenmarke mit dem Zentrierbohrer der
Lochsäge senkrecht durch.
2 Sägen Sie das Loch Ø 76 mm von oben, geführt vom Vor‐
bohrloch. Halten Sie die Maschine senkrecht.
3 Bohren Sie die 4 Schraubpunkte mit dem 3-mm-Bohrer
etwa 20 mm tief vor.
4 Entfernen Sie die Späne und glätten Sie die Kanten.
Prüfen: Das große Loch geht senkrecht durch das Brett.

12 Kibble Dispenser Outdoor · 0.6.3 Entwurf

### 4 Flanschsatz montieren

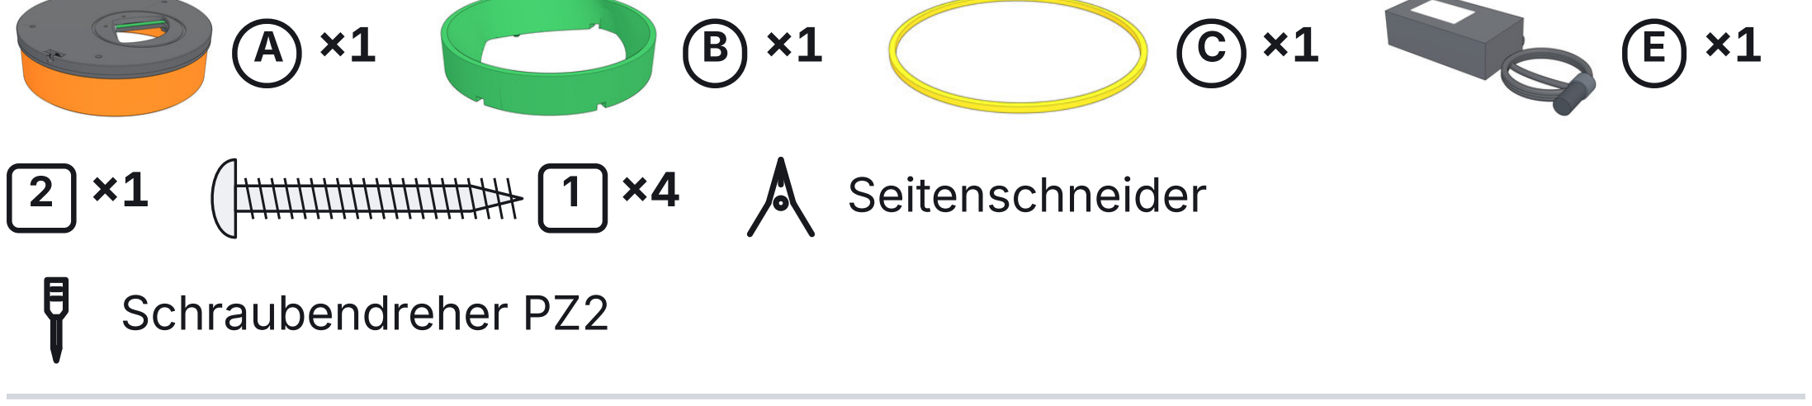
[picture p276: figure]
Seitenschneider; Schraubendreher PZ2
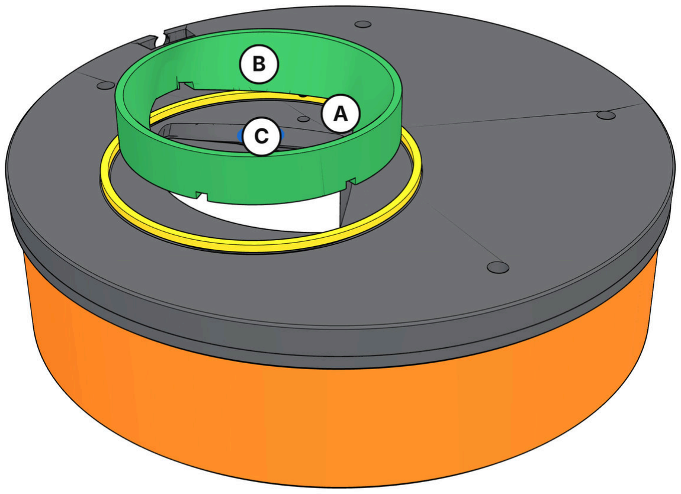
[picture p277: figure]
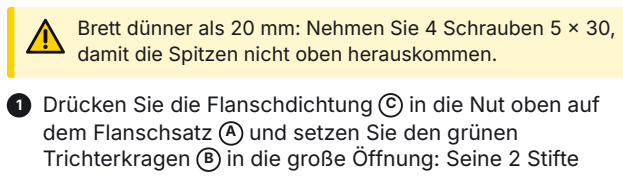
[picture p278: figure]

Brett dünner als 20 mm: Nehmen Sie 4 Schrauben 5 × 30, damit die Spitzen nicht oben herauskommen.

### 1 Drücken Sie die Flanschdichtung C in die Nut oben auf

dem Flanschsatz A und setzen Sie den grünen Trichterkragen B in die große Öffnung: Seine 2 Stifte kommen in die 2 kleinen Löcher.

### 2 Schieben Sie das freie Ende des Netzkabels aus dem

Netzteilsatz E in das kleine Loch innen im Flansch, bis es hinten am Rand herauskommt. Drücken Sie die gelbe Tülle in das Loch: Der Steckverbinder hängt darunter.

### 3 Ziehen Sie das Kabel von außen leicht straff. Ziehen Sie im

kleinen Fenster oben im Flansch den Kabelbinder 2 fest um das Kabel und schneiden Sie das Ende ab.

BRETT VORBEREITEN | INSTALLATION

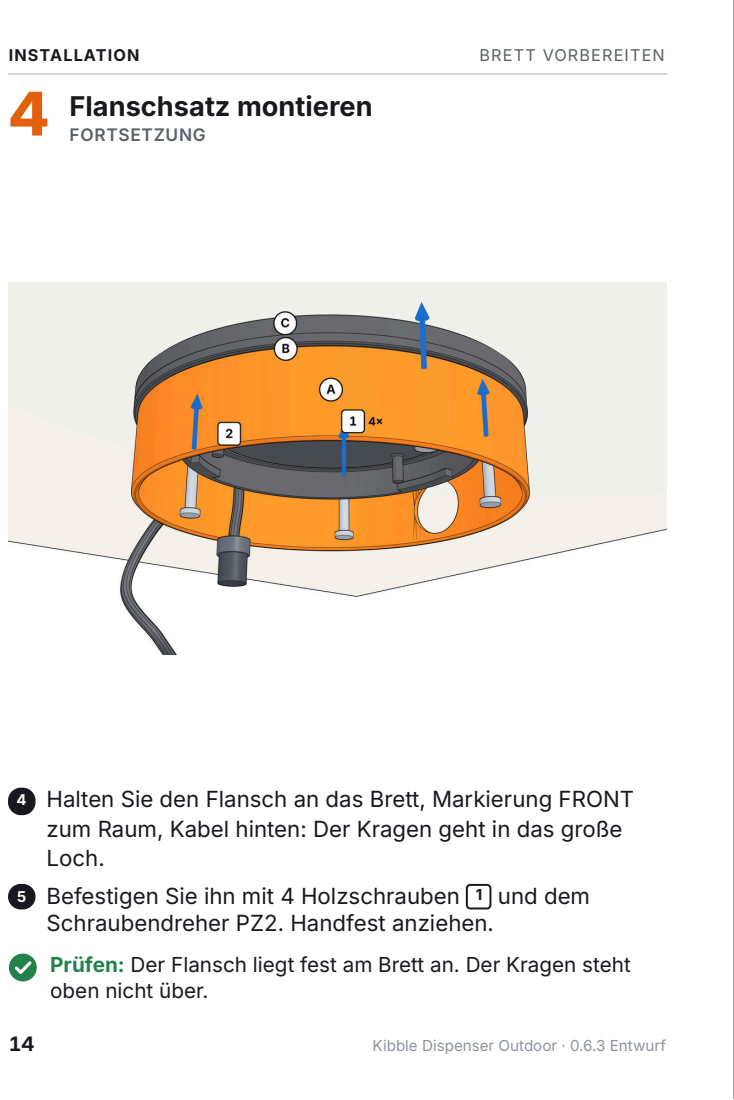
[picture p279: page 14]
4 Flanschsatz montieren; FORTSETZUNG; INSTALLATION; BRETT VORBEREITEN

4 Halten Sie den Flansch an das Brett, Markierung FRONT
zum Raum, Kabel hinten: Der Kragen geht in das große
Loch.
5 Befestigen Sie ihn mit 4 Holzschrauben 1 und dem
Schraubendreher PZ2. Handfest anziehen.
Prüfen: Der Flansch liegt fest am Brett an. Der Kragen steht
oben nicht über.

14 Kibble Dispenser Outdoor · 0.6.3 Entwurf

5

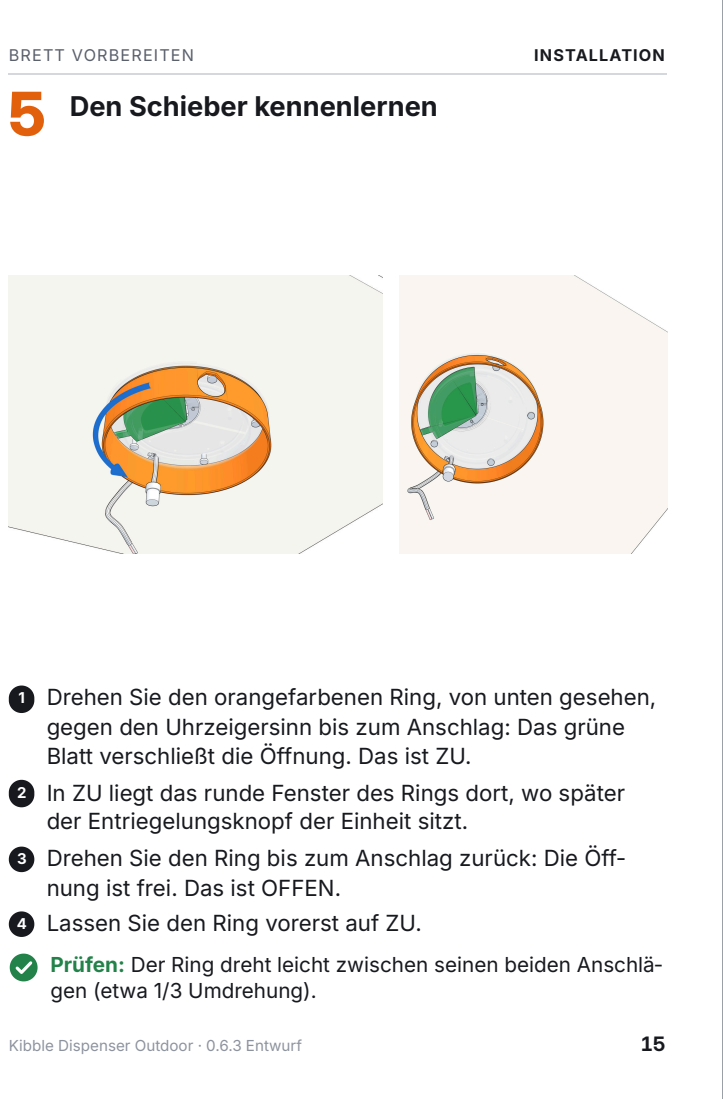
[picture p280: page 15]
BRETT VORBEREITEN; INSTALLATION

Den Schieber kennenlernen

1 Drehen Sie den orangefarbenen Ring, von unten gesehen,
gegen den Uhrzeigersinn bis zum Anschlag: Das grüne
Blatt verschließt die Öffnung. Das ist ZU.
2 In ZU liegt das runde Fenster des Rings dort, wo später
der Entriegelungsknopf der Einheit sitzt.
3 Drehen Sie den Ring bis zum Anschlag zurück: Die Öff‐
nung ist frei. Das ist OFFEN.
4 Lassen Sie den Ring vorerst auf ZU.
Prüfen: Der Ring dreht leicht zwischen seinen beiden Anschlä‐
gen (etwa 1/3 Umdrehung).

6

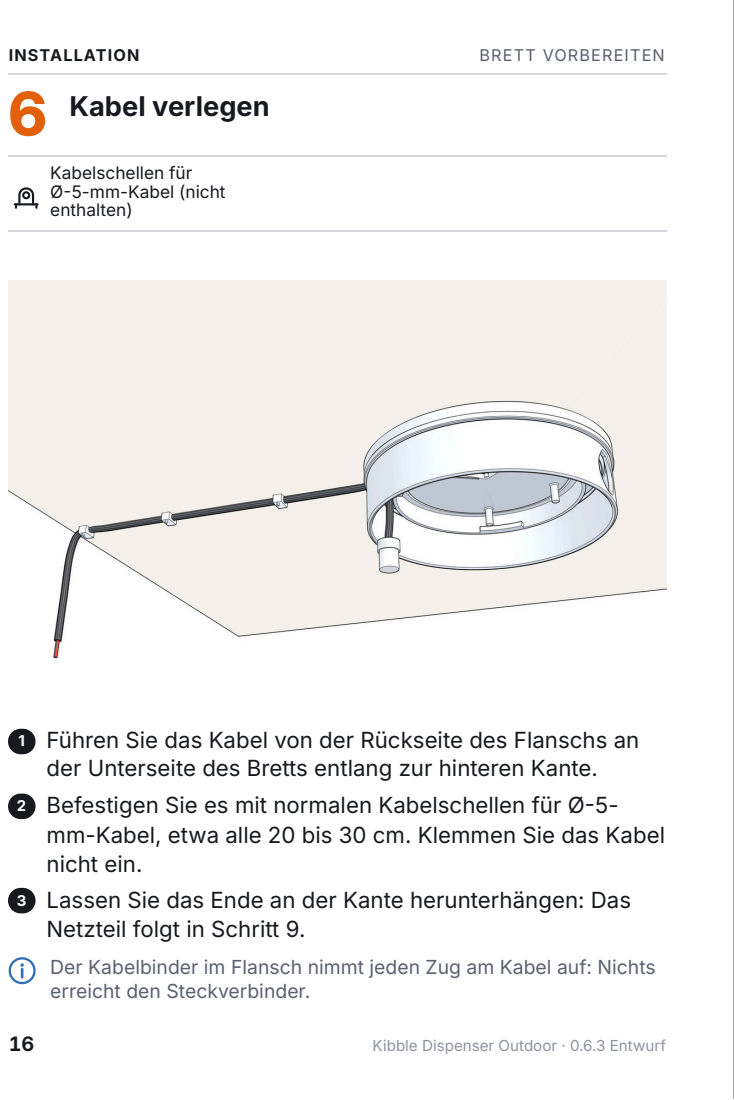
[picture p281: page 16]
Kabel verlegen; INSTALLATION; BRETT VORBEREITEN

Kabelschellen für
Ø-5-mm-Kabel (nicht
enthalten)

1 Führen Sie das Kabel von der Rückseite des Flanschs an
der Unterseite des Bretts entlang zur hinteren Kante.
2 Befestigen Sie es mit normalen Kabelschellen für Ø-5-
mm-Kabel, etwa alle 20 bis 30 cm. Klemmen Sie das Kabel
nicht ein.
3 Lassen Sie das Ende an der Kante herunterhängen: Das
Netzteil folgt in Schritt 9.
Der Kabelbinder im Flansch nimmt jeden Zug am Kabel auf: Nichts
erreicht den Steckverbinder.

16 Kibble Dispenser Outdoor · 0.6.3 Entwurf

7

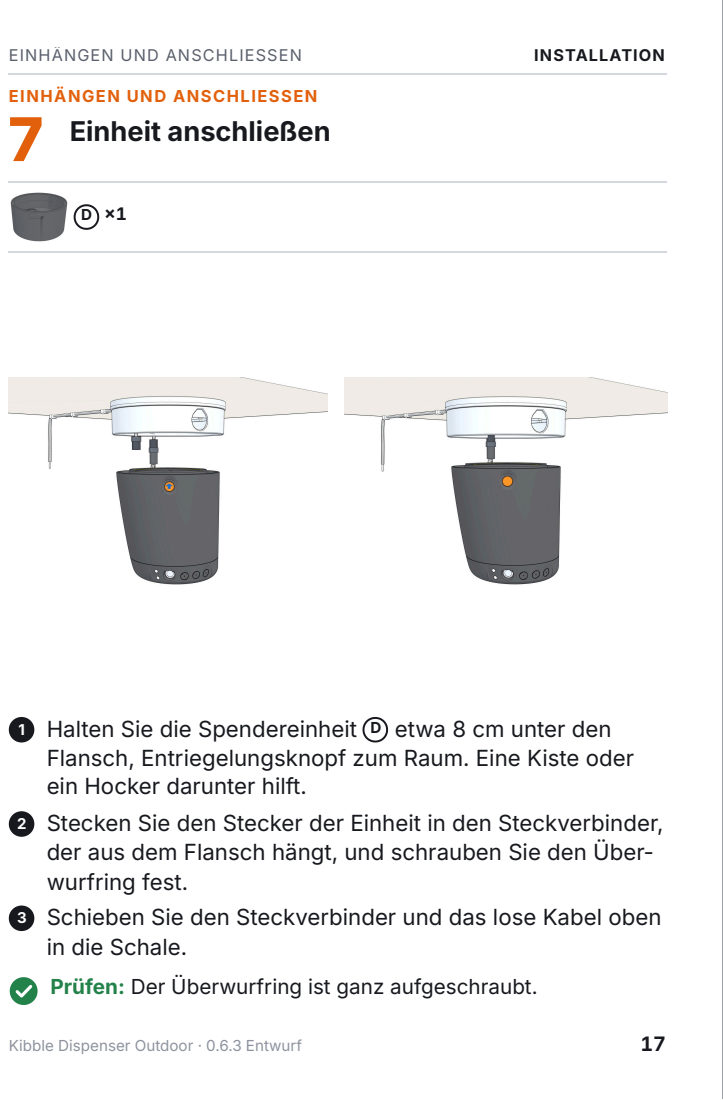
[picture p282: page 17]
EINHÄNGEN UND ANSCHLIESSEN; INSTALLATION

EINHÄNGEN UND ANSCHLIESSEN
Einheit anschließen

1 Halten Sie die Spendereinheit D etwa 8 cm unter den
Flansch, Entriegelungsknopf zum Raum. Eine Kiste oder
ein Hocker darunter hilft.
2 Stecken Sie den Stecker der Einheit in den Steckverbinder,
der aus dem Flansch hängt, und schrauben Sie den Über‐
wurfring fest.
3 Schieben Sie den Steckverbinder und das lose Kabel oben
in die Schale.
Prüfen: Der Überwurfring ist ganz aufgeschraubt.

8

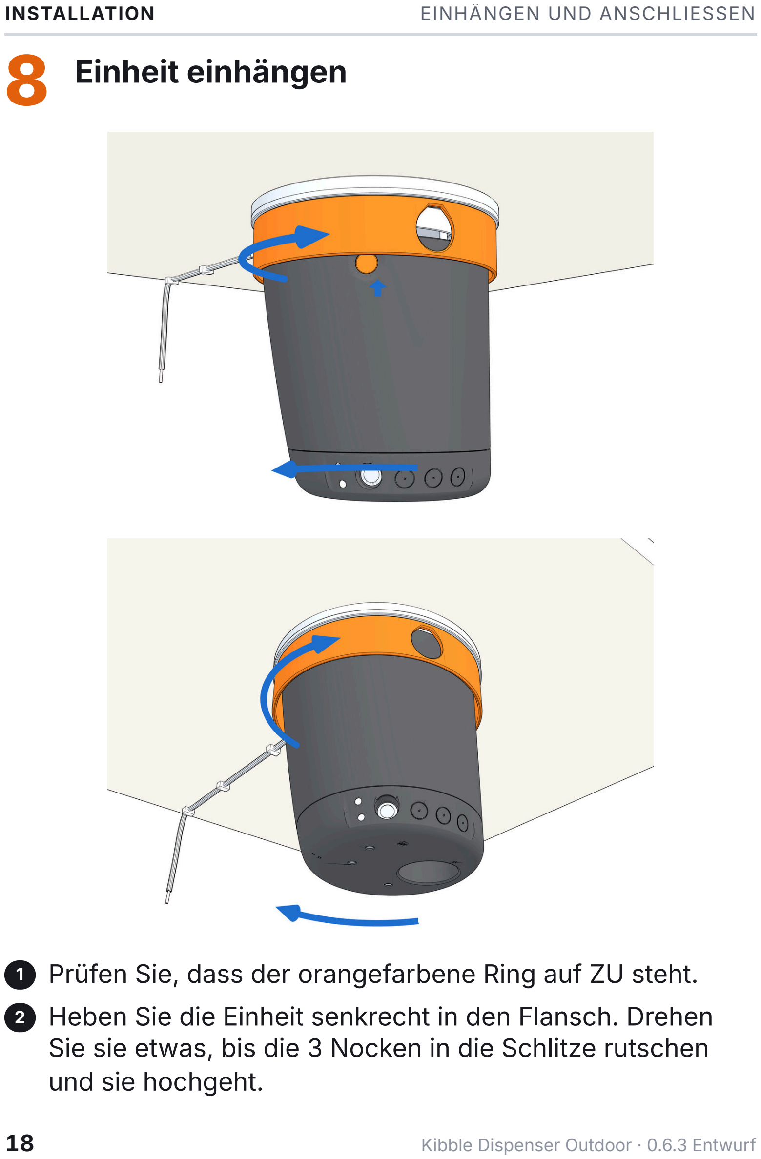
[picture p283: page 18]

### Einheit einhängen

1 Prüfen Sie, dass der orangefarbene Ring auf ZU steht.

### 2 Heben Sie die Einheit senkrecht in den Flansch. Drehen

Sie sie etwas, bis die 3 Nocken in die Schlitze rutschen und sie hochgeht.

INSTALLATION | EINHÄNGEN UND ANSCHLIESSEN

### 18 Kibble Dispenser Outdoor · 0.6.3 Entwurf

8

### Einheit einhängen

FORTSETZUNG

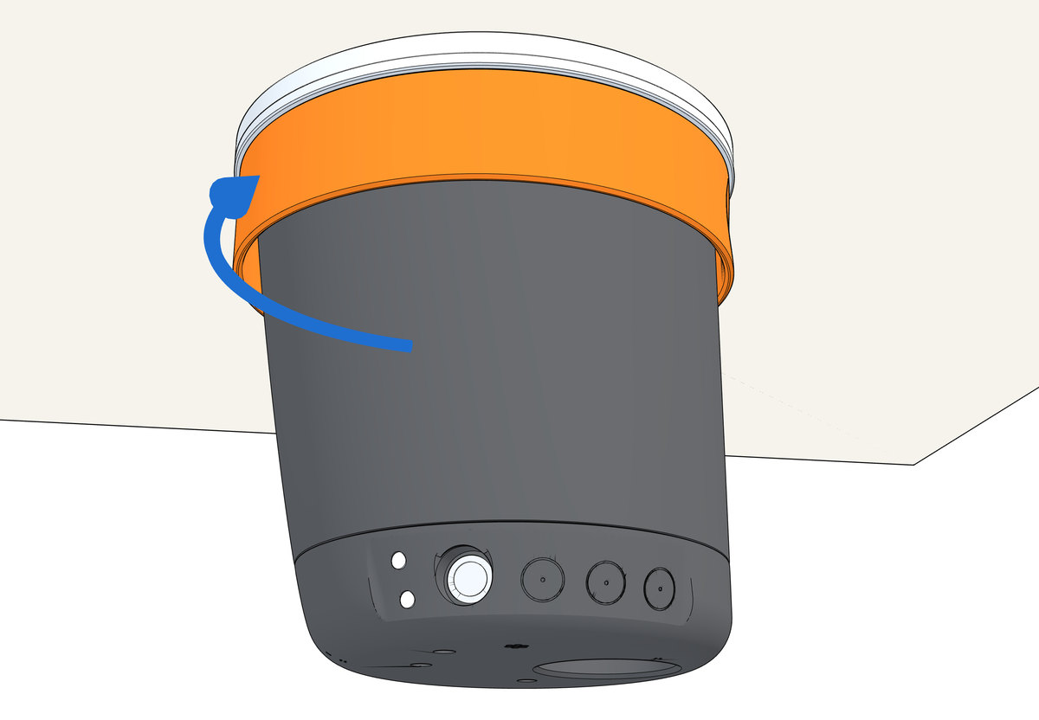
[picture p284: figure]

### 3 Drücken Sie nach oben und drehen Sie sie, von unten

gesehen, im Uhrzeigersinn um etwa 1/12 Umdrehung (30°), bis der Riegel einrastet.

### 4 Drehen Sie den orangefarbenen Ring im Uhrzeigersinn bis

zum Anschlag: OFFEN. Jetzt kann Futter zur Einheit gelangen.
Prüfen: Die Einheit dreht nicht zurück, der Spalt unter dem Flansch ist rundum gleich.
EINHÄNGEN UND ANSCHLIESSEN | INSTALLATION

9

### Strom anschließen

E ×1 Schraubendreher PZ2

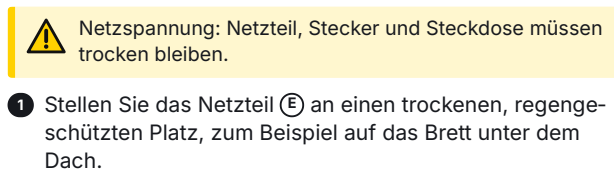
[picture p285: figure]
trocken bleiben.; Dach.

Netzspannung: Netzteil, Stecker und Steckdose müssen

### 1 Stellen Sie das Netzteil E an einen trockenen, regenge‐

schützten Platz, zum Beispiel auf das Brett unter dem

### 2 Lassen Sie das Kabel von der Brettkante in einer Schlaufe

hängen, die tiefer liegt als das Netzteil (Tropfschlaufe): Wasser tropft an der tiefsten Stelle ab.
3 Schließen Sie die 2 Adern am Adapter an: Rot an +, Schwarz an −. Ziehen Sie die Schrauben an.
4 Stecken Sie das Netzteil in die Steckdose.
Prüfen: Die Einheit startet ausgeschaltet (AUS), die Status-LED ist aus. Beim Einschalten der Stromversorgung gibt sie nie Futter aus.
INSTALLATION | EINHÄNGEN UND ANSCHLIESSEN

### 20 Kibble Dispenser Outdoor · 0.6.3 Entwurf

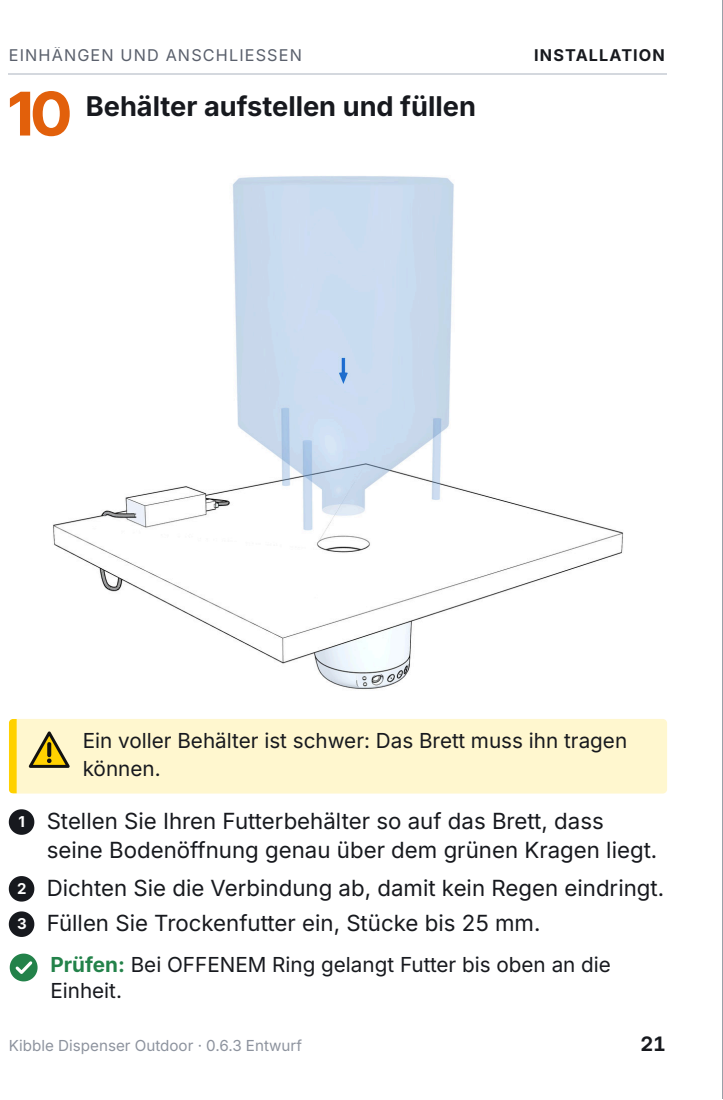
[picture p286: page 21]
EINHÄNGEN UND ANSCHLIESSEN; INSTALLATION

10 Behälter aufstellen und füllen

Ein voller Behälter ist schwer: Das Brett muss ihn tragen
können.
1 Stellen Sie Ihren Futterbehälter so auf das Brett, dass
seine Bodenöffnung genau über dem grünen Kragen liegt.
2 Dichten Sie die Verbindung ab, damit kein Regen eindringt.
3 Füllen Sie Trockenfutter ein, Stücke bis 25 mm.
Prüfen: Bei OFFENEM Ring gelangt Futter bis oben an die
Einheit.

## Erste Inbetriebnahme

11

### Erster Test


1 Stellen Sie den Napf unter den Auslauf.

### 2 Das Bedienfeld sitzt auf der Raumseite des Deckels, unter

dem Entriegelungsknopf. Drücken Sie seine Taste zweimal kurz hintereinander: Die Status-LED leuchtet, ein Ton erklingt und die Einheit gibt eine Portion aus.

### 3 Drücken Sie die Taste jetzt einmal: Nach einem kurzen

Moment gibt die Einheit eine Portion mit Ton aus. Wieder‐ holen Sie das ein paar Mal.

### 4 Die ersten Portionen können kleiner sein, bis sich die

Scheibe gefüllt hat.

ERSTE INBETRIEBNAHME | KIBBLE DISPENSER OUTDOOR

### 22 Kibble Dispenser Outdoor · 0.6.3 Entwurf

11

### Erster Test

FORTSETZUNG

Prüfen: Bei jedem einfachen Druck fällt Futter in den Napf.

DIE ERSTEN TAGE
Prüfen Sie jeden Tag, ob das Futter im Napf ankommt und ob Ihr Tier es frisst.
Wiegen Sie 10 Portionen mit einer Küchenwaage: Dann wissen Sie, wie viel ein Tastendruck mit Ihrem Futter ergibt. Manche Tiere brauchen ein paar Tage, um sich an den Ton zu gewöhnen.
KIBBLE DISPENSER OUTDOOR | ERSTE INBETRIEBNAHME

## Bedienung im Alltag

Bedienung im Alltag: eine Taste

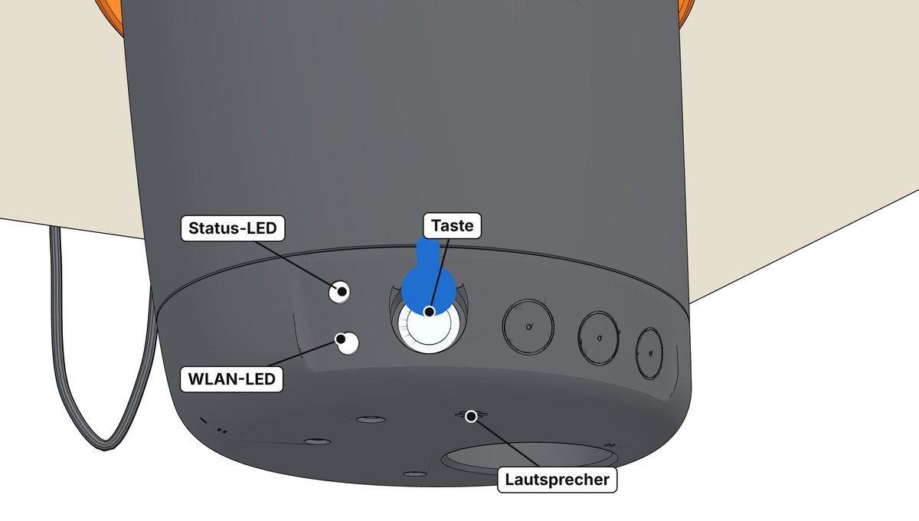
[picture p287: figure]

Beim Einschalten der Stromversorgung gibt die Einheit nie Futter aus: Nach einem Stromausfall startet sie AUS. Tastenverhalten und Bedeutung der LEDs sind vorläufig, bis die Firmware aktualisiert ist (GitHub-Issue Nr. 2).

Das Bedienfeld hat eine Taste und zwei Leuchten. Drücken Sie die Taste mit der Fingerspitze bis zum Grund der Vertiefung.
Zweimal drücken (innerhalb von 0,4 s): schaltet die Einheit EIN oder AUS. Beim Einschalten gibt sie eine Portion aus, beim Ausschalten keine.
Einmal drücken: eine Portion, nur wenn die Einheit EIN ist. Im AUS-Zustand blinkt nur die Status-LED. Gedrückt halten gibt nie mehr.
5 s halten: setzt alle Einstellungen außer WLAN zurück. 10 s halten: vollständiger Reset einschließlich WLAN. Nach dem LED-Signal loslassen; es kommt kein Futter.
Obere LED: Status (EIN/AUS). Untere LED: WLAN. Bei jeder Portion erklingt ein Ton; eine Portion wiegt etwa 6,5 g.
BEDIENUNG IM ALLTAG | KIBBLE DISPENSER OUTDOOR

### 24 Kibble Dispenser Outdoor · 0.6.3 Entwurf

Den Schieber benutzen

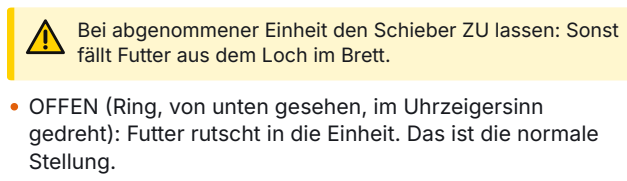
[picture p288: figure]
fällt Futter aus dem Loch im Brett.; Stellung.

Bei abgenommener Einheit den Schieber ZU lassen: Sonst

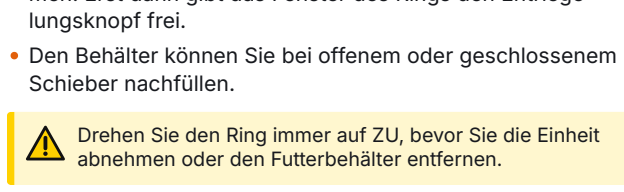
[picture p289: figure]
abnehmen oder den Futterbehälter entfernen.; lungsknopf frei.; Schieber nachfüllen.

Drehen Sie den Ring immer auf ZU, bevor Sie die Einheit

OFFEN (Ring, von unten gesehen, im Uhrzeigersinn gedreht): Futter rutscht in die Einheit. Das ist die normale

ZU (Ring gegen den Uhrzeigersinn bis zum Anschlag): Das grüne Blatt hält das Futter im Behälter.
Schließen Sie den Schieber, bevor Sie die Einheit abneh‐ men. Erst dann gibt das Fenster des Rings den Entriege‐

Den Behälter können Sie bei offenem oder geschlossenem

KIBBLE DISPENSER OUTDOOR | BEDIENUNG IM ALLTAG

## Wartung

Fast wartungsfrei


Nie Fett, nie Öl: Der Antrieb innen ist abgedichtet und dauergeschmiert.
Kein Silicagel zu wechseln: Die Elektronikbox atmet über eine Membranbelüftung.
Die Dosierscheibe reinigt sich selbst: Kleine Rippen an der Unterseite fegen bei jeder Drehung Krümel weg.
Halten Sie die winzigen Löcher der beiden Abläufe im fla‐ chen Boden sauber; spülen Sie sie bei Bedarf mit etwas Wasser.
Reinigen Sie den Futterweg der Hygiene wegen alle paar Monate und bei jedem Futterwechsel (nächste zwei Schritte).
WARTUNG | KIBBLE DISPENSER OUTDOOR

### 26 Kibble Dispenser Outdoor · 0.6.3 Entwurf

12

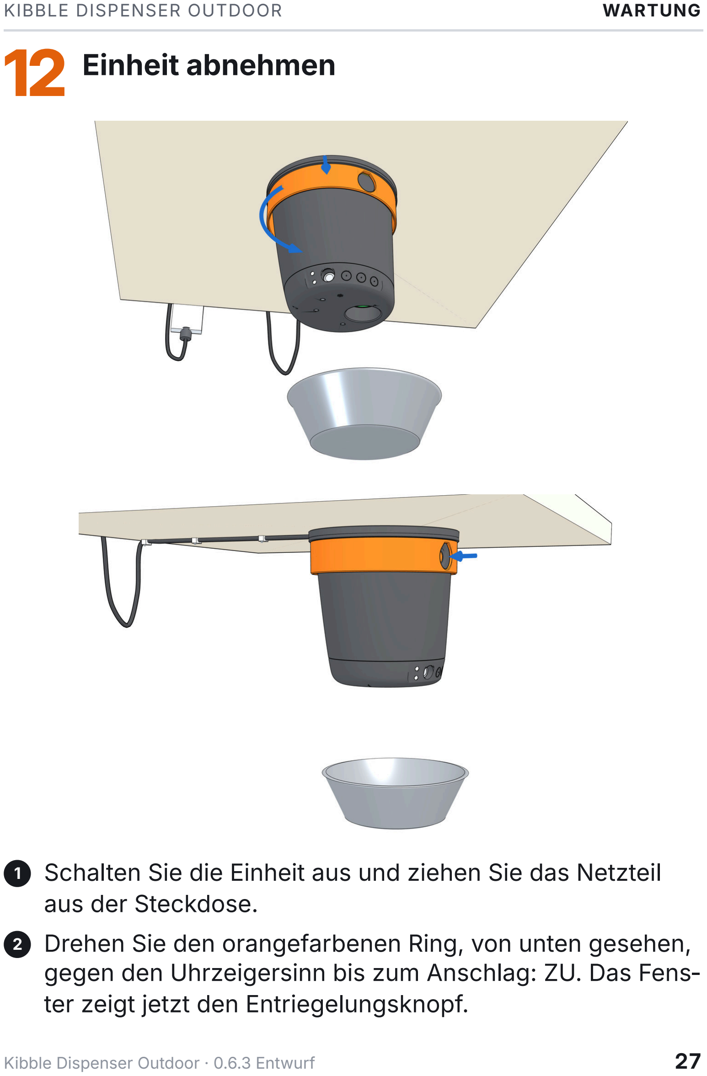
[picture p290: page 27]

### Einheit abnehmen

### 1 Schalten Sie die Einheit aus und ziehen Sie das Netzteil

aus der Steckdose.
2 Drehen Sie den orangefarbenen Ring, von unten gesehen, gegen den Uhrzeigersinn bis zum Anschlag: ZU. Das Fens‐ ter zeigt jetzt den Entriegelungsknopf.
KIBBLE DISPENSER OUTDOOR | WARTUNG

12

### Einheit abnehmen

FORTSETZUNG

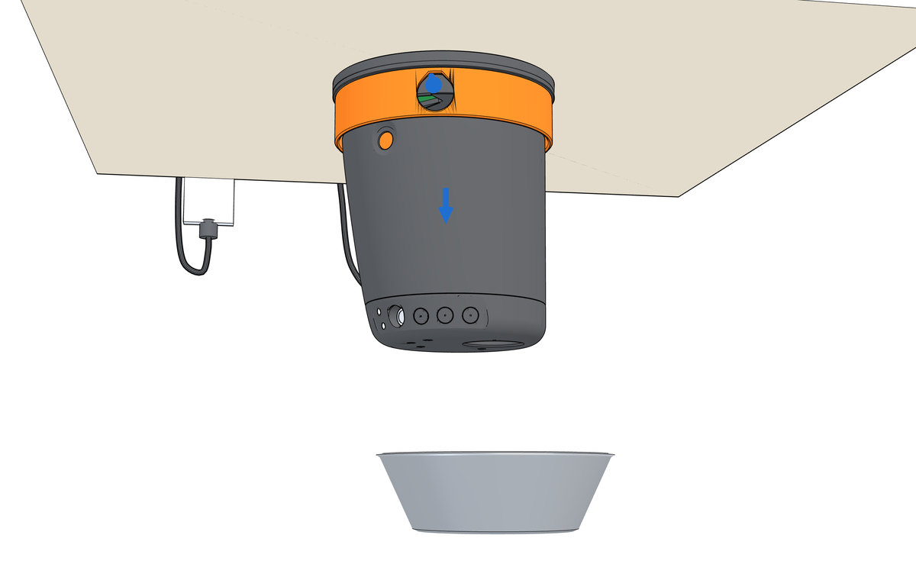
[picture p291: figure]

### 3 Drücken Sie den Knopf durch das Fenster und drehen Sie

die Einheit gegen den Uhrzeigersinn um 30°.

### 4 Senken Sie sie um etwa 8 cm ab, schrauben Sie den

Steckverbinder im Spalt auf und nehmen Sie die Einheit in einem Stück ab.
Der Ring gibt den Knopf nur bei geschlossenem Schieber frei, so fällt kein Futter heraus.
WARTUNG | KIBBLE DISPENSER OUTDOOR

### 28 Kibble Dispenser Outdoor · 0.6.3 Entwurf

13

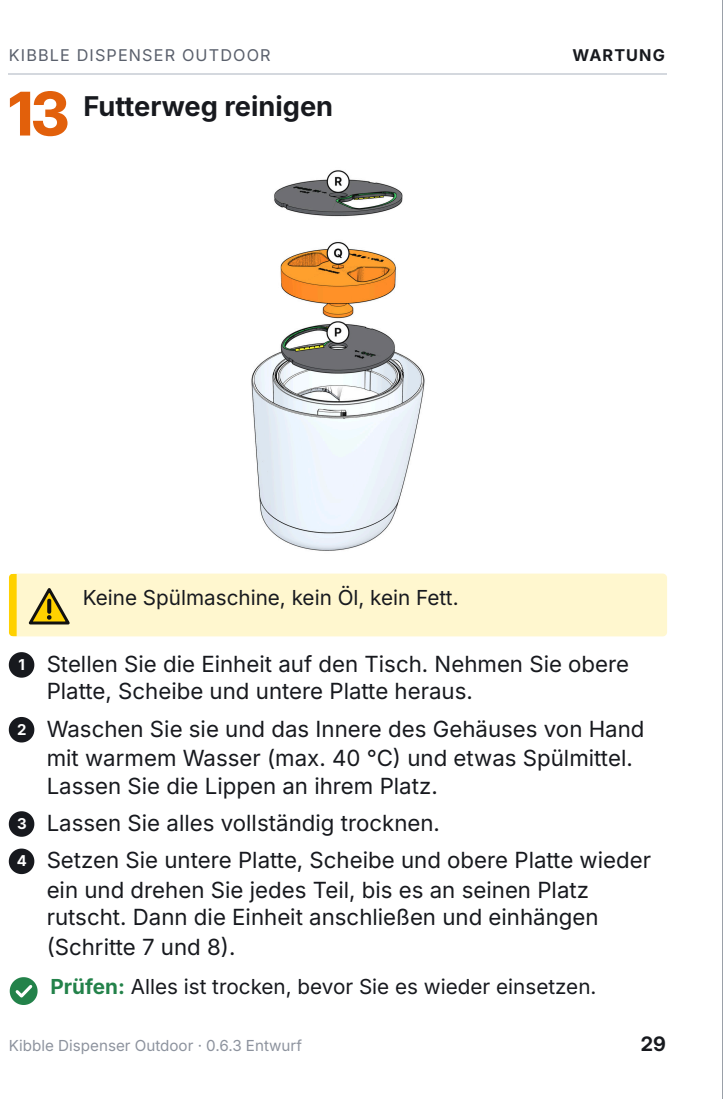
[picture p292: page 29]
Futterweg reinigen; KIBBLE DISPENSER OUTDOOR; WARTUNG

Keine Spülmaschine, kein Öl, kein Fett.

1 Stellen Sie die Einheit auf den Tisch. Nehmen Sie obere
Platte, Scheibe und untere Platte heraus.
2 Waschen Sie sie und das Innere des Gehäuses von Hand
mit warmem Wasser (max. 40 °C) und etwas Spülmittel.
Lassen Sie die Lippen an ihrem Platz.
3 Lassen Sie alles vollständig trocknen.
4 Setzen Sie untere Platte, Scheibe und obere Platte wieder
ein und drehen Sie jedes Teil, bis es an seinen Platz
rutscht. Dann die Einheit anschließen und einhängen
(Schritte 7 und 8).
Prüfen: Alles ist trocken, bevor Sie es wieder einsetzen.

14

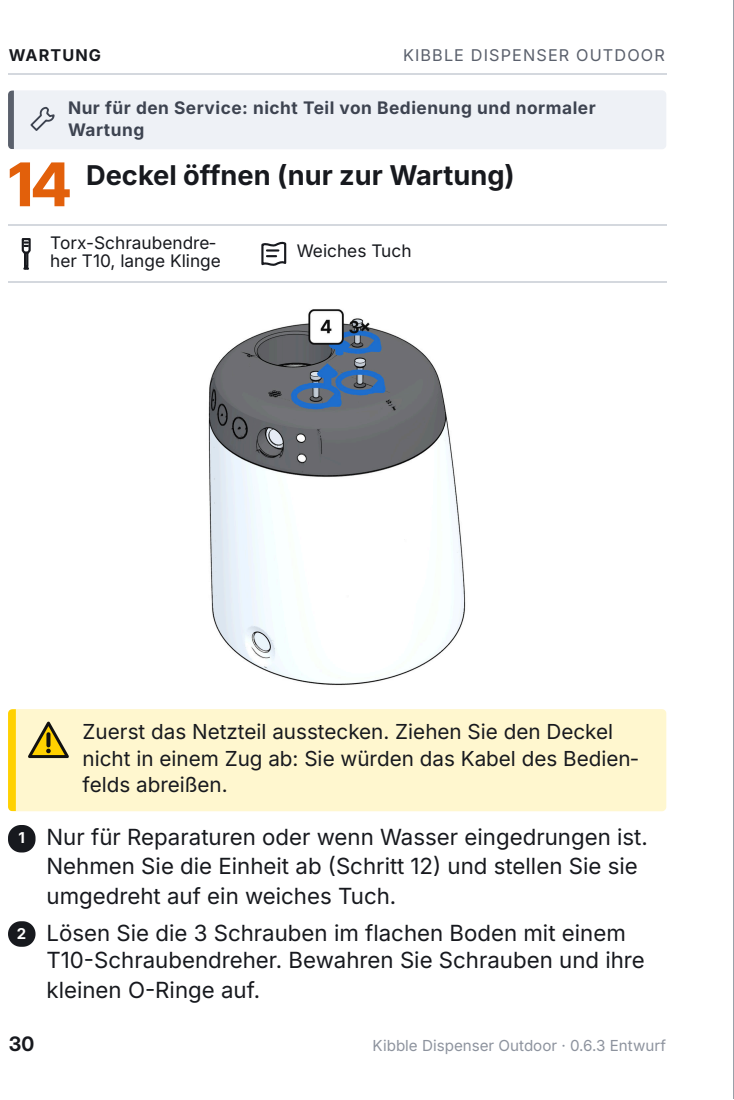
[picture p293: page 30]
Torx-Schraubendre‐; her T10, lange Klinge; Weiches Tuch; WARTUNG; KIBBLE DISPENSER OUTDOOR

Nur für den Service: nicht Teil von Bedienung und normaler
Wartung
Deckel öffnen (nur zur Wartung)

Zuerst das Netzteil ausstecken. Ziehen Sie den Deckel
nicht in einem Zug ab: Sie würden das Kabel des Bedien‐
felds abreißen.
1 Nur für Reparaturen oder wenn Wasser eingedrungen ist.
Nehmen Sie die Einheit ab (Schritt 12) und stellen Sie sie
umgedreht auf ein weiches Tuch.
2 Lösen Sie die 3 Schrauben im flachen Boden mit einem
T10-Schraubendreher. Bewahren Sie Schrauben und ihre
kleinen O-Ringe auf.

30 Kibble Dispenser Outdoor · 0.6.3 Entwurf

### 14 Deckel öffnen (nur zur Wartung)

FORTSETZUNG

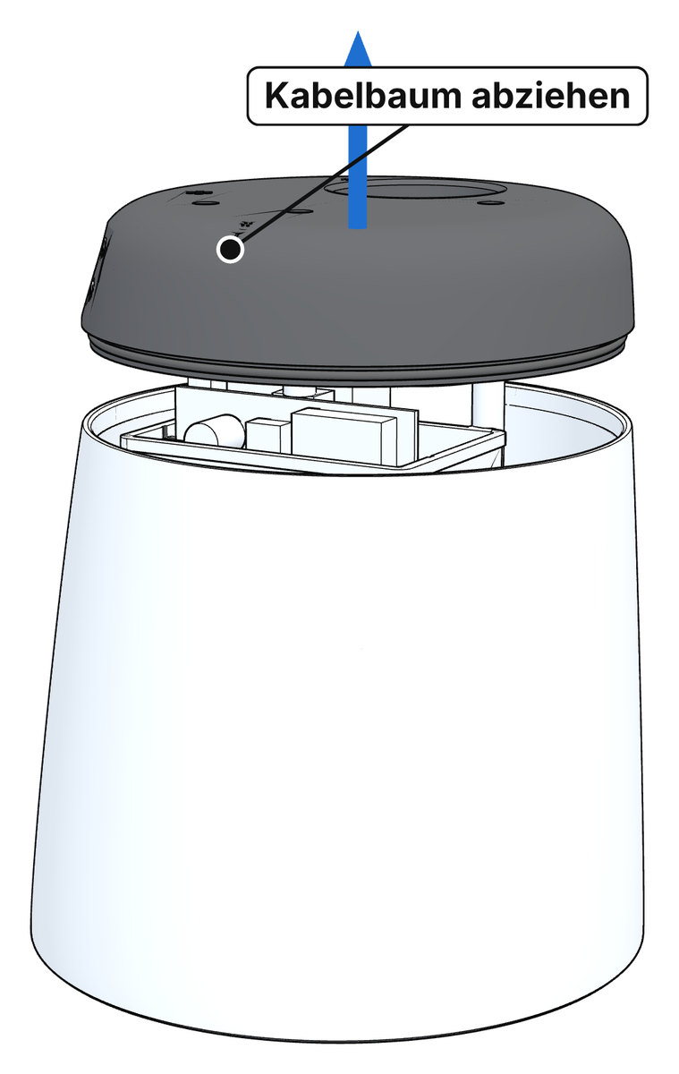
[picture p294: figure]

### 3 Heben Sie den Deckel nur wenig an: Das Bedienfeld ist mit

der Platine verbunden. Ziehen Sie den Kabelbaum des Bedienfelds ab und nehmen Sie dann den Deckel ab.

### 4 Zum Schließen: Kabelbaum wieder aufstecken, Deckel

aufsetzen und die 3 Schrauben mit ihren O-Ringen nur von Hand anziehen.

KIBBLE DISPENSER OUTDOOR | WARTUNG

## Fehlersuche

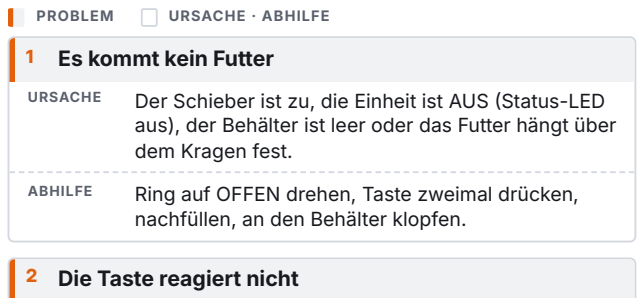
[picture p295: figure]
PROBLEM; URSACHE · ABHILFE; 1 Es kommt kein Futter; dem Kragen fest.; nachfüllen, an den Behälter klopfen.; 2 Die Taste reagiert nicht

URSACHE | Der Schieber ist zu, die Einheit ist AUS (Status-LED aus), der Behälter ist leer oder das Futter hängt über
ABHILFE | Ring auf OFFEN drehen, Taste zweimal drücken,

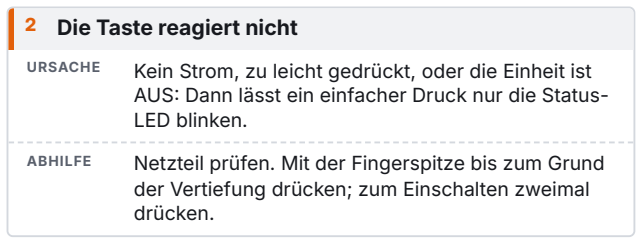
[picture p296: figure]
LED blinken.; drücken.

URSACHE | Kein Strom, zu leicht gedrückt, oder die Einheit ist AUS: Dann lässt ein einfacher Druck nur die Status-
ABHILFE | Netzteil prüfen. Mit der Fingerspitze bis zum Grund der Vertiefung drücken; zum Einschalten zweimal

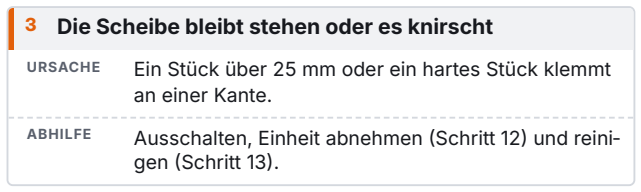
[picture p297: figure]
an einer Kante.; gen (Schritt 13).

### 3 Die Scheibe bleibt stehen oder es knirscht

URSACHE | Ein Stück über 25 mm oder ein hartes Stück klemmt
ABHILFE | Ausschalten, Einheit abnehmen (Schritt 12) und reini‐
FEHLERSUCHE | KIBBLE DISPENSER OUTDOOR

### 32 Kibble Dispenser Outdoor · 0.6.3 Entwurf

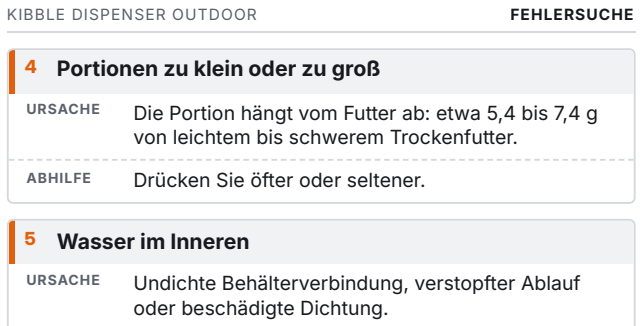
[picture p298: figure]
4 Portionen zu klein oder zu groß; von leichtem bis schwerem Trockenfutter.; ABHILFE; Drücken Sie öfter oder seltener.; 5 Wasser im Inneren; URSACHE; Undichte Behälterverbindung, verstopfter Ablauf; oder beschädigte Dichtung.; KIBBLE DISPENSER OUTDOOR; FEHLERSUCHE

URSACHE Die Portion hängt vom Futter ab: etwa 5,4 bis 7,4 g

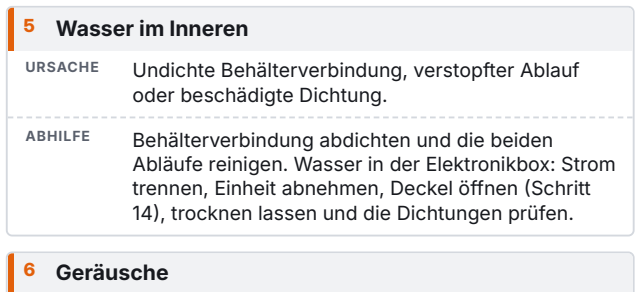
[picture p299: figure]
ABHILFE; Behälterverbindung abdichten und die beiden; 6 Geräusche

Abläufe reinigen. Wasser in der Elektronikbox: Strom trennen, Einheit abnehmen, Deckel öffnen (Schritt 14), trocknen lassen und die Dichtungen prüfen.

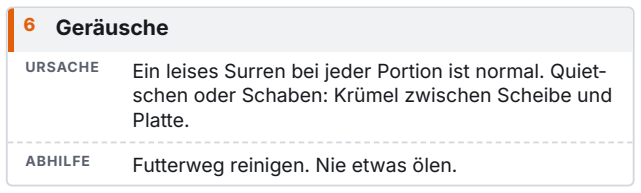
[picture p300: figure]
Platte.; ABHILFE; Futterweg reinigen. Nie etwas ölen.

URSACHE | Ein leises Surren bei jeder Portion ist normal. Quiet‐ schen oder Schaben: Krümel zwischen Scheibe und

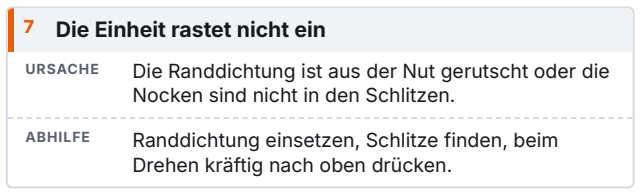
[picture p301: figure]
7 Die Einheit rastet nicht ein; Nocken sind nicht in den Schlitzen.; ABHILFE; Randdichtung einsetzen, Schlitze finden, beim; Drehen kräftig nach oben drücken.

URSACHE | Die Randdichtung ist aus der Nut gerutscht oder die

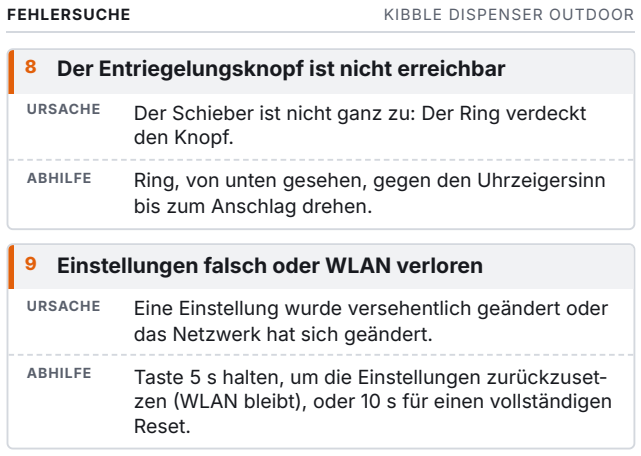
[picture p302: figure]
den Knopf.; bis zum Anschlag drehen.; das Netzwerk hat sich geändert.; Reset.; FEHLERSUCHE; KIBBLE DISPENSER OUTDOOR

### 8 Der Entriegelungsknopf ist nicht erreichbar

URSACHE | Der Schieber ist nicht ganz zu: Der Ring verdeckt
ABHILFE | Ring, von unten gesehen, gegen den Uhrzeigersinn

### 9 Einstellungen falsch oder WLAN verloren

URSACHE | Eine Einstellung wurde versehentlich geändert oder
ABHILFE | Taste 5 s halten, um die Einstellungen zurückzuset‐ zen (WLAN bleibt), oder 10 s für einen vollständigen

Funktioniert es immer noch nicht? Trennen Sie die Einheit vom Strom und suchen Sie Hilfe auf der Projektseite (Seite 38).

### 34 Kibble Dispenser Outdoor · 0.6.3 Entwurf

## Technische Daten


Konstruktion | Kibble Dispenser Outdoor v6.3
Maße unter dem Brett | Ø 180 mm (Flansch), 182 mm hoch
Gewicht der Einheit | etwa 1,3 kg
Brett | waagerecht, 18–40 mm dick; ein Loch Ø 76 mm
Freiraum | mindestens 36 cm unter dem Brett, Ø 20 cm um die Einheit
Portion | etwa 6,5 g (Standardscheibe); 5,4–7,4 g je nach Futter
Futtergröße | Trockenfutter bis 25 mm
KIBBLE DISPENSER OUTDOOR | TECHNISCHE DATEN

Schieber | im Flansch, mit dem orangefarbenen Ring bedient (113°); die Einheit lässt sich nur bei geschlossenem Schieber lösen
Bedienung | 1 versenkte IP67-Taste, 2 LEDs (Status, WLAN), Lautsprecher

Stromversorgung 12 V DC, Netzteil enthalten; Steckverbinder M8
| IP67 in der Einheit; Kabel verlässt den Flansch hinten, mit Kabelbinder-Zugentlastung
Wetterschutz | Elektronikbox ausgelegt für IP66, in einer abgedichteten Außenhülle mit zwei insekten‐ dichten Labyrinth-Abläufen (noch nicht geprüft)
Festigkeit | berechnet für 250 N nach unten und 100 N seitlich am Boden (noch nicht geprüft)
Werkstoffe | PETG, Dichtungen aus TPU 95A, O-Ringe aus NBR, Schrauben und Zylinderstift aus Edel‐ stahl, Messinggewinde, UV-beständiger Kabel‐ binder aus PA66
Wartung | kein Fett, kein Silicagel; der Deckel wird nur zur Wartung geöffnet (3 Schrauben T10)

Alle Werte sind Konstruktionswerte: Es wurde noch nichts gedruckt oder getestet.

TECHNISCHE DATEN | KIBBLE DISPENSER OUTDOOR

### 36 Kibble Dispenser Outdoor · 0.6.3 Entwurf

## Ersatzteile und druckbare Teile

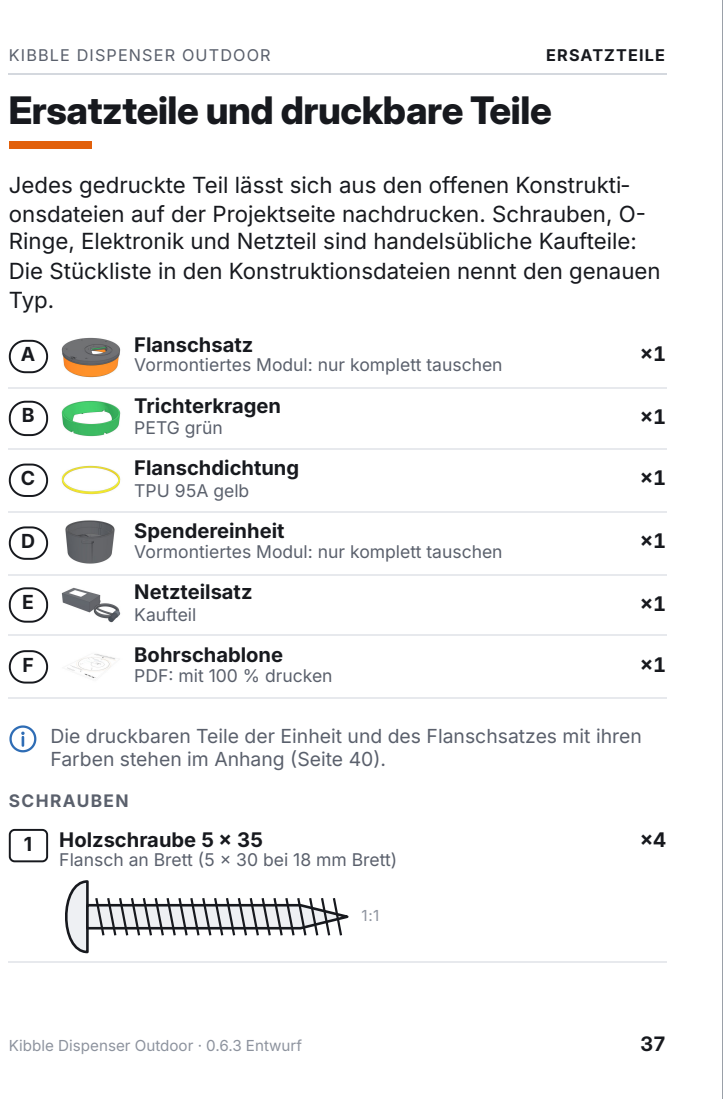
[picture p303: page 37]
E Netzteilsatz; KIBBLE DISPENSER OUTDOOR; ERSATZTEILE

Jedes gedruckte Teil lässt sich aus den offenen Konstrukti‐
onsdateien auf der Projektseite nachdrucken. Schrauben, O-
Ringe, Elektronik und Netzteil sind handelsübliche Kaufteile:
Die Stückliste in den Konstruktionsdateien nennt den genauen
Typ.

Flanschsatz
Vormontiertes Modul: nur komplett tauschen
Trichterkragen
PETG grün
Flanschdichtung
TPU 95A gelb
Spendereinheit

Kaufteil
Bohrschablone
PDF: mit 100 % drucken

Die druckbaren Teile der Einheit und des Flanschsatzes mit ihren
Farben stehen im Anhang (Seite 40).

SCHRAUBEN
1 Holzschraube 5 × 35
Flansch an Brett (5 × 30 bei 18 mm Brett)

### 2 Kabelbinder 3,6 × 140, UV-beständig

Zugentlastung des Kabels im Flansch

×1

Drucken Sie Dichtungen und Lippen aus TPU 95A und alle anderen Teile aus PETG, in den angegebenen Farben. Elektronikbox und Deckel müssen massiv gedruckt werden (100 % Füllung), damit sie dicht bleiben; die Druckeinstellungen stehen in den Konstruktionsdateien.

## Entsorgung

Durchgestrichene Mülltonne: nicht in den Hausmüll.

Die Elektronikbox enthält elektronische Bauteile. Nicht in den Hausmüll: Geben Sie sie bei einer Sammelstelle für Elektro-und Elektronikgeräte ab (WEEE). Kunststoffteile und Schrau‐ ben nach den örtlichen Regeln entsorgen. Die Einheit enthält keine Batterie.
Gedruckte Teile: PETG und TPU. Viele Wertstoffsammlungen nehmen sie nicht an: Fragen Sie beim örtlichen Wertstoffhof nach.

## Open Source und Lizenzen

Kibble Dispenser ist Open Source: Konstruktionsdateien unter CERN-OHL-P-2.0, Software unter der MIT-Lizenz, diese Anlei‐ tung unter CC BY 4.0. © 2026 Enrico Icardi und Mitwirkende.

ERSATZTEILE | KIBBLE DISPENSER OUTDOOR

### 38 Kibble Dispenser Outdoor · 0.6.3 Entwurf

Hardware (Konstruktionsdateien) | CERN-OHL-P-2.0

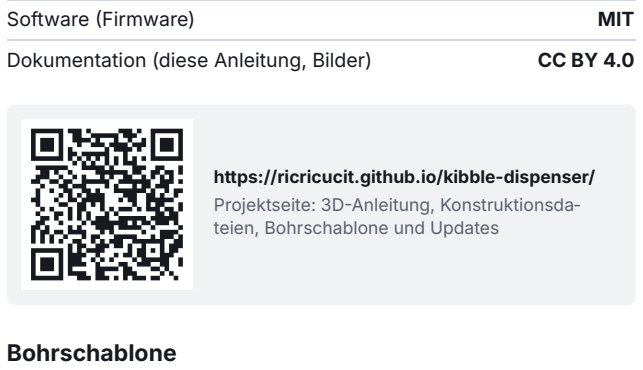
[picture p304: figure]
Software (Firmware); MIT; Dokumentation (diese Anleitung, Bilder); https://ricricucit.github.io/kibble-dispenser/ Projektseite: 3D-Anleitung, Konstruktionsda‐ teien, Bohrschablone und Updates; Bohrschablone

Die Bohrschablone im Maßstab 1:1 ist ein separates A4-PDF (kibble-dispenser-drilling-template.pdf, auch auf der Projekt‐ seite). Drucken Sie sie mit 100 % (Originalgröße, ohne Skalie‐ rung) und prüfen Sie den 50-mm-Maßstab mit einem Lineal. Kleben Sie sie mit der BEDRUCKTEN SEITE ZU IHNEN und FRONT zum Raum unter das Brett.
Open-Source-Hardware wird ohne jede Gewähr bereitgestellt: siehe Lizenztexte.
KIBBLE DISPENSER OUTDOOR | LIZENZEN

ANHANG A

## Selbst bauen

Wenn Sie Einheit und Flanschsatz selbst drucken und bauen, führen Sie zuerst diese Schritte aus und installieren Sie dann alles wie den Bausatz. Die 3D-Anleitung online zeigt jeden Schritt als Animation, die Sie drehen und zoomen können.

Drucken Sie die Teile nach den Druckhinweisen der Konstruk‐ tion. Dann bauen Sie Einheit und Flanschsatz selbst.


Gedruckte und gekaufte Teile

K

Dosiergehäuse
PETG schwarz

×1

ANHANG A | SELBST BAUEN

### 40 Kibble Dispenser Outdoor · 0.6.3 Entwurf

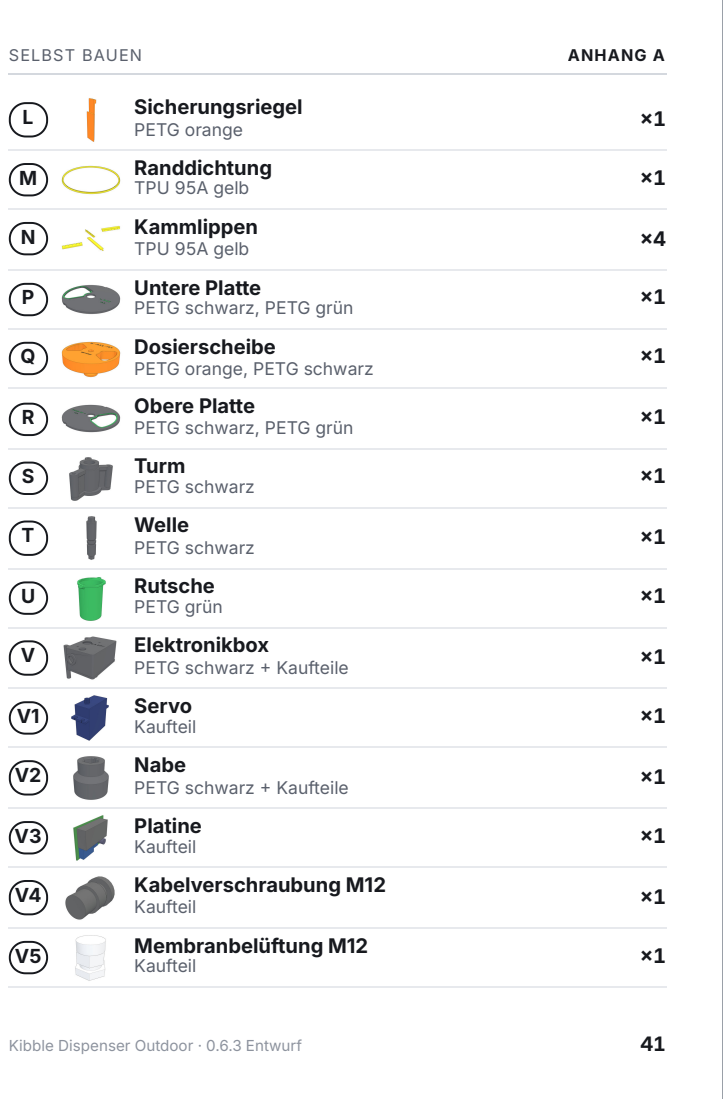
[picture p305: page 41]
Sicherungsriegel PETG orange; Randdichtung TPU 95A gelb; Kammlippen TPU 95A gelb; P Untere Platte; T Welle; Nabe; PETG schwarz + Kaufteile; Platine Kaufteil; Kabelverschraubung M12 Kaufteil; Membranbelüftung M12; Kaufteil; SELBST BAUEN; ANHANG A

PETG schwarz, PETG grün
Dosierscheibe
PETG orange, PETG schwarz
Obere Platte
Turm
PETG schwarz

Rutsche
PETG grün
Elektronikbox
PETG schwarz + Kaufteile
Servo
Kaufteil

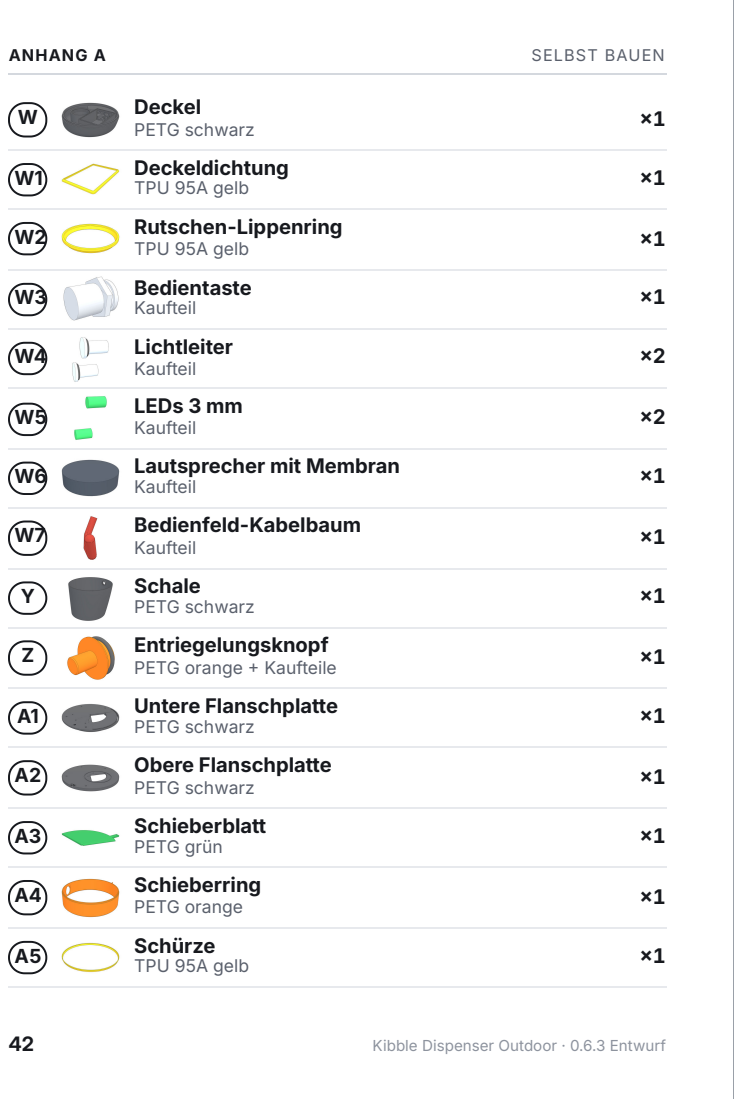
[picture p306: page 42]
W Deckel; Untere Flanschplatte; PETG schwarz; Obere Flanschplatte; Schieberblatt PETG grün; Schieberring PETG orange; Schürze TPU 95A gelb; ANHANG A; SELBST BAUEN

PETG schwarz
Deckeldichtung
TPU 95A gelb
Rutschen-Lippenring
Bedientaste
Kaufteil
Lichtleiter
LEDs 3 mm
Lautsprecher mit Membran
Bedienfeld-Kabelbaum
Schale
Entriegelungsknopf
PETG orange + Kaufteile

42 Kibble Dispenser Outdoor · 0.6.3 Entwurf

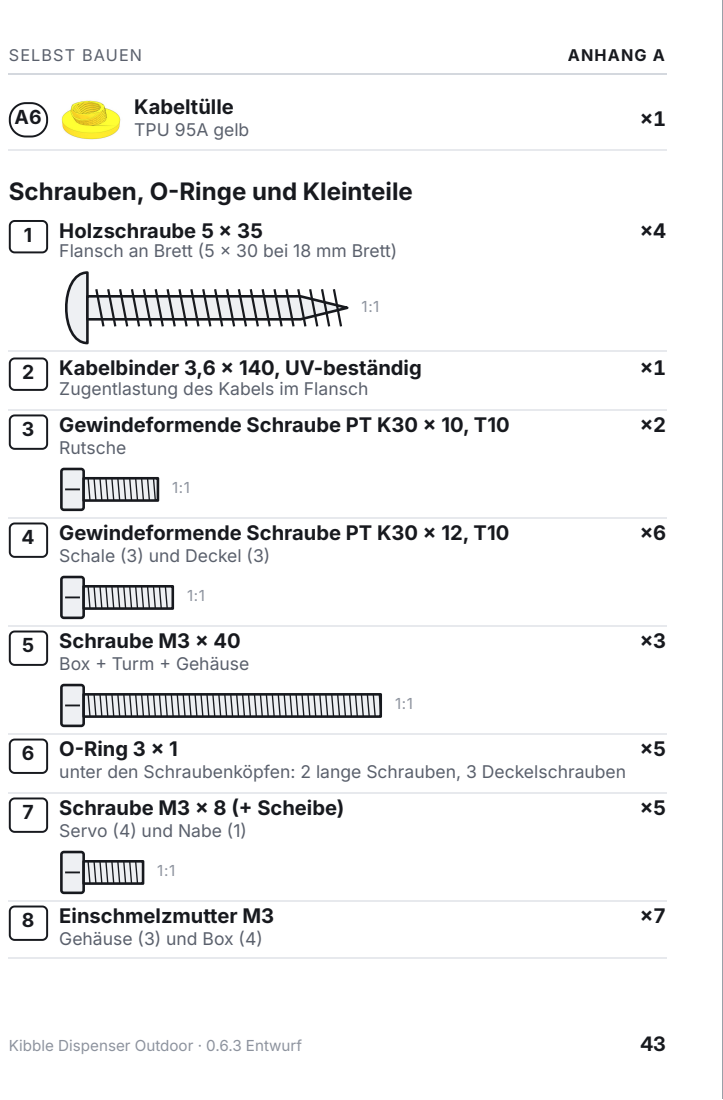
[picture p307: page 43]
Kabeltülle TPU 95A gelb; SELBST BAUEN; ANHANG A

Schrauben, O-Ringe und Kleinteile
1 Holzschraube 5 × 35
Flansch an Brett (5 × 30 bei 18 mm Brett)

2 Kabelbinder 3,6 × 140, UV-beständig
Zugentlastung des Kabels im Flansch
3 Gewindeformende Schraube PT K30 × 10, T10
Rutsche

4 Gewindeformende Schraube PT K30 × 12, T10
Schale (3) und Deckel (3)

5 Schraube M3 × 40
Box + Turm + Gehäuse

6 O-Ring 3 × 1
unter den Schraubenköpfen: 2 lange Schrauben, 3 Deckelschrauben
7 Schraube M3 × 8 (+ Scheibe)
Servo (4) und Nabe (1)

8 Einschmelzmutter M3
Gehäuse (3) und Box (4)

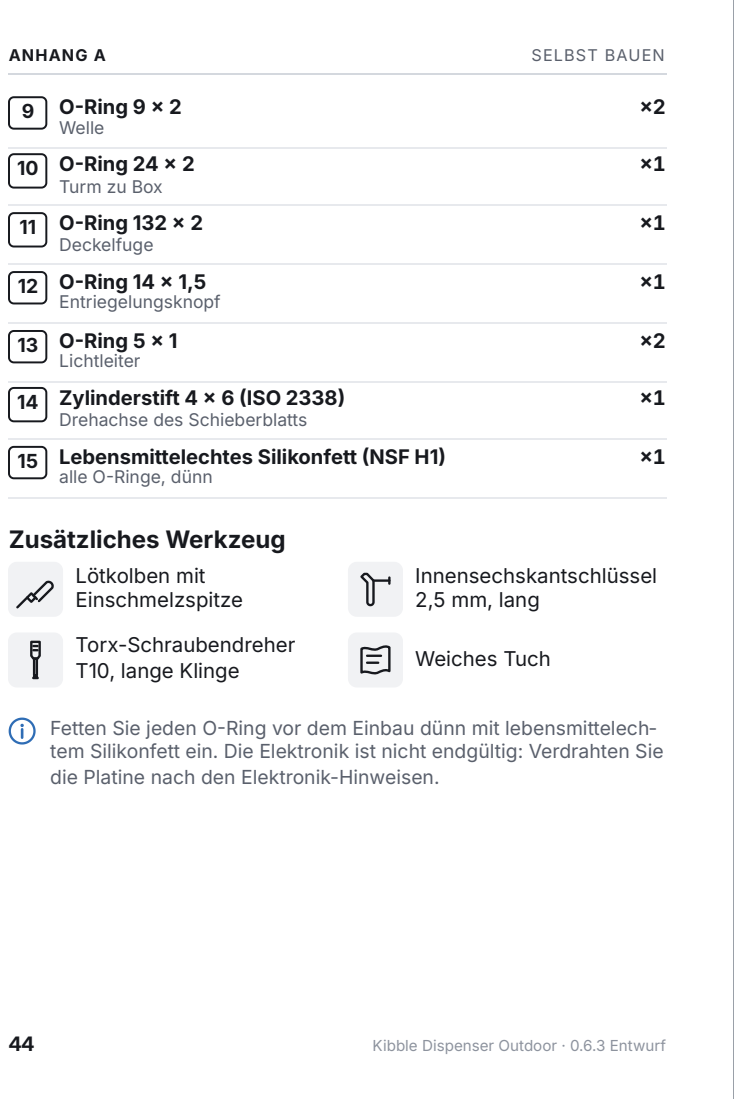
[picture p308: page 44]
Zusätzliches Werkzeug; Lötkolben mit Einschmelzspitze; Innensechskantschlüssel 2,5 mm, lang; Torx-Schraubendreher; T10, lange Klinge; Weiches Tuch; ANHANG A; SELBST BAUEN

9 O-Ring 9 × 2
Welle
10 O-Ring 24 × 2
Turm zu Box
11 O-Ring 132 × 2
Deckelfuge
12 O-Ring 14 × 1,5
Entriegelungsknopf
13 O-Ring 5 × 1
Lichtleiter
14 Zylinderstift 4 × 6 (ISO 2338)
Drehachse des Schieberblatts
15 Lebensmittelechtes Silikonfett (NSF H1)
alle O-Ringe, dünn

Fetten Sie jeden O-Ring vor dem Einbau dünn mit lebensmittelech‐
tem Silikonfett ein. Die Elektronik ist nicht endgültig: Verdrahten Sie
die Platine nach den Elektronik-Hinweisen.

44 Kibble Dispenser Outdoor · 0.6.3 Entwurf

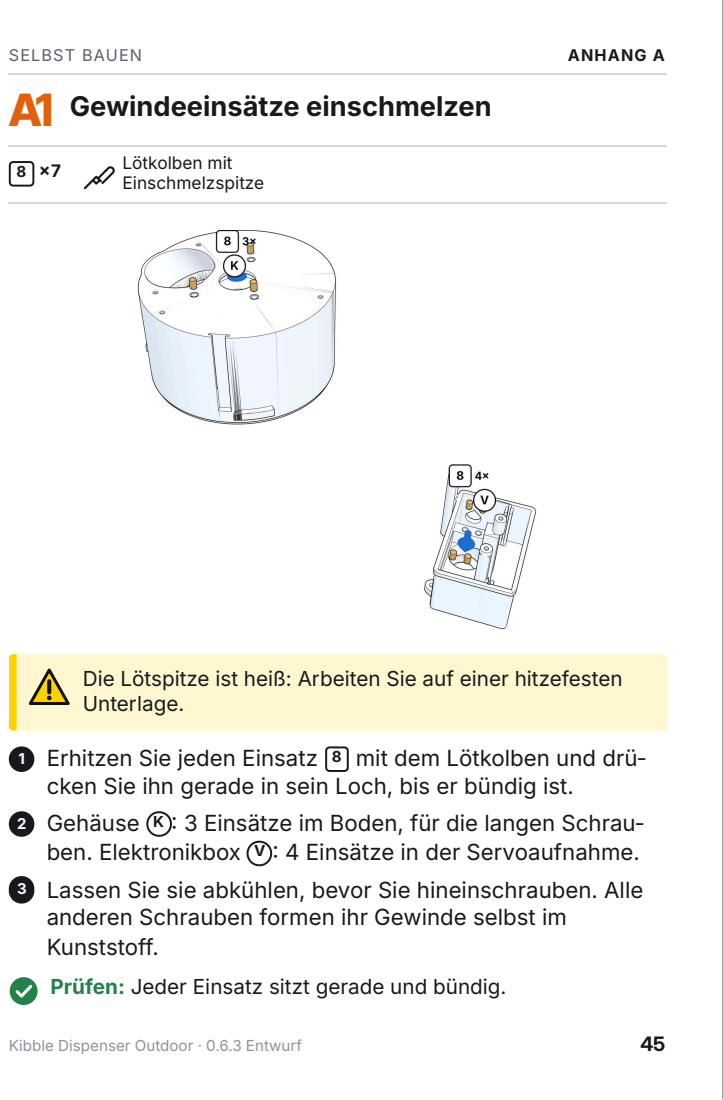
[picture p309: page 45]
A1 Gewindeeinsätze einschmelzen; Lötkolben mit Einschmelzspitze; SELBST BAUEN; ANHANG A

Die Lötspitze ist heiß: Arbeiten Sie auf einer hitzefesten
Unterlage.

1 Erhitzen Sie jeden Einsatz 8 mit dem Lötkolben und drü‐
cken Sie ihn gerade in sein Loch, bis er bündig ist.
2 Gehäuse K : 3 Einsätze im Boden, für die langen Schrau‐
ben. Elektronikbox V : 4 Einsätze in der Servoaufnahme.
3 Lassen Sie sie abkühlen, bevor Sie hineinschrauben. Alle
anderen Schrauben formen ihr Gewinde selbst im
Kunststoff.
Prüfen: Jeder Einsatz sitzt gerade und bündig.

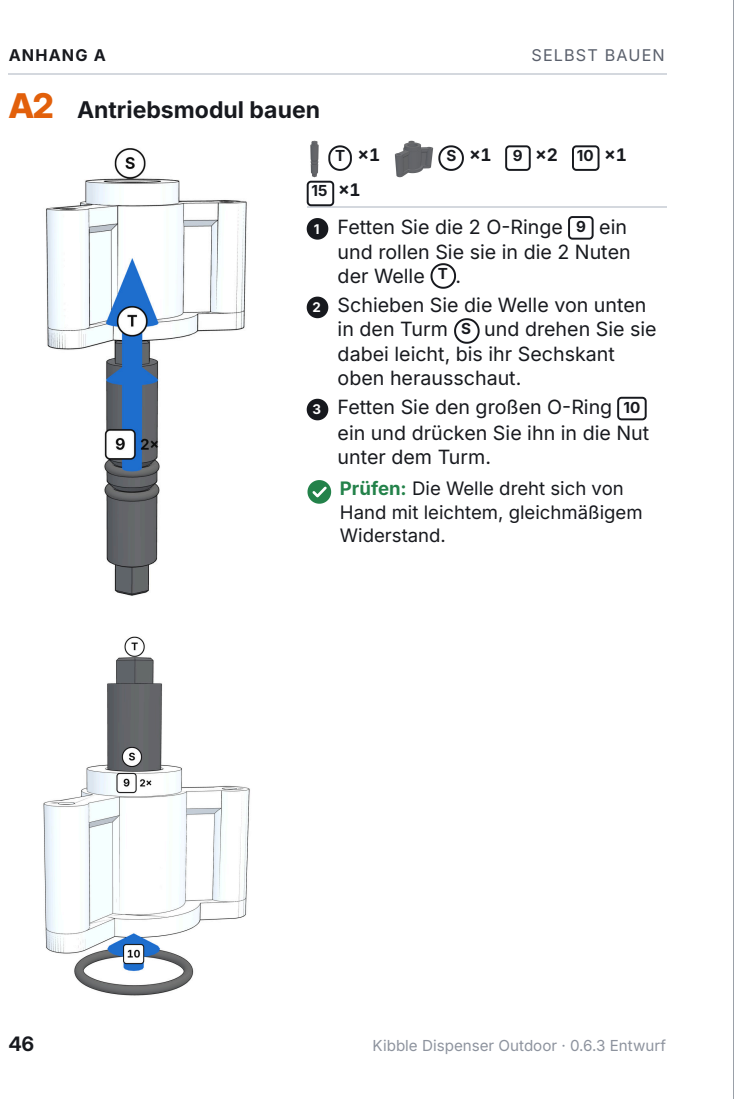
[picture p310: page 46]
A2 Antriebsmodul bauen; ANHANG A; SELBST BAUEN

1 Fetten Sie die 2 O-Ringe 9 ein
und rollen Sie sie in die 2 Nuten
der Welle T .
2 Schieben Sie die Welle von unten
in den Turm S und drehen Sie sie
dabei leicht, bis ihr Sechskant
oben herausschaut.
3 Fetten Sie den großen O-Ring 10
ein und drücken Sie ihn in die Nut
unter dem Turm.
Prüfen: Die Welle dreht sich von
Hand mit leichtem, gleichmäßigem
Widerstand.

46 Kibble Dispenser Outdoor · 0.6.3 Entwurf

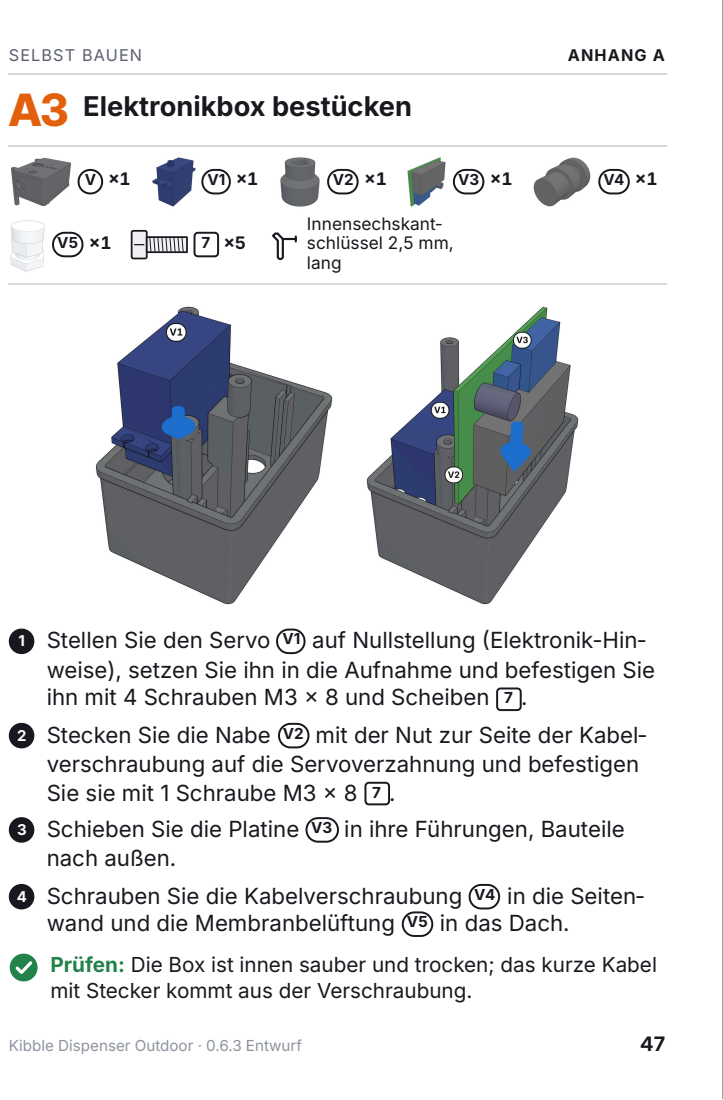
[picture p311: page 47]
A3 Elektronikbox bestücken; Innensechskant‐ schlüssel 2,5 mm, lang; SELBST BAUEN; ANHANG A

1 Stellen Sie den Servo V1 auf Nullstellung (Elektronik-Hin‐
weise), setzen Sie ihn in die Aufnahme und befestigen Sie
ihn mit 4 Schrauben M3 × 8 und Scheiben 7 .
2 Stecken Sie die Nabe V2 mit der Nut zur Seite der Kabel‐
verschraubung auf die Servoverzahnung und befestigen
Sie sie mit 1 Schraube M3 × 8 7 .
3 Schieben Sie die Platine V3 in ihre Führungen, Bauteile
nach außen.
4 Schrauben Sie die Kabelverschraubung V4 in die Seiten‐
wand und die Membranbelüftung V5 in das Dach.
Prüfen: Die Box ist innen sauber und trocken; das kurze Kabel
mit Stecker kommt aus der Verschraubung.

### A4 Optional: Löcher für zusätzliche Tasten

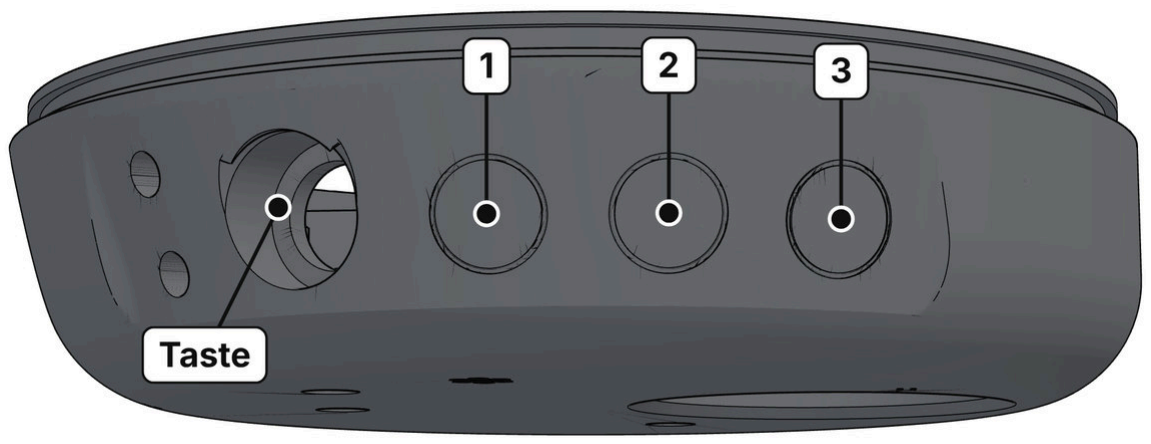
[picture p312: figure]
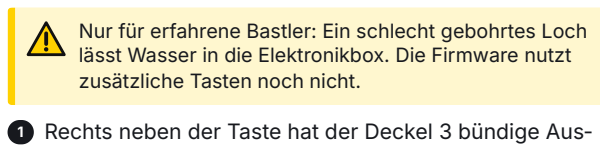
[picture p313: figure]
zusätzliche Tasten noch nicht.

Nur für erfahrene Bastler: Ein schlecht gebohrtes Loch lässt Wasser in die Elektronikbox. Die Firmware nutzt

### 1 Rechts neben der Taste hat der Deckel 3 bündige Aus‐

bruchstellen, jeweils mit eingraviertem Ring und Mittel‐ punkt markiert. Lassen Sie sie geschlossen, wenn Sie keine Taste ergänzen.

### 2 Zum Öffnen legen Sie den Deckel auf eine weiche Unter‐

lage. Bohren Sie am Mittelpunkt senkrecht zur Fläche mit Ø 3 mm vor und öffnen Sie dann von außen mit einem Stu‐ fenbohrer bis zur Stufe Ø 12.

### 3 Entgraten Sie die Innenkante und blasen Sie die Späne

aus. Setzen Sie einen 12-mm-IP67-Taster ein (Mutter bis Schlüsselweite 14) mit einer dünnen Raupe neutral vernet‐ zendem Silikon unter der Dichtung.

ANHANG A | SELBST BAUEN

### 48 Kibble Dispenser Outdoor · 0.6.3 Entwurf

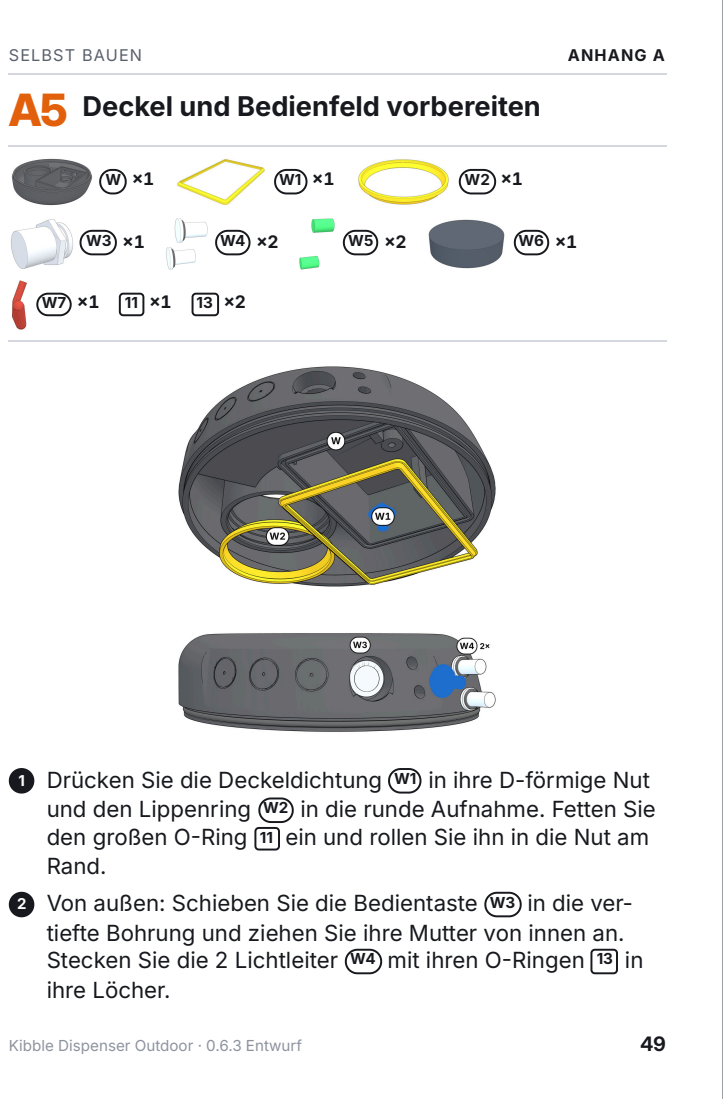
[picture p314: page 49]
SELBST BAUEN; ANHANG A

A5 Deckel und Bedienfeld vorbereiten

1 Drücken Sie die Deckeldichtung W1 in ihre D-förmige Nut
und den Lippenring W2 in die runde Aufnahme. Fetten Sie
den großen O-Ring 11 ein und rollen Sie ihn in die Nut am
Rand.
2 Von außen: Schieben Sie die Bedientaste W3 in die ver‐
tiefte Bohrung und ziehen Sie ihre Mutter von innen an.
Stecken Sie die 2 Lichtleiter W4 mit ihren O-Ringen 13 in
ihre Löcher.

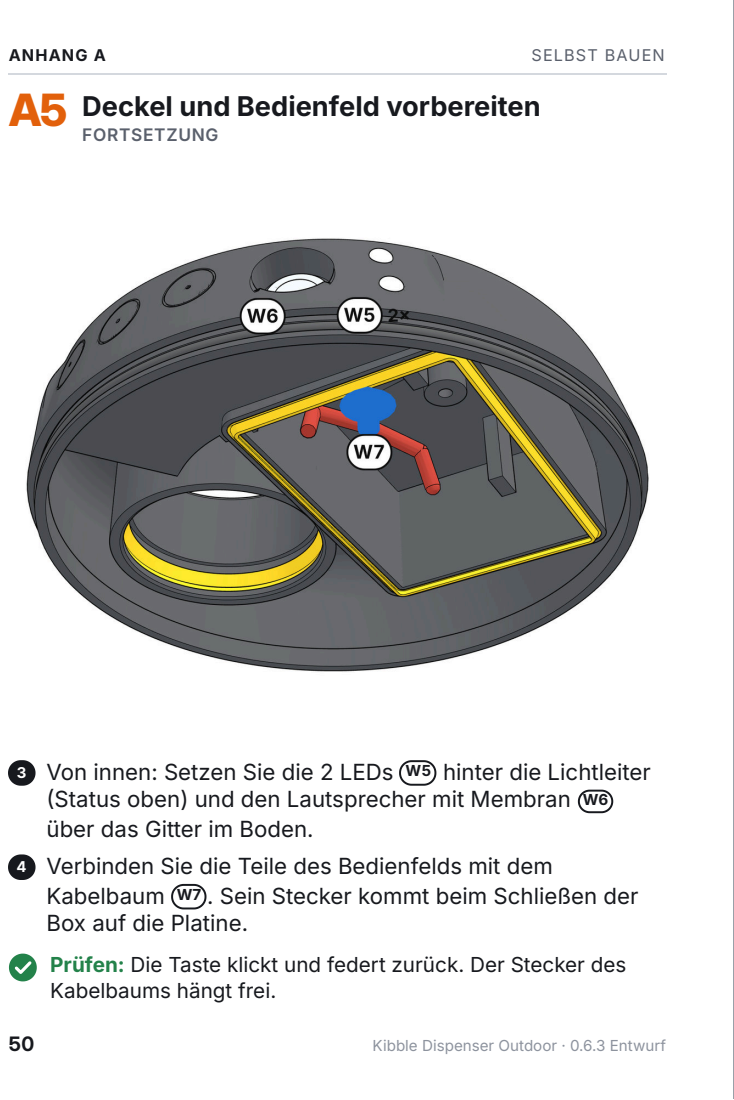
[picture p315: page 50]
FORTSETZUNG; ANHANG A; SELBST BAUEN

A5 Deckel und Bedienfeld vorbereiten

3 Von innen: Setzen Sie die 2 LEDs W5 hinter die Lichtleiter
(Status oben) und den Lautsprecher mit Membran W6
über das Gitter im Boden.
4 Verbinden Sie die Teile des Bedienfelds mit dem
Kabelbaum W7 . Sein Stecker kommt beim Schließen der
Box auf die Platine.
Prüfen: Die Taste klickt und federt zurück. Der Stecker des
Kabelbaums hängt frei.

50 Kibble Dispenser Outdoor · 0.6.3 Entwurf

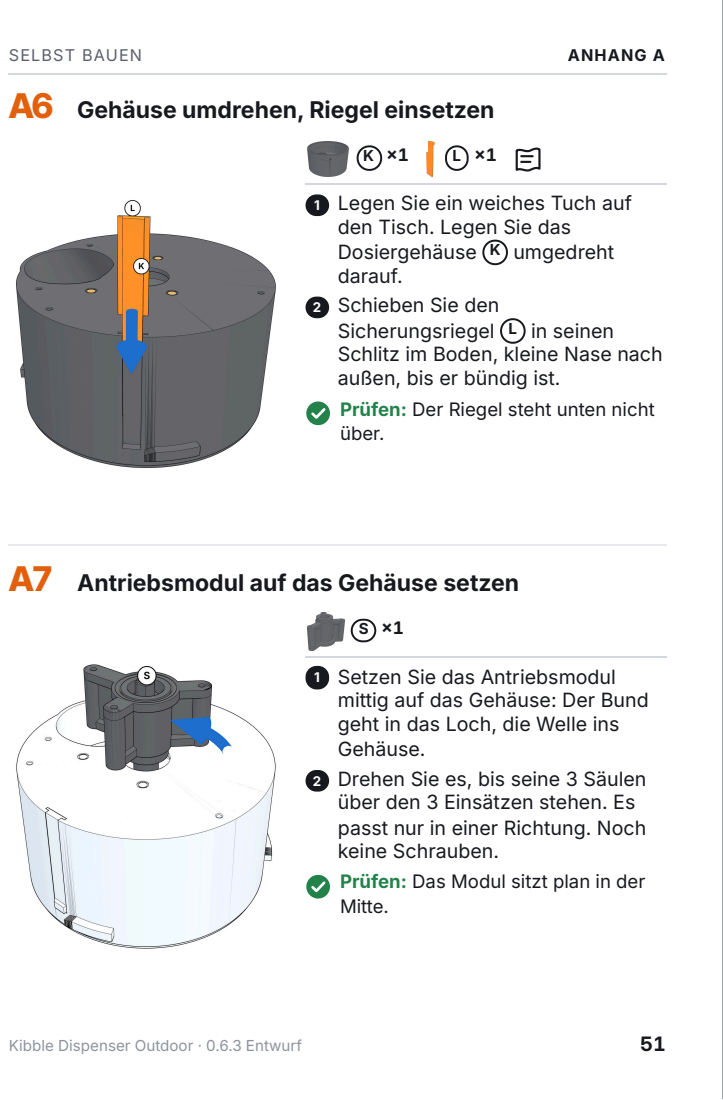
[picture p316: page 51]
SELBST BAUEN; ANHANG A

A6 Gehäuse umdrehen, Riegel einsetzen

1 Legen Sie ein weiches Tuch auf
den Tisch. Legen Sie das
Dosiergehäuse K umgedreht
darauf.
2 Schieben Sie den
Sicherungsriegel L in seinen
Schlitz im Boden, kleine Nase nach
außen, bis er bündig ist.
Prüfen: Der Riegel steht unten nicht
über.

A7 Antriebsmodul auf das Gehäuse setzen

1 Setzen Sie das Antriebsmodul
mittig auf das Gehäuse: Der Bund
geht in das Loch, die Welle ins
Gehäuse.
2 Drehen Sie es, bis seine 3 Säulen
über den 3 Einsätzen stehen. Es
passt nur in einer Richtung. Noch
keine Schrauben.
Prüfen: Das Modul sitzt plan in der
Mitte.

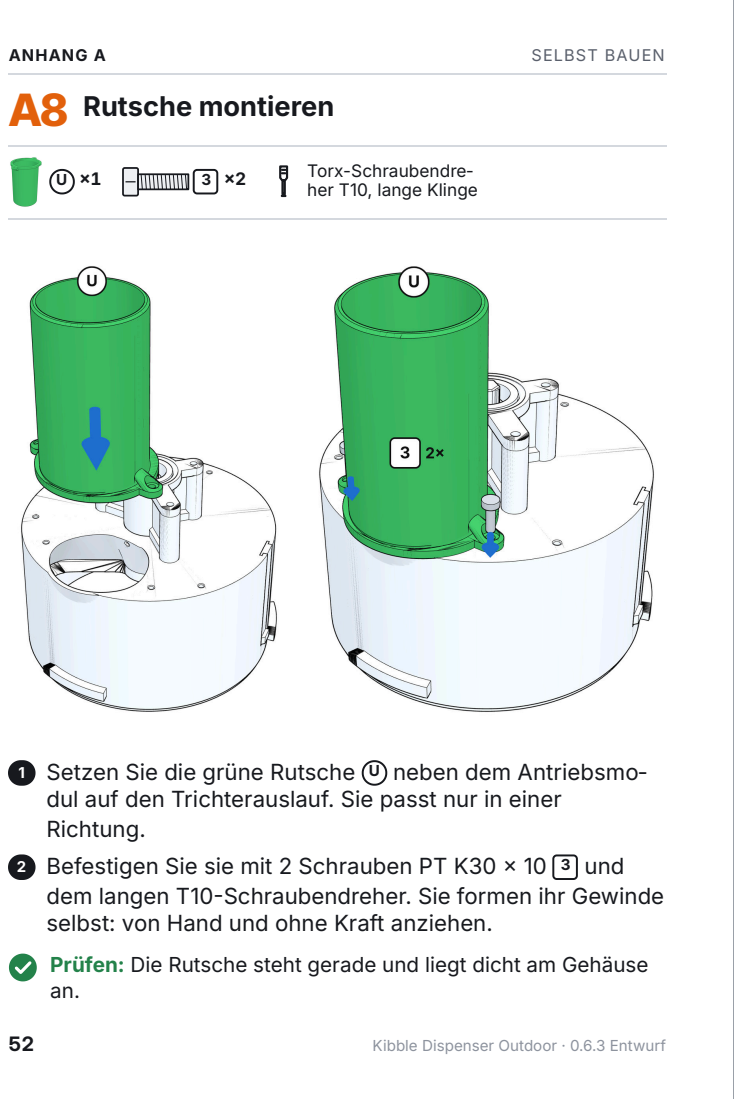
[picture p317: page 52]
A8 Rutsche montieren; ANHANG A; SELBST BAUEN

Torx-Schraubendre‐
her T10, lange Klinge

1 Setzen Sie die grüne Rutsche U neben dem Antriebsmo‐
dul auf den Trichterauslauf. Sie passt nur in einer
Richtung.
2 Befestigen Sie sie mit 2 Schrauben PT K30 × 10 3 und
dem langen T10-Schraubendreher. Sie formen ihr Gewinde
selbst: von Hand und ohne Kraft anziehen.
Prüfen: Die Rutsche steht gerade und liegt dicht am Gehäuse

52 Kibble Dispenser Outdoor · 0.6.3 Entwurf

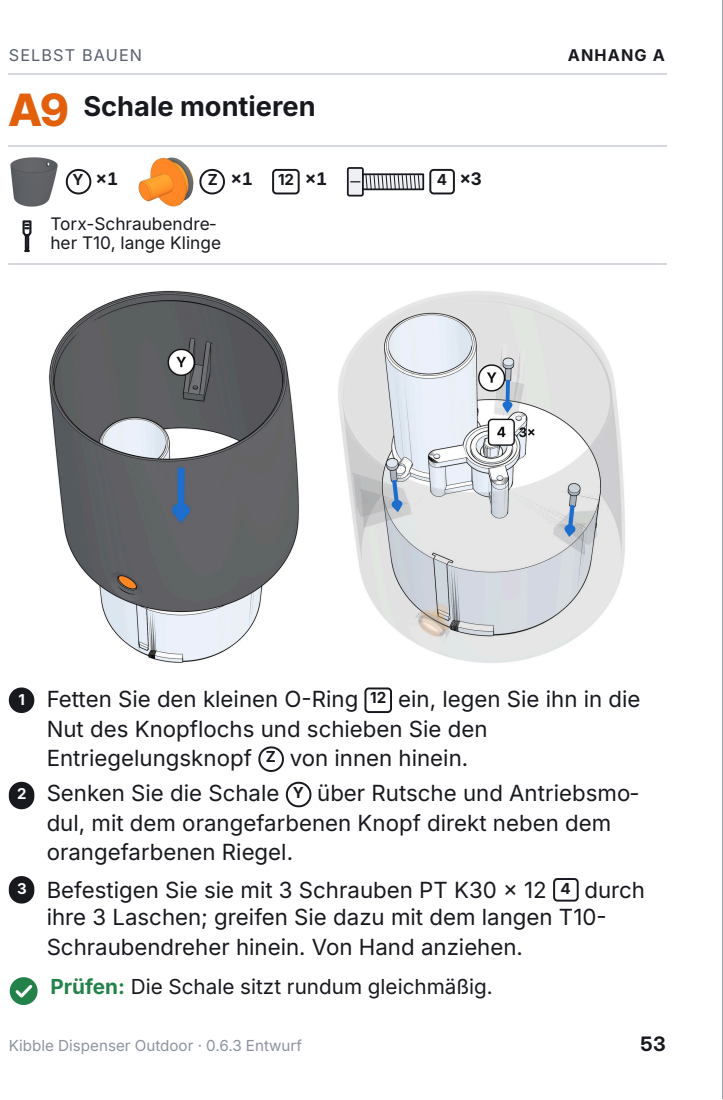
[picture p318: page 53]
A9 Schale montieren; SELBST BAUEN; ANHANG A

Torx-Schraubendre‐
her T10, lange Klinge

1 Fetten Sie den kleinen O-Ring 12 ein, legen Sie ihn in die
Nut des Knopflochs und schieben Sie den
Entriegelungsknopf Z von innen hinein.
2 Senken Sie die Schale Y über Rutsche und Antriebsmo‐
dul, mit dem orangefarbenen Knopf direkt neben dem
orangefarbenen Riegel.
3 Befestigen Sie sie mit 3 Schrauben PT K30 × 12 4 durch
ihre 3 Laschen; greifen Sie dazu mit dem langen T10-
Schraubendreher hinein. Von Hand anziehen.
Prüfen: Die Schale sitzt rundum gleichmäßig.

### A10 Elektronikbox einsetzen

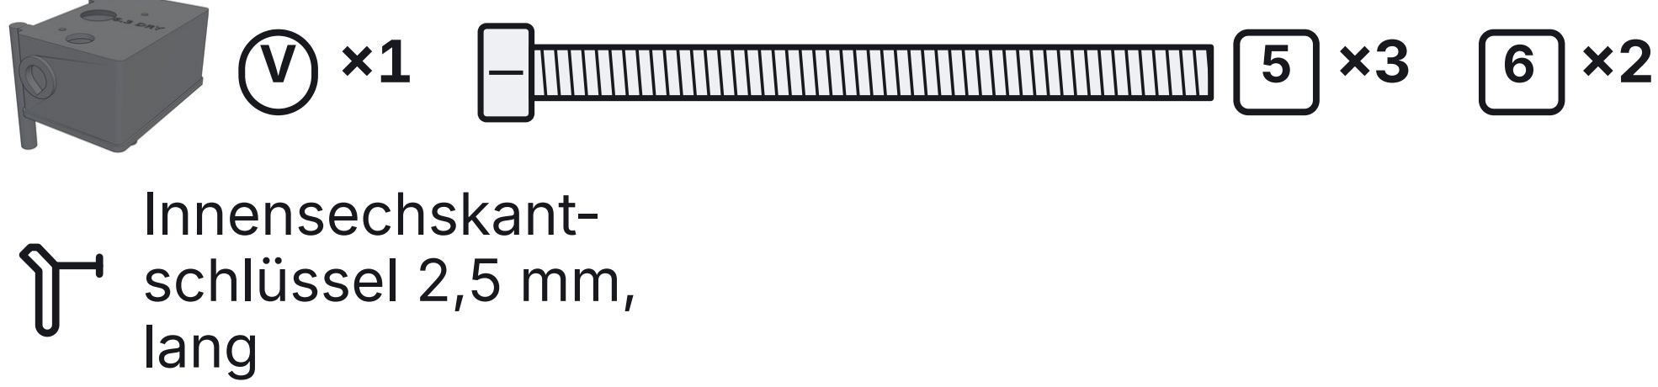
[picture p319: figure]
Innensechskant‐ schlüssel 2,5 mm, lang

### 1 Drehen Sie das Wellenende, bis seine kleine Rippe zum

orangefarbenen Riegel zeigt.

### 2 Senken Sie die Box V mit der offenen Seite nach oben in

die Schale auf das Antriebsmodul: Die Welle geht in die Nabe. Sie passt nur in einer Richtung.

### 3 Legen Sie unter die Köpfe der 2 Schrauben, die innen in

der Box sitzen, je einen O-Ring 6 .

### 4 Drehen Sie die 3 langen Schrauben M3 × 40 5 mit dem

langen Innensechskantschlüssel ein. Handfest anziehen.

### 5 Legen Sie das kurze Kabel am Gehäuse entlang, sodass

der Stecker knapp unter dem Rand der Schale liegt. Prüfen: Die Box liegt ohne Spalt plan auf dem Modul.

ANHANG A | SELBST BAUEN

### 54 Kibble Dispenser Outdoor · 0.6.3 Entwurf

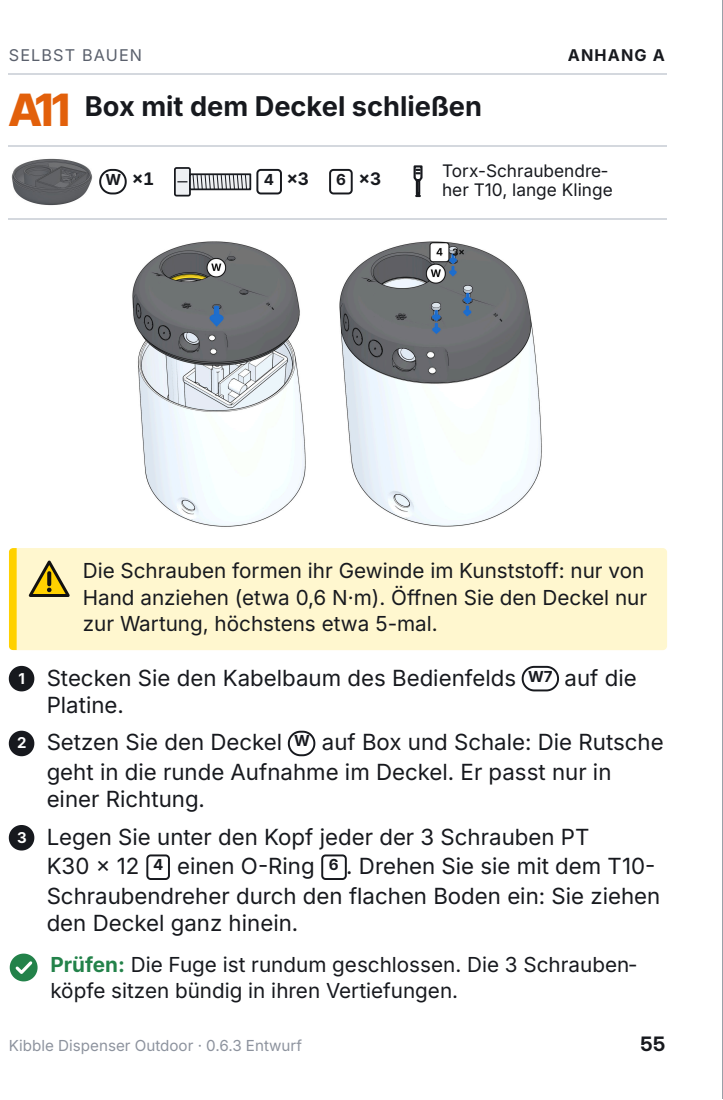
[picture p320: page 55]
SELBST BAUEN; ANHANG A

A11 Box mit dem Deckel schließen

Torx-Schraubendre‐
her T10, lange Klinge

Die Schrauben formen ihr Gewinde im Kunststoff: nur von
Hand anziehen (etwa 0,6 N·m). Öffnen Sie den Deckel nur
zur Wartung, höchstens etwa 5-mal.

1 Stecken Sie den Kabelbaum des Bedienfelds W7 auf die
Platine.
2 Setzen Sie den Deckel W auf Box und Schale: Die Rutsche
geht in die runde Aufnahme im Deckel. Er passt nur in
einer Richtung.
3 Legen Sie unter den Kopf jeder der 3 Schrauben PT
K30 × 12 4 einen O-Ring 6 . Drehen Sie sie mit dem T10-
Schraubendreher durch den flachen Boden ein: Sie ziehen
den Deckel ganz hinein.
Prüfen: Die Fuge ist rundum geschlossen. Die 3 Schrauben‐
köpfe sitzen bündig in ihren Vertiefungen.

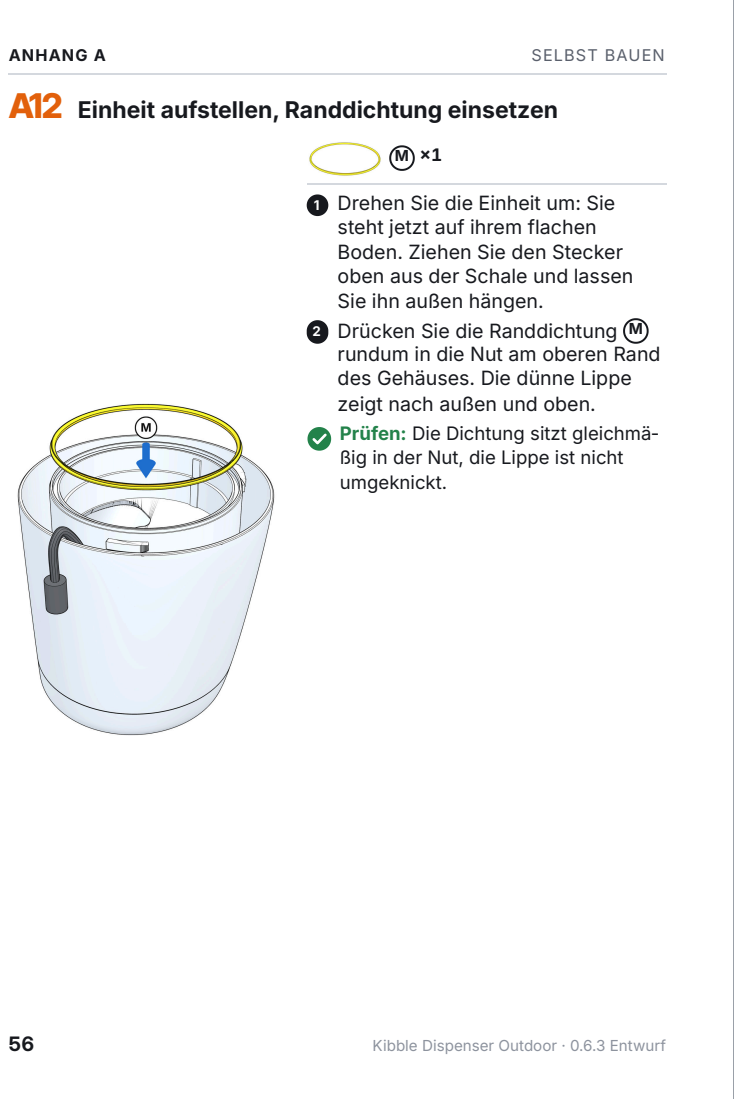
[picture p321: page 56]
ANHANG A; SELBST BAUEN

A12 Einheit aufstellen, Randdichtung einsetzen

1 Drehen Sie die Einheit um: Sie
steht jetzt auf ihrem flachen
Boden. Ziehen Sie den Stecker
oben aus der Schale und lassen
Sie ihn außen hängen.
2 Drücken Sie die Randdichtung M
rundum in die Nut am oberen Rand
des Gehäuses. Die dünne Lippe
zeigt nach außen und oben.
Prüfen: Die Dichtung sitzt gleichmä‐
ßig in der Nut, die Lippe ist nicht
umgeknickt.

56 Kibble Dispenser Outdoor · 0.6.3 Entwurf

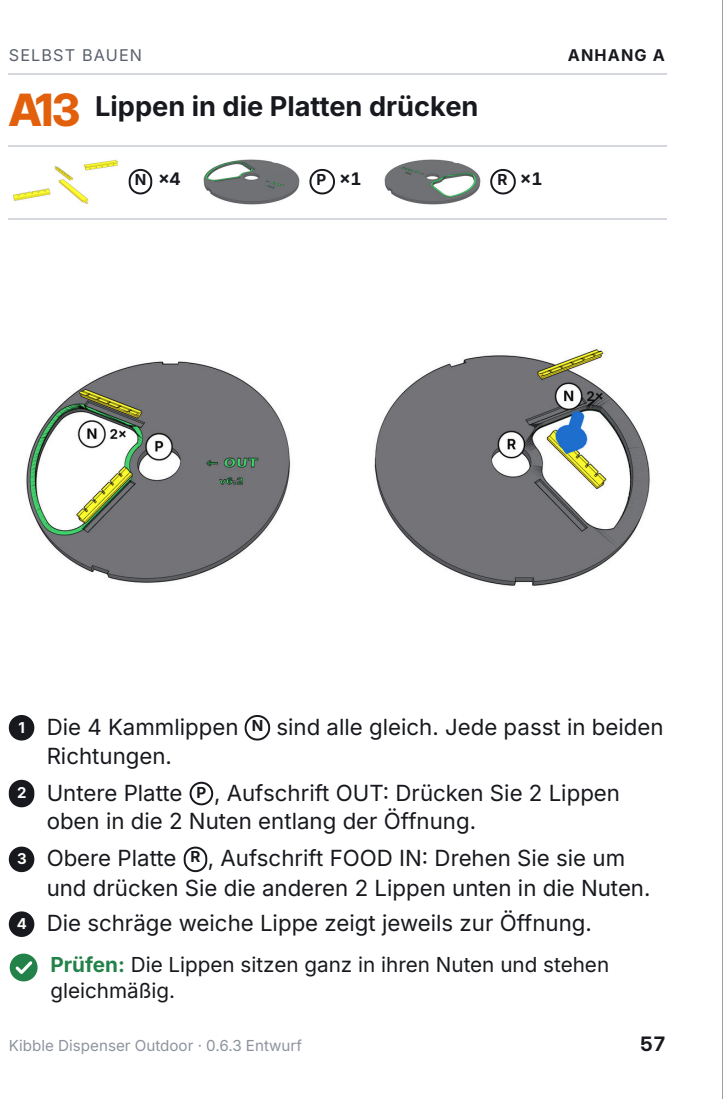
[picture p322: page 57]
SELBST BAUEN; ANHANG A

A13 Lippen in die Platten drücken

1 Die 4 Kammlippen N sind alle gleich. Jede passt in beiden
Richtungen.
2 Untere Platte P , Aufschrift OUT: Drücken Sie 2 Lippen
oben in die 2 Nuten entlang der Öffnung.
3 Obere Platte R , Aufschrift FOOD IN: Drehen Sie sie um
und drücken Sie die anderen 2 Lippen unten in die Nuten.
4 Die schräge weiche Lippe zeigt jeweils zur Öffnung.
Prüfen: Die Lippen sitzen ganz in ihren Nuten und stehen
gleichmäßig.

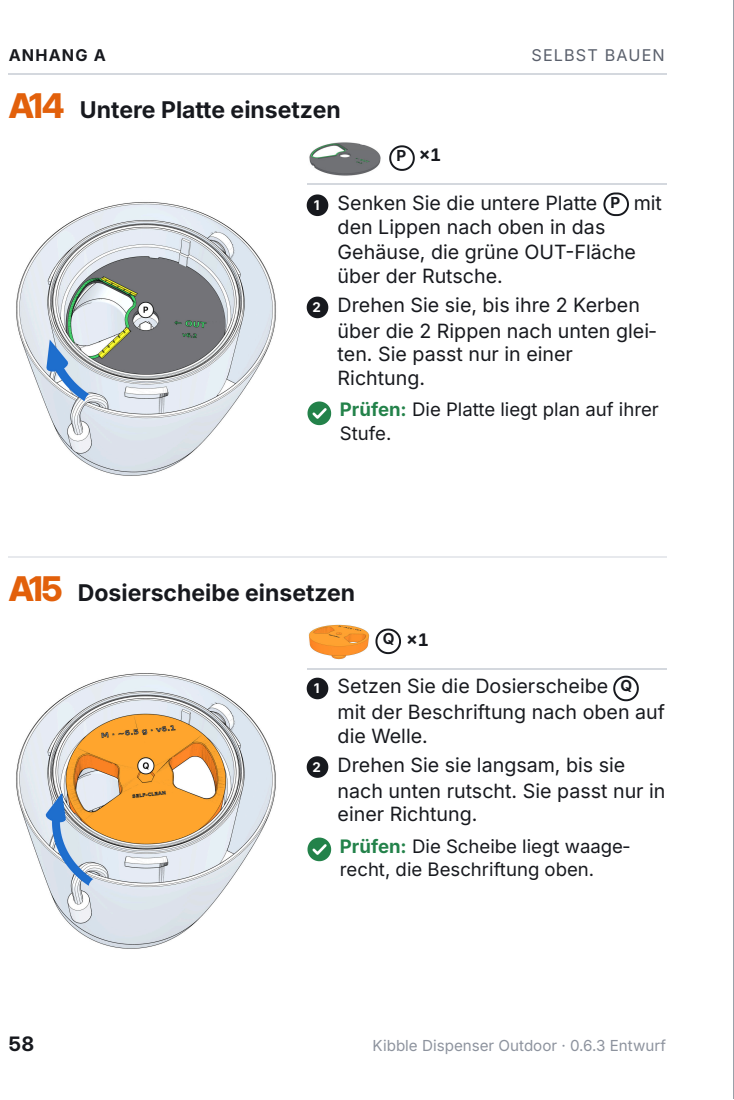
[picture p323: page 58]
A15 Dosierscheibe einsetzen; ANHANG A; SELBST BAUEN

A14 Untere Platte einsetzen

1 Senken Sie die untere Platte P mit
den Lippen nach oben in das
Gehäuse, die grüne OUT-Fläche
über der Rutsche.
2 Drehen Sie sie, bis ihre 2 Kerben
über die 2 Rippen nach unten glei‐
ten. Sie passt nur in einer
Richtung.
Prüfen: Die Platte liegt plan auf ihrer
Stufe.

1 Setzen Sie die Dosierscheibe Q
mit der Beschriftung nach oben auf
die Welle.
2 Drehen Sie sie langsam, bis sie
nach unten rutscht. Sie passt nur in
einer Richtung.
Prüfen: Die Scheibe liegt waage‐
recht, die Beschriftung oben.

58 Kibble Dispenser Outdoor · 0.6.3 Entwurf

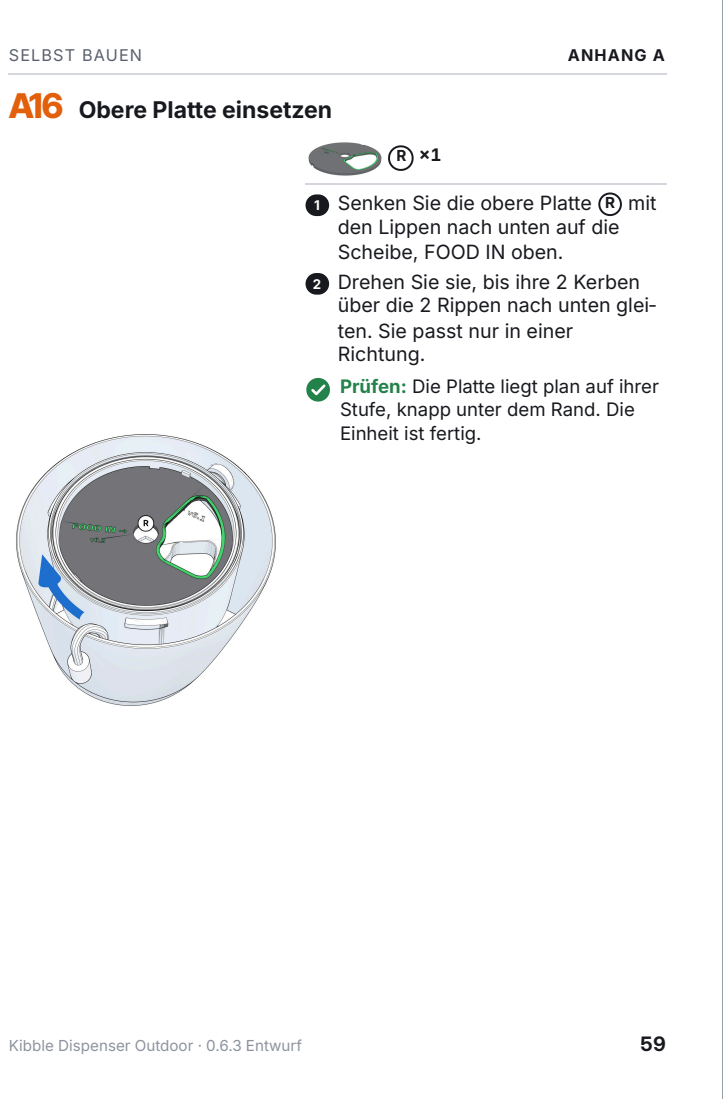
[picture p324: page 59]
SELBST BAUEN; ANHANG A

A16 Obere Platte einsetzen

1 Senken Sie die obere Platte R mit
den Lippen nach unten auf die
Scheibe, FOOD IN oben.
2 Drehen Sie sie, bis ihre 2 Kerben
über die 2 Rippen nach unten glei‐
ten. Sie passt nur in einer
Richtung.
Prüfen: Die Platte liegt plan auf ihrer
Stufe, knapp unter dem Rand. Die
Einheit ist fertig.

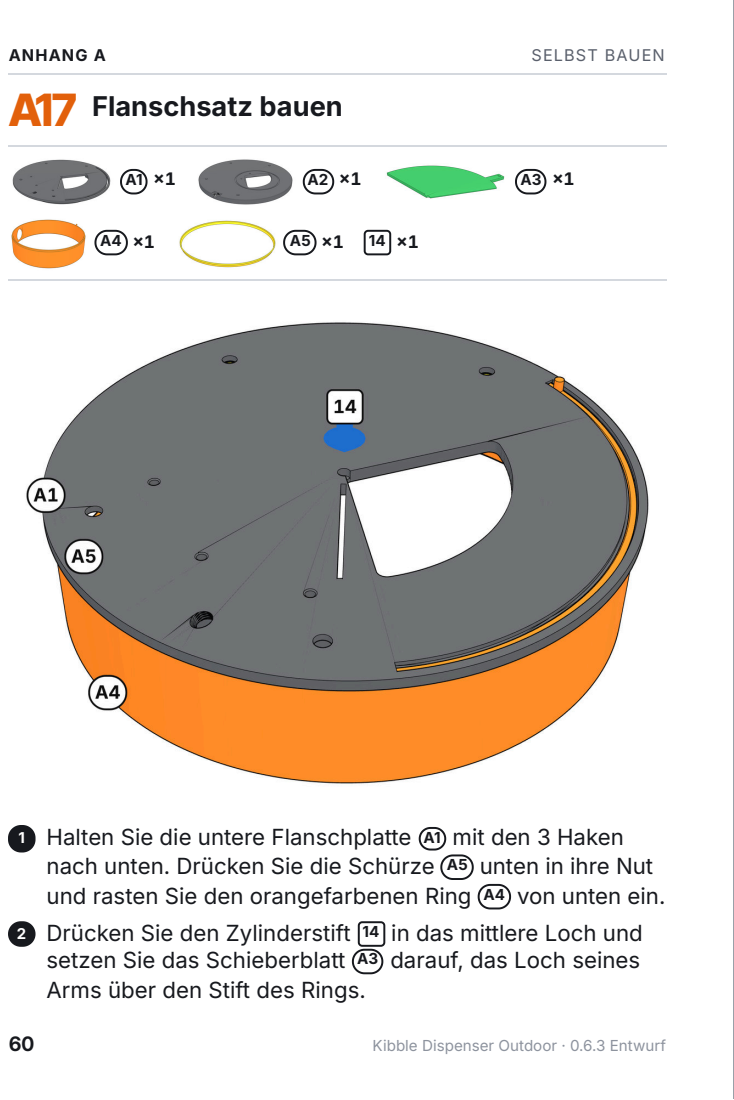
[picture p325: page 60]
A17 Flanschsatz bauen; ANHANG A; SELBST BAUEN

1 Halten Sie die untere Flanschplatte A1 mit den 3 Haken
nach unten. Drücken Sie die Schürze A5 unten in ihre Nut
und rasten Sie den orangefarbenen Ring A4 von unten ein.
2 Drücken Sie den Zylinderstift
setzen Sie das Schieberblatt A3 darauf, das Loch seines
Arms über den Stift des Rings.

14 in das mittlere Loch und

60 Kibble Dispenser Outdoor · 0.6.3 Entwurf

### A17 Flanschsatz bauen

FORTSETZUNG

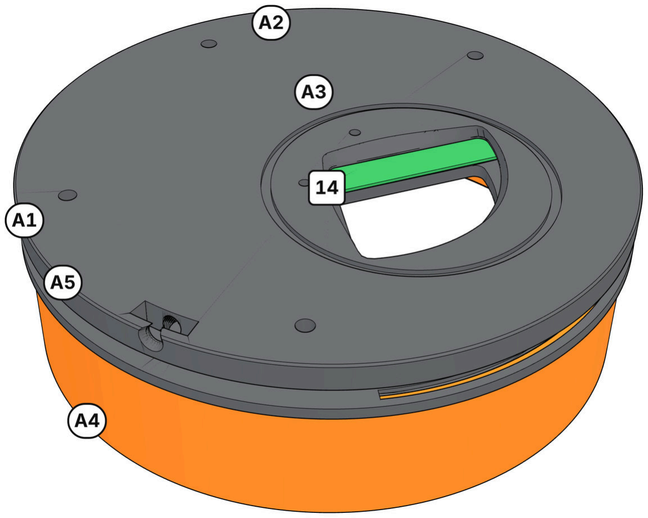
[picture p326: figure]

### 3 Setzen Sie die obere Platte A2 auf und drücken Sie sie an:

Ihre 3 Stifte gehen in die untere Platte und halten den Satz zusammen.

### 4 Die Kabeltülle A6 kommt auf das Netzkabel: Sie setzen sie

mit dem Kabel ein, wenn Sie den Flansch montieren (Schritt 4).
Prüfen: Beim Drehen des Rings bewegt sich das Blatt zwi‐ schen OFFEN und ZU.
Einheit und Flanschsatz sind fertig. Installieren Sie sie jetzt wie den Bausatz: weiter mit Schritt 1, Seite 10.
SELBST BAUEN | ANHANG A

ANHANG B

## Dichtheitstest zu Hause

Optional, für Selbstbauer: eine Prüfung der Dichtungen, keine Zertifizierung.

### 1 Nehmen Sie die Elektronik aus der Box oder testen Sie vor

dem Einbau. Nie mit angeschlossenem Strom testen.

### 2 Legen Sie Streifen aus trockenem Küchenpapier in die Box

(an die Kabelverschraubung, die Belüftung, die 2 Schrauben‐ köpfe im Dach, entlang der Deckeldichtung) und in den Deckel hinter das Bedienfeld (Taste, Lichtleiter, Lautspre‐ cher), dazu einige in die Schale, einen davon neben die Kabeltülle unter dem Flansch.

### 3 Schließen Sie den Deckel mit seinen 3 Schrauben und O-

Ringen und hängen Sie die Einheit wie im Betrieb in ihren Flanschsatz unter ein Brett, den Schieber auf OFFEN.

### 4 Bespritzen Sie sie mit einem Gartenschlauch und einer Strahl‐

düse (etwa 6 mm, etwa 12,5 l/min: Ein 10-l-Eimer ist in 48 s voll) aus 2,5–3 m Abstand, von allen Seiten und von unten, 3– 4 Minuten lang. Spritzen Sie auch auf das Bedienfeld.

### 5 Trocknen Sie die Außenseite, nehmen Sie die Einheit ab und

öffnen Sie den Deckel über einem Handtuch; heben Sie ihn wegen des Bedienfeldkabels nur wenig an.

Prüfen: Trockene Streifen in der Box: bestanden. Ein nasser Streifen zeigt, wo Wasser eindringt.
Für eine genauere Prüfung wiegen Sie einen 10-g-Silicagelbeutel auf einer 0,01-g-Waage und legen ihn in die Box: Nimmt er weniger als 0,05 g zu, ist kein Wasser eingedrungen.
ANHANG B | DICHTHEITSTEST ZU HAUSE

### 62 Kibble Dispenser Outdoor · 0.6.3 Entwurf

## Notizen

KIBBLE DISPENSER OUTDOOR | NOTIZEN

## Kibble Dispenser Outdoor

Bedienungsanleitung · Deutsch

https://ricricucit.github.io/kibble-dispenser/ Scannen für die 3D-Anleitung und die Konstruktionsdateien

### 0.6.3 Entwurf · Konstruktion v6.3

Vorläufig: noch nicht gedruckt oder getestet
Text und Bilder CC BY 4.0 · Hardware CERN-OHL-P-2.0 · Software MIT © 2026 Enrico Icardi und Mitwirkende
