ricricucit/kibble-dispenser/site/img/manual-cover-de.webp

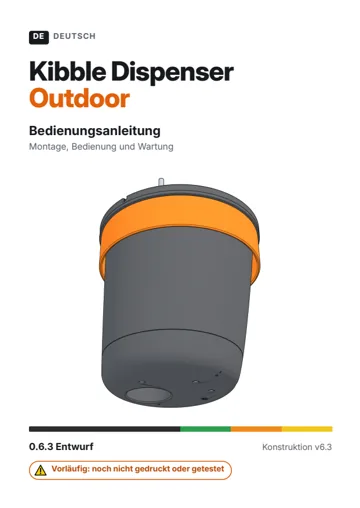
site/img/manual-cover-de.webp
