ricricucit/kibble-dispenser/site/img/manual-cover-en.webp

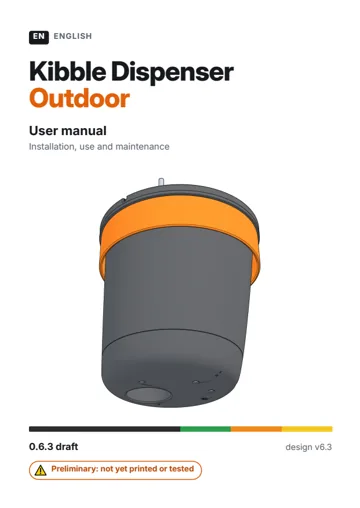
site/img/manual-cover-en.webp
