ricricucit/kibble-dispenser/site/assembly/template/dima_foratura_v63.pdf

# Kibble Dispenser Outdoor v6.3 - drilling template 1:1

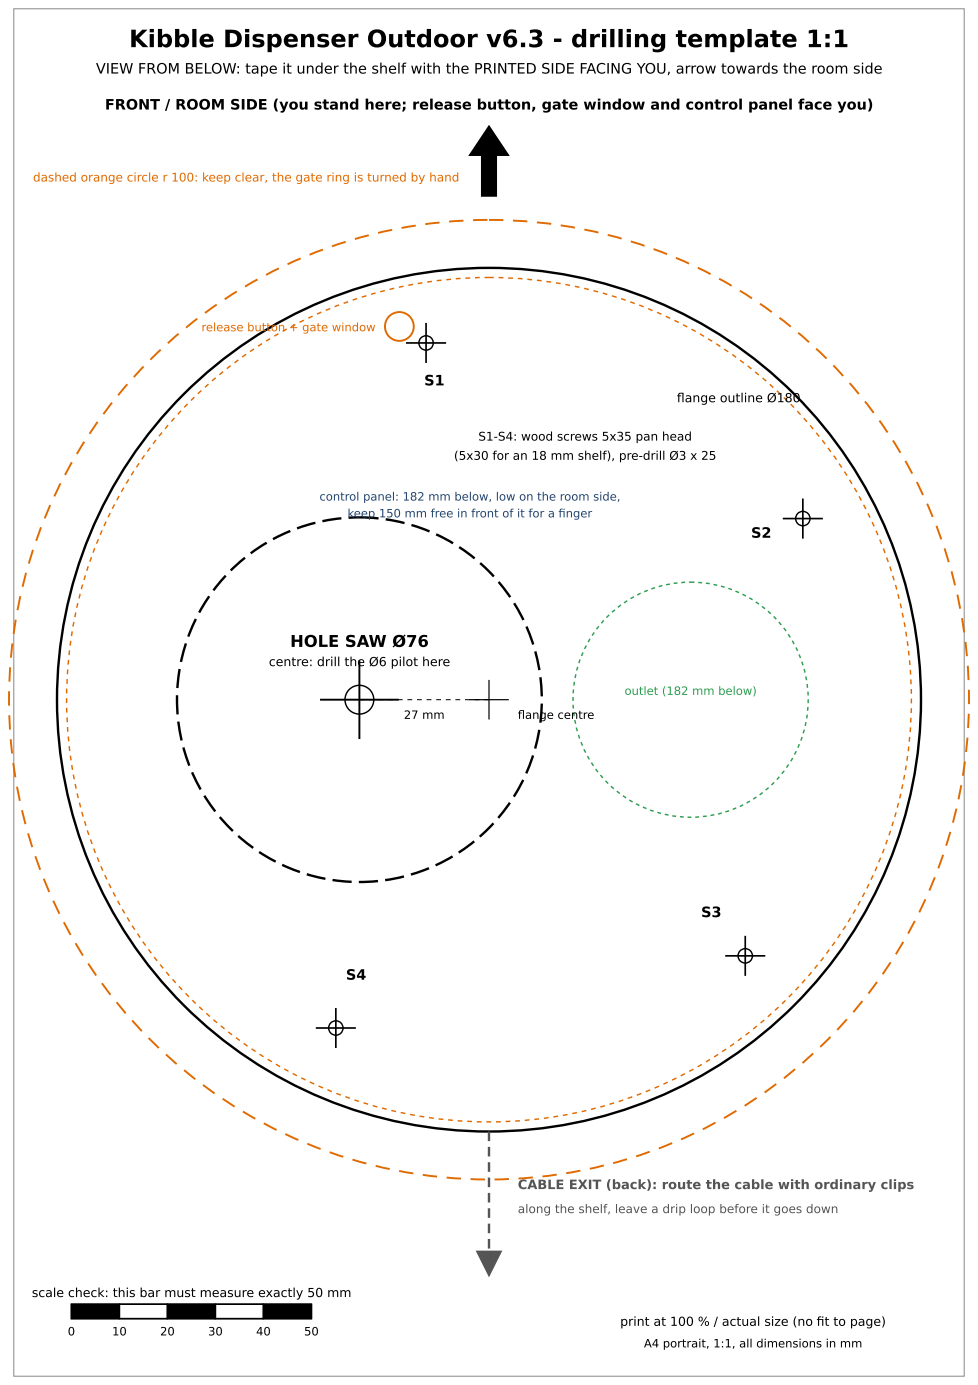
[picture p331: page 1]
flange outline Ø180; flange centre

VIEW FROM BELOW: tape it under the shelf with the PRINTED SIDE FACING YOU, arrow towards the room side

FRONT / ROOM SIDE (you stand here; release button, gate window and control panel face you)

dashed orange circle r 100: keep clear, the gate ring is turned by hand

release button + gate window

S1-S4: wood screws 5x35 pan head
(5x30 for an 18 mm shelf), pre-drill Ø3 x 25

control panel: 182 mm below, low on the room side,
keep 150 mm free in front of it for a finger

HOLE SAW Ø76
centre: drill the Ø6 pilot here

outlet (182 mm below)

CABLE EXIT (back): route the cable with ordinary clips

along the shelf, leave a drip loop before it goes down

scale check: this bar must measure exactly 50 mm

print at 100 % / actual size (no fit to page)

A4 portrait, 1:1, all dimensions in mm
