ricricucit/kibble-dispenser/site/v6.2/assembly/template/dima_foratura_v62.pdf

# Kibble Dispenser Outdoor v6.2 - drilling template 1:1

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

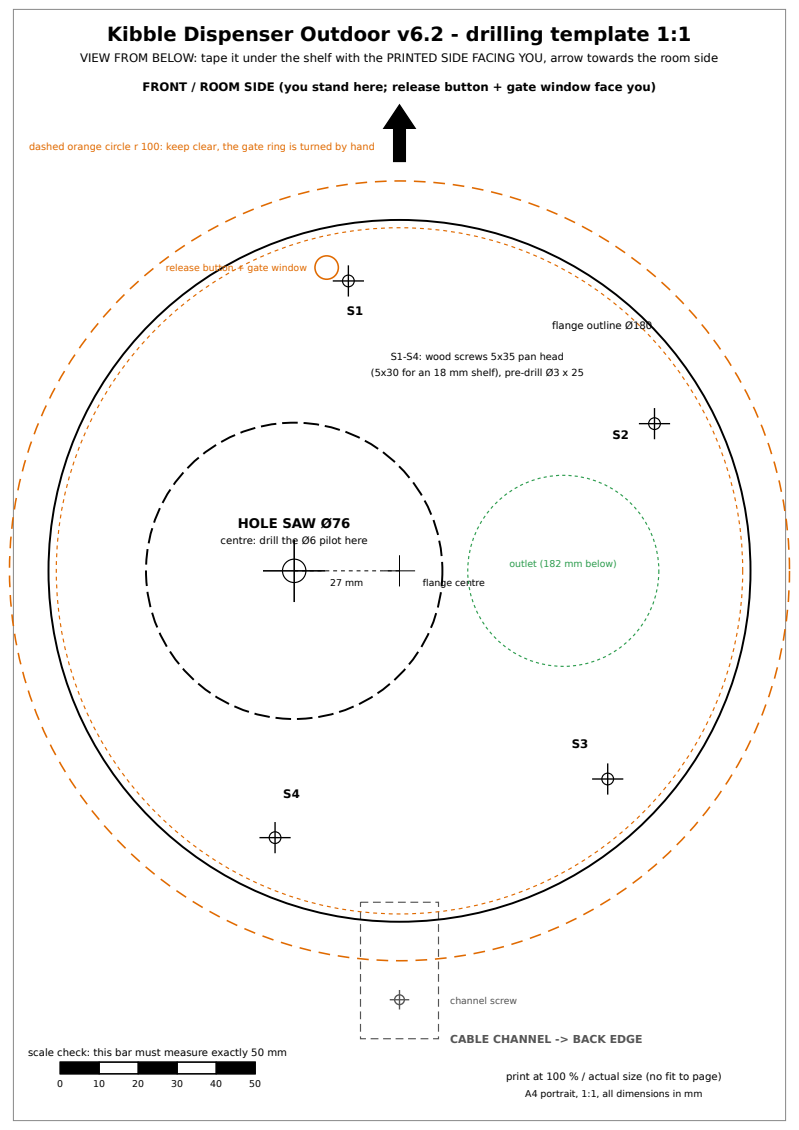
[picture p332: page 1]
channel screw; flange outline Ø180; flange centre

FRONT / ROOM SIDE (you stand here; release button + gate window face you)

dashed orange circle r 100: keep clear, the gate ring is turned by hand

release button + gate window

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

HOLE SAW Ø76
centre: drill the Ø6 pilot here

outlet (182 mm below)

CABLE CHANNEL -> BACK EDGE

scale check: this bar must measure exactly 50 mm

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
