ricricucit/kibble-dispenser/(commit log)

2026-11-08 Initial import: prototype 1 drivetrain, chute, research, ESPHome draft
    - hardware: drivetrain and chute generators (paths relative to the script
    folder), layout_v3 and drivetrain data, print-ready STLs, 3MFs, mesh check
    - firmware: ESPHome draft for the Freenove ESP32-S3 WROOM CAM, wiring summary
    - docs: research notes (Italian), build guide and getting-started
    placeholders, process photos with metadata removed
    - licensing: MIT (software), CERN-OHL-P-2.0 (hardware), CC-BY-4.0 (docs),
    REUSE.toml and LICENSES/
    - project hygiene: README, CONTRIBUTING, CHANGELOG, CODE_OF_CONDUCT,
    SECURITY, issue and PR templates, CI workflow
    Claude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
    [albero_mozzo.3mf, albero_mozzo.stl, disco_v3.3mf, disco_v3.stl, passante_stagno.3mf, passante_stagno.stl, scivolo_v1.3mf, scivolo_v1.stl]
2026-11-08 Add project website with a live 3D model, published to GitHub Pages
    - site/: static page (HTML, CSS, JS modules) with the full-bleed 3D assembly:
    orbit/zoom/pan, full screen (with a fallback when the browser refuses),
    section through the shaft axis, exploded view, servo angle 0-180 degrees
    with a portion-drop animation, part isolation, BOM balloons, shortcuts
    F/X/S/R/L. three.js 0.160.1 is vendored in site/vendor/three (MIT).
    - site/build.py builds the site into site/_build from hardware/assembly and
    docs/photos (captions from docs/photos/README.md), standard library only.
    - hardware/cad/build_assembly.py and hardware/assembly/: assembly-frame
    meshes (shaft-axis frame for the dri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
    [albero_mozzo.stl, disco_v3.stl, passante_stagno.stl, scivolo_v1.stl]
2026-11-08 docs: instruct collaborating Claude session to use physical prototype as baseline
2026-11-08 docs: reserve non-destructive import of original on-device MicroPython firmware
2026-11-08 docs: put working MicroPython prototype first in project README
2026-11-08 feat(firmware): import feedr-outdoor MicroPython firmware as primary; fix board to ESP32 WROVER
    Import the owner's MicroPython firmware into firmware/micropython/ as the
    baseline firmware for prototype 1, byte-for-byte from a snapshot of his
    development folder (feedr-outdoor 0.1.0 plus the uncommitted edits of
    2026-03-24). It is not an on-device readback; that stays pending for
    import/previous-chat/.
    - New firmware/micropython/README.md: provenance, behaviour, pin map as
    defined in the dev source (not yet electrically verified), 5 V bench
    power, quick start, calibration.
    - Board: Freenove ESP32-WROVER (classic ESP32) as documented in
    PROJECT.md, to be verified on the device. ESPHome d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
    [build_assembly.py, buttons.py, config.py, dispenser.py, hardware.py, kibble-dispenser.yaml, main.py]
2026-11-08 feat(hardware): drivetrain v3 with lid-mounted servo cradle and labyrinth cap
    Integrate the finished drivetrain v3 design. All parts are designed only:
    not printed, mounted or tested yet. The as-built prototype still uses the
    third-party wall bracket (CC BY-NC-SA), which stays out of the repository.
    - passante_culla replaces passante_stagno: sealed bushing and servo
    cradle in one part (53 mm flange, 45x2 face O-ring, collar top z=5,
    four servo pads with heat-set inserts).
    - disco_v3 gains a sleeve and labyrinth cap; albero_mozzo has a 22 mm
    hub with a 45 deg cone and 9x2 O-ring grooves (print at 100 % infill).
    - Single parametric build_drivetrain.py with repository-relative paths;
    r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
    [albero_mozzo.3mf, albero_mozzo.stl, disco_v3.3mf, disco_v3.stl, passante_culla.3mf, passante_culla.stl, passante_stagno.3mf, passante_stagno.stl]
2026-11-08 docs(photos): bench photos of the WROVER breadboard prototype
    Claude-Session: https://claude.ai/code/session_01EQ9ZunTgLrjJt4gR11tNLT
2026-11-09 feat(hardware): add design v6, the one-twist unit (CAD only, not printed)
    Everything under the shelf comes off with one quarter-turn of the bowl
    bayonet: dosing bowl, chute, disc, sealed tower with shaft and hub,
    electronics box with the servo cradle, cover with a TPU lip seal and four
    printed quarter-turn buttons. Only the shelf flange stays on the shelf.
    Designed and checked in CAD; nothing is printed, assembled or tested yet.
    - hardware/v6/cad: build_v6.py and build_v6_checks.py plus the scripts
    v6 imports (v4b dosing core, v5, drivetrain v4 as a library, layout),
    with relative paths; build_v6.py runs its prerequisites when needed and
    publish_v6.py writes the repository files. Rege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
    [albero_v6.3mf, albero_v6.stl, bought_breadboard.stl, bought_cap_1000uF.stl, bought_esp32.stl, bought_gland_m16.stl, bought_inserts_bowl.stl, bought_inserts_box.stl]
2026-11-09 feat(site): full-screen 3D page for design v6
    The viewer generator moves into the repository as site/viewer/
    (make_viewer.py and template.html) and site/build.py uses it to write
    v6/3d/ from hardware/v6/assembly/.
    - Meshes can be written as separate decimated binary STL files that the
    page fetches by URL (<id>.<hash>.stl); the single-file mode with
    embedded meshes stays for previews.
    - Full-screen button: Fullscreen API, or a CSS fallback that hides the
    controls where the API is missing (iPhone Safari); key F.
    - Interface text in English, Italian and German (?lang=, last choice,
    browser language), manifest texts may be per language, links back to
    the site, a short status in the co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
2026-11-09 feat(docs): bought parts of v6 in English, Italian and German
    hardware/v6/bom.json lists what to buy besides the printed parts:
    fasteners and inserts, seals and grease, the electronics module
    (pre-assembled in the kit, listed for DIY builders), the optional DN50
    pipe and the tools. No shop links.
    - site/bom.py checks it against cad/v6.json (every hardware line covered,
    quantities equal) and renders docs/BOM.md and the site page v6/parts/.
    - The page carries every text once per language; site/js/lang.js picks
    the language from ?lang=, the last choice or the browser (English
    without JavaScript) and keeps it on links to the 3D page.
    - CI checks that docs/BOM.md is up to date.
    Co-Authore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
2026-11-09 docs: point README, hardware notes and the site home page to design v6
    - README: status, what v6 is in three lines, links to the 3D page, the
    bought parts and hardware/v6; print plates, assembly wizard and A6
    manual marked as coming soon.
    - hardware/README.md: v6 is the current design (CAD only, not printed or
    tested); the drivetrain v3 design is superseded and kept for reference,
    and the as-built prototype is still described in the baseline.
    - Site home page: a "Design v6" section and status row with links.
    - CHANGELOG entries for v6, the 3D page, the bought parts and CI.
    Claude-Session: https://claude.ai/code/session_01EQ9Zun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
2026-11-09 feat(hardware): add v6 print plates for Bambu Lab A1 with AMS lite
    hardware/v6/plates/ holds the print package of design v6, a preview that
    v6.1 will replace:
    - two Bambu Studio projects: PETG (test plate and 4 part plates, AMS lite
    slots 1 to 3) and TPU (lip test strip and all seals, external spool)
    - a plain 3MF per plate for other slicers, every part as an STL in print
    orientation with colour bodies, plate previews, layout.json
    - summary.json (plates, parts, grams per filament, times, colour swaps)
    and the OrcaSlicer 2.5 statistics behind it
    - the print guide as README.md, with a preview notice
    - the generator scripts in tools/, with paths relative to the repository;
    the Bambu sys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
    [Kibble_Dispenser_v6_PETG.bambu.3mf, Kibble_Dispenser_v6_TPU.bambu.3mf, PETG-0_spline__cover_groove.3mf, PETG-1_bowl__box__shaft__hub.3mf, PETG-2_flange__cover__tower.3mf, PETG-3_chute__collar__gate__window_plates.3mf, PETG-4_disc__latch__4_buttons.3mf, TPU-0_TPU_lip_seal_strip.3mf]
2026-11-09 feat(site): rebuild the home page and add the v6 print-files page
    New home page in English, Italian and German, generated by site/pages.py
    from site/content/home.toml: hero with a still of the 3D page in the woods
    (rendered with Playwright at 2x), the idea with a side-view drawing of the
    food path, how it works, materials and colour language with grams per
    colour, build cards (print files, bought parts, assembly wizard and PDF
    manual coming soon), what's next (v6.1 in design, the v6 files are a
    preview), project status with the bench prototype and the roadmap, open
    source. Grams, times and counts come from hardware/v6/plates/summary.json
    and hardware/v6/cad/v6.json at build time.
    New page v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
2026-11-09 feat(release): version lines for hardware, firmware and product with automatic releases
    Three version lines, each with its own tag and GitHub Release (VERSIONS.md):
    - hardware: hardware/VERSION, tag hw-vX.Y.Z, with a status (designed,
    printed, tested, field-proven); design v6 is 6.0.0, designed
    - firmware: firmware/VERSION, tag fw-vX.Y.Z; 0.1.0+dev.20260324 for the
    feedr-outdoor 0.1.0 snapshot with its uncommitted edits, checked against
    firmware/micropython/VERSION, which stays untouched. The firmware flashed
    on the board is not read back yet. The ESPHome draft stays unversioned.
    - product: product/product.json, a lock file pinning one hardware tag and
    one firmware tag plus manual,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
2026-11-09 feat(site): show the versions and the build commit in every footer
    site/versions.py reads hardware/VERSION, firmware/VERSION and
    product/product.json at build time and writes "Hardware v6.0.0 (designed) ·
    Firmware v0.1.0+dev.20260324 · Product: not released yet" with the short
    build commit and its date, linked to the Releases page. It appears in the
    footers of the home, print-files, bought-parts and earlier-versions pages
    and in the project panel of the 3D page, in English, Italian and German.
    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
2026-11-09 fix(release): tag the commit that brings a new version to main
    The first release run failed: GitHub refuses to let the workflow token
    create a tag on an older commit whose workflow files differ from main
    ("refusing to allow a GitHub App to create or update workflow"). New tags
    now point at the head of the push that brings the new version, and the
    assets are read from it. The tag message and the release notes name the
    last commit that changed the line's files when that is an earlier one.
    This also backfills hw-v6.0.0 and fw-v0.1.0+dev.20260324 on this push;
    VERSIONS.md says their files are the same as in 58943c9 (design v6 with
    its plates) and b6b40bf (the firmware import).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
2026-11-10 feat(hardware): add design v6.2, closed pod with shut-off gate and cable channel
    Design v6.2 (CAD only, not printed or tested) builds on v6.1.1 and v6.1:
    a shut-off gate in a two-plate flange turned by an orange ring whose window
    frees the release button only with the gate closed, a cable tunnel in the
    flange with a snap-in channel under the shelf and an IP67 M8 connector in the
    pod top, one set of 3 x M3x40 stack screws, one common comb lip and a 1:1
    drilling template.
    - cad/: build_v62.py, build_v62_checks.py and publish_v62.py, plus copies of
    the v6.1.1, v6.1, v6, v5, v4b and drivetrain v4 scripts it imports, with
    relative paths; build_v62.py runs the earlier stages first (about 10 m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
    [albero_v6.stl, anello_saracinesca_v62.stl, bought_board_70x50.stl, bought_cable_12v_supply.stl, bought_cable_12v_unit.stl, bought_cap_1000uF.stl, bought_connector_m8_ip67.stl, bought_esp32.stl]
2026-11-10 feat(hardware): add the v6.2 print package for Bambu Lab A1 with AMS lite
    hardware/v6.2/plates/ is the authoritative print set of v6.2: two Bambu
    Studio projects (PETG: 1 test plate and 6 part plates on AMS lite slots 1 to
    3; TPU: test plate and all seals from the external spool), a plain 3MF per
    plate, every part as an STL in print orientation, previews, slicer
    statistics, summary.json with the bought-parts list, the print guide as
    README.md and the generator scripts in tools/ (paths relative to the
    repository; the Bambu system profiles are fetched on the first run).
    It corrects the print orientation of canalina_base_v62, canalina_coperchio_v62,
    canalina_tappo_v62 and passacavo_v62, and pr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
    [Kibble_Dispenser_v62_PETG.bambu.3mf, Kibble_Dispenser_v62_TPU.bambu.3mf, PETG-0_spline__rim_cap_and_skirt_grooves.3mf, PETG-1_pod_shell__electronics_box.3mf, PETG-2_bowl__pod_cap.3mf, PETG-3_lower_flange__cable_channel.3mf, PETG-4_upper_flange__tower__shaft__hub.3mf, PETG-5_chute__collar__gate__window_plates.3mf]
2026-11-10 docs(manual): add the v6.2 user manuals in English, Italian and German
    docs/manual/ holds the user manual of design v6.2 (0.6.2 draft:
    installation, use and maintenance) per language as an A6 booklet and as an
    A4 version imposed four pages per side for printing at home. The drilling
    template is in hardware/v6.2/template/.
    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
2026-11-10 feat(site): add the v6.2 assembly guide
    site/assembly/ is the assembly wizard of design v6.2, copied as built: step
    by step with the 3D model at every step, two flows ("Install the kit", the
    default, and "Build it yourself"), English, Italian and German, deep links
    #step-N and #diy-N, the drilling template and its own copy of three.js r128.
    The site serves it at the stable URL assembly/.
    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
    [albero_v6.stl, anello_saracinesca.stl, canalina_base_1.stl, canalina_base_2.stl, canalina_coperchio_1.stl, canalina_coperchio_2.stl, canalina_tappo.stl, chiavette_0.stl]
2026-11-10 feat(site): stable URLs for the current design v6.2, v6 archived
    - 3d/, print/, parts/, assembly/ and manual/ always show the current design
    (v6.2); design v6 keeps versioned pages (v6/ index, v6/3d/, v6/print/,
    v6/parts/) with an archive note and links to v6.2. Footers, nav, home page
    buttons and the earlier-versions page use the stable URLs.
    - Home page for v6.2: hero re-rendered from the v6.2 3D page ("In the woods",
    2x), new side-view drawing with the pod and the cable channel, how it works
    with the gate and its ring interlock, the closed claw-proof pod with the
    hidden chute, the cable channel and the near-zero maintenance, a v6.2
    section image, grams from the v6.2 print pa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
2026-11-10 ci: check the v6.2 meshes and regenerate v6.2 when its CAD changes
    - ci.yml: new job meshes-v62 checks the committed viewer meshes and every
    STL of the v6.2 print package on each push; the BOM step checks both
    docs/BOM.md (v6.2) and docs/BOM-v6.md.
    - cad-v62.yml: regenerates the whole v6.2 chain (v6 with dosing and v5, v6.1,
    v6.1.1, v6.2, with their checks) in a temporary copy when
    hardware/v6.2/cad/ or the mesh check changes, or on demand; checks every
    mesh (the known-empty v6.1 colour bodies, re-exported by v6.1.1 and unused
    by v6.2, are skipped) and the main results of v62.json.
    Claude-Session: https://claude.ai/code/ses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
2026-11-10 docs: point README and hardware notes to design v6.2 and the stable URLs
    README: status, a Design v6.2 section with the stable site URLs (3d/, print/,
    parts/, assembly/, manual/), the archived v6 pages, the site build, repository
    map, quick links and licence paths. hardware/README.md and docs/README.md name
    v6.2 as the current design; the v6 README and print guide are marked as
    archived and link the v6 bought parts in docs/BOM-v6.md.
    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
2026-11-10 feat(release): hardware 6.2.0 (design v6.2, designed) with separate assets
    - hardware/VERSION: 6.2.0, status designed, design folder hardware/v6.2.
    - CHANGELOG: sections hw-v6.2.0 (released by the workflow) and hw-v6.1.0 /
    hw-v6.1.1 (design iterations, not released), one line each: pod shell,
    closed-pod sealing, gate, cable channel and stack screws.
    - VERSIONS.md: compatibility table with v6.2 and the new firmware
    requirement (never dispense at power-on: store the last rest position);
    the firmware stays fw-v0.1.0+dev.20260324.
    - tools/release.py: a hardware release gets an STL zip, a plate 3MF zip
    (both with the print guide, BOM and licences), the drilling template and
    the manual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
2026-11-10 fix(ci): install fast_simplification for v6.2 and give Pages time to deploy
    - cad-v62.yml: the v6.1 checks decimate meshes with trimesh's quadric
    decimation, which needs fast_simplification (the first run stopped there);
    build_v62.py and the v6.2 README list it as a dependency.
    - pages.yml: the first v6.2 deploy stalled in "syncing_files" until the
    default 10 minute timeout; allow 30 minutes.
    - pages.py: the print pages link the single STL files from GitHub instead of
    copying them (they are also in the ZIP), so the artifact shrinks from about
    195 MB to 150 MB.
    Claude-Session: https://claude.ai/code/session_01EQ9ZunTgLrjJt4gR1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
2026-11-10 ci(pages): drop the deploy timeout that deploy-pages caps at 10 minutes
    deploy-pages warns that 1800000 ms exceeds its maximum and uses 600000, so
    the setting had no effect; note instead that a stalled deployment can be
    re-run from the Actions tab.
    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
2026-11-10 docs(claude): record the single-button UI decision for hardware 6.3
    Firmware change tracked in #2; the bench prototype keeps two buttons.
    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
2026-11-11 feat(hardware): add design v6.3 with its print package
    Design v6.3 in hardware/v6.3/: the closed pod of v6.2 made simpler
    (28 printed pieces instead of 36, no cable channel, PT screws instead
    of the thumb-turns, press-fit pins in the flange) with a control
    panel in the cap: one recessed push-button, two light pipes with
    LEDs, a sealed speaker opening and three flush knock-outs.
    - cad/: build_v63.py with its checks, report and publish scripts,
    plus copies of the v6.2, v6.1.1, v6.1, v6 and v5 stages it runs
    first; v63.json and check_v63.png. The report now reads the
    drilling template back from its staged file and writes it without
    a timestamp, so a run from a clean checkout works and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
    [Kibble_Dispenser_v63_PETG.bambu.3mf, Kibble_Dispenser_v63_TPU.bambu.3mf, PETG-0_spline__rim_cap_and_skirt_grooves.3mf, PETG-1_pod_shell__electronics_box.3mf, PETG-2_bowl__pod_cap.3mf, PETG-3_lower_flange__tower__shaft__hub.3mf, PETG-4_upper_flange.3mf, PETG-5_chute__collar__gate_blade__gate__window_plates.3mf]
2026-11-11 feat(site): show design v6.3 on the stable URLs and archive v6.2
    - 3d/, print/, parts/, assembly/ and manual/ now show v6.3: the v6.3
    viewer, the print page from hardware/v6.3/plates (texts in
    print.toml), the bought parts from hardware/v6.3/bom.json (also
    docs/BOM.md), the v6.3 assembly wizard (41 steps, kit 23 and DIY
    40, en/it/de) and the v6.3 manuals with the drilling template.
    - Design v6.2 moves to v6.2/: archive index, 3D page, print page
    (print_v62.toml), bought parts (docs/BOM-v6.2.md), the v6.2 wizard
    (moved as it was to site/v6.2/assembly/) and a manual page that
    links the PDFs of the release hw-v6.2.0. Its print downloads link
    the repository and the release instea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
    [albero_v6.stl, anello_saracinesca.stl, anello_saracinesca_v63.stl, cable_tie.stl, canalina_base_1.stl, canalina_base_2.stl, canalina_coperchio_1.stl, canalina_coperchio_2.stl]
2026-11-11 chore(release): hardware 6.3.0
    hardware/VERSION is 6.3.0 (status designed, design hardware/v6.3);
    release.yml tags hw-v6.3.0 with the STL zip, the plate 3MF zip, the
    drilling template and the v6.3 manuals.
    - CHANGELOG: section hw-v6.3.0 and the site and CI entries.
    - VERSIONS.md: hw-v6.3.0 needs the one-button firmware of issue #2;
    fw-v0.1.0+dev.20260324 is the two-button bench firmware and is not
    for v6.3. hw-v6.2.0 is archived.
    - README, hardware/README.md, docs/README.md, hardware/v6.2/README.md
    (archived, links to the v6.2 pages) and product/product.json (kit
    without the cable channel, with the control panel and a cable tie).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
